CodenameTempest14/init-heat-monitoring/hardware/README.md

# hardware

Device design for the classroom heat monitor (38-pin ESP32, DHT22, SSD1306 OLED, USB power bank).

- `schematic.html`: Rev B schematic, parts list, wire list, bring-up order, runtime estimate. Draft, not yet built or measured. Rev B replaced the Rev A 2S 18650 + buck power section (D-008).
