CodenameTempest14/init-heat-monitoring/src/README.md

# src/

Application code that runs in Node and the browser. Currently: `heat-index.js` (`heatIndexC`: heat index from °C and % RH, `null` below the NWS range; `heatCategory`: PAGASA band, rounded to whole °C). Tested by `tests/`. Decision D-015.
