CodenameTempest14/init-heat-monitoring/documentation/README.md

# documentation

Decisions, progress log, phase checklists, session reports and the state file. Start with `context/CURRENT_STATE.md`.
