CodenameTempest14/init-heat-monitoring/design/brand/README.md

# design/brand/

Logo and full name of **Init** (brand name D-007). **Chosen by the owner 2026-11-02 (s14), D-029.**

**Full name:** Init: Indoor Heat Index Tracker, An IoT-Based Classroom Heat Index Monitoring System
(IN-door + Index + Tracker; "init" is also the programmer's word for *start*).

**Logo:** the app icon (a lowercase `i` drawn as a thermometer) next to the `init` wordmark with heat-orange i-dots.

| File | What |
|---|---|
| `init-logo-light.svg`, `init-logo-dark.svg` | **The logo** (icon + wordmark) for light and dark backgrounds |
| `init-icon-light.svg`, `init-icon-dark.svg` | **The icon** alone: PWA icon and favicon (the dark one has a light edge) |
| `build-logos.mjs` | Draws every SVG here from `../tokens.json`; letters are plain strokes, so no font licence (D-010). Edit this, not the SVGs |
| `preview.html`, `capture.mjs`, `preview.png` | The chosen logo and the earlier proposals on light and dark, and at 32 px and 16 px |
| `logo-a-*`, `icon-b.svg`, `logo-b-*`, `logo-c-*` | The three proposals the owner chose from (A wordmark, B icon, C gauge); kept for the record |
