CodenameTempest14/init-heat-monitoring/enclosure/preview/README.md

- preview/ and stl/ hold generated files only.
