CodenameTempest14/init-heat-monitoring/documentation/context/README.md

# context

`CURRENT_STATE.md` (read first every session, overwritten at close) and `NEXT_SESSION_PROMPT.md` (generated by `node tools/continuation-prompt.mjs`).
