CodenameTempest14/init-heat-monitoring/paper/data/README.md

# paper/data/

Aggregates of the 24 h run (2026-11-02 10:03:55Z to 2026-11-03 10:03:55Z, init-test, one device): `summary.json`,
`hourly.json` (Philippine time), `bands.json` (PAGASA levels), `gaps.json` (gaps over 90 s). Made by `../fetch-data.mjs`.
No keys, no personal data.

`screens/`: three cropped phone screenshots (home online, home offline, heat alerts page; owner's Android, light mode, 5 Nov 2026) used in Figure 7. No personal data.

`screens/` now also holds crops of the hosted pages taken with a phone-sized browser (390 px, light mode, 5 Nov 2026): charts, readings, school, heat, guide, admin-signin, admin (test admin account on the test project; the address is a made-up one). Figures 7 to 10.
