CodenameTempest14/init-heat-monitoring/design/language-toggle/ref/README.md

# design/language-toggle/ref/

Light and dark screenshots of the proposed language switch (home in English, in Filipino, and the longest-text stress case). Made by `node design/language-toggle/capture.mjs`. Proposed only; the Filipino is a draft.
