CodenameTempest14/init-heat-monitoring/design/heat-info/ref/README.md

# design/heat-info/ref/

Screenshots of the F-15 extended mocks (`../*.html`), written by `node design/heat-info/capture.mjs`: `<state>-<phone|desktop>-<light|dark>.png`. Made-up room only.
