CodenameTempest14/init-heat-monitoring/documentation/phase-reports/phase-03-firmware/README.md

# phase-03-firmware

Reports for Phase 3 (device firmware, starting with the OLED design canvas).
