CodenameTempest14/init-heat-monitoring/documentation/phase-reports/phase-01-core-and-bench/README.md

# phase-01-core-and-bench

Reports for Phase 1 (heat index core and bench bring-up).
