CodenameTempest14/init-heat-monitoring/firmware/init/include/README.md

# firmware/init/include

Headers. `heat_index.h` (heat index and PAGASA band, P03-04), `interval.h` (upload interval rules, P03-03), `room.h` (room name from the reply, D-028), `readings.h` (offline buffer and upload body, P03-06), `screens.h` (the OLED screens, repeated from `design/oled/screens.mjs`) and `screen_test.h` (only for the `esp32dev_screens` build, which dumps the display over serial) are pure code or drawing code. `config.h` is committed. `secrets.h` is created from `secrets.h.example`, is gitignored and must never be committed.
