CodenameTempest14/init-heat-monitoring/documentation/phase-reports/phase-03-firmware/sessions/2026-11-11_s38_CLOSE.md

# Phase 07 — Session s38 — CLOSE — 2026-11-11

[P07 · Field trial and hardening · 0/7 done · 0 blocked · unverified 1]

- **Status:** Completed. **Phase builder:** the owner did not answer the question; treated as owner only (D-014 applies: if Shem joins, `main` goes through pull requests). **Model:** Sonnet 5.5 (fine for the case design, print guide and paper).
- **Planned vs done:** planned: take the owner's measurements, draft 6, print guide. Done: measurements recorded with the conflicts flagged (`enclosure/MEASUREMENTS.md`); **draft 6** of `init_case.scad`; `enclosure/PRINT_GUIDE.md`; the **logo engraving** (D-045); decisions D-042 (pod low, M3 x 5 only), D-043 (web hold stays), D-044 (only box screws, no inserts: M2.5 x 8 for the case), D-045 (logo, one PETG colour, one paint); button window moved to the back wall (owner). P07 is still 0/7: nothing printed or fitted.
- **Files changed:** `documentation/DECISIONS.md` (D-042 to D-045), `enclosure/` (`init_case.scad`, `MEASUREMENTS.md`, `README.md`, new `PRINT_GUIDE.md`, `preview/draft6_*.png`, `stl/*.stl` incl. new `podlid.stl`), `paper/content.mjs` and the rebuilt `.docx` and `.pdf`; this close, `CURRENT_STATE.md`, `PROGRESS_LOG.md`.
- **Evidence:** OpenSCAD renders of base, lid, cover, arm and podlid with no errors (STL exported); I looked at the assembly, arm and logo renders. The paper builds. Secret scan clean.
- **Regression:** no code under `web/`, `src/`, `firmware/` or `supabase/` changed, so no suite was run (web and database are on hold, D-039).
- **Paper (rule 5):** enclosure paragraph updated (arm low, box screws, logo, most sizes now measured). No new reference added.
- **Pushed:** commit `2077ffc` to `codenametempest14` and `main` (owner approved both). The s38 close commit is local until the owner approves a push.
- **Not run:** nothing printed or fitted; no close-up of the OLED pilot holes; no check that the 22 cm wire route works.
- **Which parts did you actually run, and what are you unsure about?** Run: OpenSCAD renders and the paper build. Unsure: (1) the guesses marked EST in the .scad and PRINT_GUIDE section 5: OLED hole orientation and lit length, DHT22 hole position and grille size, 14 mm plug length, the "7 mm" port height, countersink head size, pilot size 2.1 mm and depths; (2) the owner's measurements that conflict (ESP32 row spacing 25 mm looks like the board width; OLED lit 24.5 mm is longer than the 24.4 mm board; bank port 1 at 40 mm; DHT22 grille 15 x 14) were adapted, not re-measured; (3) M2.5 x 8 self-tapping into PETG pilots is untested; (4) the engraved icon outline is only about 1 mm; (5) the logo and the front wall: the engraving prints on a vertical face, untested; (6) the colour and paint advice is general (white or light grey PETG, dark acrylic paint pen), no product checked.
- **Awaiting owner:** buy one roll of PETG (light colour) and a dark acrylic paint pen, then ping me; review draft 6; measure one M2.5 flat-head screw head; confirm the guesses above; lift the web hold (D-039) when wanted.
- **Next session model:** Sonnet 5.5 for the PLA test slice, the print guide and the paper; Opus 5.5 once firmware, power or data-gap work starts.

## Addendum (session kept open after the first close, owner's request)
After the close the owner asked about drop strength and gave the bank weight (about 670 g). I found that draft 6 left the bank loose along its length (30 mm toward the port end, 12.6 mm toward the rear). **Draft 7 (D-046):** bank stops, walls and floor 3.2 mm, rounded corners, arm tube wall 2.4 mm, bigger arm foot and four gussets; PRINT_GUIDE section 7 adds a drop test. Evidence: all five STL parts render with no errors; I looked at the base top view (stops placed as intended) and the arm render. Not tested: a real drop, the stop clearances with the real bank, whether the thicker walls change the print time or fit the cover posts. The paper has one new sentence; rebuilt. The owner then approved draft 7 for the PLA test print only, estimates included (D-047). Pushed at the final close: `97db1d4`, `0f19931`, `142458e` to `codenametempest14` and `main` (owner approved both).

## Phase Progress (HARD RULE 1), at the close
| Phase | Done / Total | Progress | % |
|---|---|---|---|
| P00 Kickoff and decisions | 13 / 13 | ██████████ | 100% |
| P01 Heat index core and bench bring-up | 7 / 7 | ██████████ | 100% |
| P02 Backend and secure upload | 7 / 7 | ██████████ | 100% |
| P03 Device firmware | 10 / 10 | ██████████ | 100% |
| P04 Web app core | 13 / 13 | ██████████ | 100% |
| P05 Admin, alerts and device health | 7 / 7 | ██████████ | 100% |
| P06 Display and sharing extras | 4 / 5 | ████████░░ | 80% |
| P07 Field trial and hardening | 0 / 7 | ░░░░░░░░░░ | 0% |
| P08 Over-the-air updates (optional) | 0 / 3 | ░░░░░░░░░░ | 0% |
| **Whole project** | 61 / 72 | █████████░ | **85%** |
