CodenameTempest14/init-heat-monitoring/documentation/phase-reports/phase-03-firmware/sessions/2026-11-09_s37_START.md

# Phase 07 — Session s37 — START — 2026-11-09

[P03 · Device firmware · 10/10 done · 0 blocked · unverified 1]

- **Phase builder:** owner only (asked and answered s37).
- **Model:** Sonnet 5.5 (P06-05 tick, paper, enclosure planning); Opus 5.5 for P07 firmware/power work and P08.
- **Read:** CLAUDE.md, CURRENT_STATE.md, the continuation prompt. Repo check: `codenametempest14` level with origin (the prompt said two unpushed close commits, but they were already pushed); untracked `.vscode/settings.json` (not ours).
- **Owner's answers:** Filipino switch seen on a phone (screenshot), teacher approved the translation, `#kiosk` and the poster seen on a television; next phase P07.
- **Plan:** tick P06-05, then plan P07-01 (enclosure) with the owner.

## Phase Progress (HARD RULE 1), at the start
| Phase | Done / Total | Progress | % |
|---|---|---|---|
| P00 Kickoff and decisions | 13 / 13 | ██████████ | 100% |
| P01 Heat index core and bench bring-up | 7 / 7 | ██████████ | 100% |
| P02 Backend and secure upload | 7 / 7 | ██████████ | 100% |
| P03 Device firmware | 10 / 10 | ██████████ | 100% |
| P04 Web app core | 13 / 13 | ██████████ | 100% |
| P05 Admin, alerts and device health | 7 / 7 | ██████████ | 100% |
| P06 Display and sharing extras | 3 / 5, 1 unverified | ██████░░░░ | 60% |
| P07 Field trial and hardening | 0 / 7 | ░░░░░░░░░░ | 0% |
| P08 Over-the-air updates (optional) | 0 / 3 | ░░░░░░░░░░ | 0% |
| **Whole project** | 60 / 72 | ████████░░ | **83%** |
