CodenameTempest14/init-heat-monitoring/documentation/phase-reports/phase-03-firmware/sessions/2026-11-11_s37_CLOSE.md

# Phase 07 — Session s37 — CLOSE — 2026-11-11

[P07 · Field trial and hardening · 0/7 done · 0 blocked · unverified 0]

- **Status:** Completed. **Phase builder:** owner only. **Model:** Sonnet 5.5 (the owner asked twice if it is enough: yes for the case design, the paper and the print guide; Opus 5.5 for P07 firmware, power and hardening).
- **Planned vs done:** planned the P06-05 tick, then P07. Done: **P06-05 verified** (owner's phone screenshot of the hosted page in Filipino, teacher approved, owner's word); P06-02 note (poster scanned on a TV); **website and database put on hold (D-039)**; **P07-01 enclosure design started** (D-038, D-040, D-041): measurement sheet, OpenSCAD model drafts 1 to 5, dimensioned drawings, measurement guide, checklist for tomorrow. P07 is still 0/7: nothing is printed or tested.
- **Files changed:** `documentation/phases/phase-06-extras.md`, `DECISIONS.md` (D-038 to D-041), `CURRENT_STATE.md`, `PROGRESS_LOG.md`; new `enclosure/` (README, MEASUREMENTS.md, MEASURE_NEXT.md, `init_case.scad`, `draw-dimensions.mjs`, `draw-measure-guide.mjs`, `preview/`, `stl/`); `paper/content.mjs` and the rebuilt `.docx` and `.pdf` (enclosure paragraph, Not Yet Done line, Table 7 61/72).
- **Evidence:** the P06-05 screenshot (owner). For the enclosure: OpenSCAD Nightly 2026.10.31 installed (winget, on the owner's user PATH, new terminals only); a test cube exported and opened in Bambu Studio after the owner fixed a missing `.stl` extension; all four STL parts render without errors at draft 5; I looked at every render and drawing. A subagent read the Bambu Studio repo profiles (A1 0.2 mm Standard, Generic PETG) and I spot-checked a few values myself. The Bambu wiki page itself returned HTTP 402 and was NOT read.
- **Regression:** no code under `web/`, `src/`, `firmware/` or `supabase/` changed, so no suite was run. Secret scan clean, every folder has a README.
- **Paper (rule 5):** enclosure paragraph in 2.4, a Not Yet Done line, Table 7 now P06 4/5 (80 %), whole 61/72 (85 %). No new reference was added; the print settings are not cited in the paper.
- **Pushed:** `codenametempest14` and `main` (owner approved both at close).
- **Not run:** nothing was printed or test-fitted; the web suite and backend tests; nothing on live.
- **Which parts did you actually run, and what are you unsure about?** Run: OpenSCAD renders of all parts, the dimension and measurement-guide drawings, the paper build. Unsure: (1) every size marked PLACEHOLDER (bank port opening, OLED window and posts, BOOT/EN holes, DHT22 mount, insert holes) is a guess; (2) the arm on top of the cover puts the pod in the warm air above the bay: the heat effect is unmeasured; (3) the bore of the arm (11 x 4.5 mm) was never tried with a real jumper plug; (4) the screws in the owner's box are too short for the arm (need about M3 x 10); (5) the print settings I gave come from my general knowledge plus Bambu's profile files, not the wiki; the PLA and PETG temperatures are from memory; (6) the printed case has not been fitted to any part.
- **Decisions / awaiting owner:** the measurements in `enclosure/MEASURE_NEXT.md` (owner, 2026-11-12); a decision on lifting the web hold (D-039); whether to keep the arm on top of the cover or hang the pod lower.
- **Next session model:** Sonnet 5.5 for the case design and the print guide; Opus 5.5 once P07 firmware, power or data-gap work starts.

## Phase Progress (HARD RULE 1), at the close
| Phase | Done / Total | Progress | % |
|---|---|---|---|
| P00 Kickoff and decisions | 13 / 13 | ██████████ | 100% |
| P01 Heat index core and bench bring-up | 7 / 7 | ██████████ | 100% |
| P02 Backend and secure upload | 7 / 7 | ██████████ | 100% |
| P03 Device firmware | 10 / 10 | ██████████ | 100% |
| P04 Web app core | 13 / 13 | ██████████ | 100% |
| P05 Admin, alerts and device health | 7 / 7 | ██████████ | 100% |
| P06 Display and sharing extras | 4 / 5 | ████████░░ | 80% |
| P07 Field trial and hardening | 0 / 7 | ░░░░░░░░░░ | 0% |
| P08 Over-the-air updates (optional) | 0 / 3 | ░░░░░░░░░░ | 0% |
| **Whole project** | 61 / 72 | █████████░ | **85%** |
