CodenameTempest14/init-heat-monitoring/documentation/phase-reports/phase-03-firmware/sessions/2026-11-06_s36_CLOSE.md

# Phase 03 — Session s36 — CLOSE — 2026-11-06

[P03 · Device firmware · 10/10 done · 0 blocked · unverified 1]

- **Status:** Completed. **Phase builder:** owner only. **Model:** Sonnet 5.5 (enough for the whole session, owner asked).
- **Planned vs done:** planned the P06-02 tick, then (owner's choice) the English / Filipino switch. Done: **P06-02 verified** (owner scanned `/#poster`); **P06-05 built and ticked UNVERIFIED**; init-test offsets read back 0.0 / 0.0.
- **Files changed:** `web/src/i18n.js`, `i18n-guide.js`, `i18n-admin.js`, `Lang.jsx`, `lang.css` (new); `lib.js`, `school.js`, `alerts.js`, `history.js`, `readings.js`, `admin.js`, `heatText.js`, `App.jsx`, `School.jsx`, `Alerts.jsx`, `History.jsx`, `Readings.jsx`, `Heat.jsx`, `Guide.jsx`, `Admin.jsx`, `main.jsx`; `tests/web-i18n.test.js`, `tests/ui-gate-language.test.js` (new); `design/language-toggle/` (mocks, refs, `room-row.mjs`) and the home, badge, history, school-day and alerts mocks redrawn with the switch; `documentation/phases/phase-06-extras.md`; READMEs; `paper/content.mjs`, `paper/diagrams.mjs`, rebuilt `.docx` and `.pdf`.
- **Evidence:** `web-i18n.test.js` seen red at each of four stages (module not found, missing exports, wrong text), then 14/14. `ui-gate-language.test.js` 14/14: the first run showed 4700 to 5300 differing pixels because the language mock lacked `charts.css` (mock fixed, not the app); the history, readings, heat, guide and admin language tests passed on their first run (never seen red). The guide gate caught one real change of mine ("When to look at it" had been turned into "When to change it"); fixed, 6/6. Browser-driven in Chromium against fake Supabase answers at 390 px and 360 px, light and dark.
- **Regression:** web unit 119/119; UI gates one file at a time: home 12, badge 9, history 17, school 14, admin 20, guide 6, heat 10, alerts 16, qr-kiosk 12, language 14, core 5, all green with 0 differing pixels; secret scan clean; every folder has a README.
- **Paper (rule 5):** new paragraph on the language switch, routes figure has a new box, Not Yet Done line, kiosk and poster sentence updated (poster scanned). Table 7 unchanged in numbers: P06 3/5 (60 %), whole 60/72 (83 %); P06-05 counts as unverified, not done. No new reference was needed.
- **Pushed:** `codenametempest14` and `main` at `74e387f` (owner approved each time). The close commit is local; the push is asked after it.
- **Not run:** the whole `npm test` and the backend tests (they wipe init-test readings), anything on live, the switch on a phone or on the hosted page, `#kiosk` on a TV, a printed poster.
- **Which parts did you actually run, and what are you unsure about?** Run: everything under Evidence and Regression. Unsure: (1) the Filipino is the assistant's draft, no teacher or fluent speaker has read it, and the health advice (`#heat`, `#guide`) matters most; (2) the switch was never seen on a real phone or on the hosted page; (3) the switch is only on pages with the Room line, so `#heat`, `#guide` and `#admin` can only be switched on the home page first; (4) the kiosk, poster, push notification text and CSV column names are still English by the owner's choice.
- **Decisions / awaiting owner:** teacher review of the Filipino (D-034), then remove UNVERIFIED from P06-05 after the phone check; `#kiosk` on a TV; a printed poster; push of the close commit; what next (P06-03 advice text needs a teacher; P07 field trial needs the device in a classroom).
- **Next first step:** CURRENT_STATE "Next concrete step" 0 and 1.
- **Recommended model for the next session:** Sonnet 5.5 to tick P06-05 and for any paper or text work; Opus 5.5 for P07 and P08.

## Phase Progress (HARD RULE 1)
| Phase | Done / Total | Progress | % |
|---|---|---|---|
| P00 Kickoff and decisions | 13 / 13 | ██████████ | 100% |
| P01 Heat index core and bench bring-up | 7 / 7 | ██████████ | 100% |
| P02 Backend and secure upload | 7 / 7 | ██████████ | 100% |
| P03 Device firmware | 10 / 10 | ██████████ | 100% |
| P04 Web app core | 13 / 13 | ██████████ | 100% |
| P05 Admin, alerts and device health | 7 / 7 | ██████████ | 100% |
| P06 Display and sharing extras | 3 / 5, 1 unverified | ██████░░░░ | 60% |
| P07 Field trial and hardening | 0 / 7 | ░░░░░░░░░░ | 0% |
| P08 Over-the-air updates (optional) | 0 / 3 | ░░░░░░░░░░ | 0% |
| **Whole project** | 60 / 72 | ████████░░ | **83%** |

## Continuation prompt (HARD RULE 2)
`documentation/context/NEXT_SESSION_PROMPT.md`, generated by `node tools/continuation-prompt.mjs`; shown in the final message.
