CodenameTempest14/init-heat-monitoring/documentation/phase-reports/phase-03-firmware/sessions/2026-11-06_s36_START.md

# Phase 03 — Session s36 — START — 2026-11-06

[P03 · Device firmware · 10/10 done · 0 blocked · unverified 1]

- **Phase builder:** owner only (asked and answered s36).
- **Model:** Sonnet 5.5 (small web changes, ticks, paper; the owner asked and Sonnet was enough for the mocks).
- **Read:** CLAUDE.md, CURRENT_STATE.md, `phase-06-extras.md`, the s35 Close Report.
- **Read-only check before any change:** branch `codenametempest14`, git email = the owner, nothing unpushed, untracked `.vscode/settings.json` (not ours).
- **Owner's answers:** poster scanned with a phone and working; `#kiosk` not yet seen on a TV; init-test temperature offset reset to 0 (read back 0.0 / 0.0).
- **Plan:** tick P06-02, then mocks for the English / Filipino switch (P06-05), build it test-first, then translate the rest of the app; paper in step (rule 5).

## Phase Progress (HARD RULE 1)
| Phase | Done / Total | Progress | % |
|---|---|---|---|
| P00 Kickoff and decisions | 13 / 13 | ██████████ | 100% |
| P01 Heat index core and bench bring-up | 7 / 7 | ██████████ | 100% |
| P02 Backend and secure upload | 7 / 7 | ██████████ | 100% |
| P03 Device firmware | 10 / 10 | ██████████ | 100% |
| P04 Web app core | 13 / 13 | ██████████ | 100% |
| P05 Admin, alerts and device health | 7 / 7 | ██████████ | 100% |
| P06 Display and sharing extras | 3 / 5, 1 unverified | ██████░░░░ | 60% |
| P07 Field trial and hardening | 0 / 7 | ░░░░░░░░░░ | 0% |
| P08 Over-the-air updates (optional) | 0 / 3 | ░░░░░░░░░░ | 0% |
| **Whole project** | 60 / 72 | ████████░░ | **83%** |
