CodenameTempest14/init-heat-monitoring/documentation/phase-reports/phase-03-firmware/sessions/2026-11-06_s35_CLOSE.md

# Phase 03 — Session s35 — CLOSE — 2026-11-06

[P03 · Device firmware · 10/10 done · 0 blocked · unverified 1]

- **Status:** Completed (the push and the calibration reset are waiting on the owner). **Phase builder:** owner only. **Model:** Sonnet 5.5.
- **Planned vs done:** planned `#poster` and `#kiosk`, P06-04, paper. Done: **P06-01 ticked**, **P06-04 ticked** (F-24 CSV, owner's word), **P06-02 ticked as UNVERIFIED** (the owner has not scanned it with a phone; not on the hosted page yet). Paper rebuilt.
- **Files changed:** `web/src/Kiosk.jsx`, `kiosk.js`, `Poster.jsx`, `poster.js`, `qr-kiosk.css` (new), `App.jsx`, `main.jsx`; `tests/web-qr-kiosk.test.js`, `tests/ui-gate-qr-kiosk.test.js` (new); `documentation/phases/phase-06-extras.md`; READMEs (`web`, `tests`, `design/qr-kiosk` and `ref`); `THIRD_PARTY_NOTICES.md` (qrcode-generator, MIT); `paper/content.mjs`, `paper/diagrams.mjs`, rebuilt `.docx` and `.pdf`.
- **Evidence:** `web-qr-kiosk.test.js` seen red (module not found), then 7/7. UI gate 12/12 after one real defect (109 pixels differed on the "updated … · address" line: React made two text nodes; one string fixed it). The built pages have 0 differing pixels against the approved TV, phone and A4 images; the kiosk looks the same in dark mode. The local build opened on real init-test data: 38 °C, Extreme caution, Online, Unassigned. The approved poster image decodes (jsQR 1.4.0, scratch folder, not in the repo) to `https://init-heat-monitoring.vercel.app`.
- **Regression:** the other web unit tests 110/110; UI gates one file at a time: home 12, badge 9, history 17, school 14, admin 20, guide 6, heat 10, alerts 16, core 5, all green.
- **Paper (rule 5):** new paragraph on the kiosk and poster, Figure 6 (routes) has two new boxes, Table 7 now P06 2/5 (40 %) and whole 59/72 (82 %), Not Yet Done lists the unscanned poster and the pages not yet hosted. No new reference was needed.
- **Not run:** the whole `npm test` (it wipes init-test readings), the backend tests, anything on live, a phone scan of the QR, the pages on the hosted site.
- **Which parts did you actually run, and what are you unsure about?** Run: everything under Evidence and Regression. Unsure: (1) no phone has scanned a real QR from a screen or a printed sheet; (2) the kiosk was not seen on a real TV or projector, only at 1920x1080 and 390 px in Chromium; (3) init-test's temperature offset reads -0.5 °C (the state file said -0.6) and I could not write it (`db query --linked` is read-only), so the owner must set it to 0 in `#admin`; (4) there is no link to `#kiosk` or `#poster`, on purpose; they are opened by address.
- **Pushed:** nothing yet; the push to `codenametempest14` (and `main`) is asked at close.
- **Decisions / awaiting owner:** scan the poster, open `#kiosk` on a TV, reset the temperature offset to 0 before data goes into the paper, say whether a link to these pages is wanted (it changes approved home mocks, so mocks first); P06-03 and P06-05 need a teacher.
- **Next first step:** CURRENT_STATE "Next concrete step" 1.
- **Recommended model for the next session:** Sonnet 5.5 for ticking P06-02, the paper and P06-03; Opus 5.5 for P07 and P08.

## Phase Progress (HARD RULE 1)
| Phase | Done / Total | Progress | % |
|---|---|---|---|
| P00 Kickoff and decisions | 13 / 13 | ██████████ | 100% |
| P01 Heat index core and bench bring-up | 7 / 7 | ██████████ | 100% |
| P02 Backend and secure upload | 7 / 7 | ██████████ | 100% |
| P03 Device firmware | 10 / 10 | ██████████ | 100% |
| P04 Web app core | 13 / 13 | ██████████ | 100% |
| P05 Admin, alerts and device health | 7 / 7 | ██████████ | 100% |
| P06 Display and sharing extras | 2 / 5, 1 unverified | ████░░░░░░ | 40% |
| P07 Field trial and hardening | 0 / 7 | ░░░░░░░░░░ | 0% |
| P08 Over-the-air updates (optional) | 0 / 3 | ░░░░░░░░░░ | 0% |
| **Whole project** | 59 / 72 | ████████░░ | **82%** |

## Continuation prompt (HARD RULE 2)
`documentation/context/NEXT_SESSION_PROMPT.md`, generated by `node tools/continuation-prompt.mjs`; shown in the final message.
