CodenameTempest14/init-heat-monitoring/documentation/phase-reports/phase-03-firmware/sessions/2026-11-06_s35_START.md

# Phase 03 — Session s35 — START — 2026-11-06

[P03 · Device firmware · 10/10 done · 0 blocked · unverified 0]

- **Phase builder:** owner only (asked and answered s35).
- **Model:** Sonnet 5.5 (web pages with UI gates, paper).
- **Read:** CLAUDE.md, CURRENT_STATE.md, `phase-06-extras.md`, the three mock images in `design/qr-kiosk/ref/`.
- **Read-only check before any change:** branch `codenametempest14` level with `origin/codenametempest14` (the continuation prompt said 3 commits were unpushed; none were); untracked `.vscode/settings.json` left alone.
- **Owner's answers:** approve all three mocks as they are; reset the calibration offset to 0; F-24's Readings CSV covers P06-04.
- **Plan:** build `#kiosk` and `#poster` test-first with UI gates (P06-01, P06-02), tick P06-04, paper in step (rule 5).

## Phase Progress (HARD RULE 1)
| Phase | Done / Total | Progress | % |
|---|---|---|---|
| P00 Kickoff and decisions | 13 / 13 | ██████████ | 100% |
| P01 Heat index core and bench bring-up | 7 / 7 | ██████████ | 100% |
| P02 Backend and secure upload | 7 / 7 | ██████████ | 100% |
| P03 Device firmware | 10 / 10 | ██████████ | 100% |
| P04 Web app core | 13 / 13 | ██████████ | 100% |
| P05 Admin, alerts and device health | 7 / 7 | ██████████ | 100% |
| P06 Display and sharing extras | 0 / 5 | ░░░░░░░░░░ | 0% |
| P07 Field trial and hardening | 0 / 7 | ░░░░░░░░░░ | 0% |
| P08 Over-the-air updates (optional) | 0 / 3 | ░░░░░░░░░░ | 0% |
| **Whole project** | 57 / 72 | ████████░░ | **79%** |
