CodenameTempest14/init-heat-monitoring/documentation/phase-reports/phase-03-firmware/sessions/2026-11-05_s33_CLOSE.md

# Phase 03 — Session s33 — CLOSE — 2026-11-05

[P03 · Device firmware · 10/10 done · 0 blocked · unverified 0]

- **Status:** Completed. **Phase builder:** owner only (asked and answered s33). **Model:** Sonnet 5.5.
- **Planned vs done:** planned P04-08 screenshots and the P05-02 save. Done: **P04-08 ticked** (owner's four Android screenshots: light-mode home, `#alerts`, Offline after unplugging, back Online); **P05-02 ticked** (interval 60 → 120 → 60 and calibration offsets changed from the phone, each read back from the database and seen in the readings); admin label "Heat alerts (coming later)" fixed to "Heat alerts"; paper Chapter 2 got phone screenshots of every page (Figures 7 to 10). Not done: the 60-min reminder, iPhone subscription, teacher review, live rollout.
- **Files changed:** `documentation/phases/phase-04-web-app.md` (P04-08 ticked), `documentation/phases/phase-05-admin-alerts.md` (P05-02 ticked), `web/src/Admin.jsx` (label), the admin mocks and approved images in `design/admin/` and `design/room-reset-readings/`, `paper/content.mjs`, `paper/diagrams.mjs`, `paper/data/screens/` (10 crops) and its README, rebuilt `paper/Init_Research_Paper.docx` and `.pdf` (23 pages, 12 figures), `CURRENT_STATE.md`, `PROGRESS_LOG.md`, `NEXT_SESSION_PROMPT.md`, this report and the s33 START.
- **Evidence P04-08:** screenshots 22:55 to 22:57 local: Online (31 °C Caution, 28.5 °C, 63 %), Offline ("Offline: no reading for 2 min", Last heat index 33 °C, last reading 2 min ago), back Online (29.2 °C, 68 %), `#alerts`.
- **Evidence P05-02:** interval saved 15:14:02Z, gaps 120.2, 120.3, 120.3 s, back to 60 at 15:21:38Z (gaps 119.8 then 60.0, 60.2 s); offsets +0.9 / +5.0 at 15:27:15Z (reading 28.5 → 29.3 °C, 62.5 → 67.3 %), −0.9 / −5.0 at 15:28:31Z (27.4 °C, 58.2 %), then temperature −0.6 and humidity 0 at 15:33:24Z (27.3 → 27.5 °C, 58.6 → 63.9 %). The power bank stayed on for 5 min at 120 s.
- **Paper (rule 5), listed as required:** Table 7 (P04 100 %, P05 100 %, whole 57/72, 79 %); Not Yet Done (offline and light mode now checked); section 2.5 paragraph and Figures 7 to 10 (live card, offline, history charts, readings table, school day, heat alerts, heat meaning page, admin guide, admin sign-in and settings; the admin shot is from a made-up test account); alerts and hourly figures renumbered to 11 and 12; procedure text for the interval and offset tests. No new references (still 7). Rebuilt with `node paper/build.mjs`.
- **Checks run (by me):** `db query --linked` read-only on init-test (settings, readings and gaps, several times); `tests/ui-gate-admin.test.js` 20/20 (after redrawing the approved images), `tests/web-admin.test.js` plus `tests/ui-gate-guide.test.js` 18/18; Playwright captures of the hosted pages (390 px, light) for the figures; `curl` of the hosted script to confirm the new label is live; `node paper/build.mjs`; `node tools/secret-scan.mjs` before each commit.
- **Not run:** the whole `npm test` (it wipes init-test readings); the home, badge, history, school, alerts and heat UI gates (no code in their views changed); nothing on live.
- **Which parts did you actually run, and what are you unsure about?** Run: everything in "Checks run". Unsure: (1) resolved after the close: the owner reloaded the tab and the label is gone; the hosted script no longer contains it, so I think it was a tab loaded earlier, but I have not seen it fixed on the phone; (2) the offsets now left on init-test are −0.6 °C (picked by comparing with a room thermometer reading 27.9 °C, not a real accuracy check) and 0 % humidity; (3) 5 min at 120 s is too short to say the power bank is safe at 120 s; (4) after the last change the temperature rose 0.2 °C against an expected 0.3 (sensor noise, one reading); (5) I looked at PDF pages 11 to 14 only, and the Word file is still not opened in Word.
- **Pushed:** `f7dac56` to `codenametempest14` and `main` (owner approved). Later commits are pushed only if the owner approves at close.
- **Decisions / awaiting owner:** teacher review of alert and Reset wording; phone confirmation of the label; live rollout after the device move (D-026). The roll-up of old readings (F-20, 90 days then hourly rows) already exists; a shorter window would be a one-line change that deletes data, so it needs the owner's word.
- **Next first step:** CURRENT_STATE "Next concrete step" 1.
- **Recommended model for the next session:** Sonnet 5.5 for the remaining checks and the paper; Opus 5.5 for the live rollout.

## Phase Progress (HARD RULE 1)
| Phase | Done / Total | Progress | % |
|---|---|---|---|
| P00 Kickoff and decisions | 13 / 13 | ██████████ | 100% |
| P01 Heat index core and bench bring-up | 7 / 7 | ██████████ | 100% |
| P02 Backend and secure upload | 7 / 7 | ██████████ | 100% |
| P03 Device firmware | 10 / 10 | ██████████ | 100% |
| P04 Web app core | 13 / 13 | ██████████ | 100% |
| P05 Admin, alerts and device health | 7 / 7 | ██████████ | 100% |
| P06 Display and sharing extras | 0 / 5 | ░░░░░░░░░░ | 0% |
| P07 Field trial and hardening | 0 / 7 | ░░░░░░░░░░ | 0% |
| P08 Over-the-air updates (optional) | 0 / 3 | ░░░░░░░░░░ | 0% |
| **Whole project** | 57 / 72 | ████████░░ | **79%** |

## Continuation prompt (HARD RULE 2)
`documentation/context/NEXT_SESSION_PROMPT.md`, generated by `node tools/continuation-prompt.mjs`; shown in the final message.
