CodenameTempest14/init-heat-monitoring/documentation/phase-reports/phase-03-firmware/sessions/2026-11-05_s33_START.md

# Phase 03 — Session s33 — START — 2026-11-05

[P03 · Device firmware · 10/10 done · 0 blocked · unverified 0]

- **Phase builder:** owner only (asked and answered s33).
- **Model:** Sonnet 5.5 (phone screenshots, a real settings save, ticks, paper; nothing needing deep debugging).
- **Read:** CLAUDE.md, CURRENT_STATE.md, the phase checklist lines for P04-08 and P05-02.
- **Read-only check before any change:** branch `codenametempest14` 1 commit ahead of origin; git email matches the owner; untracked `.vscode/settings.json` left alone.
- **Plan:** P04-08 phone screenshots (light mode, Offline), P05-02 real interval save, paper in step (rule 5).
- *Note:* this file was written at the close of s33; the Start Report itself was given in chat at the start of the session.

## Phase Progress (HARD RULE 1)
| Phase | Done / Total | Progress | % |
|---|---|---|---|
| P00 Kickoff and decisions | 13 / 13 | ██████████ | 100% |
| P01 Heat index core and bench bring-up | 7 / 7 | ██████████ | 100% |
| P02 Backend and secure upload | 7 / 7 | ██████████ | 100% |
| P03 Device firmware | 10 / 10 | ██████████ | 100% |
| P04 Web app core | 12 / 13 (+1 partly) | █████████░ | 92% |
| P05 Admin, alerts and device health | 6 / 7 (+1 partly) | █████████░ | 86% |
| P06 Display and sharing extras | 0 / 5 | ░░░░░░░░░░ | 0% |
| P07 Field trial and hardening | 0 / 7 | ░░░░░░░░░░ | 0% |
| P08 Over-the-air updates (optional) | 0 / 3 | ░░░░░░░░░░ | 0% |
| **Whole project** | 55 / 72 | ████████░░ | **76%** |
