CodenameTempest14/init-heat-monitoring/documentation/phase-reports/phase-03-firmware/sessions/2026-11-05_s32_CLOSE.md

# Phase 03 — Session s32 — CLOSE — 2026-11-05

[P03 · Device firmware · 10/10 done · 0 blocked · unverified 0]

- **Status:** Completed (owner chose to close after the tick). **Phase builder:** owner only (asked and answered s32). **Model:** Opus 5.5.
- **Planned vs done:** planned the P05-03 phone test, the paper and P04-08 leftovers. Done: **P05-03 ticked**, Lighthouse re-run (P04-08 note), paper updated. Not done: P04-08 phone screenshots (light mode, Offline), P05-02 real save, the 60-min reminder, iPhone.
- **Files changed:** `documentation/phases/phase-05-admin-alerts.md` (P05-03 ticked with evidence), `documentation/phases/phase-04-web-app.md` (P04-08 Lighthouse note), `paper/content.mjs` + rebuilt `paper/Init_Research_Paper.docx` / `.pdf`, `CURRENT_STATE.md`, `PROGRESS_LOG.md`, `NEXT_SESSION_PROMPT.md`, the s32 START and this report.
- **Evidence for P05-03:** owner's two Android screenshots (lock-screen notification "Init heat alert — Heat index 42 °C (Danger) in Unassigned.", 10:44 Manila, 2 min old; `#alerts` "Heat alerts are on for this phone."). Read back read-only on init-test: `alerts` id 9, 02:42:00Z, heat index 41.5 (rounds to 42, D-019), sent 1, failed 0; `push_subscriptions` 1 row (FCM, made 2026-11-04 16:35Z); readings 02:43 to 02:47Z at 41.3 to 41.5, the 02:47 one rounds to 42 and made no second row (quiet period). The threshold was never changed (no 30 °C step was needed).
- **Paper (rule 5), listed as required:** scope paragraph (alerts no longer "not yet built"; seen on one Android, test project), procedure item 7 (the real alert on 5 November), Table 7 (5 November, P05 6/7 86 %, whole 55/72 76 %), Not Yet Done (what is left for alerts). Rebuilt with `node paper/build.mjs` (8 figures); I checked the four new texts in the PDF's extracted text, I did not page through the PDF visually. No new references this session (gap unchanged: 7 references; Cen et al. 2024 still unread).
- **Checks run (by me):** read-only `db query --linked` on init-test (readings, settings, alerts, subscriptions, the rounding line in the migration); `curl` of the hosted `sw.js` (push handler present); Lighthouse 12.6.1 mobile on the hosted home page (85 / 100 / 100 / 100; FCP 2.1 s, LCP 3.6 s, TBT 110 ms, CLS 0.082); `node paper/build.mjs`; `node tools/secret-scan.mjs` before the commit.
- **Not run:** no test suite this session (no code changed); nothing on live.
- **Which parts did you actually run, and what are you unsure about?** Run: everything in "Checks run". Unsure: (1) which phone took the second screenshot: it has a camera pill like an iPhone, but the only subscription is FCM, so I recorded it as the Android; (2) the hourly reminder after the quiet time is unseen; (3) the iPhone push path is untested; (4) the Word file still not opened in Word; (5) the Lighthouse score is one run (scores vary run to run).
- **Decisions / awaiting owner:** P04-08 phone screenshots; P05-02 interval save; teacher review of the alert wording (D-034); live rollout after the device move (D-026).
- **Next first step:** CURRENT_STATE "Next concrete step" 1 (P04-08 screenshots, P05-02 interval save).
- **Recommended model for the next session:** Sonnet 5.5 (screenshots, a save, ticks, paper); Opus 5.5 for the live rollout.

## Phase Progress (HARD RULE 1)
| Phase | Done / Total | Progress | % |
|---|---|---|---|
| P00 Kickoff and decisions | 13 / 13 | ██████████ | 100% |
| P01 Heat index core and bench bring-up | 7 / 7 | ██████████ | 100% |
| P02 Backend and secure upload | 7 / 7 | ██████████ | 100% |
| P03 Device firmware | 10 / 10 | ██████████ | 100% |
| P04 Web app core | 12 / 13 (+1 partly) | █████████░ | 92% |
| P05 Admin, alerts and device health | 6 / 7 (+1 partly) | █████████░ | 86% |
| P06 Display and sharing extras | 0 / 5 | ░░░░░░░░░░ | 0% |
| P07 Field trial and hardening | 0 / 7 | ░░░░░░░░░░ | 0% |
| P08 Over-the-air updates (optional) | 0 / 3 | ░░░░░░░░░░ | 0% |
| **Whole project** | 55 / 72 | ████████░░ | **76%** |

## Continuation prompt (HARD RULE 2)
`documentation/context/NEXT_SESSION_PROMPT.md`, generated by `node tools/continuation-prompt.mjs`; shown in the final message.
