CodenameTempest14/init-heat-monitoring/documentation/phase-reports/phase-03-firmware/sessions/2026-11-05_s32_START.md

# Phase 03 — Session s32 — START — 2026-11-05

[P03 · Device firmware · 10/10 done · 0 blocked · unverified 0]

- **Phase builder:** owner only (asked and answered s32).
- **Model:** Opus 5.5 (the P05-03 push chain had not yet reached a real phone; debugging would span the service worker, the Edge Function, pg_net and FCM). Sonnet 5.5 would do if the notification arrives first time.
- **Read:** CLAUDE.md, CURRENT_STATE.md, phase-05 checklist, s31 Close Report.
- **Read-only checks before any change (02:41Z):** the board uploads to init-test (newest reading 37 s old, heat index 41.2 °C); `push_subscriptions` 1 row, `alerts` 0 rows; settings: alert 42.0 °C, quiet 60 min, interval 60 s; the hosted `sw.js` has the `push` handler (the `87a88eb` build is live); `codenametempest14` level with origin, `main` at `6fd1c6d`.
- **Plan:** P05-03 end-to-end on the owner's Android, tick if it holds; paper (rule 5); P04-08 leftovers if time.

## Phase Progress (HARD RULE 1)
| Phase | Done / Total | Progress | % |
|---|---|---|---|
| P00 Kickoff and decisions | 13 / 13 | ██████████ | 100% |
| P01 Heat index core and bench bring-up | 7 / 7 | ██████████ | 100% |
| P02 Backend and secure upload | 7 / 7 | ██████████ | 100% |
| P03 Device firmware | 10 / 10 | ██████████ | 100% |
| P04 Web app core | 12 / 13 (+1 partly) | █████████░ | 92% |
| P05 Admin, alerts and device health | 5 / 7 (+1 partly) | ███████░░░ | 71% |
| P06 Display and sharing extras | 0 / 5 | ░░░░░░░░░░ | 0% |
| P07 Field trial and hardening | 0 / 7 | ░░░░░░░░░░ | 0% |
| P08 Over-the-air updates (optional) | 0 / 3 | ░░░░░░░░░░ | 0% |
| **Whole project** | 54 / 72 | ████████░░ | **75%** |
