CodenameTempest14/init-heat-monitoring/documentation/phase-reports/phase-03-firmware/sessions/2026-11-04_s31_CLOSE.md

# Phase 03 — Session s31 — CLOSE — 2026-11-04

[P05 · Admin, alerts and device health · 5/7 done (+1 partly) · 0 blocked · unverified 1]

- **Status:** Completed (ended by the owner after the push). **Phase builder:** owner only (asked and answered s31). **Model:** Opus 5.5.
- **Planned vs done:** planned P05-03 heat alerts after the owner's DECIDE answers. Done: design approved ("all suggested"), backend, Edge Function, VAPID tool, `#alerts` mock (approved) and build, service worker push, paper. Not done: a real notification on a phone (so P05-03 is **not ticked**), live rollout, teacher review of the alert wording.
- **Files changed (main ones):** `documentation/specs/P05-03_DESIGN.md` (APPROVED, answers recorded), `supabase/migrations/20261108120000_push_alerts.sql`, `supabase/functions/send-alert/index.ts`, `supabase/functions/_shared/{webpush.js,alert-message.js}` and READMEs, `supabase/config.toml`, `tools/vapid-keys.mjs`, `tools/secret-scan.mjs`, `tools/anon-probe.mjs` (28 checks), `.env.example`, `design/alerts/` (approved mocks), the five home mock sets redrawn, `web/src/{Alerts.jsx,alerts.js,alerts.css,App.jsx,main.jsx,config.js}`, `web/public/sw.js`, `web/build-config.mjs`, tests (`push.backend.js`, `webpush`, `alert-message`, `vapid-keys`, `web-alerts`, `web-pwa`, `secret-scan`, `ui-gate-alerts`), `documentation/phases/phase-04-web-app.md` and `phase-05-admin-alerts.md` (PROG notes), `paper/content.mjs`, `paper/diagrams.mjs`, rebuilt `.docx` / `.pdf`, `CURRENT_STATE.md`, `PROGRESS_LOG.md`, `NEXT_SESSION_PROMPT.md`, this report.
- **Owner's actions:** applied the migration on init-test in the SQL Editor (the CLI `db push` could not reach the pooler for either of us); made a scoped access token, deployed `send-alert` from the CLI, set its 4 secrets and the 2 Vault entries. The CLI kept using the read-only `SUPABASE_ACCESS_TOKEN` from `.env`, which wins over `supabase login`; setting `$env:SUPABASE_ACCESS_TOKEN` in the terminal fixed it. A token value was pasted in chat; the owner deleted it and made a new one. The test alert secret showed in an IDE selection: test only, a new secret will be made for live.
- **Paper (rule 5), listed as required:** new Figure 7 (heat alert sequence, device to phone), `#alerts` added to Figure 6, the 24 h chart is now Figure 8 (all mentions renumbered), a Heat alerts paragraph in 2.5, a stack row in Table 3, a procedure step in 2.7, "Not yet done" updated (alerts built but not seen on a phone; iPhone installed app seen). Rebuilt with `node paper/build.mjs` (8 figures). I looked at the two changed figures as images and fixed overlapping labels and an arrow through a box; I did not page through the PDF. No new references: RFC 8291 (2017) was read but is outside 2021 to 2026, so it is not cited.
- **Checks run (by me):** `push.backend.js` 14/14 (red 0/14 first); `anon-probe` 28/28 on init-test; chain check with a throwaway device (alert row, function answered sent 0 / failed 0, device removed); `send-alert` from outside: 401 without/with a wrong secret, 405 on GET; RFC 8291 test vector byte for byte; unit tests webpush 4, alert-message 4, vapid-keys 3, secret-scan 5, web-alerts 5, web-pwa 12 (new ones red first); UI gates one file at a time: home 12, badge 9, history 17, school 14, admin 20, guide 6, heat 10, core 5, alerts 16 (alerts seen 0/16 and home 10 failing without the code); other non-backend tests 132/132; `node tools/secret-scan.mjs` clean; push of `c2fd968..87a88eb` to `codenametempest14` and `main`.
- **Not run:** the whole `npm test` and the other backend tests (they wipe init-test readings while the real board uploads there). No notification was sent to a real phone. Nothing on live.
- **Which parts did you actually run, and what are you unsure about?** Run: everything in "Checks run". Unsure: (1) the whole push path to a real browser push service: my encryption matches the RFC example and a browser-side decrypt, but FCM's acceptance of the VAPID header is unseen; (2) the subscribe call from a real phone (only Chromium with a fake push manager in the gates); (3) whether the installed Android app picks up the new service worker without a full close; (4) iPhone push in the installed app; (5) whether the hosted Vercel build finished with `87a88eb` (not checked after the push); (6) the Word file still not opened in Word.
- **Decisions / awaiting owner:** the Android end-to-end test; teacher review of the alert wording; live rollout after the device move (D-026).
- **Next first step:** the Android end-to-end test (CURRENT_STATE "Next concrete step" 1).
- **Recommended model for the next session:** Sonnet 5.5 for the phone test, tick and paper; Opus 5.5 if the push does not arrive and the chain needs debugging.

## Phase Progress (HARD RULE 1)
```
| Phase | Done / Total | Progress | % |
|---|---|---|---|
| P00 Kickoff and decisions | 13 / 13 | ██████████ | 100% |
| P01 Heat index core and bench bring-up | 7 / 7 | ██████████ | 100% |
| P02 Backend and secure upload | 7 / 7 | ██████████ | 100% |
| P03 Device firmware | 10 / 10 | ██████████ | 100% |
| P04 Web app core | 12 / 13 (+1 partly) | █████████░ | 92% |
| P05 Admin, alerts and device health | 5 / 7 (+1 partly) | ███████░░░ | 71% |
| P06 Display and sharing extras | 0 / 5 | ░░░░░░░░░░ | 0% |
| P07 Field trial and hardening | 0 / 7 | ░░░░░░░░░░ | 0% |
| P08 Over-the-air updates (optional) | 0 / 3 | ░░░░░░░░░░ | 0% |
| **Whole project** | 54 / 72 | ████████░░ | **75%** |
```

## Continuation prompt (HARD RULE 2)
`documentation/context/NEXT_SESSION_PROMPT.md`, generated by `node tools/continuation-prompt.mjs`; shown in the final message.
