CodenameTempest14/init-heat-monitoring/documentation/phase-reports/phase-03-firmware/sessions/2026-11-04_s30_CLOSE.md

# Phase 03 — Session s30 — CLOSE — 2026-11-04

[P05 · Admin, alerts and device health · 5/7 done (+1 partly) · 0 blocked · unverified 0]

- **Status:** Completed (ended by the owner after the P05-03 design). **Phase builder:** owner only (asked and answered s30). **Model:** Sonnet 5.5 for the start report, then Opus 5.5 (owner switched) for the live rollout and the design.
- **Planned vs done:** planned the live admin rollout (P05-05), the paper, then P05-03. Done: P05-05 ticked (owner chose option A), paper updated, P05-03 design written (draft, waiting for the owner). Not done: P05-03 build, P04-08 leftovers, teacher review, more references.
- **Files changed:** `documentation/phases/phase-05-admin-alerts.md` (P05-05 ticked with evidence), `paper/content.mjs` and the rebuilt `.docx` / `.pdf`, new `documentation/specs/P05-03_DESIGN.md`, `documentation/specs/README.md`, `CURRENT_STATE.md`, `PROGRESS_LOG.md`, `NEXT_SESSION_PROMPT.md`, this report.
- **Live admin rollout (owner's actions):** the owner generated a long password in their own terminal, created the live admin user in the Supabase dashboard (own email; password never in chat or the repo) and added its id to `admins` in the dashboard **SQL Editor**. My first instruction (`tools/db.mjs live db query --linked "insert ..."`) failed with `25006 cannot execute INSERT in a read-only transaction`: `db query --linked` uses the read-only access token (known since s07, I missed it). Nothing was written by the failed call. The owner signed in on `localhost:5173/#admin` with `config.js` set to live; the page showed the **Admin** label (owner's screenshot, not stored; it shows the owner's email, so it is kept out of the repo and paper).
- **Repo vs docs conflict fixed:** the continuation prompt said `npm run config -- live` also changes `web/vercel.json`. It does not: `web/build-config.mjs` writes only `web/src/config.js` (which is tracked, so a live config pushed would switch the public site). Corrected in CURRENT_STATE.md.
- **Paper (rule 5), listed as required:** new step in 2.7 (the live admin check); Chapter 3 I and Appendix C give the live probe 21/21; Table 7 brought up to date (it still showed P05 at 3/7; now 54/72, 75 %); "Not yet done" lists the live save instead of the live admin account. Rebuilt with `node paper/build.mjs`; the new text found in the PDF (5 matches for "live project"); PDF pages not looked at one by one this session. No new references (none needed for this change). The design doc is not in the paper: nothing is built yet.
- **Checks run (by me):** read-only `db query --linked` on test and live (admins count, write policies, grants on `admins`); `node tools/anon-probe.mjs` against live 21/21; `npm run config` back to test and `git status` (config unchanged); `node tools/phase-report.mjs`; `node paper/build.mjs`; `node tools/secret-scan.mjs` clean. `npm test` was **not** run: no code changed (checklist, paper text, docs only).
- **Verified:** live `admins` = 1 row; live write rules and grants equal init-test's; live probe 21/21; owner's live sign-in with the Admin label.
- **Unsure / not tried:** (1) No signed-in non-admin was tested on live (live has no throwaway users; the same rules passed on init-test). (2) No real save on live: `#admin` takes its device from the newest reading, and live has none until the board moves (D-026). (3) The P05-03 design names Web Push on Deno but the library is not chosen; I have not checked which one runs on Supabase's Edge runtime. (4) The design assumes `pg_net` and Vault are available on the free plan; to confirm at build time. (5) The iPhone install for push is still unseen. (6) The Word file still not opened in Word.
- **Decisions / awaiting owner:** P05-03 design: DECIDE 1 to 5 and the three new pieces (`alerts` log table, `tools/vapid-keys.mjs`, `#alerts` view). Push of the s30 commits (not asked yet at writing; asked in the final message).
- **Next first step:** the owner answers the P05-03 DECIDEs, then build P05-03 test-first (Opus 5.5).
- **Recommended model for the next session:** **Opus 5.5** for the P05-03 build (migration, trigger with pg_net, first Edge Function, VAPID keys, service worker push). Sonnet 5.5 if the session is only the paper or phone ticks.

## Phase Progress (HARD RULE 1)
```
| Phase | Done / Total | Progress | % |
|---|---|---|---|
| P00 Kickoff and decisions | 13 / 13 | ██████████ | 100% |
| P01 Heat index core and bench bring-up | 7 / 7 | ██████████ | 100% |
| P02 Backend and secure upload | 7 / 7 | ██████████ | 100% |
| P03 Device firmware | 10 / 10 | ██████████ | 100% |
| P04 Web app core | 12 / 13 (+1 partly) | █████████░ | 92% |
| P05 Admin, alerts and device health | 5 / 7 (+1 partly) | ███████░░░ | 71% |
| P06 Display and sharing extras | 0 / 5 | ░░░░░░░░░░ | 0% |
| P07 Field trial and hardening | 0 / 7 | ░░░░░░░░░░ | 0% |
| P08 Over-the-air updates (optional) | 0 / 3 | ░░░░░░░░░░ | 0% |
| **Whole project** | 54 / 72 | ████████░░ | **75%** |
```

## Continuation prompt (HARD RULE 2)
`documentation/context/NEXT_SESSION_PROMPT.md`, generated by `node tools/continuation-prompt.mjs`; shown in the final message.
