CodenameTempest14/init-heat-monitoring/documentation/phase-reports/phase-03-firmware/sessions/2026-11-03_s26_CLOSE.md

# Phase 03 — Session s26 — CLOSE — 2026-11-03

[P03 · Device firmware · 10/10 done · 0 blocked · unverified 0]

- **Status:** Completed. **Phase builder:** owner only. **Model:** Sonnet 5.5.
- **Planned vs done:** `npm test`, P05-04 migration + `health.backend.js`, wire and flash the firmware, tick P05-04: all done. P04-08 leftovers not started (owner ended the session).
- **Files changed:** `firmware/init/src/main.cpp`, `firmware/init/include/config.h` (FW_VERSION), `documentation/phases/phase-05-admin-alerts.md`, `documentation/specs/FEATURES.md` (F-23), `PROGRESS_LOG.md`, `context/CURRENT_STATE.md`, this report.
- **Checks run:** `node --test --test-concurrency=1` 187/187; `tests/backend/*.backend.js` 73/73 (health 6/6 alone first); `pio run` SUCCESS; flash on COM8; read-only SQL on init-test (device_health row: rssi -52, POWERON, 0.6.0); `node tools/secret-scan.mjs` clean.
- **Verified:** device health from the real board reached the server and shows in `#admin` on the owner's phone (Good -49 dBm, Power on, 0.6.0, Just now). The old firmware kept uploading after the new migration (2-argument call still works).
- **Unsure / not tried:** a reset reason other than POWERON, weak-signal state, light mode of the health group; the migration is NOT on live; `npm test` as written fails (parallel gates race on `web/dist`): needs `--test-concurrency=1` in package.json (not changed); a real room or interval save from `#admin` and the OLED following it; whether the OLED shortens a room name over 12 characters.
- **Decisions / awaiting owner:** F-23 requested (proposed in FEATURES.md, design approval next session): reset-room button, and "Unassigned" as the only default room name. Push of `3e3a849` and the close commit: awaiting the owner's word naming the target.
- **Next first step:** ask the phase-builder question; propose F-23 (mock first); then the real room and interval saves, P04-08 leftovers.
- **Recommended model for the next session:** Sonnet 5.5 (F-23, saves, P04-08); Opus 5.5 for P05-03 and the live admin rollout.

## Phase Progress (HARD RULE 1)
```
| Phase | Done / Total | Progress | % |
|---|---|---|---|
| P00 Kickoff and decisions | 13 / 13 | ██████████ | 100% |
| P01 Heat index core and bench bring-up | 7 / 7 | ██████████ | 100% |
| P02 Backend and secure upload | 7 / 7 | ██████████ | 100% |
| P03 Device firmware | 10 / 10 | ██████████ | 100% |
| P04 Web app core | 12 / 13 (+1 partly) | █████████░ | 92% |
| P05 Admin, alerts and device health | 3 / 7 (+3 partly) | ████░░░░░░ | 43% |
| P06 Display and sharing extras | 0 / 5 | ░░░░░░░░░░ | 0% |
| P07 Field trial and hardening | 0 / 7 | ░░░░░░░░░░ | 0% |
| P08 Over-the-air updates (optional) | 0 / 3 | ░░░░░░░░░░ | 0% |
| **Whole project** | 52 / 72 | ███████░░░ | **72%** |
```

## Continuation prompt (HARD RULE 2)
`documentation/context/NEXT_SESSION_PROMPT.md`, generated by `node tools/continuation-prompt.mjs`; shown in the final message.
