CodenameTempest14/init-heat-monitoring/documentation/phase-reports/phase-03-firmware/sessions/2026-11-03_s25_CLOSE.md

# Phase 03 — Session s25 — CLOSE — 2026-11-03

[P03 · Device firmware · 10/10 done · 0 blocked · unverified 0]

- **Status:** Completed. **Phase builder:** owner only. **Model:** Sonnet 5.5.
- **Planned vs done:** P03-07 evidence and tick; 2 min offline rule check; F-15 `#heat` wording approved by the teacher (owner's word); push. Earlier commits of the session (P05-04 server/firmware/admin group, F-15 mocks and build) were made before this log was written; see CURRENT_STATE items 2a2 and 2a3.
- **Files changed (this part):** `documentation/phases/phase-03-firmware.md`, `PROGRESS_LOG.md`, `context/CURRENT_STATE.md`, this report. No code.
- **Checks run:** read-only SQL on init-test (row count 1 429, gaps 221/385/95 s, last row times); `node tools/secret-scan.mjs` clean; `node tools/phase-report.mjs`. No test suite run.
- **Verified:** 24 h run result and bank 100 -> 95 -> 90 % (owner's photos, owner read the numbers); 2 min offline badge seen on the hosted page in the owner's phone screenshot at 2 min after unplugging.
- **Unsure / not tried:** causes of the three gaps; the Online-before-2-min and 3 min marks; the F-15 page was not seen on a phone and the D-019 ranges vs the older 32/41/54 table were not re-checked; P05-04 migration not applied, firmware not wired or flashed; `npm test` not run.
- **Commits:** `70223d6`, `5cf104a` plus this close commit; pushed to `codenametempest14` and `main` at the owner's request.
- **Next first step:** ask if the board is replugged, run `npm test` once, apply the P05-04 migration to init-test, `health.backend.js` green, wire `health.h`, flash, then P04-08.
- **Recommended model next:** Sonnet 5.5; Opus 5.5 for P05-03 and the live admin rollout.
