CodenameTempest14/init-heat-monitoring/documentation/phase-reports/phase-03-firmware/sessions/2026-11-02_s22_CLOSE.md

# Phase 03 — Session s22 — CLOSE — 2026-11-02

[P03 · Device firmware · 9/10 done · 0 blocked · unverified 1]
(The tool prints "unverified 0": it counts only items marked UNVERIFIED. The one unverified change is the 2 min offline rule, inside the ticked P04-03.)

- **Status:** long session during the 24 h run (P03-07, ends 2026-11-03 10:03Z = 18:03 local). The owner chose to start P05 early. The run was never touched: 226 rows since 10:03Z at 13:50Z, newest under 60 s old, `interval_s` still 60.
- **Phase builder:** owner only (answered s22).
- **Models:** Sonnet 5.5 at the start, Opus 5.5 from the admin tests on (owner switched).

## Done
- **P05 details** P5-a to P5-j written and approved (FEATURES.md); design `documentation/specs/P05-01_05_DESIGN.md` with DECIDE 1 (keep 60-3600 s, power-bank warning) and DECIDE 2 (no raw column), both approved.
- **Backend (P05-05):** `tests/backend/admin.backend.js` (8, throwaway devices and users, safe during the run) seen red, then migration `20261105120000_admin.sql` (owner applied it to init-test), 8/8. Read back: one update policy on `settings` gated by `is_admin()`, only the five values updatable by signed-in users, none by anon; `admins` with row rules on, no policies and no grants; `is_admin()` and `admin_set_room()` executable by signed-in users only; no leftover test users or devices. `anon-probe` extended to 21 checks, 21/21 on init-test.
- **Design:** proposal A (`design/admin/`), then proposal B at the owner's request (`design/admin/proposal-b/`); **owner chose B**.
- **Admin view `#admin` (P05-01, P05-02, P05-06):** `web/src/Admin.jsx`, `admin.js`, `admin.css`. `tests/web-admin.test.js` 7/7 (red first). Driven in Chromium locally and on the hosted page (real CSP), 390 px light and dark. Two defects found by looking and fixed: offsets showed `0` instead of `0.0`; Tabler's invalid icon hid the number.
- **UI gate:** `tests/ui-gate-admin.test.js` 14/14 (12 pixel comparisons with the approved B images, one negative test, one test of what is sent).
- **Test admin on init-test:** `init-admin@init.com` with the owner's chosen password, kept in `.env` (`tools/make-test-admin.mjs`). The owner signed in on the hosted page (computer browser) and sent screenshots.
- **Checklist:** P05-01 ticked with evidence. P05-02, P05-05, P05-06 and P04-08 marked PROG with what is left.
- **Pushed** (owner approved each time, both targets): `8343495`, `abbf939`, `7726936`, `44e3d15`, `92e262b`, `2add1fb` to `codenametempest14` and `main`.

## Phase Progress
| Phase | Done / Total | Progress | % |
|---|---|---|---|
| P00 Kickoff and decisions | 13 / 13 | ██████████ | 100% |
| P01 Heat index core and bench bring-up | 7 / 7 | ██████████ | 100% |
| P02 Backend and secure upload | 7 / 7 | ██████████ | 100% |
| P03 Device firmware | 9 / 10 | █████████░ | 90% |
| P04 Web app core | 12 / 13 (+1 partly) | █████████░ | 92% |
| P05 Admin, alerts and device health | 1 / 6 (+3 partly) | ██░░░░░░░░ | 17% |
| P06 Display and sharing extras | 0 / 5 | ░░░░░░░░░░ | 0% |
| P07 Field trial and hardening | 0 / 7 | ░░░░░░░░░░ | 0% |
| P08 Over-the-air updates (optional) | 0 / 3 | ░░░░░░░░░░ | 0% |
| **Whole project** | 49 / 71 | ███████░░░ | **69%** |

## Which parts did I actually run, and what am I unsure about?
**Ran:** `admin.backend.js` (red, then 8/8 after the migration); the database read-back queries; `anon-probe` on init-test (21/21); `web-admin.test.js` (red, then 7/7); all web unit tests (62/62); the UI gates home, badge, history, school and admin, one file at a time (all pass); the admin view in Chromium on a local build and on the hosted page; read-only checks of the run.
**Not run:** `npm test` and the full backend suite (they wipe init-test during the run); anything on live.
**Unsure / not tried:**
- A real save from the page (room or a setting): only "Room 1" exists, and it is the run's device. The page's calls are tested against a fake, and the database calls are tested for real, but the two have never met for a save.
- The device picking up an interval changed from the page.
- The admin view on a phone.
- The admin pixel gate passed on its first run. Its negative test shows it can fail, but I never saw it fail on the real page.
- The test admin's password is weak and was shared in chat. It's fine for init-test, but must never be used on live. `init.com` is a real domain someone else owns, so a password-reset email would go to a stranger.
- `settings_touch()` is executable by anon. That's harmless, because Postgres refuses to run trigger functions directly, but it should be revoked in the next migration.
- Proposal A's mocks no longer render as approved, because its styles in `web/src/admin.css` were replaced by B's. Kept for the record only.

## Next session
Model: Sonnet 5.5. The run ends 18:03 local on 2026-11-03: bank level, row count and gaps, tick P03-07; unplug for the offline check (screenshots at about 2 and 3 min); `npm test` once; P04-08 phone checks; first real admin saves on the phone.
