CodenameTempest14/init-heat-monitoring/documentation/phase-reports/phase-03-firmware/sessions/2026-11-02_s15_START.md

# Phase 03 — Session s15 — START — 2026-11-02

[P03 · Device firmware · 9/10 done · 0 blocked · unverified 0]

- **Recommended model:** Sonnet 5.5 for P03-07 (24 h on the power bank, mostly waiting and reading the server). Opus 5.5 only if the logo-on-the-setup-page proposal was built in the same session (it changes the page code that handles the Wi-Fi password). Ran on Sonnet 5.5.
- **Phase builder (asked the owner):** owner only (answered in s15).
- **Session goal:** P03-07 (blocked on the power bank still charging, so it did not start). Owner decided the logo proposal at the start: approved, titles to be decided.
- **Starting state:** branch `codenametempest14`, in sync with `origin` at `7588dbb`. One untracked file (`.vscode/settings.json`, left alone).
- **Context loaded:** CLAUDE.md, CURRENT_STATE.md, phase-03-firmware.md, s14 CLOSE.

## Phase Progress at session start
| Phase | Done / Total | Progress | % |
|---|---|---|---|
| P00 Kickoff and decisions | 13 / 13 | ██████████ | 100% |
| P01 Heat index core and bench bring-up | 7 / 7 | ██████████ | 100% |
| P02 Backend and secure upload | 7 / 7 | ██████████ | 100% |
| P03 Device firmware | 9 / 10 | █████████░ | 90% |
| P04 Web app core | 5 / 13 | ████░░░░░░ | 38% |
| P05 Admin, alerts and device health | 0 / 6 | ░░░░░░░░░░ | 0% |
| P06 Display and sharing extras | 0 / 5 | ░░░░░░░░░░ | 0% |
| P07 Field trial and hardening | 0 / 7 | ░░░░░░░░░░ | 0% |
| P08 Over-the-air updates (optional) | 0 / 3 | ░░░░░░░░░░ | 0% |
| **Whole project** | 41 / 71 | ██████░░░░ | **58%** |

(The first chat reply printed P08 as `0 / 7` by mistake; the tool says 0 / 3.)
