CodenameTempest14/init-heat-monitoring/documentation/phase-reports/phase-03-firmware/sessions/2026-11-02_s14_CLOSE.md

# Phase 03 — Session s14 — CLOSE — 2026-11-02

[P03 · Device firmware · 9/10 done · 0 blocked · unverified 0]

- **Status:** P03-05 done (setup page, tried on the board). D-029 (logo and full name) chosen. S-12 closed. A logo-on-the-setup-page proposal is waiting for the owner.
- **Planned vs done:** planned P03-05: done. Owner added: logo and full name (done, D-029), title centred on the setup page (done), logo on the setup page (proposal made, not approved, not built). P03-07 not started (owner chose to start it in a new Sonnet session).
- **Phase builder:** owner only (answered s14).
- **Files changed:** `design/device-setup/` (3 pages, `capture.mjs`, `ref/`, `proposal-logo/`), `design/brand/` (logos, `build-logos.mjs`, preview), `design/pages.json`, `design/REGISTRY.md`, `design/README.md`, `README.md`, `firmware/init/include/{wifi_setup,config,secrets.h.example}`, `firmware/init/src/main.cpp`, `firmware/init/tests/{wifi_setup_test,setup_page_render}.cpp`, `tests/firmware-setup-page.test.js`, `tests/firmware-pc.test.js`, READMEs, DECISIONS (D-029), SECURITY_REVIEW (S-12), phase-03 checklist, state, log. Local only (gitignored): `SECRET_SETUP_PASS` appended to `firmware/init/include/secrets.h`.
- **Build, tests and checks run:**
  - `npm test` 38/38 (36 at the start). New tests seen red first (header missing); mutations caught: `"` escape removed (2 checks), 7-character passwords allowed (1), one page letter changed (page test).
  - `pio run` for `esp32dev`, `esp32dev_screens`, `esp32dev_wrongca`: SUCCESS (RAM 19.3 %, flash 76.9 %).
  - Contrast of the new page colours: lowest 4.74:1 (border), 5.33:1 (text).
  - Board (owner flashed and used the phone; I read the server): setup mode on first start; Android opened the page by itself; save, then uploads from 06:02:52Z; power cut, then rejoined at 06:10:25Z with no setup; hotspot off: setup mode, saved network named, `12345` refused (screenshot); hotspot on: rows from 06:21:01Z.
  - `tools/secret-scan.mjs` on every commit; it blocked one commit because the owner's hotspot name was in the evidence text (removed).
- **Unverified changes:** 0.
- **Commits and push:** `b09a985`, `0e2264d`, `fff4d4a`, `57aa47b`, `a02ce3e` and the close commit, all local. Push to `codenametempest14` and `main` asked at close, not yet answered.
- **Problems and diagnosis:** (1) The WebServer library decodes forms itself, so my own form reader would never run: removed it and its tests, kept validation, escaping and pages; added a NUL-in-value refusal in `main.cpp`. (2) A raw string literal would copy the header file's line ends (git may check out CRLF); replaced with `"\n"` strings. (3) The Windows test program turned `\n` into `\r\n`: binary stdout. (4) My background serial recording wrote the same text over and over (20 MB): cause not found, file deleted; the server rows were the evidence. (5) The secret scan caught the hotspot name in the evidence.
- **Decisions made:** setup at start-up only and WPA2 on `Init-Setup` (owner, recorded in S-12 and the checklist); setup page approved with centred title; D-029 logo (B icon + A wordmark) and full name option 1.
- **Which parts did I actually run, and what am I unsure about?** I ran all PC tests, the mutations, the three builds, the contrast check, the screenshots and the server queries. The owner flashed, used the phone and power-cycled the board; I saw their screenshots and the server rows, not the serial lines. Unsure: the 10-minute setup timeout was not waited out; only Android in dark mode was tried; the serial capture failure is not explained; the one reading that arrived 12 s late (06:15:25Z) is probably the hotspot; flash is 76.9 % full, which will matter for OTA (P08).
- **Handoff:** P03-07 (24 h on the power bank, Sonnet 5.5). Owner decides on the logo-on-the-setup-page proposal (`design/device-setup/proposal-logo/`).
- **Recommended model for the next session:** Sonnet 5.5 (P03-07 is mostly waiting and reading the server). Opus 5.5 only if the logo proposal is approved and built in the same session (it touches the page code that handles the Wi-Fi password).

## Phase Progress
**At session start:** 40 / 71, 56%.
**At session end:** 41 / 71, 58% (table in the final message).
