CodenameTempest14/init-heat-monitoring/documentation/phase-reports/phase-03-firmware/sessions/2026-11-02_s14_START.md

# Phase 03 — Session s14 — START — 2026-11-02

[P03 · Device firmware · 8/10 done · 0 blocked · unverified 0]

- **Recommended model:** Opus 5.5 for P03-05 (the setup page takes Wi-Fi passwords from a phone; running on Opus 5.5). Sonnet 5.5 for P03-07.
- **Phase builder (asked the owner):** owner only (answered in s14).
- **Session goal:** P03-05 setup page (D-011). Step one: the owner decides the open design questions and approves the page design (`device-setup` is still `Proposed` in `design/pages.json`) before any firmware is written.
- **Starting state:** branch `codenametempest14`, in sync with `origin/codenametempest14` at `dcff39d` (so s13 was pushed after all; CURRENT_STATE.md said "local", to fix at close). One untracked file (`.vscode/settings.json`, left alone).
- **Context loaded:** CLAUDE.md, CURRENT_STATE.md, phase-03-firmware.md, s13 CLOSE.

## Phase Progress at session start
| Phase | Done / Total | Progress | % |
|---|---|---|---|
| P00 Kickoff and decisions | 13 / 13 | ██████████ | 100% |
| P01 Heat index core and bench bring-up | 7 / 7 | ██████████ | 100% |
| P02 Backend and secure upload | 7 / 7 | ██████████ | 100% |
| P03 Device firmware | 8 / 10 | ████████░░ | 80% |
| P04 Web app core | 5 / 13 | ████░░░░░░ | 38% |
| P05 Admin, alerts and device health | 0 / 6 | ░░░░░░░░░░ | 0% |
| P06 Display and sharing extras | 0 / 5 | ░░░░░░░░░░ | 0% |
| P07 Field trial and hardening | 0 / 7 | ░░░░░░░░░░ | 0% |
| P08 Over-the-air updates (optional) | 0 / 3 | ░░░░░░░░░░ | 0% |
| **Whole project** | 40 / 71 | ██████░░░░ | **56%** |
