CodenameTempest14/init-heat-monitoring/documentation/phase-reports/phase-03-firmware/sessions/2026-11-02_s13_CLOSE.md

# Phase 03 — Session s13 — CLOSE — 2026-11-02

[P03 · Device firmware · 8/10 done · 0 blocked · unverified 0]

- **Status:** P03-04 and P03-06 done. D-028 done (init-test). Live `init` set up (D-027 closed). Secret-scan tool built. `tools/db.mjs` argument quoting fixed.
- **Planned vs done:** planned the secret-scan tool and P03-04: done. Owner added: live "Init" setup (done by the owner, verified by me), then P03-06 and D-028 (both done). P03-05 and P03-07 not started.
- **Phase builder:** owner only.
- **Files changed:** `tools/secret-scan.mjs`, `tools/db.mjs`, `firmware/init/include/{heat_index,screens,screen_test,room,readings,config}.h`, `firmware/init/src/main.cpp`, `firmware/init/platformio.ini` (env `esp32dev_screens`), `firmware/init/tests/{heat_index,room,readings}_test.cpp`, `supabase/migrations/20261102140000_ingest_returns_room.sql`, `tests/backend/ingest.backend.js`, `tests/{secret-scan,firmware-heat-index,firmware-pc,oled-dump}.test.js`, `design/oled/{dump,check-dump}.mjs`, READMEs, SCHEMA, DECISIONS (D-028), phase-03 checklist, state, log.
- **Build, tests and checks run:**
  - `npm test` 36/36 (27 at the start of the session). `npm run test:backend` 48/48 on init-test (the new room test seen red first). All new tests were seen red first; a mutation in `heat_index.h`, `room.h` and `readings.h` each made its test fail.
  - `pio run` for `esp32dev`, `esp32dev_screens` and `esp32dev_wrongca`: SUCCESS.
  - P03-04 on the real board: frame-buffer dump 9/9 equal the approved images; owner's photos; owner read `29.5°C`, `RH 71%`, `34` against the server row.
  - D-028 on the real board: reply `{"room": "Unassigned", ...}`; OLED strip showed `Unassigned` (fallback is `Room 1`).
  - P03-06 on the real board: hotspot off about 5 minutes, OLED `NO WI-FI`, kept updating, `2 to send` growing; after it came back `Wi-Fi OK`, queue line gone; server `received_at` shows the 5 readings measured 05:18:45 to 05:22:46 all received at 05:23:01 with their real times.
  - Live `init`: `migration list` shows all 6 on both sides; owner ran the interval update in the dashboard; I read back `Init 1` = 60.
  - `tools/secret-scan.mjs` blocked a fake diff with the real device key (exit 1); every commit's diff was scanned clean.
- **Unverified changes:** 0.
- **Commits and push:** pushed with the owner's approval to `codenametempest14` and `main` (twice, up to `2e9b484`). Later commits (`9d94b42` D-028 and the P03-06 close commit) are local: push needs the owner's approval, targets named in the question.
- **Problems and diagnosis:** (1) The first flash attempt failed with `Wrong boot mode`: BOOT must be held before the upload starts; the owner flashed it themselves each time. (2) `tools/db.mjs` split quoted SQL into words (`shell: true`); fixed by quoting, checked with an inline query. (3) The CLI access token is read-only, so the live interval update had to go through the dashboard SQL Editor. (4) The serial capture of the screens build began with about 3 350 lines of zeros: cause not found. (5) The owner first took the big 35 on screen for a test: it is the heat index, the bottom line is the air temperature. (6) Opening COM8 does not always reset the board, so I did not open it during the offline test; the server was the evidence.
- **Decisions made:** D-028 (owner: yes). Heat index that is a number but under the first PAGASA band shows the number with `NO RATING BELOW 27°C`.
- **Which parts did I actually run, and what am I unsure about?** I ran all tests, builds, serial reads and server queries above. The owner ran the flashes, the hotspot switching and the live dashboard update; I only read the results. Unsure: the zero lines in the screens capture; sensor-error and offline screens were not provoked by a real fault; a queue over 50, a full queue and the 400-drop path were not tried on the board; the queue is RAM only (a restart loses it); a send to an unreachable server can still block the loop for the HTTP timeout; 29.5 °C not checked against a second thermometer; the 7th migration is not on live `init` yet.
- **Handoff:** P03-05 (setup page, Opus 5.5), then P03-07 (24 h on the bank). Before the board moves to live: apply the 7th migration to live `init` (owner, `node --env-file=.env tools/db.mjs live db push`).
- **Recommended model for the next session:** Opus 5.5 for P03-05; Sonnet 5.5 for P03-07.

## Phase Progress
**At session start:** 38 / 71, 54%.
**At session end:** 40 / 71, 56% (table in the final message).
