CodenameTempest14/init-heat-monitoring/documentation/phase-reports/phase-03-firmware/sessions/2026-11-02_s13_START.md

# Phase 03 — Session s13 — START — 2026-11-02

[P03 · Device firmware · 6/10 done · 0 blocked · unverified 0]

- **Recommended model:** Sonnet 5.5 for P03-04 (ran on Sonnet 5.5); Opus 5.5 for P03-05.
- **Phase builder (asked the owner):** owner only (answered at the start of s13).
- **Session goal:** secret-scan tool, then P03-04 (OLED on the real display). The owner also asked for help setting up live "Init" (migration 6 and interval 60).
- **Starting state:** branch `codenametempest14`, one untracked file (`.vscode/settings.json`, left alone). Board on COM8, hotspot on.
- **Context loaded:** CLAUDE.md, CURRENT_STATE.md, phase-03-firmware.md, s12 CLOSE.

## Phase Progress at session start
38 / 71, 54% (P03 6/10, 60%).
