CodenameTempest14/init-heat-monitoring/documentation/phase-reports/phase-03-firmware/sessions/2026-11-02_s12_CLOSE.md

# Phase 03 — Session s12 — CLOSE — 2026-11-02

[P03 · Device firmware · 6/10 done · 0 blocked · unverified 0]

- **Status:** P03-03 done. Normal build reflashed. Bank finding recorded (D-027).
- **Planned vs done:** planned reflash and P03-03. Both done. P03-04 not started.
- **Phase builder:** owner only.
- **Files changed:** `supabase/migrations/20261102120000_ingest_returns_interval.sql` (new, init-test only), `tests/backend/ingest.backend.js`, `firmware/init/include/interval.h` and `firmware/init/tests/` (new), `firmware/init/src/main.cpp`, `.gitignore`, `firmware/init/.gitignore`, SCHEMA.md, DECISIONS (D-027), phase-03 checklist, state and logs.
- **Build, tests and checks run:**
  - Backend `npm run test:backend` 47/47 (2 new, seen red first). `npm test` 23/23. PC test of `interval.h` passes and fails under a deliberate break. `pio run` SUCCESS for `esp32dev` and `esp32dev_wrongca`.
  - Board over USB: `-> 200 ... "interval_s": 90`, `interval 60 s -> 90 s`, uploads 90 s apart; then 60 s after the server value changed.
  - ROMOSS bank (owner, 3:11 to 3:21 AM): 90 s made the bank switch off after about a minute; 60 s gave uploads exactly 60 s apart for 9 minutes (server timestamps), board still on at 10 min.
  - Staged diff scanned for the secret values in `.env` and `secrets.h`: 2 hits, both plain words from comment lines, no credential.
- **Unverified changes:** 0.
- **Commits and push:** `2c1d5f5`, `c669e1c`, plus this close commit. Pushed to `codenametempest14` and `main` with the owner's approval (named in the message).
- **Problems and diagnosis:** (1) Opening COM8 resets the board, so my first serial read made a second upload within 30 s and got `429`; same on later reads (expected, rate limit working). (2) My slice of the old migration stopped at an earlier `revoke execute` line; caught by the failed self-check before any file was written. (3) A Node script turned `\n` into real newlines again (same trap as s11); switched to the Edit tool. (4) The secret-scan script printed hits but did not stop the commit; the hits were checked afterwards and were false positives (the script must exit non-zero on a hit; not fixed yet).
- **Decisions made:** D-027.
- **Which parts did I actually run, and what am I unsure about?** I ran the tests, builds, serial reads and server queries above myself. The bank test I only saw through server timestamps and the owner's report. Unsure: the real cause of the bank cut-out (no meter; the earlier bench finding supports it); only 10 minutes on the bank at 60 s; the migration is not on live `init`; the device keeps the old interval when a reply has no value (tested on the PC, not on the board).
- **Handoff:** P03-04 (OLED screens on the real display). Owner decisions open: live `init` migration and interval 60 for "Init 1" (D-027).
- **Recommended model for the next session:** Sonnet 5.5 for P03-04 and P03-06; Opus 5.5 for P03-05.

## Phase Progress
**At session start:** 37 / 71, 52% (table in the START report).
**At session end:**
| Phase | Done / Total | Progress | % |
|---|---|---|---|
| P00 Kickoff and decisions | 13 / 13 | ██████████ | 100% |
| P01 Heat index core and bench bring-up | 7 / 7 | ██████████ | 100% |
| P02 Backend and secure upload | 7 / 7 | ██████████ | 100% |
| P03 Device firmware | 6 / 10 | ██████░░░░ | 60% |
| P04 Web app core | 5 / 13 | ████░░░░░░ | 38% |
| P05 Admin, alerts and device health | 0 / 6 | ░░░░░░░░░░ | 0% |
| P06 Display and sharing extras | 0 / 5 | ░░░░░░░░░░ | 0% |
| P07 Field trial and hardening | 0 / 7 | ░░░░░░░░░░ | 0% |
| P08 Over-the-air updates (optional) | 0 / 3 | ░░░░░░░░░░ | 0% |
| **Whole project** | 38 / 71 | █████░░░░░ | **54%** |
