CodenameTempest14/init-heat-monitoring/documentation/phase-reports/phase-03-firmware/sessions/2026-11-02_s12_START.md

# Phase 03 — Session s12 — START — 2026-11-02

[P03 · Device firmware · 5/10 done · 0 blocked · unverified 0]

- **Recommended model:** Sonnet 5.5 for P03-03, P03-04, P03-06; Opus 5.5 for P03-05. Session ran on Sonnet 5.5.
- **Phase builder (asked the owner):** owner only (answered at the start of s12).
- **Session goal:** reflash the normal build, then P03-03 (interval from the server settings).
- **Starting state:** branch `codenametempest14` in sync with origin, three untracked files (decided: commit `firmware/init/.gitignore`, ignore `firmware/init/.vscode/`).
- **Context loaded:** CLAUDE.md, CURRENT_STATE.md, phase-03-firmware.md, s11 CLOSE.

## Phase Progress at session start
| Phase | Done / Total | Progress | % |
|---|---|---|---|
| P00 Kickoff and decisions | 13 / 13 | ██████████ | 100% |
| P01 Heat index core and bench bring-up | 7 / 7 | ██████████ | 100% |
| P02 Backend and secure upload | 7 / 7 | ██████████ | 100% |
| P03 Device firmware | 5 / 10 | █████░░░░░ | 50% |
| P04 Web app core | 5 / 13 | ████░░░░░░ | 38% |
| P05 Admin, alerts and device health | 0 / 6 | ░░░░░░░░░░ | 0% |
| P06 Display and sharing extras | 0 / 5 | ░░░░░░░░░░ | 0% |
| P07 Field trial and hardening | 0 / 7 | ░░░░░░░░░░ | 0% |
| P08 Over-the-air updates (optional) | 0 / 3 | ░░░░░░░░░░ | 0% |
| **Whole project** | 37 / 71 | █████░░░░░ | **52%** |
