CodenameTempest14/init-heat-monitoring/documentation/phase-reports/phase-03-firmware/sessions/2026-11-02_s11_CLOSE.md

# Phase 03 — Session s11 — CLOSE — 2026-11-02

[P03 · Device firmware · 5/10 done · 0 blocked · unverified 0]

- **Status:** P04-D4 and P03-02 done; P03-01 now also run on the board. S-11 closed.
- **Planned vs done:** planned P04-D4, flash P03-01, P03-02. All done.
- **Phase builder:** owner only (s10 answer; not re-confirmed in s11).
- **Files changed:** `design/pages.json`, `design/REGISTRY.md` (4 Tabler pages Approved; device-setup stays Proposed), `firmware/README.md` (how to flash init not bench), `firmware/init/` (main.cpp upload loop, new `include/root_ca.h`, secrets.h.example with anon key and temporary Wi-Fi, platformio.ini `default_envs` and `esp32dev_wrongca`, README), DECISIONS (D-026), SECURITY_REVIEW (S-11 closed), phase-03 and phase-04 checklists, state and logs.
- **Build, tests and checks run:**
  - `npm test` passed (0 failures) after the P04-D4 change. `pio run` SUCCESS for `esp32dev` and `esp32dev_wrongca`. README check passes.
  - P03-01 on the board: OLED "Init" (owner), serial `T=28.4 H=64.5` every 2.00 s (assistant read COM8).
  - P03-02 on the board via the owner's hotspot to init-test: `-> 200 {"saved": 1, "duplicates": 0}` at 18:16:16Z and 18:17:16Z; server rows confirmed, heat index 30.7 = JS 30.66. Wrong-CA build: `(-9984) X509 - Certificate verification failed` twice, server newest row stayed 18:28:17, `last_seen_at` unchanged.
  - PC precheck: `openssl s_client -CAfile` 3-root bundle = 0 (ok), ISRG X1 = 20. GTS R1/R4 byte-identical between pki.goog and the system bundle.
  - Staged diff scanned for the 9 secret values from `.env` and `secrets.h`: none found.
- **Unverified changes:** 0. **But the board is left running the WRONG-CA test build** (owner has not flashed the normal build back). It fails every upload by design; nothing is lost because init-test is a test project.
- **Commits and push:** `f3d851e`, `7144620`, `d81e510`, plus this close commit. Push: asked in the final message.
- **Problems and diagnosis:** (1) First upload: "Wrong boot mode (0x17)", fixed by holding BOOT. (2) "Chip stopped responding" once on my upload; the owner's later uploads all worked, cause not found. I also started a second upload without telling the owner (my mistake, no harm). (3) Upload from the VS Code toolbar flashed `bench` (both projects named `esp32dev`, toolbar hidden at repo root); now flashed from the terminal, documented. (4) A 10 s serial read returned ~100 000 lines: a backlog buffered on the PC; after draining, live rate was exactly 1 line / 2 s. Cause of the backlog not confirmed. (5) First Wi-Fi run failed: the owner's edit of `secrets.h` was not saved. (6) Shell escaping turned `\n` into real newlines when generating root_ca.h; switched to a Node script with a round-trip check. (7) At close, my state-update script was inside a double-quoted shell string, so bash ran the backtick parts as commands, including `pio run -t upload`; it failed with "Not a PlatformIO project" (repo root), nothing was flashed or written. State files then edited with the Edit tool.
- **Decisions made:** D-026 (temporary Wi-Fi in secrets.h until P03-05; init-test first; roots GTS R1 + R4 + GlobalSign).
- **Which parts did I actually run, and what am I unsure about?** I ran every check above myself except: the OLED text and the uploads (the owner flashed and reported). Unsure: why my own upload attempt stopped mid-way; where the serial backlog came from; whether NTP keeps working on every hotspot (only tested on the owner's); the 60 s interval is fixed in code (P03-03 moves it to settings). `firmware/init/.gitignore` and `firmware/init/.vscode/` (made by the PlatformIO extension) are left untracked, owner to decide.
- **Handoff:** flash the normal build back first (`pio run -t upload --upload-port COM8` in `firmware/init`), check `-> 200`; then P03-03.
- **Recommended model for the next session:** Sonnet 5.5 for P03-03, P03-04, P03-06; Opus 5.5 for P03-05 (setup page).

## Phase Progress
**At session start:** see the s11 START report (35 / 71, 49%).
**At session end:**
```
| Phase | Done / Total | Progress | % |
|---|---|---|---|
| P00 Kickoff and decisions | 13 / 13 | ██████████ | 100% |
| P01 Heat index core and bench bring-up | 7 / 7 | ██████████ | 100% |
| P02 Backend and secure upload | 7 / 7 | ██████████ | 100% |
| P03 Device firmware | 5 / 10 | █████░░░░░ | 50% |
| P04 Web app core | 5 / 13 | ████░░░░░░ | 38% |
| P05 Admin, alerts and device health | 0 / 6 | ░░░░░░░░░░ | 0% |
| P06 Display and sharing extras | 0 / 5 | ░░░░░░░░░░ | 0% |
| P07 Field trial and hardening | 0 / 7 | ░░░░░░░░░░ | 0% |
| P08 Over-the-air updates (optional) | 0 / 3 | ░░░░░░░░░░ | 0% |
| **Whole project** | 37 / 71 | █████░░░░░ | **52%** |
```
