CodenameTempest14/init-heat-monitoring/documentation/phase-reports/phase-03-firmware/sessions/2026-11-02_s11_START.md

# Phase 03 — Session s11 — START — 2026-11-02

[P03 · Device firmware · 4/10 done · 0 blocked · unverified 0]

- **Recommended model:** Opus 5.5 for P03-02 (TLS check, device key); Sonnet 5.5 for the P04-D4 follow-up. Session started on Sonnet 5.5, owner switched to Opus 5.5 before any change.
- **Phase builder (asked the owner):** not answered this session; recorded as owner only (s10 answer), not re-confirmed.
- **Session goal:** P04-D4 owner approval, flash the P03-01 skeleton, then P03-02.
- **Starting state:** branch `codenametempest14`, commit `75fd52c`, only `.vscode/settings.json` untracked.
- **Context loaded:** CLAUDE.md, CURRENT_STATE.md, phase-03-firmware.md, s10 CLOSE.

## Phase Progress at session start
| Phase | Done / Total | Progress | % |
|---|---|---|---|
| P00 Kickoff and decisions | 13 / 13 | ██████████ | 100% |
| P01 Heat index core and bench bring-up | 7 / 7 | ██████████ | 100% |
| P02 Backend and secure upload | 7 / 7 | ██████████ | 100% |
| P03 Device firmware | 4 / 10 | ████░░░░░░ | 40% |
| P04 Web app core | 4 / 13 | ███░░░░░░░ | 31% |
| P05 Admin, alerts and device health | 0 / 6 | ░░░░░░░░░░ | 0% |
| P06 Display and sharing extras | 0 / 5 | ░░░░░░░░░░ | 0% |
| P07 Field trial and hardening | 0 / 7 | ░░░░░░░░░░ | 0% |
| P08 Over-the-air updates (optional) | 0 / 3 | ░░░░░░░░░░ | 0% |
| **Whole project** | 35 / 71 | █████░░░░░ | **49%** |
