CodenameTempest14/init-heat-monitoring/documentation/phase-reports/phase-03-firmware/sessions/2026-11-02_s10_START.md

# Phase 03 — Session s10 — START — 2026-11-02

[P03 · Device firmware · 3/10 done · 0 blocked · unverified 0]

- **Recommended model:** Sonnet 5.5 for P03-01 and P04-D4/D5; Opus 5.5 for P03-02 and P03-05. Session ran on Sonnet 5.5.
- **Phase builder (asked the owner):** owner only (answered s10: "Only me").
- **Session goal:** P03-01, then (owner's request) P04-D4 and P04-D5, then the s08 cron check.
- **Starting state:** branch `codenametempest14`, commit `77a4340`, only `.vscode/settings.json` untracked. PlatformIO Core 6.2.0 already installed.
- **Context loaded:** CLAUDE.md, CURRENT_STATE.md, phase-03-firmware.md, s09 CLOSE.

## Phase Progress at session start
| Phase | Done / Total | Progress | % |
|---|---|---|---|
| P00 Kickoff and decisions | 13 / 13 | ██████████ | 100% |
| P01 Heat index core and bench bring-up | 7 / 7 | ██████████ | 100% |
| P02 Backend and secure upload | 7 / 7 | ██████████ | 100% |
| P03 Device firmware | 3 / 10 | ███░░░░░░░ | 30% |
| P04 Web app core | 3 / 13 | ██░░░░░░░░ | 23% |
| P05 Admin, alerts and device health | 0 / 6 | ░░░░░░░░░░ | 0% |
| P06 Display and sharing extras | 0 / 5 | ░░░░░░░░░░ | 0% |
| P07 Field trial and hardening | 0 / 7 | ░░░░░░░░░░ | 0% |
| P08 Over-the-air updates (optional) | 0 / 3 | ░░░░░░░░░░ | 0% |
| **Whole project** | 33 / 71 | █████░░░░░ | **46%** |
