CodenameTempest14/init-heat-monitoring/documentation/phase-reports/phase-03-firmware/sessions/2026-11-01_s09_CLOSE.md

# Phase 03 — Session s09 — CLOSE — 2026-11-01

[P03 · Device firmware · 3/10 done · 0 blocked · unverified 0]

- **Status:** the OLED design canvas (P03-D1 to D3) is finished. The firmware build items (P03-01 to P03-07) are not started.
- **Planned vs done:** planned S-4 to S-6 read-back and P03-D1 (then D2). Done: read-back, D1, D2 (owner approved), D3.
- **Phase builder:** owner only (answered s09).
- **Files changed:** `design/oled/` (README, `font5x7.mjs`, `render.mjs`, `screens.mjs`, `build-refs.mjs`, `compare.mjs`, `ref/` and `preview/` with 9 images each, READMEs), `tests/oled.test.js` (new), `tests/README.md`, `design/README.md`, `documentation/DECISIONS.md` (D-025), `documentation/specs/SECURITY_REVIEW.md` (S-4 to S-6 read-back), phase-03 checklist, s09 reports, CURRENT_STATE, PROGRESS_LOG, NEXT_SESSION_PROMPT.
- **Build, tests and checks run:**
  - Read-back with the read-only token: `disable_signup` true and SSL enforced on both `init-test` and live `init` (first read showed live still open; the owner fixed it; second read correct). `db push --dry-run` connects on both projects.
  - `tests/oled.test.js`: red first (comparison module missing), then 4/4. Shown to fail on a flipped pixel, a changed number and the wrong image. Mutation of the real code (footer 1 px lower) failed 2 tests (185 pixels), restored, 4/4. Decoder checked on a Pillow-encoded PNG (0 differences). `npm test` 18/18. `node tools/check-readmes.mjs` passes.
  - I looked at 7 of the 9 previews (OLED-01 extreme caution and extreme danger, 02, 03, 04, 05, 06) and fixed two layout problems seen there. The caution and danger variants use the same layout; not opened.
- **Unverified changes:** 0.
- **Commits and push:** `d2fe01b`, `be38cf0`, `eacc59d`, plus this close commit. Push: asked in the final message.
- **Problems and diagnosis:**
  - My first sample inputs for the "danger" screen gave "extreme-danger"; the build check caught it, samples changed to 38 °C / 50 %.
  - The OLED-02 text was 23 characters (cut off at 21); shortened. The "to send" line touched the category bar; moved up.
  - A Windows path in a Python one-liner failed (quoting); re-run with a relative path. No effect on results.
- **Decisions made:** D-025 (OLED always on, no wake button yet, sensor error screen approved, blue-only module, Adafruit 5x7 font scaled 1 to 4). Owner approved whole-degree heat index and the setup names `Init-Setup` / `192.168.4.1` (P03-05 may change them).
- **Which parts did I actually run, and what am I unsure about?** I ran everything listed above. I did not run: anything on the real OLED or board (the gate is the PC render; the photo check comes in P03-04); the S-6 password length check (I did not open `.env`; I only know the logins work); the `init-test` cron check from s08 (first scheduled run), carried over. Unsure: whether the real SSD1306 shows the 5×7 font at size 4 as cleanly as the render (the "4" and "0" have a visible step); whether Adafruit GFX's `cp437(true)` gives the degree sign on this library version (check in P03-04).
- **Handoff:** the next work is the firmware build (P03-01), or the web design items P04-D4 and P04-D5.
- **Recommended model for the next session:** Sonnet 5.5 for P03-01 and P04-D4/D5. Switch to Opus 5.5 for P03-02 (device key, TLS certificate check) and P03-05 (setup page).

## Phase Progress
**At session start:**
```
| Phase | Done / Total | Progress | % |
|---|---|---|---|
| P00 Kickoff and decisions | 13 / 13 | ██████████ | 100% |
| P01 Heat index core and bench bring-up | 7 / 7 | ██████████ | 100% |
| P02 Backend and secure upload | 7 / 7 | ██████████ | 100% |
| P03 Device firmware | 0 / 10 | ░░░░░░░░░░ | 0% |
| P04 Web app core | 3 / 13 | ██░░░░░░░░ | 23% |
| P05 Admin, alerts and device health | 0 / 6 | ░░░░░░░░░░ | 0% |
| P06 Display and sharing extras | 0 / 5 | ░░░░░░░░░░ | 0% |
| P07 Field trial and hardening | 0 / 7 | ░░░░░░░░░░ | 0% |
| P08 Over-the-air updates (optional) | 0 / 3 | ░░░░░░░░░░ | 0% |
| **Whole project** | 30 / 71 | ████░░░░░░ | **42%** |
```
**At session end:**
```
| Phase | Done / Total | Progress | % |
|---|---|---|---|
| P00 Kickoff and decisions | 13 / 13 | ██████████ | 100% |
| P01 Heat index core and bench bring-up | 7 / 7 | ██████████ | 100% |
| P02 Backend and secure upload | 7 / 7 | ██████████ | 100% |
| P03 Device firmware | 3 / 10 | ███░░░░░░░ | 30% |
| P04 Web app core | 3 / 13 | ██░░░░░░░░ | 23% |
| P05 Admin, alerts and device health | 0 / 6 | ░░░░░░░░░░ | 0% |
| P06 Display and sharing extras | 0 / 5 | ░░░░░░░░░░ | 0% |
| P07 Field trial and hardening | 0 / 7 | ░░░░░░░░░░ | 0% |
| P08 Over-the-air updates (optional) | 0 / 3 | ░░░░░░░░░░ | 0% |
| **Whole project** | 33 / 71 | █████░░░░░ | **46%** |
```
