CodenameTempest14/init-heat-monitoring/documentation/phase-reports/phase-03-firmware/sessions/2026-11-01_s09_START.md

# Phase 03 — Session s09 — START — 2026-11-01

[P02 · Backend and secure upload · 7/7 done · 0 blocked · unverified 0]

- **Recommended model for this session:** Sonnet 5.5 (design work, no security-sensitive changes). Session ran on Sonnet 5.5.
- **Phase builder (asked the owner):** owner only (answered s09: "Only me").
- **Session goal:** the owner's dashboard actions S-4 to S-6 (guided), then the OLED design canvas P03-D1 to D3.
- **Starting state:** branch `codenametempest14`, commit `1ae3a18`, working tree clean.
- **Context loaded:** CLAUDE.md, CURRENT_STATE.md, phase-03-firmware.md, s08 CLOSE.
- **Open questions for the owner:** did the owner do S-4 to S-6 (answer: no, then guided); wake button, sensor error screen, module colour (asked after D1).

## Phase Progress at session start (HARD RULE 1)
```
| Phase | Done / Total | Progress | % |
|---|---|---|---|
| P00 Kickoff and decisions | 13 / 13 | ██████████ | 100% |
| P01 Heat index core and bench bring-up | 7 / 7 | ██████████ | 100% |
| P02 Backend and secure upload | 7 / 7 | ██████████ | 100% |
| P03 Device firmware | 0 / 10 | ░░░░░░░░░░ | 0% |
| P04 Web app core | 3 / 13 | ██░░░░░░░░ | 23% |
| P05 Admin, alerts and device health | 0 / 6 | ░░░░░░░░░░ | 0% |
| P06 Display and sharing extras | 0 / 5 | ░░░░░░░░░░ | 0% |
| P07 Field trial and hardening | 0 / 7 | ░░░░░░░░░░ | 0% |
| P08 Over-the-air updates (optional) | 0 / 3 | ░░░░░░░░░░ | 0% |
| **Whole project** | 30 / 71 | ████░░░░░░ | **42%** |
```
