CodenameTempest14/init-heat-monitoring/documentation/phase-reports/phase-02-backend/sessions/2026-10-31_s08_CLOSE.md

# Phase 02 — Session s08 — CLOSE — 2026-10-31

[P02 · Backend and secure upload · 7/7 done · 0 blocked · unverified 0]

- **Status:** P02 complete (7 of 7), on `init-test` and on the live `init` project.
- **Planned vs done:** planned P02-05, P02-06, then the live migration with the owner's approval. All done; P02-07 finished with P02-05. The live push and device registration were run by the owner (see problems).
- **Phase builder:** owner only (answered s08).
- **Files changed:** `supabase/migrations/20261031160000_retention.sql` (new), `tests/backend/retention.backend.js` (new), `documentation/specs/SECURITY_REVIEW.md` (new), `SCHEMA.md` (retention as built, title), specs/migrations/tests READMEs, phase checklists P02 (ticks, live evidence), P03 (P03-02 TLS check, S-11), P05 (P05-05 named admin S-4, P05-06 room names S-10); s08 start and close reports, CURRENT_STATE, PROGRESS_LOG, NEXT_SESSION_PROMPT.
- **Build, tests and checks run:**
  - Retention: red first (3/3 fail with PGRST202), migration pushed to `init-test`, 3/3 pass. Added the whole-hours test; mutation check (job swapped on `init-test` for a copy without the hour rounding) made exactly that test fail; restored from the migration text; 4/4 pass.
  - `npm run test:backend` 44/44 twice, then 45/45 after the last test was added. `npm test` 14/14.
  - `cron.job` read back (active, `30 18 * * *`, postgres); `cron.timezone` GMT.
  - Advisor on both projects: only the accepted `ingest_reading` warning.
  - Security review probes: auth and SSL settings read on both projects; public-key probes on `init-test`; secret scan of all 36 commits with a control string.
  - Live, after the owner's push: 5/5 migrations local = remote; "Init 1" registered, room "Unassigned", key hash matches `.env` (boolean only); anon insert/`key_hash`/rollup 42501; wrong key 403; cron job active.
- **Unverified changes:** 0.
- **Commits and push:** `adb0432`, `e2aa193`, `ed7ecbb`, plus this close commit. Push: asked in the final message.
- **Problems and diagnosis:**
  - My first "public cannot run the job" test would have passed before the function existed (404 also counted). Tightened to require 42501 before the red run.
  - Claude Code's auto-mode classifier blocked `tools/db.mjs live db push` as a production deploy, although the owner had approved it. Not worked around; the owner ran it and `device-key.mjs register live "Init 1"` in the terminal.
  - PowerShell 5.1 mangles `"` inside a `-m` commit message passed to git, and `2>$null` hid the failure. Committed with `-F <file>` instead. For the next sessions: use a message file when the message has double quotes.
  - I said "6 migrations" to the owner; there are 5. Corrected.
- **Decisions made:** none new (no D-number). Rules added from the review: migration access rule (S-7), device TLS check (S-11, P03-02), named admin (S-4, P05-05), no people's names in room names (S-10, P05-06).
- **Which parts did I actually run, and what am I unsure about?** I ran every test, the mutation check, the advisor, all probes and the live checks listed above. I did not run: the live push and registration (owner ran them); an accepted upload on live (would put a fake reading in the history; P03-02 proves it); the scheduled cron run itself (first fires 18:30 UTC; only the function was run directly); anything on the device. Unsure: whether the Supabase CLI uses TLS for direct connections (moot once S-5 is on); whether device traffic keeps the free project awake (P07).
- **Handoff:** owner dashboard actions S-4, S-5, S-6 (both projects), then read them back. Next work: P03-D1 OLED canvas or P04-D4 template screenshots.
- **Recommended model for the next session:** Sonnet 5.5 (OLED design canvas and UI work, no security-sensitive changes). Switch to Opus 5.5 for P03-02 key handling and the setup page.

## Phase Progress
**At session start:**
```
| Phase | Done / Total | Progress | % |
|---|---|---|---|
| P00 Kickoff and decisions | 13 / 13 | ██████████ | 100% |
| P01 Heat index core and bench bring-up | 7 / 7 | ██████████ | 100% |
| P02 Backend and secure upload | 4 / 7 (+1 partly) | ██████░░░░ | 57% |
| P03 Device firmware | 0 / 10 | ░░░░░░░░░░ | 0% |
| P04 Web app core | 3 / 13 | ██░░░░░░░░ | 23% |
| P05 Admin, alerts and device health | 0 / 6 | ░░░░░░░░░░ | 0% |
| P06 Display and sharing extras | 0 / 5 | ░░░░░░░░░░ | 0% |
| P07 Field trial and hardening | 0 / 7 | ░░░░░░░░░░ | 0% |
| P08 Over-the-air updates (optional) | 0 / 3 | ░░░░░░░░░░ | 0% |
| **Whole project** | 27 / 71 | ████░░░░░░ | **38%** |
```
**At session end:**
```
| Phase | Done / Total | Progress | % |
|---|---|---|---|
| P00 Kickoff and decisions | 13 / 13 | ██████████ | 100% |
| P01 Heat index core and bench bring-up | 7 / 7 | ██████████ | 100% |
| P02 Backend and secure upload | 7 / 7 | ██████████ | 100% |
| P03 Device firmware | 0 / 10 | ░░░░░░░░░░ | 0% |
| P04 Web app core | 3 / 13 | ██░░░░░░░░ | 23% |
| P05 Admin, alerts and device health | 0 / 6 | ░░░░░░░░░░ | 0% |
| P06 Display and sharing extras | 0 / 5 | ░░░░░░░░░░ | 0% |
| P07 Field trial and hardening | 0 / 7 | ░░░░░░░░░░ | 0% |
| P08 Over-the-air updates (optional) | 0 / 3 | ░░░░░░░░░░ | 0% |
| **Whole project** | 30 / 71 | ████░░░░░░ | **42%** |
```
