CodenameTempest14/init-heat-monitoring/documentation/phase-reports/phase-02-backend/sessions/2026-10-31_s07_CLOSE.md

# Phase 02 — Session s07 — CLOSE — 2026-10-31

[P02 · Backend and secure upload · 4/7 done · 0 blocked · unverified 0]

- **Status:** P02 at 4 of 7 (P02-01 to P02-04 done, P02-07 partly done).
- **Planned vs done:** planned P02-01 only. Done: P02-01, P02-02, P02-03, P02-04; P02-07 partly. Added at the owner's request: OLED canvas placement (D-022), server-side heat index with hourly maxima (D-023), new feature F-21 room assignment (D-024).
- **Files changed:** `documentation/specs/SCHEMA.md` (new), `FEATURES.md` (OLED note, F-21), `DECISIONS.md` (D-022 to D-024), phase checklists P02, P03 (OLED canvas items, deep-sleep wording fixed to match D-018), P04, P05; `supabase/` (config, 4 migrations, READMEs); `tests/backend/` (access, ingest, SQL heat index, helpers); `tools/db.mjs`, `tools/device-key.mjs`; `.env.example`, `.gitignore`, `package.json` (+ lock, Supabase CLI 2.121.0 pinned), `THIRD_PARTY_NOTICES.md`; reports, state, log, continuation prompt.
- **Build, tests and checks run:** `npm run test:backend` against `init-test`: red first each time (8 fail for P02-02, 4 for F-21, 30 for P02-04, each for the expected "missing" reason), then 41/41 pass, twice. `npm test` 14/14. Mutation check: a wrong chart value in the reference table made the SQL heat index test fail (file restored). Supabase security advisor: 0 findings, then 2 warnings after `ingest_reading`, reduced to 1 accepted. `.env` connection checks (all keys valid, wrong key refused). `git grep` for the device key over the committed tree: not found (control search for its hash: found).
- **Unverified changes:** 0.
- **Commits and push:** 8 commits plus this close commit; owner approved pushing to `codenametempest14` and `main` (named both).
- **Problems and diagnosis:**
  - `.env` URLs had quotes, a space and `/rest/v1/` appended: rewritten to the base URL.
  - My quote clean-up broke the test DB password: it contains `#`, which starts a comment when unquoted. Re-quoted with single quotes; `.env.example` now says so.
  - The Supabase access token is read-only (writes refused with 25006, also via `--linked`). Kept that way; writes go through the DB password on the session pooler instead.
  - My first "key not in repo" check was broken (`git grep` argument order) and printed "not found" regardless. Caught, not counted, redone correctly with a control.
  - `process.exit()` right after `fetch` tripped a libuv assert on Windows: use `process.exitCode`.
- **Decisions made:** D-022 OLED canvas at the start of P03; D-023 server-side heat index, hourly maxima with time; D-024 F-21 room saved per reading.
- **Which parts did I actually run, and what am I unsure about?** I ran every migration (test project only), every test, the advisor, the mutation check and the `.env` checks. Not run: anything on the live `init` project (empty), anything on the device, `pg_cron`. Unsure: whether device traffic keeps the free project from pausing (P07); whether the 0–60 °C and 30 s limits suit the real classroom (owner approved them as guesses); the CLI's `db query --db-url` path is used only by `device-key.mjs register` and was run on the test project only.
- **Handoff:** P02-05 (retention job, finishes P02-07), P02-06 (security review), then ask before migrating the live project.
- **Recommended model for the next session:** Opus 5.5 (retention job, security review, first live migration).

## Phase Progress
**At session start:**
```
| Phase | Done / Total | Progress | % |
|---|---|---|---|
| P00 Kickoff and decisions | 13 / 13 | ██████████ | 100% |
| P01 Heat index core and bench bring-up | 7 / 7 | ██████████ | 100% |
| P02 Backend and secure upload | 0 / 6 | ░░░░░░░░░░ | 0% |
| P03 Device firmware | 0 / 7 | ░░░░░░░░░░ | 0% |
| P04 Web app core | 3 / 13 | ██░░░░░░░░ | 23% |
| P05 Admin, alerts and device health | 0 / 5 | ░░░░░░░░░░ | 0% |
| P06 Display and sharing extras | 0 / 5 | ░░░░░░░░░░ | 0% |
| P07 Field trial and hardening | 0 / 7 | ░░░░░░░░░░ | 0% |
| P08 Over-the-air updates (optional) | 0 / 3 | ░░░░░░░░░░ | 0% |
| **Whole project** | 23 / 66 | ████░░░░░░ | **35%** |
```
**At session end:**
```
| Phase | Done / Total | Progress | % |
|---|---|---|---|
| P00 Kickoff and decisions | 13 / 13 | ██████████ | 100% |
| P01 Heat index core and bench bring-up | 7 / 7 | ██████████ | 100% |
| P02 Backend and secure upload | 4 / 7 (+1 partly) | ██████░░░░ | 57% |
| P03 Device firmware | 0 / 10 | ░░░░░░░░░░ | 0% |
| P04 Web app core | 3 / 13 | ██░░░░░░░░ | 23% |
| P05 Admin, alerts and device health | 0 / 6 | ░░░░░░░░░░ | 0% |
| P06 Display and sharing extras | 0 / 5 | ░░░░░░░░░░ | 0% |
| P07 Field trial and hardening | 0 / 7 | ░░░░░░░░░░ | 0% |
| P08 Over-the-air updates (optional) | 0 / 3 | ░░░░░░░░░░ | 0% |
| **Whole project** | 27 / 71 | ████░░░░░░ | **38%** |
```
(Totals grew from 66 to 71: OLED canvas P03-D1 to D3, and F-21's P02-07 and P05-06.)
