CodenameTempest14/init-heat-monitoring/documentation/phase-reports/phase-02-backend/sessions/2026-10-31_s07_START.md

# Phase 02 — Session s07 — START — 2026-10-31

[P01 · Heat index core and bench bring-up · 7/7 done · 0 blocked · unverified 0]

- **Recommended model for this session:** Opus 5.5, because P02-01 is the schema, row-level rules and device-key design (security). Owner started on Sonnet 5.5 and switched to Opus 5.5 after the first reply.
- **Phase builder (asked the owner):** owner only (answered s07). D-014 `main` exception stays in force.
- **Session goal:** P02-01 (schema proposal, owner approval before anything is built). Placement of the OLED design canvas (owner approved: start of P03, D-022).
- **Starting state:** branch `codenametempest14`, commit `e779411` (1 ahead of origin, the s06 close commit). Previous: [s06 close](../../phase-01-core-and-bench/sessions/2026-10-31_s06_CLOSE.md).
- **Context loaded:** CLAUDE.md, CURRENT_STATE.md, phase-02-backend.md, s06 CLOSE; then FEATURES.md, phase-03-firmware.md, phase-04-web-app.md, DECISIONS.md (D-016, D-018), design/README.md, the Ad Astra design/README.md.
- **Context deliberately not loaded:** firmware sources, schematic, heat index code (not changing).
- **Planned steps:** record the OLED placement (D-022, P03-D1 to D3); write the P02-01 schema proposal in `documentation/specs/SCHEMA.md`; wait for approval.
- **Distinguishing signal for each check:** P02-01 is done only when the owner says the schema is approved. Nothing is built on Supabase before that.
- **Open questions for the owner:** Supabase account and project; Docker for a local test database (see the schema proposal).
- **Risks:** settling the device-key design wrongly; free-tier project pausing.

## Phase Progress at session start (HARD RULE 1)
```
| Phase | Done / Total | Progress | % |
|---|---|---|---|
| P00 Kickoff and decisions | 13 / 13 | ██████████ | 100% |
| P01 Heat index core and bench bring-up | 7 / 7 | ██████████ | 100% |
| P02 Backend and secure upload | 0 / 6 | ░░░░░░░░░░ | 0% |
| P03 Device firmware | 0 / 7 | ░░░░░░░░░░ | 0% |
| P04 Web app core | 3 / 13 | ██░░░░░░░░ | 23% |
| P05 Admin, alerts and device health | 0 / 5 | ░░░░░░░░░░ | 0% |
| P06 Display and sharing extras | 0 / 5 | ░░░░░░░░░░ | 0% |
| P07 Field trial and hardening | 0 / 7 | ░░░░░░░░░░ | 0% |
| P08 Over-the-air updates (optional) | 0 / 3 | ░░░░░░░░░░ | 0% |
| **Whole project** | 23 / 66 | ████░░░░░░ | **35%** |
```

## Checkpoints
- s07 — OLED canvas placed at the start of P03 (D-022): P03 grows from 7 to 10 items, so the whole project is now 23 / 69 (33 %). P03 objective and P03-03 reworded to match D-018 (they still said "sleeps"). Next: schema proposal.
