CodenameTempest14/init-heat-monitoring/documentation/phase-reports/phase-01-core-and-bench/sessions/2026-10-31_s06_CLOSE.md

# Phase 01 — Session s06 — CLOSE — 2026-10-31

[P01 · Heat index core and bench bring-up · 7/7 done · 0 blocked · unverified 0]

- **Status:** P01 complete (7 of 7 counted items; P01-07 ruled out by the owner, D-021).
- **Planned vs done:** all four bench items were planned. P01-05 and P01-06 done and run on the real board. P01-04 done after a redesign (D-018). P01-07 ruled out.
- **Files changed:** `documentation/DECISIONS.md` (D-017 to D-021), `documentation/specs/FEATURES.md` (F-01 reworded), `documentation/phases/phase-01-core-and-bench.md`, `hardware/schematic.html` (38-pin, new DHT22 breadboard diagram, wire list wording), `hardware/README.md`, `firmware/bench/` (`platformio.ini`, `src/main.cpp`, `README.md`), `.vscode/` (tasks and README), the s06 reports, state file, progress log and continuation prompt.
- **Build, tests and bench checks run:** `pio run` compiled every version of the bench sketch (SUCCESS). Uploaded to the 38-pin board on COM8; serial read showed `T=31.9 C  RH=57.3 %`; the OLED showed readings (owner). 61 min on the ROMOSS bank with the Wi-Fi scan sketch (owner read `up 61 min`). `node --test` was not re-run this session: no heat index code changed.
- **Unverified changes:** 0.
- **Commits and push:** pushed to `codenametempest14` and to `main` (owner approved both, naming each), head `0c4a1ca`. The close commit is not pushed yet; ask first.
- **Problems and diagnosis:**
  - Upload failed first with "Wrong boot mode" (BOOT/EN needed), then "Invalid head of packet": fixed by `upload_speed = 115200`.
  - The bank switched off about 1 min after boot. I first blamed deep sleep; that was wrong. The no-sleep sketch without Wi-Fi also died at about 1 min, so the bank needs about Wi-Fi-level load. The Wi-Fi scan sketch ran 61 min. D-018 (no deep sleep) stands, with this as its evidence.
  - A first 3V3 reading of 3.723 V was a misread; the owner re-measured 3.273 V.
  - The rendering check of the new diagram used headless Edge (Playwright is not installed).
- **Decisions made:** D-017 38-pin board with Type-C; D-018 no deep sleep; D-019 PAGASA bands on rounded heat index; D-020 NWS range rule wins over the F-01 "40 % RH" wording; D-021 P01-07 ruled out.
- **Which parts did I actually run, and what am I unsure about?** I ran the builds, the upload, a serial read and the tracker tool. The one-hour bank test and the 3V3 readings were done and reported by the owner, not by me. Unsure: whether the bank stays on in the real firmware's idle gaps between Wi-Fi sends (P03), and the real awake current and runtime (the schematic figures are estimates; to be measured in P07).
- **Design canvas status (owner asked):** web app partly canvassed (pages, Tabler templates, tokens; templates still "Proposed", P04-D4 and D5 open). No design for the OLED screens exists. The owner asked (s06) for one made with the same Ad Astra canvas method as D-016; not started, to be placed in a phase (suggest P03) and approved in FEATURES.md.
- **Handoff:** start P02 (Supabase backend, secure upload). Read `documentation/phases/phase-02-backend.md`.
- **Recommended model for the next session:** Opus 5.5 (schema, row-level rules, device-key security).

## Phase Progress
**At session start:**
```
| Phase | Done / Total | Progress | % |
|---|---|---|---|
| P00 Kickoff and decisions | 13 / 13 | ██████████ | 100% |
| P01 Heat index core and bench bring-up | 4 / 8 | █████░░░░░ | 50% |
| P02 Backend and secure upload | 0 / 6 | ░░░░░░░░░░ | 0% |
| P03 Device firmware | 0 / 7 | ░░░░░░░░░░ | 0% |
| P04 Web app core | 3 / 13 | ██░░░░░░░░ | 23% |
| P05 Admin, alerts and device health | 0 / 5 | ░░░░░░░░░░ | 0% |
| P06 Display and sharing extras | 0 / 5 | ░░░░░░░░░░ | 0% |
| P07 Field trial and hardening | 0 / 7 | ░░░░░░░░░░ | 0% |
| P08 Over-the-air updates (optional) | 0 / 3 | ░░░░░░░░░░ | 0% |
| **Whole project** | 20 / 67 | ███░░░░░░░ | **30%** |
```
**At session end:**
```
| Phase | Done / Total | Progress | % |
|---|---|---|---|
| P00 Kickoff and decisions | 13 / 13 | ██████████ | 100% |
| P01 Heat index core and bench bring-up | 7 / 7 | ██████████ | 100% |
| P02 Backend and secure upload | 0 / 6 | ░░░░░░░░░░ | 0% |
| P03 Device firmware | 0 / 7 | ░░░░░░░░░░ | 0% |
| P04 Web app core | 3 / 13 | ██░░░░░░░░ | 23% |
| P05 Admin, alerts and device health | 0 / 5 | ░░░░░░░░░░ | 0% |
| P06 Display and sharing extras | 0 / 5 | ░░░░░░░░░░ | 0% |
| P07 Field trial and hardening | 0 / 7 | ░░░░░░░░░░ | 0% |
| P08 Over-the-air updates (optional) | 0 / 3 | ░░░░░░░░░░ | 0% |
| **Whole project** | 23 / 66 | ████░░░░░░ | **35%** |
```
(The whole-project total fell from 67 to 66 because the ruled-out P01-07 no longer counts.)
