CodenameTempest14/init-heat-monitoring/documentation/phase-reports/phase-01-core-and-bench/sessions/2026-10-31_s05_CLOSE.md

# Phase 01 — Session s05 — CLOSE — 2026-10-31

[P01 · Heat index core and bench bring-up · 4/8 done · 0 blocked · unverified 0]

- **Status:** Paused by the owner at the start of the bench work. No code or checklist change; this was a planning and guidance session.
- **Planned vs done:** Start Report written; phase-builder question answered (owner only); breadboard walkthrough for P01-05 given from the Rev B wire list. Nothing built or measured yet, so no item ticked.
- **Files changed:** this close report, the s05 start report, `CURRENT_STATE.md`, `PROGRESS_LOG.md`, the regenerated `NEXT_SESSION_PROMPT.md`.
- **Build, tests and bench checks run:** none this session.
- **Unverified changes:** 0.
- **Commits:** one close commit (see `git log`). Pushed: no.
- **Problems and diagnosis:** the owner has a multimeter only, no USB power meter. P01-07 (sleep and awake currents) needs a series current measurement. Options for the owner: buy a USB inline meter (recommended), or splice a cable and use the meter's mA range. Decision deferred until the sketch runs.
- **Decisions made / awaiting owner:** none new. Still awaiting: PAGASA rounding rule; F-01 "40 % RH" wording; how to measure current for P01-07.
- **Which parts did I actually run, and what am I unsure about?** I ran `node tools/phase-report.mjs` and read the state, the phase file, the last close report, the bench sketch and the Rev B wire list. I ran nothing on hardware. Unsure: whether the owner's board pin labels match GPIO4/21/22 as drawn, and whether the ROMOSS 8P+ keeps the load alive at deep-sleep current (the P01-04 test answers this).
- **Handoff:** the walkthrough to follow: ESP32 3V3 and GND to rails; measure 3V3 on USB (expect 3.2 to 3.4 V); DHT22 pin 1 to 3V3, pin 4 to GND, pin 2 to GPIO4 with 10 kΩ pull-up to 3V3 and 100 nF across pins 1 and 4; OLED GND, VCC (3V3), SCL to GPIO22, SDA to GPIO21; skip the wake button. Then `pio run -t upload` and `pio device monitor` in `firmware/bench`.
- **Next session's first concrete step:** owner builds the breadboard and reports the 3V3 reading (P01-05); then P01-06; then P01-04 (one hour on the power bank).
- **Recommended model for the next session:** Sonnet 5.5; Opus 5.5 when P02 starts.

## Phase Progress
**At session start and end (unchanged):**
```
| Phase | Done / Total | Progress | % |
|---|---|---|---|
| P00 Kickoff and decisions | 13 / 13 | ██████████ | 100% |
| P01 Heat index core and bench bring-up | 4 / 8 | █████░░░░░ | 50% |
| P02 Backend and secure upload | 0 / 6 | ░░░░░░░░░░ | 0% |
| P03 Device firmware | 0 / 7 | ░░░░░░░░░░ | 0% |
| P04 Web app core | 3 / 13 | ██░░░░░░░░ | 23% |
| P05 Admin, alerts and device health | 0 / 5 | ░░░░░░░░░░ | 0% |
| P06 Display and sharing extras | 0 / 5 | ░░░░░░░░░░ | 0% |
| P07 Field trial and hardening | 0 / 7 | ░░░░░░░░░░ | 0% |
| P08 Over-the-air updates (optional) | 0 / 3 | ░░░░░░░░░░ | 0% |
| **Whole project** | 20 / 67 | ███░░░░░░░ | **30%** |
```

## Continuation prompt
Generated by `node tools/continuation-prompt.mjs`; full text in `documentation/context/NEXT_SESSION_PROMPT.md`. Pushed: no.
