CodenameTempest14/init-heat-monitoring/documentation/phase-reports/phase-01-core-and-bench/sessions/2026-10-31_s05_START.md

# Phase 01 — Session s05 — START — 2026-10-31

[P01 · Heat index core and bench bring-up · 4/8 done · 0 blocked · unverified 0]

- **Model:** Sonnet 5.5 (bench guidance and recording results). Opus 5.5 when P02 starts.
- **Phase builder:** owner only (answered 2026-10-31).
- **Plan:** P01-05 (breadboard, 3V3 measurement), then P01-06 (upload `firmware/bench`, read the OLED), then P01-04 (one-hour power bank test) and P01-07 (currents).
- **Equipment:** owner has a multimeter only, no USB power meter. P01-07 needs current measured in series with the 5 V supply; method to be agreed before that step.
- **Waiting on owner:** PAGASA rounding rule; F-01 "40 % RH" wording.

## Phase Progress (at start)
```
| Phase | Done / Total | Progress | % |
|---|---|---|---|
| P00 Kickoff and decisions | 13 / 13 | ██████████ | 100% |
| P01 Heat index core and bench bring-up | 4 / 8 | █████░░░░░ | 50% |
| P02 Backend and secure upload | 0 / 6 | ░░░░░░░░░░ | 0% |
| P03 Device firmware | 0 / 7 | ░░░░░░░░░░ | 0% |
| P04 Web app core | 3 / 13 | ██░░░░░░░░ | 23% |
| P05 Admin, alerts and device health | 0 / 5 | ░░░░░░░░░░ | 0% |
| P06 Display and sharing extras | 0 / 5 | ░░░░░░░░░░ | 0% |
| P07 Field trial and hardening | 0 / 7 | ░░░░░░░░░░ | 0% |
| P08 Over-the-air updates (optional) | 0 / 3 | ░░░░░░░░░░ | 0% |
| **Whole project** | 20 / 67 | ███░░░░░░░ | **30%** |
```
