CodenameTempest14/init-heat-monitoring/documentation/phase-reports/phase-01-core-and-bench/sessions/2026-10-31_s04_CLOSE.md

# Phase 01 — Session s04 — CLOSE — 2026-10-31

[P01 · Heat index core and bench bring-up · 4/8 done · 0 blocked · unverified 0]

- **Status:** Partially completed as planned. The software side is done; the bench items wait for the owner (next day).
- **Planned vs done:** P01-01, P01-02, P01-03 and P01-08 ticked with evidence. P04-D1, D2 and D3 (design canvas, D-016) ticked with evidence. P01-04 to P01-07 not started (owner does the bench work next day). The bench sketch is written and compiled but not run, so no bench item is ticked.
- **Files changed:** `src/heat-index.js`, `tests/` (heat index, reference JSON, contrast), `package.json`, `design/` (pages, tokens, registry script, contrast script), `firmware/bench/` (PlatformIO project and sketch), `THIRD_PARTY_NOTICES.md`, `documentation/DECISIONS.md` (D-015, D-016), phase 01 and 04 checklists, `PHASE_PLAN.md` note, state file, progress log, these reports.
- **Build, tests and bench checks run:** `node --test` 14/14 pass (watched red first for the heat index, the categories and the contrast code). `node design/contrast.mjs` passes after fixing one real failure. `pio run` in `firmware/bench`: SUCCESS, no warnings after fixing two format warnings. Not run: anything on the board, any browser, any template page.
- **Unverified changes:** 0 counted. In fact the bench sketch is compiled only (pins, I2C address and DHT timing are untested on hardware).
- **Commits:** f6102ca, 7625239, c75311d, e874eb0, 32bec43, c6fa0f4, 125155c, plus a final commit for this close (see `git log`). Pushed: no.
- **Problems and diagnosis:**
  1. My remembered NWS chart value for 90 °F / 70 % (106) was wrong; the chart says 105. Found by reading the chart image, fixed in the reference JSON.
  2. The chart cell 80 °F / 40 % prints 80, but the NWS switch rule gives 79.8 °F, so the function returns null there. Documented and tested.
  3. White text on the orange danger fill was 3.58:1. Darkened the fill to 5.18:1.
  4. PAGASA bands have whole-degree gaps, so values are rounded before classifying (my choice, flagged).
- **Decisions made / awaiting owner:** D-015 (heat index option A) and D-016 (design canvas option 1, placed in P04 as P04-D1 to D5 by the agent). Visual direction chosen by the agent, as the owner delegated: light-first, high contrast, dark mode, Tabler (MIT) templates. Awaiting owner: the rounding rule for PAGASA bands, and whether F-01's "40 % RH" wording should become an explicit floor (the code follows the NWS rule instead).
- **Which parts did I actually run, and what am I unsure about?** I ran the node tests, the contrast script, the registry script, the PlatformIO compile and read-only web checks (NWS and PAGASA images read by eye, GitHub licence files). I did not run the sketch on the board or look at any template page. Unsure: the two adjustment rows in the reference JSON are hand-computed from the NWS formulas; the "52 and above" reading of PAGASA's top band comes from the chart colours, not an explicit symbol; the SSD1306 and GFX licences are BSD but GitHub does not state the exact variant; the heat colours are checked by number only, not seen on a screen.
- **Handoff:** `src/heat-index.js` (`heatIndexC`, `heatCategory`) is done and tested. The shared reference table is `tests/heat-index-reference.json`; the C++ port in P03 must pass it. The bench sketch is in `firmware/bench` (DHT GPIO4, OLED GPIO21/22 at 0x3C, 60 s awake then 60 s deep sleep) and compiles. The design canvas has `pages.json`, `tokens.json` (contrast-checked) and a registry; D4 (Playwright screenshots) and D5 (UI-GATE) remain. Nothing pushed.
- **Next session's first concrete step:** the owner does the bench: P01-04 (power bank low-load test), P01-05 (build and measure 3V3), P01-06 (upload `firmware/bench`, watch the OLED), P01-07 (USB meter currents). The agent explains each step and records the results.
- **Recommended model for the next session:** Sonnet 5.5 — bench guidance and recording results; switch to Opus 5.5 when P02 starts.

## Phase Progress
**At session start:**
```
| Phase | Done / Total | Progress | % |
|---|---|---|---|
| P00 Kickoff and decisions | 13 / 13 | ██████████ | 100% |
| P01 Heat index core and bench bring-up | 0 / 8 | ░░░░░░░░░░ | 0% |
| **Whole project** | 13 / 62 | ██░░░░░░░░ | **21%** |
```
(P02 to P08 were all 0 %.)

**At session end:**
```
| Phase | Done / Total | Progress | % |
|---|---|---|---|
| P00 Kickoff and decisions | 13 / 13 | ██████████ | 100% |
| P01 Heat index core and bench bring-up | 4 / 8 | █████░░░░░ | 50% |
| P02 Backend and secure upload | 0 / 6 | ░░░░░░░░░░ | 0% |
| P03 Device firmware | 0 / 7 | ░░░░░░░░░░ | 0% |
| P04 Web app core | 3 / 13 | ██░░░░░░░░ | 23% |
| P05 Admin, alerts and device health | 0 / 5 | ░░░░░░░░░░ | 0% |
| P06 Display and sharing extras | 0 / 5 | ░░░░░░░░░░ | 0% |
| P07 Field trial and hardening | 0 / 7 | ░░░░░░░░░░ | 0% |
| P08 Over-the-air updates (optional) | 0 / 3 | ░░░░░░░░░░ | 0% |
| **Whole project** | 20 / 67 | ███░░░░░░░ | **30%** |
```
(The total rose from 62 to 67 because the design canvas added 5 items to P04.)

## Continuation prompt
Generated by `node tools/continuation-prompt.mjs`; full text in `documentation/context/NEXT_SESSION_PROMPT.md`. Pushed: no.
