CodenameTempest14/init-heat-monitoring/documentation/phase-reports/phase-01-core-and-bench/sessions/2026-10-31_s04_START.md

# Phase 01 — Session s04 — START — 2026-10-31

[P00 · Kickoff and decisions · 13/13 done · 0 blocked · unverified 0]

- **Recommended model:** Sonnet 5.5 — test-first function plus bench prep. Owner on: Sonnet 5.5 (fine).
- **Phase builder:** owner only (answered 2026-10-31).
- **Session goal:** P01-01 to P01-03 and P01-08 (software side). Bench items P01-04 to P01-07 postponed to the next day by the owner (parts in hand).
- **Starting state:** branch `codenametempest14`, commit `006289f`, previous report [s03 close](../../phase-00-kickoff/sessions/2026-10-31_s03_CLOSE.md).
- **Context loaded:** CLAUDE.md, CURRENT_STATE.md, phase-01 checklist, s03 close report, FEATURES.md, PHASE_PLAN.md, DECISIONS.md (D-002 line), hardware README and wire list; Ad Astra `design/` for the canvas technique.
- **Open questions answered during the session:** heat index code option A (D-015); design canvas option 1 (D-016).

## Phase Progress at session start
```
| Phase | Done / Total | Progress | % |
|---|---|---|---|
| P00 Kickoff and decisions | 13 / 13 | ██████████ | 100% |
| P01 Heat index core and bench bring-up | 0 / 8 | ░░░░░░░░░░ | 0% |
| **Whole project** | 13 / 62 | ██░░░░░░░░ | **21%** |
```
(P02 to P08 rows were all 0 %.)
