CodenameTempest14/init-heat-monitoring/documentation/phase-reports/phase-00-kickoff/sessions/2026-10-31_s03_CLOSE.md

# Phase 00 — Session s03 — CLOSE — 2026-10-31

[P00 · Kickoff and decisions · 13/13 done · 0 blocked · unverified 0]

- **Status:** Completed. P00 is closed.
- **Planned vs done:** P00-10 (hardware confirmed), P00-11 (features approved), P00-12 (phase plan approved) ticked with evidence in the phase file. P00-09 updated for Rev B. Checklists P01–P08 created.
- **Files changed:** `hardware/schematic.html` (Rev B), `hardware/README.md`, `README.md`, `documentation/DECISIONS.md` (D-008…D-013), `documentation/specs/FEATURES.md` and `PHASE_PLAN.md` (new), `documentation/phases/phase-00…08`, `.githooks/*` and `.gitattributes` (new), `tools/continuation-prompt.mjs` (wording), state, log and these reports.
- **Build, tests and bench checks run:** Rev B schematic rendered in headless Edge and viewed, twice (the second after fixing two label overlaps). `pre-push` hook run three ways: push to `main` blocked, branch deletion blocked, push to own branch allowed. `phase-report.mjs` and `check-readmes.mjs` run after the checklist changes. Not run: force-push against the hook; anything on real hardware.
- **Unverified changes:** 0 counted by the tracker. In fact the schematic Rev B is a drawing only: no part was built, powered or measured.
- **Commits:** `735072f` Rev B, features and hook · `1fe36dc` LF for hooks · `63a2f33` open-source reading and phase plan · a final commit for this close (see `git log`). Pushed: no.
- **Problems and diagnosis:** Rev A had two label overlaps I had never rendered (found and fixed). The pasted continuation prompt claimed there was no git repo; the repo already existed (docs were stale, fixed).
- **Decisions made / awaiting owner:** D-008 to D-013 made. Nothing awaiting.
- **Which parts did I actually run, and what am I unsure about?** I ran the render, the hook tests and the two tracker scripts. I did not build or measure anything. Unsure: whether the ROMOSS Sense 8P+ stays on at about 10 mA (web search found a low-current mode only for the related Sense8ps Pro); the runtime figures (about 8 weeks, about 8 days without sleep) are my estimates; the 30-pin pin positions on the real board were not seen, only the GPIO numbers.
- **Handoff:** P00 done. Hardware is Rev B: 30-pin ESP32 (Type-C), DHT22, SSD1306 128×64 (GND, VCC, SCK, SDA), ROMOSS bank via USB-A to Type-C. Features F-01…F-20 approved if open source (code and libraries; hosting may be a closed free service). Wi-Fi setup is a device page, no password in the database. Phases P01–P08 approved; P01 is next and starts with the heat index tests.
- **Next session's first concrete step:** ask the phase-builder question, then write the heat index tests first and watch them fail (P01-01).
- **Recommended model for the next session:** Sonnet 5.5 — test-first function plus bench work; switch to Opus 5.5 when P02 (backend security) starts.

## Phase Progress
**At session start:**
```
| Phase | Done / Total | Progress | % |
|---|---|---|---|
| P00 Kickoff and decisions | 10 / 13 | ████████░░ | 77% |
| **Whole project** | 10 / 13 | ████████░░ | **77%** |
```
**At session end:**
```
| Phase | Done / Total | Progress | % |
|---|---|---|---|
| P00 Kickoff and decisions | 13 / 13 | ██████████ | 100% |
| P01 Heat index core and bench bring-up | 0 / 8 | ░░░░░░░░░░ | 0% |
| P02 Backend and secure upload | 0 / 6 | ░░░░░░░░░░ | 0% |
| P03 Device firmware | 0 / 7 | ░░░░░░░░░░ | 0% |
| P04 Web app core | 0 / 8 | ░░░░░░░░░░ | 0% |
| P05 Admin, alerts and device health | 0 / 5 | ░░░░░░░░░░ | 0% |
| P06 Display and sharing extras | 0 / 5 | ░░░░░░░░░░ | 0% |
| P07 Field trial and hardening | 0 / 7 | ░░░░░░░░░░ | 0% |
| P08 Over-the-air updates (optional) | 0 / 3 | ░░░░░░░░░░ | 0% |
| **Whole project** | 13 / 62 | ██░░░░░░░░ | **21%** |
```
(The whole-project percentage fell from 77 % to 21 % only because the approved plan added 49 checklist items.)

## Continuation prompt
Generated by `node tools/continuation-prompt.mjs`; full text in `documentation/context/NEXT_SESSION_PROMPT.md`. Pushed: no.
