CodenameTempest14/init-heat-monitoring/documentation/phase-reports/phase-00-kickoff/sessions/2026-10-31_s03_START.md

# Phase 00 — Session s03 — START — 2026-10-31

[P00 · Kickoff and decisions · 10/13 done · 0 blocked · unverified 0]

(Delivered in chat at the start of the session; saved to this file at close.)

- **Recommended model for this session:** Sonnet 5.5 — writing the feature list and phase plan for approval. Owner is on: Sonnet 5.5 (fine).
- **Phase builder:** owner only (recorded in CURRENT_STATE from earlier; the question was asked again, the owner did not change it).
- **Session goal:** P00-10, P00-11, P00-12.
- **Starting state:** branch `codenametempest14`, commit `8c17849`, previous report [s02 close](2026-10-30_s02_CLOSE.md). The pasted continuation prompt said "no git repo"; the repo already existed (the repo wins; prompt fixed at close).
- **Context loaded:** CLAUDE.md, CURRENT_STATE.md, phase-00 checklist, s02 Close Report, DECISIONS.md, hardware README and schematic.
- **Open questions for the owner:** Rev A review answers, whether to start FEATURES.md, whether to add the pre-push hook.
- **Risks:** hardware design unmeasured; the owner's power change could invalidate Rev A.

## Phase Progress at session start
```
| Phase | Done / Total | Progress | % |
|---|---|---|---|
| P00 Kickoff and decisions | 10 / 13 | ████████░░ | 77% |
| **Whole project** | 10 / 13 | ████████░░ | **77%** |
```
