CodenameTempest14/init-heat-monitoring/documentation/phase-reports/phase-00-kickoff/sessions/2026-10-30_s02_START.md

# Phase 00 — Session s02 — START — 2026-10-30

[P00 · Kickoff and decisions · 0/0 done · 0 blocked · unverified 0] (no phase files existed at session start)

- **Recommended model for this session:** Sonnet 5.5 — planning and process setup, no firmware or architecture. Owner is on: Sonnet 5.5 (fine).
- **Phase builder:** owner only (answered 2026-10-30)
- **Session goal:** record the owner's answers, set up the phase tracker and templates (no feature work), pick a brand name.
- **Starting state:** not a git repo; previous session s01 had no formal report (tracker did not exist).
- **Context loaded:** CLAUDE.md, hardware/schematic.html (both written in s01), Ad Astra tools and templates for adaptation.
- **Context deliberately not loaded:** the rest of Ad Astra's docs.
- **Planned steps:** write tools, Phase 0 checklist, state files, templates; run them; write Close Report and continuation prompt.
- **Distinguishing signal:** `phase-report.mjs` prints a table with counts matching the checklist; `check-readmes.mjs` passes.
- **Open questions for the owner:** see CURRENT_STATE "Waiting on the owner".
- **Risks:** unmarked 18650 cells; schematic Rev A not reviewed.

## Phase Progress at session start
No phases existed yet (0 / 0).
