CodenameTempest14/init-heat-monitoring/documentation/DECISIONS.md

# Decisions

One line of context per decision, with who decided and when. Newest at the bottom.

| ID | Decision | Decided by / date | Why / notes |
|---|---|---|---|
| D-001 | Hardware: ESP32 38-pin, DHT22, 0.96″ SSD1306 OLED, 2 × 18650 in series, 5 V buck converter | Owner, 2026-10-30 | Owner's parts. Rev A schematic in `hardware/schematic.html`. |
| D-002 | Stack Option A: Arduino-framework firmware (PlatformIO), HTTPS to Supabase, free static hosting (Cloudflare Pages or Vercel), PWA front end | Owner, 2026-10-30 | Fastest path, one codebase for desktop and phone, free tiers. |
| D-003 | Scope: one room, public read-only viewing, free hosting, battery only | Owner, 2026-10-30 | Admin edits settings (including Wi-Fi) from the web app. |
| D-004 | Internet: pocket 4G router or phone hotspot; ESP32 is a Wi-Fi client | Owner, 2026-10-30 | Classroom has no Wi-Fi. Cellular module rejected for now. |
| D-005 | Cells: 18650, no markings | Owner, 2026-10-30 | Real capacity unknown; measure before trusting runtime numbers. |
| D-006 | Buck set to 5.20 V, D1 (1N5819) in series to the ESP32 5V/VIN pin; no on-board charger | Agent proposal in schematic Rev A, accepted with the schematic | D1 prevents back-feeding USB. Awaiting owner review (P00-10). |
| D-008 | Power: USB power bank into the ESP32 USB port. **Supersedes** D-001 (cells, buck), D-005 (unmarked 18650s) and D-006 (buck + D1). No BMS, fuse, switch, buck or battery divider. | Owner, 2026-10-30 | More portable, nothing to build on the power side, protection is inside the bank. Risks: the bank may auto-off at low load (test first); no battery-level readout (the app shows "offline" instead). Schematic Rev B. |
| D-009 | ESP32 board: 30-pin DevKit (ESP32-WROOM-32). OLED: 0.96″ SSD1306, 128×64 (listed as "128x63"). BMS: none needed (agent's call, owner delegated) | Owner / agent, 2026-10-30 | All used GPIOs (4, 21, 22, 33) exist on the 30-pin layout. The power bank has its own protection. OLED pin order still to be read off the module. |
| D-010 | Feature list F-01…F-20 approved in full, **conditional on being open source** | Owner, 2026-10-31 | Condition confirmed 2026-10-31 (owner chose option 1): code and libraries must be open source; hosting may be a free closed service. |
| D-011 | Wi-Fi setup: device keeps credentials in `secrets.h` and opens its own setup page when it can't connect; the app never stores a Wi-Fi password | Owner, 2026-10-31 | Option 1 in FEATURES.md. Amends D-003's "admin edits Wi-Fi from the web app". |
| D-012 | Confirmed hardware: ESP32 30-pin with Type-C port; OLED pin order GND, VCC, SCK (SCL), SDA; power bank ROMOSS Sense 8P+ 30 000 mAh (5 V 3 A / 9 V 2 A / 12 V 1.5 A out) | Owner, 2026-10-31 | Owner confirmed 2026-10-31 that the bank has a low-current mode (from its manual). Still test that it stays on at deep-sleep current before building (bring-up step 1). |
| D-013 | Phase plan P01–P08 approved as proposed in `documentation/specs/PHASE_PLAN.md` | Owner, 2026-10-31 | P08 (OTA updates) is optional. |
| D-014 | Owner may push `main` directly (and their own branch) while they are the only builder. **Amends** CLAUDE.md rules 3 and 4 (which said `main` only via reviewed PR). Still: ask before every push naming the target; no force-push, no deletion. Ends when anyone else works on the repo. | Owner, 2026-10-31 | The owner first chose the PR route, then switched. `main` did not exist on GitHub, so the first push creates it. The hook now lists both targets for the owner's email. |
| D-015 | Heat index code: option A. Formula in JavaScript (`src/heat-index.js`) tested test-first with `node --test` against a shared `tests/heat-index-reference.json`; the C++ port in P03 is tested against the same JSON. Input/output °C; returns `null` when below the NWS range | Owner, 2026-10-31 | One set of expected values for both languages; no dependencies. |
| D-016 | Design canvas: option 1, lightweight Ad Astra-style canvas (`design/` folder, manifest + registry, one open-source template per page, shared tokens, Playwright shots at phone and desktop widths, UI-GATE from P04). Not yet placed in the phase plan | Owner, 2026-10-31 | Scope change approved by owner. Where it sits (new P04 section or a short step before P04) is still to be agreed; nothing built yet. |
| D-007 | Brand name: **Init** (Tagalog for "heat"); wordmark `init.`; tagline "Know the heat before it hits the classroom." | Agent, at owner's request, 2026-10-30 | Trademark and domain not checked. Easy to change; owner may veto. |
| D-017 | Board changed to the **38-pin** ESP32 DevKit (slimmer body, fits the breadboard). **Supersedes** the 30-pin board in D-009 and D-012. Same GPIOs (4 DHT22, 21 SDA, 22 SCL, 33 button), so the Rev B wire list does not change. Power is still the board USB port from the power bank; the 5V pin is not used for any load | Owner, 2026-10-31 | The 5V pin is wired straight to the USB 5 V rail, so it is for power in/out, not a regulated supply for the DHT22 (5 V data would exceed the ESP32 3.3 V GPIO limit). Owner confirmed the new board has a Type-C port; the 5V pin question was dropped (USB port is the power input). |
| D-018 | **No deep sleep.** The device stays awake and reads, shows and (from P03) sends continuously. Deep sleep is dropped from the design for now | Owner approved, 2026-10-31 | Bench test P01-04: the ROMOSS Sense 8P+ stayed on about 57 s (the awake phase) and switched off when the board entered deep sleep, also in its low-current mode. No USB meter is available and the deadline is close, so the always-awake fallback (about 90 mA, roughly 8 days per charge, an estimate) is chosen. Deep sleep can return with a different power source. P01-07 (currents) is deferred until a meter is available. |
| D-019 | PAGASA categories are applied to the heat index **rounded to whole °C** (`heatCategory`) | Owner, 2026-10-31 | Confirms the agent's choice from P01-03. F-01 wording changed to the NWS range rule (D-020). |
| D-020 | The NWS range rule in the code wins over the old F-01 "40 % RH" wording; F-01 reworded to match. No separate humidity cutoff | Owner, 2026-10-31 | Option 1 of the agent's question. The rule is published and already covered by the tests. |
| D-021 | P01-07 (sleep and awake currents) is ruled out of P01. Awake current is to be measured in P07 once a USB meter is available; the schematic runtime figures stay labelled as estimates | Owner, 2026-10-31 | Follows D-018 (no deep sleep) and the lack of a meter before the deadline. |
| D-022 | OLED screen design canvas (owner's s06 request, Ad Astra method as in D-016) sits as a short design step **at the start of P03** (P03-D1 to D3), finished and approved before the OLED code in P03-04 | Owner, 2026-10-31 (s07) | Placement was the agent's suggestion, owner accepted. The three item texts are the agent's wording; the owner may change them. P03 objective and P03-03 reworded to match D-018 (no deep sleep): the old text still said "sleeps". |
| D-023 | The server stores the **heat index** per reading, computed in the database by a SQL port of `src/heat-index.js` tested against `tests/heat-index-reference.json` (extends D-015 to a third language). `readings_hourly` keeps the hourly max of heat index, temperature and humidity **with the exact time** of each max | Owner, 2026-10-31 (s07) | Owner asked to save the highest heat index and humidity with the time recorded; chose heat index and per-hour maxima. Supports F-12 (daily high) without a new feature; an all-time record page was not asked for. |
| D-024 | New feature **F-21 device room assignment** approved. The device has a `room`; the admin edits it (P05); the server copies the device's current room onto **each reading** at upload, so old readings keep the room they were taken in. Data part in P02 (P02-07), admin screen in P05 (P05-06), room on the public page in P04 (P04-02) | Owner, 2026-10-31 (s07) | Owner asked to edit which room the device is in. Of three options (room per reading / room list with move history / plain label) the owner chose room per reading. Still one device, one room at a time (D-003 unchanged). Device `name` (which device) and `room` (where it is) are now separate. |
| D-025 | OLED stays **on all the time** (no blank screen) because there is no wake button yet; the button idea stays open until one is found. A **sensor error screen** (OLED-06) is approved as a state of F-08. The OLED module is **blue only**. OLED font is the Adafruit GFX 5x7 font scaled 1 to 4 | Owner, 2026-11-01 (s09) | Answers to the P03-D1 questions. P03-04 wording changed: the wake button part waits for hardware. The font choice is the agent's, for the owner to approve with the reference images. |
| D-026 | P03-02 choices: (1) the hotspot name and password sit in `secrets.h` (gitignored) **temporarily**, until the setup page (P03-05) stores Wi-Fi in flash; (2) test uploads go to **init-test**, switch to live `init` when P03 is done; (3) the firmware trusts **GTS Root R1, GTS Root R4 and GlobalSign Root CA** (`firmware/init/include/root_ca.h`) | Owner, 2026-11-02 (s11) | All three were the agent's recommended options. D-011 already said credentials live in `secrets.h`; only the `secrets.h.example` comment said otherwise (now fixed). GlobalSign Root CA expires 2028-01-28: replace or drop before then. |
| D-027 | P03-03: (1) the upload reply carries `interval_s` (device knows only its key); the device accepts 60 to 3600 only. (2) **The ROMOSS bank switches off if the awake board does not draw Wi-Fi-level current at least about once a minute:** 90 s uploads cut out, 60 s ran 10 min. So with this bank the interval must stay at 60 s (the server's floor). The server default of 300 s must not be used for a bank-powered device. | Design (1) owner approved 2026-11-02; (2) finding from owner's test 2026-11-02 | Open for the owner: set the live "Init 1" interval to 60 (a settings value, run in the terminal), and decide in P03-07/P07 if a dummy load or another bank is wanted. |
| D-028 | The OLED shows the room name from the server: the upload reply will carry it (like `interval_s`), instead of a fixed label in `config.h`. Supports F-21 (device room assignment), no new feature. Built together with P03-06; the label `Room 1` stays as the fallback until a reply has a name. | Owner, 2026-11-02 (s13) | The device knows only its key, not its room; the server already stores the room per device (D-024). Needs a migration (init-test first, then live) and a server test written first. **Built s13:** migration `20261102140000_ingest_returns_room.sql` on init-test (backend tests 48/48, seen red first); `include/room.h` with a PC test; the real OLED showed the server room `Unassigned` instead of the `Room 1` fallback. Live `init` still needs the migration. |
| D-029 | Brand: logo is concept B's app icon (a lowercase `i` drawn as a thermometer) next to concept A's `init` wordmark with heat-orange i-dots; on dark backgrounds the icon gets a light edge. Full name: **Init: Indoor Heat Index Tracker, An IoT-Based Classroom Heat Index Monitoring System** (In-door + Index + Tracker). Also: the device setup page (D-011) is approved, title centred | Owner, 2026-11-02 (s14) | Files in `design/brand/` (`init-logo-*.svg`, `init-icon-*.svg`, made by `build-logos.mjs` from the tokens; letters are plain strokes, no font licence). Logo and full name were the agent's proposals, owner chose and asked for the A+B mix. Not used in the app or on the device yet: the web app gets the icon in P04; the OLED start screen keeps the approved `INIT` text unless the owner asks. |
| D-030 | Hosting for the web app: **Vercel** (free Hobby plan), deployed from the GitHub repo. Resolves the open choice in D-002. The Hobby plan is for non-commercial use, so the project must stay non-commercial (classroom project, D-003). Vercel can set headers in `vercel.json`, so the CSP plan in the P04-01 proposal still works. Build style and backend choice still waiting on the owner. | Owner, 2026-11-02 (s15) | Owner answered question 1 of `documentation/specs/P04-01_PROPOSAL.md`. I will re-check the current plan terms on vercel.com before the first deploy. |
| D-031 | Web app build: **Vite + React** (static build), not plain files. Everything MIT (React, Vite, `@tabler/core`). Reads `init-test` first (D-026); the public key in the repo is accepted. Code in `web/`. | Owner, 2026-11-02 (s15) | Owner first said plain HTML/CSS/JS, then changed to a framework and picked Vite + React from the options (React, Svelte, vanilla Vite, Next.js). Answers 2 and 3 of `documentation/specs/P04-01_PROPOSAL.md`. |
| D-032 | Installable app (P04-05): page header is the logo and the title line **Init: Indoor Heat Index Tracker**, centred; room and status stay left. Theme colours `#f6f7f9` light and `#10161d` dark (the start-up screen is dark). The service worker keeps only the page's own files so the app opens offline; **readings are never cached** (an old temperature must not look current); no install button of our own. | Owner, 2026-11-02 (s18) | `design/pwa/`. Icons made by `web/build-icons.mjs` from the approved brand drawings: rounded (favicon, any), full square at 85 % (Android maskable), full square (iPhone). |
| D-034 | F-22 admin guide approved as proposed (`#guide`, readable without sign-in, linked only from the admin page, a **How? ›** link per admin group, six sections, about Grade 8 wording). **English** for the guide and the app for now; the **Tagalog/English toggle (F-18) is kept** for later (Tier 3). **A teacher reviews user-facing wording before it goes live**: the guide first, and every other user-facing wording too. | Owner, 2026-11-02 (s22) | Owner answers: "Yes", "English only, apply to all", "Yes, apply this also". First read as withdrawing F-18; the owner corrected it the same session: keep the toggle. The teacher review covers all user-facing wording, not only the heat-alert section. Mocks come next, then the build. |
| D-033 | School-day view (P04-07, F-12): school hours **Monday to Friday, 6:00 AM to 7:15 PM**; a separate view (`#school`) reached by one link row on the home page; shows highest, hottest hour, lowest, average heat index and the time in each PAGASA level plus **No reading**; a reading counts until the next one, at most 2 minutes (the offline limit); moments below the heat index range are left out of the four numbers; fixed to Asia/Manila time; computed in the database by a new function `school_day(day, for_device)`. | Owner, 2026-11-02 (s18) | Mocks in `design/school-day/`, approved; nothing is built yet. The owner's four answers: separate view, 2 min rule, below-range left out, Manila time. |
| D-035 | F-23: the **Reset** button beside the room box in `#admin` puts `Unassigned` in the box; **Save changes** writes it (two steps, nothing saved by a tap alone). `Unassigned` is the only default room name (database default, firmware `OLED_ROOM_LABEL`). No migration: Reset calls the existing `admin_set_room`. The F-22 Room guide got one sentence (teacher review pending, D-034). | Owner, 2026-11-03 (s27) | Mock `design/room-reset-readings/`; built test-first (page logic 12/12, admin gate 20/20, backend test); firmware default built, **not yet flashed**. |
| D-036 | F-24: a **readings table under the history charts**: From/To day pickers (only days with readings), **hourly averages** for any range (not raw rows), 500 rows per page with "Show more", **Download CSV** of the whole range, times in Philippine time. Two read-only database functions `readings_hourly` and `readings_span` (migration `20261107120000_readings_hourly.sql`, **init-test only; live needs the owner's `db push`**). | Owner, 2026-11-03 (s27) | Owner chose hourly rows, CSV yes and the place (under the charts). Built test-first: backend 6/6, page logic 10/10, history gate 17/17. Not yet seen on a phone or the hosted page. |
| D-037 | Research paper (CLAUDE.md hard rule 5): a `.docx` and a `.pdf` in `paper/`, updated in the same session as any feature or data change; every reference opened and read, published 2021 to 2026, never invented. The PAGASA tier ranges have no readable PAGASA source yet, so the paper presents them as project decision D-019 without a citation. | Owner, 2026-11-03 (s27) | `paper/README.md`; reference log `paper/references.json`. |
| D-038 | P07-01 enclosure: **Option A**, a two-part case. A main box holds the ESP32 and the OLED (window in the front face). The DHT22 sits in its own vented pod on a short cable (about 10 to 15 cm), away from the ESP32 and the power bank, which has its own pocket behind a divider wall. 3D printed on a Bambu Lab A1 in PETG, light colour. Still to confirm: power bank inside or outside, mounting, lid type, USB-C slot, BOOT hole (suggested: screw lid, USB-C slot, BOOT hole). Design is parametric OpenSCAD, `.stl` for Bambu Studio, preview images approved before any print. | Owner, 2026-11-09 (s37) | Waiting for the owner's measurements of every part. No file built yet. |
| D-039 | **Website and database work on hold** (owner, 2026-11-11): no new web, backend or migration work until the owner lifts the hold. Nothing is switched off: the Vercel site and both Supabase projects keep running, and the device keeps uploading to init-test. Includes the live rollout (migration, VAPID keys, function secrets, ALERT secret, CSP host) and P06-03; those wait. Active work: P07-01 enclosure (D-038), then the paper. | Owner, 2026-11-11 (s37) | Lift by telling the assistant; then remove this line from CURRENT_STATE "On hold". |
| D-040 | P07-01 enclosure **draft 2 approved as the design basis** (owner, 2026-11-11): 215 x 90.8 x 71.7 mm, bank inside, OLED on the front wall, hidden USB cable channel with a 30 mm port vestibule, vents, screwed lid. Placeholders stay open until measured (bank port strip, OLED lit area, BOOT/EN positions, DHT22 hole, insert size, PETG type). No print yet: a test print of the vestibule and port opening comes first. | Owner, 2026-11-11 (s37) | `enclosure/init_case.scad`, `enclosure/preview/draft2_*.png`. |
| D-041 | Enclosure fastening: **screws everywhere** (owner, 2026-11-11): lid to base 4 x M3, cover to bay 4 x M3 into posts, sensor arm foot 2 x M3; countersunk holes for the owner's DIN965 flat-head screws; brass heat-set inserts planned (size to be set from the insert data sheet). | Owner, 2026-11-11 (s37) | `enclosure/init_case.scad` draft 4. Insert brand and size still open. |
| D-042 | Enclosure: the sensor pod hangs **lower** (not on top of the cover), as Claude suggested. Screws: only **M3 x 5** on hand, so the design uses what is available (no M3 x 10). PETG not bought yet. | Owner, 2026-11-11 (s38) | Applies to draft 6 of `enclosure/init_case.scad`. Check the screw length against wall and insert depth once the measurements arrive. |
| D-043 | Website and database hold (D-039) stays: not lifted in s38. | Owner, 2026-11-11 (s38) | web/, supabase/ untouched. |
| D-044 | Screws: **only what is in the owner's box, nothing bought** (time). No heat-set inserts (supersedes the insert part of D-041). The case uses DIN965 flat-head **M2.5 x 8** (lid, cover, arm foot: about 5.6 mm of thread in the printed post), M2.5 x 5 for the OLED, M3 x 5 for the DHT22 tab. Screws bite directly into 2.1 mm pilot holes in PETG. | Owner, 2026-11-11 (s38) | `enclosure/init_case.scad` draft 6. The arm is a separate part (too long to print with the base on a 256 mm bed) screwed to the rear wall. |
| D-045 | The Init logo (D-029: thermometer-i icon + wordmark) is **engraved 0.8 mm deep on the front wall of the base** (66 x 24 mm) and filled with paint. One PETG colour for the whole case; one paint for the logo. Recommendation (not bought yet): light PETG (white or light grey) and a dark navy or black acrylic paint. | Owner request, 2026-11-11 (s38) | `enclosure/init_case.scad` draft 6 (`part="logo"` shows it alone). The rounded-square frame of the icon is left out. |
| D-046 | Drop strength (owner asked, s38; bank weighs about 670 g): **bank stops** so the loaded bank cannot slide along its length (blocks beside the port panel and behind the rear end, 0.3 mm clearance, foam shim optional); walls and floor 3.2 mm (was 2.4); outside corners rounded (3 mm); arm tube wall 2.4 mm, bigger foot plate (36 x 24 x 3) with four gussets. Lid and cover stay 2.4 mm so the M2.5 x 8 screws keep about 5.6 mm in the posts. | Owner, 2026-11-11 (s38) | `enclosure/init_case.scad` draft 7. Not tested: a drop test with the real bank is added to the PLA test plan. |
| D-047 | Owner approves **draft 7** as the design ("let's go with the design"), including the estimates marked EST, for the **PLA test print**. Any EST value that fails on the test is corrected in draft 8. The final PETG print waits for the test. | Owner, 2026-11-11 (s38) | `enclosure/init_case.scad` (already draft 7; nothing further to apply). |
