CodenameTempest14/init-heat-monitoring/documentation/context/CURRENT_STATE.md

# CURRENT STATE

> Overwritten at every session close. The first file read in every session (CLAUDE.md).

**Project:** Init: Indoor Heat Index Tracker, An IoT-Based Classroom Heat Index Monitoring System (D-029).
**Current phase:** P07 started (P07-01 enclosure design in progress, 0/7 ticked). P06 4/5 (P06-05 verified s37), project 61/72 (85 %). Before: P03 Device firmware (10/10). P04 web app 13/13 (P04-08 ticked s33) and P05 7/7 (P05-02 ticked s33); project 60/72 (83 %) after s36 (P06-01, P06-02 and P06-04 done; P06-02 verified by the owner's phone scan in s36; init-test offsets read back 0.0 / 0.0; `#kiosk` not yet seen on a TV). Next work is P06 (extras: P06-03 and P06-05 left), P07 (field trial), P08 (OTA, optional), all needing the owner's go-ahead. Checklists: [P03](../phases/phase-03-firmware.md), [P04](../phases/phase-04-web-app.md), [P05](../phases/phase-05-admin-alerts.md).
**ON HOLD (D-039, owner, 2026-11-11):** website and database work (web code, backend, migrations, live rollout, P06-03). Nothing switched off; the device still uploads to init-test. Active: P07-01 enclosure in `enclosure/` (draft 2, D-038; OpenSCAD model, waiting for the owner to approve and finish measurements), then the paper.
**Last session:** 2026-11-11 s38: enclosure draft 6 (owner's measurements, M2.5 x 8 box screws, pod low on a separate arm, logo engraved, `enclosure/PRINT_GUIDE.md`), D-042 to D-045, paper updated, pushed `2077ffc`; nothing printed. Before it: 2026-11-09 s37: P06-05 verified (owner's phone screenshot of the hosted page in Filipino; teacher approved the translation; owner saw `#kiosk` on a TV); paper updated and rebuilt; P06 now 4/5 (only P06-03 left, advice text). Before it: 2026-11-06 s36: P06-02 verified (owner scanned `/#poster`), offsets 0/0, paper Table 7 60/72; **P06-05 English / Filipino switch built and ticked UNVERIFIED** (`web/src/i18n.js`, `Lang.jsx`, `lang.css`; mocks `design/language-toggle/`; Filipino is a DRAFT, teacher review later; not seen on a phone or the hosted page; pushed to `codenametempest14` and `main` at `4782bc4`; later the same session the owner asked for the rest: charts, readings table, `#heat`, `#guide`, `#admin` are translated too (committed, check `git status -sb` for the push); kiosk, poster, push text and CSV column names still English; gates all green, web unit 119/119). Before it: 2026-11-06 s35 — [close report](../phase-reports/phase-03-firmware/sessions/2026-11-06_s35_CLOSE.md): owner approved the mocks; `#kiosk` and `#poster` built test-first (`web/src/Kiosk.jsx`, `Poster.jsx`, `kiosk.js`, `poster.js`, `qr-kiosk.css`; `tests/web-qr-kiosk.test.js` 7/7, `tests/ui-gate-qr-kiosk.test.js` 12/12, 0 differing pixels vs `design/qr-kiosk/ref/`). **P06-01 and P06-04 ticked; P06-02 UNVERIFIED** (the owner must scan the poster with a phone; pages are not on the hosted site until pushed). No link to either page, on purpose. init-test temperature offset reads **-0.5** (not -0.6): the owner chose to reset to 0 in `#admin` (not done yet; `db query --linked` is read-only). Paper rebuilt (Table 7 59/72). Before it: 2026-11-05 s34 — mocks only for P06-01 kiosk and P06-02 QR poster in `design/qr-kiosk/` (PROPOSED, waiting for the owner to approve the images; nothing built; `qrcode-generator` 2.0.4 added to `web/package.json`). Before it: 2026-11-05 s33 — [close report](../phase-reports/phase-03-firmware/sessions/2026-11-05_s33_CLOSE.md): **P04-08 and P05-02 ticked.** Owner's Android screenshots (light-mode home, Offline after unplugging, back Online, `#alerts`); interval changed 60 → 120 → 60 from the phone and read back (gaps 120 s then 60 s, bank stayed on 5 min at 120 s); calibration offsets changed from the phone and seen in the next readings; **left on init-test: temperature offset −0.6 °C, humidity 0** (owner's choice). Admin label "Heat alerts (coming later)" fixed to "Heat alerts" (`f7dac56` pushed to `codenametempest14` and `main`; the owner's phone still showed the old label, probably a tab loaded earlier). Paper: Figures 7 to 10 (phone screenshots of every page), 12 figures, Table 7 57/72. The old-readings roll-up (F-20) already exists (90 days, daily job). Before it: 2026-11-05 s32 — [close report](../phase-reports/phase-03-firmware/sessions/2026-11-05_s32_CLOSE.md): **P05-03 ticked.** The room reached heat index 41.5 °C (rounds to 42) at 02:42Z with the threshold left at 42; `alerts` id 9 sent 1 / failed 0; the owner's Android (installed app, the only subscription, FCM) showed "Init heat alert — Heat index 42 °C (Danger) in Unassigned." (owner's screenshots); the 02:47Z reading at the same level made no second alert (quiet period). No iPhone subscribed. Lighthouse re-run on the hosted page: 85 / 100 / 100 / 100 (P04-08 note). Paper updated (scope, procedure, Table 7 55/72, Not Yet Done) and rebuilt. Before it: 2026-11-04 s31 — [close report](../phase-reports/phase-03-firmware/sessions/2026-11-04_s31_CLOSE.md): **P05-03 heat alerts built on init-test, not ticked.** Owner answered the design ("all suggested"). Backend: migration `20261108120000_push_alerts.sql` (owner applied it in the SQL Editor; `db push` cannot reach the pooler), `push.backend.js` 14/14, `anon-probe` 28/28 on init-test (live fails the 7 new checks until the migration goes there); `send-alert` Edge Function deployed by the owner (needs `$env:SUPABASE_ACCESS_TOKEN` set to a write token in the terminal: the read-only one in `.env` wins otherwise), its 4 secrets and the 2 Vault entries set; chain check sent 0 / failed 0. Web: `#alerts` (mock approved), Heat alerts row on home, service worker push handlers; all gates green. Pushed to `codenametempest14` and `main` (`87a88eb`). iPhone installed app seen (P04-08 evidence). Paper: Figure 7 alert sequence (hourly chart is now Figure 8), `#alerts` in Figure 6, text, stack row, procedure step. Before it: 2026-11-04 s30 — [close report](../phase-reports/phase-03-firmware/sessions/2026-11-04_s30_CLOSE.md): live admin account made by the owner (dashboard user + `admins` row via the dashboard SQL Editor), live rules read back equal to init-test, owner signed in on localhost against live, `anon-probe` 21/21 on live; **P05-05 ticked** (option A; not covered: non-admin on live, a real save on live); paper updated (Table 7 now 54/72); `documentation/specs/P05-03_DESIGN.md` written (heat alerts, DRAFT, five DECIDEs + three new pieces waiting for the owner). Committed locally; push asked at close. Before it: 2026-11-03 s28 — [close report](../phase-reports/phase-03-firmware/sessions/2026-11-03_s28_CLOSE.md): P05-06 ticked (room save and Reset seen on the phone and the real OLED, owner's screenshots; F-24 Readings table works on the hosted page, owner's word); paper: Petaca 2026 PAGASA source, Chapter 2 hardware and tech stack tables, clickable alphabetical bullet references, Chapter 4 parked (`paper/chapter4.parked.txt`); `npm test` runs the whole suite (204/204); pushed to `codenametempest14` and `main` (`14acd27`). Later (2026-11-04): paper names filled in, Figure 7 and its interpretation added, references 7. Before it: s27 — [close report](../phase-reports/phase-03-firmware/sessions/2026-11-03_s27_CLOSE.md): new hard rule 5 (research paper in `paper/`, .docx and .pdf, real references only); F-23 (Reset room) and F-24 (readings table with calendar and CSV) built test-first, migrations on init-test and live, suite 204/204; not yet seen on a phone. Before it: s26 [close report](../phase-reports/phase-03-firmware/sessions/2026-11-03_s26_CLOSE.md): suite green, P05-04 done (firmware 0.6.0 flashed, health seen in `#admin`). Before it: s24 [close report](../phase-reports/phase-03-firmware/sessions/2026-11-02_s24_CLOSE.md). The run was untouched: 329 rows by 15:32Z, largest gap 64 s. Owner's light-mode phone screenshots (admin, guide, home, finished school day) show no defect. Before it: s23 ([close report](../phase-reports/phase-03-firmware/sessions/2026-11-02_s23_CLOSE.md)), s22 ([close report](../phase-reports/phase-03-firmware/sessions/2026-11-02_s22_CLOSE.md)).
**P05 started early (owner's call, s22, during the run):** P05 details P5-a to P5-j approved (FEATURES.md); design `documentation/specs/P05-01_05_DESIGN.md` (DECIDE 1 = keep 60-3600 with a power-bank warning, DECIDE 2 = no raw column, both owner-approved). Migration `20261105120000_admin.sql` (`admins`, `is_admin()`, admin-only update of the five settings values, `admin_set_room()`) is **on init-test only** (owner applied it); `tests/backend/admin.backend.js` 8/8 (seen red first; throwaway devices and users, safe during the run), read back from the database, `anon-probe` 21/21 on init-test. Admin view `#admin` built from **proposal B** (`design/admin/proposal-b/`, owner's pick; proposal A not chosen): `web/src/Admin.jsx`, `admin.js` (`tests/web-admin.test.js` 7/7, red first), `admin.css`. Driven in Chromium against init-test at 390 px light and dark: wrong password message, sign-in, values load, out-of-range refused by the page, an unchanged save writes nothing, reload keeps the session, sign out, a non-admin sees "Not an admin". **Not yet seen on the hosted page or a phone; a real save (room or a setting) not tried in the UI** (the only device is the run's "Room 1"). UI gate `tests/ui-gate-admin.test.js` 14/14 (s22; run it alone like the other gates). Test admin on init-test: `init-admin@init.com`, password chosen by the owner, in `.env` as `ADMIN_TEST_PASSWORD` (`tools/make-test-admin.mjs`); weak and shared in chat, so **test project only, never live**. Unchecked P05 items: none ticked.
**F-22 admin guide (s23, P05-07 done):** mocks approved; built test-first (`web/src/Guide.jsx` + `guide.css`, routes `#guide` and `#guide/room|interval|alerts`, three **How? ›** links in `Admin.jsx`; `tests/ui-gate-guide.test.js` 6/6, admin gate redrawn 14/14); pushed to `codenametempest14` and `main` (`304e894`), live at https://init-heat-monitoring.vercel.app/#guide. Seen on the hosted page in Chromium and on the owner's Android and iPhone (Brave, dark; light viewed by the owner, no screenshot). **A teacher approved the guide wording** (owner, s23). Left from D-034: the teacher's review of the app's other user-facing wording.
**Branches (s24):** everything is pushed to `codenametempest14` and `main` up to `c4f4209`; the s23 close commit was pushed to `codenametempest14` (level with origin at the s24 start; `main` not checked); the s24 close commit is local until the owner approves a push. Owner = `codenametempest14`. Remote `origin` = https://github.com/CodenameTempest14/init-heat-monitoring.git. At the start of s22 `codenametempest14` was level with `origin/codenametempest14` (the s21 close commit was already pushed). The s22 commit is local until the owner approves a push (check `git status -sb`). `main` was not checked in s22.
**Status line:** run `node tools/phase-report.mjs` · progress table: `node tools/phase-report.mjs --md`
**Phase builder:** owner only (answered s24, s28, s30, s31, s32, s33, s36, s37). Ask again at the start of every session.
**Board:** COM8 (CP210x). Flash from the terminal in `firmware/init` (`pio run -t upload --upload-port COM8`, hold BOOT on `Connecting....`), not from the VS Code toolbar (see `firmware/README.md`). The board has the s15 firmware (logo on the setup page, titles `Init Setup` / `Saved`) and joined the owner's hotspot at 07:02Z. Running the normal build with P03-05: the hotspot is saved in the board's flash (owner's hotspot), not in `secrets.h`. With no saved network, or when it cannot be joined for 20 s at start-up, the board opens `Init-Setup` (WPA2, password = `SECRET_SETUP_PASS`, last line of the local `secrets.h`) with the page at 192.168.4.1. Opening the serial port may or may not reset the board; my PowerShell background serial recording repeated text in s14, so prefer the server as evidence.
**Security settings:** sign-ups off and SSL enforced on both projects (read back 2026-11-01, S-4 and S-5 closed). S-12 (setup page) closed s14.
**Supabase:** account `CodenameTempest14`. Projects `init-test` (tests, may be wiped) and `init` (live), both Singapore. Both projects have all 9 migrations (the 8th, `20261103120000_history.sql`, adds `history(range_hours, for_device)`; the 9th, `20261104120000_school_day.sql`, adds `school_day(day, for_device)`; the owner applied both to init-test and live and I read them back, s17 and s19). Note: `db query` runs as a role that cannot call `school_day`; test it with the public key. init-test device "Room 1" has `interval_s` = 60. Live device "Init 1", room "Unassigned", `interval_s` 60, no readings yet. The real board uploads to **init-test** (device "Room 1") until P03 is done (D-026). Keys in `.env` (gitignored, template `.env.example`). The access token is read-only on purpose; writes go through the DB password (`tools/db.mjs`, `tools/device-key.mjs`). Claude Code's auto-mode classifier blocks `tools/db.mjs live ...` writes from the assistant. **`db query --linked` is read-only on both projects** (access token; writes fail with 25006): one-off live writes are done by the owner in the dashboard **SQL Editor** (project `init`). Read-only queries with `db query --linked` work for the assistant on both. **Live admin (s30):** one row in live `admins` (the owner's own email, password only in the owner's password manager); the hosted site still reads init-test. Readings columns: `temp_c`, `rh_pct`, `heat_index_c`, `recorded_at`, `received_at`, `room`.
**School-day view (P04-07, s19):** `#school` on the same address (`web/src/School.jsx`, `school.js`, `school.css`), reached by the **School day summary ›** row under "updated ..." (always shown, 20 px above it; with no device the view says "No readings yet"). Data from `school_day()` (seconds per level, counted by `recorded_at`; Mon-Fri 6:00 AM-7:15 PM Manila; before 6:00 AM it opens the last school day). Gates: `tests/ui-gate-school.test.js` (14) plus the redrawn home, badge and history mocks (all pass, one file at a time). `tests/backend/school-day.backend.js` can be run alone any time (throwaway devices); the other backend tests still wipe init-test.
**Web app (P04, s18):** P04-05 installable PWA is live and verified (centred logo header + title line, `web/public/` manifest, icons, `sw.js` that keeps only page files and never readings; installed from Chrome and as a Brave shortcut on the owner's Android, seen on an iPhone in Chrome, not installed there). P04-06 done: `node tools/anon-probe.mjs` (a stranger with the public key; 17/17 on init-test and live; add `<url> <key>` for another project). Run the three UI gates **one file at a time** (they race on `web/dist`). **Never run `npm test` or the backend tests until P03-07 ends: they wipe init-test.** Run the web tests alone: `node --test tests/web-*.test.js tests/ui-gate*.test.js tests/contrast.test.js`, one gate file at a time. P04-02 cards, P04-03 badge and P04-04 history charts are live and verified. Offline = newest reading more than **120 s** old by `received_at` (owner changed it from 180 s in s17; built and tested, **still UNVERIFIED on the hosted page while offline**). History: `web/src/History.jsx` + `history.js` + `charts.css`; three charts (heat index, temperature, humidity), 24 h = 15 min averages, 7 d = hourly, from the database function `history()` (at most 97 / 169 rows); readout above the charts, table twin, PAGASA lines at 33 and 42; UI gates `tests/ui-gate-{home,badge,history}.test.js`. `web/vite.config.js` has `cssMinify: false` on purpose (the minifier shifts line heights by 1/64 px and breaks the pixel gates). Set up in s15: `web/` = Vite 8.3.5 + React 19.3.1 + `@tabler/core` 1.7.3, plain `fetch` to the Supabase REST address (no `supabase-js`). Live at https://init-heat-monitoring.vercel.app (Vercel Hobby, non-commercial, D-030; imported from the GitHub repo, Root Directory `web`; every push deploys). Reads **init-test** with the public key (`npm run config` in `web/`; `npm run config -- live` rewrites only `web/src/config.js`, which is tracked: for the hosted site you must **also edit by hand** the Supabase host in `web/vercel.json`, whose CSP names it; for a local check with `npm run dev` the CSP does not apply, and `config.js` must go back to test before any commit). Needs `npm install` in `web/` before `npm test` (the UI gates build `web/` and use Chromium). Room shows `Unassigned` on purpose (owner).
**Windows note:** commit messages containing `"` must go through `git commit -F <file>` (PowerShell 5.1 mangles them).

## Recommended model for the next session (MDL-1)
**Sonnet 5.5** for the case design (OpenSCAD edits, renders), the print guide and the paper. Switch to **Opus 5.5** when P07 firmware, power-bank runtime, data-gap or security-review work starts.

## Next concrete step
**s38 close (2026-11-11):** the owner buys one roll of light PETG (white or light grey) and a dark acrylic paint pen, then pings Claude. Meanwhile: review draft 7 (`enclosure/preview/draft7_*.png`, `init_case.scad`; bank stops, 3.2 mm walls, D-046), confirm the EST guesses in `enclosure/PRINT_GUIDE.md` section 5, and measure one M2.5 flat-head screw head. Then: a short PLA test slice (port opening, button window, arm foot, logo), fix, then the final PETG print. Web and database stay ON HOLD (D-039). Everything is pushed (s38 final close).
**s37 close (2026-11-11):** the owner measures what is listed in `enclosure/MEASURE_NEXT.md` (sketch: `enclosure/preview/measure_guide.png`) on 2026-11-12; then draft 6 of `enclosure/init_case.scad` with the real sizes, OLED posts, DHT22 mount, pod lid; then the print guide (`enclosure/PRINT_GUIDE.md`, each value marked Bambu profile or estimate) and a short test print (vestibule + port opening) in PLA before the final PETG print. Website and database on hold (D-039). Open question to the owner: keep the arm on top of the cover (warm air) or hang the pod lower. Longer M3 screws needed (about M3 x 10 for the arm).
0. **Status after s38 (nothing changed in P06):** P06 is 4/5 (only P06-03 advice text left, waits for a teacher). P07 is 0/7; P07-01 (enclosure) is in design only. Everything is pushed to `codenametempest14` and `main` (check `git status -sb`).
1. Ask the phase-builder question (last answer: owner only, s37; not answered in s38). Web and database work are ON HOLD (D-039): do not touch `web/`, `supabase/` or the live rollout until the owner lifts it. Pending owner items: teacher review of the Reset sentence, alert wording and the app's other wording (D-034); a printed poster sheet (not confirmed); optional P05-03 leftovers (60-min reminder, an iPhone subscription).
   Live (later, after the device move, D-026): migration on live (SQL Editor), `node tools/vapid-keys.mjs live`, function secrets + deploy + Vault on live, **new ALERT secret** (the test one was shown in chat), `npm run config -- live` and the CSP host in `web/vercel.json`, `anon-probe` on live must give 28/28.
2. **Research paper (rule 5), every session:** `node paper/build.mjs` rebuilds the `.docx` and `.pdf`. Chapter 4 is parked until the owner says so. Names are filled in (s29: three researchers, adviser Arvin C. Trangia, Abuno High School; the title page says Adviser, not Coach). Open: more references 2021 to 2026 (7 verified (s29: Kirkil 2025, Wardani 2023 added; Cen et al. 2024, Building and Environment, a Singapore secondary-school classroom heat and cognition study, was NOT added: ScienceDirect blocked my script, so I could not read it; try again from a browser copy); the ESP32 and DHT22 datasheets are used in Table 2 but not in References for lack of a confirmable date); add anything built to the paper; look at the Word file in Word once.
3. **Teacher review (D-034):** the Reset sentence in the F-22 guide and the Readings table wording.
4. **P04-08:** done s33. Lighthouse 85 / 100 / 100 / 100 (performance held back by the 698 kB stylesheet; optional trim).
5. **Test command:** `npm test` (= `node --env-file=.env --test --test-concurrency=1`, 204/204 in s28; **not run as a whole in s31**: the backend tests wipe init-test readings, and the real board keeps uploading there) and `npm run test:backend`. In s31: `push.backend.js` 14/14 alone, UI gates one file at a time (home 12, badge 9, history 17, school 14, admin 20, guide 6, heat 10, core 5, alerts 16), other non-backend tests 132/132. Run the whole suite once at a moment the owner agrees to lose the init-test readings.
6. P03-07 follow-ups: causes of the gaps (220 s and 385 s); health report says why a restart happened. Not done: sensor accuracy check (needs a reference thermometer and hygrometer); the probe does not probe `readings_hourly` / `readings_span`; page loads 2.7 to 4.2 s; stylesheet 698 kB; P03-05 setup timeout and iPhone; P03-06 queue over 50, full queue, the 400 drop. Flash is about 77 % full (matters for P08). Firmware version is still 0.6.0.
7. F-24 edge: if a page ends between two rooms of the same hour (device moved in that hour), the second room's row is skipped. F-15 P06-03 not ticked. Timing note: a room change reaches the OLED at the device's next upload (up to `interval_s`, 60 s now).
8. Before every commit run `node tools/secret-scan.mjs`. Inline SQL: `node --env-file=.env tools/db.mjs test db query --linked "select 1;"`. Flash: in `firmware/init`, `pio run -t upload --upload-port COM8`, hold BOOT on `Connecting....`. Use the Edit tool for edits with backslash escapes; look at the page in a browser, not only the build. Never build a path with `new URL(...).pathname` (use `fileURLToPath`). `.vscode/settings.json` is untracked and not ours: leave it.

## Waiting on the owner
- Decide what comes next (step 1 above); say whether a shorter raw-readings window than 90 days is wanted (the roll-up already exists, F-20).
- Delete the scratchpad helper files from s31 if still present (`send-alert-test.env`, `vault_for_sql_editor.sql`, `push_alerts_for_sql_editor.sql` in the s31 Claude scratchpad folder): the first two hold test secrets.
- Teacher review of the alert title and body and the `#alerts` wording before alerts go live (D-034).
- Teacher review of the Reset sentence and of the app's other user-facing wording.
- Paper: say "put Chapter 4 back" when wanted.
- Write `SECRET_SETUP_PASS` on a sticker for the case.
- Later: dummy load or another bank (D-027). A push button for the OLED wake (D-025). Optional: confirm the S-6 passwords. Optional: a reference thermometer and hygrometer; later (P07) a USB inline meter.
- Before 2028-01-28: GlobalSign Root CA in `firmware/init/include/root_ca.h` expires (D-026).

## Decisions so far (all in DECISIONS.md)
D-001 hardware parts · D-002 stack Option A · D-003 scope · D-004 pocket 4G router/hotspot · D-005 unmarked 18650 cells · D-006 MP1584 buck at 5.20 V with D1 · D-007 brand name **Init** · D-008 USB power bank replaces cells/buck/BMS · D-009 30-pin ESP32, SSD1306 128×64, no BMS · D-010 features approved if open source · D-011 Wi-Fi option 1 · D-012 confirmed hardware and ROMOSS bank · D-013 phase plan · D-014 owner may push main · D-015 heat index option A · D-016 design canvas option 1 · D-017 38-pin ESP32 with Type-C · D-018 no deep sleep · D-019 PAGASA bands on rounded heat index · D-020 NWS range rule · D-021 P01-07 ruled out · D-022 OLED design canvas at the start of P03 · D-023 server computes and stores the heat index · D-024 F-21 device room assignment · D-025 OLED always on, sensor error screen, blue module, 5x7 font · D-026 temporary Wi-Fi in secrets.h until P03-05 (ended s14), init-test first, roots GTS R1 + R4 + GlobalSign · D-027 reply carries interval_s; the bank needs an upload at least every 60 s · D-028 reply carries the room name · D-029 logo (B icon + A wordmark) and full name; setup page approved, title centred · D-030 hosting on Vercel · D-031 web app on Vite + React, init-test first, public key in the repo · D-032 installable app header and worker · D-033 school-day view · D-034 F-22 admin guide approved, English for now (F-18 Tagalog/English toggle kept for later), teacher reviews user-facing wording before it goes live. D-035 F-23 Reset room, `Unassigned` default · D-036 F-24 readings table (hourly, CSV, under the charts) · D-037 research paper rule and real references. Pre-push hook active via `core.hooksPath .githooks`.

## Built so far
`src/heat-index.js` and tests; `design/` (pages, tokens, contrast check, registry, `brand/` logo and icon, `device-setup/` approved setup page + `proposal-logo/`, `oled/` canvas, `templates/` Tabler shots, `ui-gate.mjs`); `firmware/bench`; `supabase/migrations/` (12 on both projects: admin, device health and `20261107120000_readings_hourly.sql` were put on live by the owner in s27); `tests/backend/` (54 + `admin.backend.js` 8, test project only); `documentation/specs/SECURITY_REVIEW.md` (S-1 to S-12); `tools/` (`db.mjs`, `device-key.mjs`, `secret-scan.mjs`, `phase-report.mjs`, `continuation-prompt.mjs`, `check-readmes.mjs`); `firmware/init/` (P03-01 to P03-06: HTTPS upload with certificate check, interval from the reply, OLED screens, offline queue, room from the reply, setup page with Wi-Fi in flash; PC tests for each pure header). `paper/` (the research paper, .docx and .pdf, six diagrams, 24 h run data); F-23 Reset (`Admin.jsx`) and F-24 `web/src/Readings.jsx` + `readings.js` + `readings.css` with mocks in `design/room-reset-readings/`; `web/` (P04-01 to P04-07 live on Vercel; `web/public/` manifest, worker, icons) with `design/home-cards/`, `design/offline-badge/`, `design/history-charts/` and `design/pwa/` (approved mocks), `design/school-day/` (approved mocks for P04-07, built) and the UI gates `tests/ui-gate-{home,badge,history,school,admin}.test.js`; `tools/anon-probe.mjs` (21 checks); P05 admin view `#admin` (`web/src/Admin.jsx`, `admin.js`, `admin.css`; mocks `design/admin/proposal-b/`, approved; proposal A kept, not chosen); `tools/make-test-admin.mjs`. `npm test` was 101/101 in s17, plus `tests/web-pwa.test.js` 8 in s18 (not run as a whole: it wipes init-test during P03-07) (run `npm install` at the root, `npm install` in `web/` and `npx playwright install chromium` first; needs g++).

## Parking lot (out of scope — not being pursued)
- Cellular module on the device (not chosen; revisit only if the hotspot plan fails).
- On-board battery charger (cells are charged outside the device).
