CodenameTempest14/init-heat-monitoring/documentation/phases/phase-05-admin-alerts.md

# Phase 5 — Admin, alerts and device health

**Objective:** One admin can sign in, change settings and receive heat alerts; device health is visible.
**Entry criteria:** P04 closed.
**Exit criteria:** Settings changed in the app reach the device on its next wake; an alert arrives on a phone; anonymous users cannot reach admin features.
**Features:** F-09, F-10, F-17, F-21 (admin edits the room). Model: Opus 5.5.

Checklist markers: see phase-01.

- [x] P05-01 Admin login (single account) — evidence 2026-11-02 (s22): `#admin` on the hosted page (init-test). Owner signed in as the test admin in their computer browser and sent cropped screenshots (wrong password -> "Email or password is wrong.", then signed in with the values loaded, dark mode). Assistant drove it in Chromium on the hosted page at 390 px light and dark: sign-in, reload keeps the session, sign out, a non-admin sees "Not an admin". `tests/web-admin.test.js` 7/7 (red first). Live admin account not made yet (see P05-05).
- [x] P05-02 Settings page: interval, thresholds and calibration offset; the device picks them up (F-09) — PROG: page built (s22), ranges checked by page and database (`admin.backend.js`), an unchanged save writes nothing. **Done s33 (2026-11-05, owner on the phone in `#admin`, init-test, read back from the database):** (1) interval 60 → 120 saved at 15:14:02Z, `settings.interval_s` = 120; the device took it at its next upload (readings 15:14:57, 15:16:57, 15:18:57, 15:20:57: gaps 120.2, 120.3, 120.3 s); the power bank stayed on for 5 min at 120 s; set back to 60 at 15:21:38Z, gaps 119.8 then 60.0, 60.2 s. (2) calibration offsets: both 0 until 15:27:15Z, then temperature +0.9 and humidity +5.0 saved; the next reading (15:27:57Z) rose from 28.5 °C / 62.5 % to 29.3 °C / 67.3 %; at 15:28:31Z they were saved as −0.9 and −5.0 and the next reading (15:28:58Z) fell to 27.4 °C / 58.2 % (swing of 1.9 °C and 9.1 %, expected 1.8 and 10; sensor noise accounts for the difference); the heat index was recomputed by the server each time (32.9 then 28.4). (3) Alert threshold and quiet period: seen in s32 (P05-03, alert at 42). Owner's screenshot (23:14, dark, Saved tick, interval 120). **Left on the test project after the check: offsets −0.9 °C and −5.0 %** (owner's choice; reference thermometer said 27.9 °C).
- [x] P05-03 Push alert at Danger level with a quiet period, received on a phone (F-10) — evidence 2026-11-05 (s32, init-test, real board, threshold left at 42): the owner's Android (installed Init app, subscription made 2026-11-04 16:35Z, push host `fcm.googleapis.com`, the only row in `push_subscriptions`) got the notification "Init heat alert — Heat index 42 °C (Danger) in Unassigned." (owner's lock-screen screenshot 10:44 Manila, "2m" old; second screenshot: `#alerts` showing "Heat alerts are on for this phone.", 42 °C, 60 minutes, Stop alerts; screenshots not stored in the repo). Read back read-only: `alerts` id 9, created 02:42:00Z from the reading of heat index 41.5 °C (rounds to 42, D-019), room Unassigned, **sent 1, failed 0**. Quiet period: the 02:47:00Z reading (41.5, rounds to 42) made no second alert row. Not covered: the hourly reminder after 60 min, the iPhone (not subscribed), a lowered threshold saved from `#admin` (not needed: the room reached 42 by itself), live (after the device move, D-026). Earlier PROG (s31, 2026-11-04): design approved (owner: "all suggested"). Backend on **init-test**: migration `20261108120000_push_alerts.sql` applied by the owner in the SQL Editor (`db push` could not reach the pooler), read back; `tests/backend/push.backend.js` 14/14 (red 0/14 first); `anon-probe` 28/28. `send-alert` Edge Function deployed by the owner from the repo files (CLI, scoped token; the CLI kept using the read-only `.env` token until `SUPABASE_ACCESS_TOKEN` was set in the terminal), JWT check off; from outside: no secret / wrong secret -> 401, GET -> 405. Function secrets and the two Vault entries set by the owner. Chain check with a throwaway device (threshold 27, 0 subscriptions): upload -> trigger -> `alerts` row -> pg_net -> function -> `sent 0, failed 0` written back. Web Push code (`_shared/webpush.js`) matches the RFC 8291 example byte for byte. Web part (s31, mock approved by the owner: "Approved"): `#alerts` view (`web/src/Alerts.jsx`, `alerts.js`), **Heat alerts ›** row on home, service worker `push` and `notificationclick` handlers, VAPID public key in `config.js`. `tests/ui-gate-alerts.test.js` 16/16 (0/16 first), `web-pwa` 12/12 (4 new red first), `web-alerts` 5/5, all other UI gates green, other tests 132/132. Pushed to `codenametempest14` and `main` (`87a88eb`). **Not done:** a real notification on the owner's Android (subscribe on the hosted site, threshold 30 in `#admin`, wait for an upload, screenshot, back to 42), the iPhone (installed app), live.
- [x] P05-04 Device health page: Wi-Fi signal, last reboot reason, firmware version (F-17) — evidence 2026-11-03 (s26): migration `20261106120000_device_health.sql` applied to init-test (NOT yet on live); `tests/backend/health.backend.js` 6/6 (seen red 0/6 first), whole backend suite 73/73, `node --test --test-concurrency=1` 187/187. Firmware 0.6.0 (`main.cpp` sends `health` with every upload, `health.h` tested on the PC) flashed on COM8; server row read back: rssi -52, POWERON, 0.6.0 at 14:13:42Z, readings continued every 60 s. Owner's phone screenshot of `#admin` Device health (dark): Wi-Fi Good -49 dBm, Power on, 0.6.0, Just now. Not seen: a reset reason other than POWERON, a weak-signal state, light mode.
- [x] P05-05 Admin actions refused for anonymous users **and for any signed-in user who is not the named admin** (SECURITY_REVIEW S-4: policies check an admin list, never just `authenticated`), tested on the server — evidence: init-test s22 (`tests/backend/admin.backend.js` 8/8, red first: stranger and signed-in non-admin refused, admin allowed; policies read back; `anon-probe` 21/21). Live, 2026-11-04 (s30): the owner made the live admin user in the dashboard (own email, generated password, not in the repo or chat) and added its id to `admins` in the dashboard SQL Editor (`db query --linked` is refused with 25006 because the access token is read-only). Assistant read back on live and init-test (read-only): `admins` = 1 row on each; the only write rule in `public` is `settings: admin update` for `authenticated` (checked by `is_admin()`) on both; no grants on `admins` to anon or authenticated on both. Owner signed in on `localhost:5173/#admin` with `web/src/config.js` set to live: the page showed the account with the **Admin** label (owner's screenshot, not stored). `node tools/anon-probe.mjs` against live (`ffcsdqqldsendeddvyhq`): **21/21**, no probe row saved. Config switched back to init-test, `config.js` unchanged in git; the hosted site was not changed. **Not covered (owner chose to tick, option A, s30):** a signed-in non-admin on live (live has no throwaway users; same rules as init-test), and a real save on live: `#admin` picks its device from the newest reading and live "Init 1" has none until the board moves to live (D-026).
- [x] P05-06 Admin can change the device's room; new readings get the new room, old readings keep theirs (F-21, D-024). The room input says not to use people's names (SECURITY_REVIEW S-10) — PROG: `admin_set_room()` tested on init-test (new readings get the new room, old keep theirs); room box built with the S-10 text. Seen (s28, 2026-11-03, owner, phone, init-test): the owner saved the room "MJ's Abode" in `#admin`; the owner's three screenshots show it: the `#admin` Room box ("MJ's Abode", with the Reset button and the no-person's-name text), the user page ("Room: MJ's Abode", Online, heat index 35 °C Extreme caution, 29.8 °C, 70 %), and the real OLED ("MJ's Abode  Wi-Fi OK", 35 °C, EXTREME CAUTION, T 29.8, RH 70%): web and OLED show the same values. Screenshots not stored in the repo. Reset (s28, owner): Reset then Save changes showed the "Saved" tick, the Room box `Unassigned` with Reset greyed out, and the real OLED `Unassigned  Wi-Fi OK`. Old readings keeping their room: backend test only.
- [x] P05-07 Admin guide `#guide` and a **How? ›** link under each admin group (F-22, D-034) — PROG (s23, 2026-11-02): mocks approved by the owner (`design/admin-guide/`, `design/admin/proposal-b/` redrawn with the links, 0 differing pixels against the approved `admin-how` images). Built: `web/src/Guide.jsx`, `guide.css`, the route in `App.jsx`, the links in `Admin.jsx`. `tests/ui-gate-guide.test.js` 6/6 (seen red first: 6 failed, and the admin gate 12 failed on the new links; then green), admin gate 14/14, home 12, badge 9, history 13, school 14, web unit tests 62/62. The guide sends no request except the header's newest reading. Pushed to `codenametempest14` and `main` (`304e894`); on the hosted page in a fresh Chromium, 390 px light and dark: `#guide/interval` opens at the section, no console messages. Owner's phone screenshots (s23, 22:37 to 22:39, dark mode, Brave on an Android phone and on an iPhone): the three How? links, all six sections, the contents links and the back link ‹ Admin work. The owner also viewed light mode on the phone and says it looks normal (no screenshot kept). **A teacher read the draft and approved the wording** (owner's word, 2026-11-02, s23; D-034). **Not covered:** the teacher's review of the other user-facing wording of the app (D-034 asks for it too).
