CodenameTempest14/init-heat-monitoring/documentation/phases/phase-04-web-app.md

# Phase 4 — Web app core

**Objective:** The public app: live readings, heat category, history and an installable phone app.
**Entry criteria:** P03 closed (real data is flowing).
**Exit criteria:** A logged-out visitor on a phone sees correct, current data; the app is checked in a real browser and on a real phone.
**Features:** F-01 to F-05, F-07 (checked from the front end), F-12, F-21 (room name). Model: Sonnet 5.5.

Checklist markers: see phase-01.

## Design canvas (D-016, owner chose option 1; agent placed it here)
Software only. Needs no data or hardware, so it may be done before P04 opens; it must be finished and approved before any page is built (UI-GATE).
- [x] P04-D1 `design/` folder with README, a small template manifest and registry, and one token file (colours, type, spacing) — evidence 2026-10-31: design/README.md, pages.json (5 pages), tokens.json (provisional), build-registry.mjs run -> REGISTRY.md. No "small template manifest" beyond pages.json; templates themselves come in D2.
- [x] P04-D2 Page list for the app taken from the approved features, one open-source template chosen per page, licence recorded — evidence 2026-10-31: pages.json updated, REGISTRY.md regenerated. Tabler MIT licence read on GitHub; demo page URLs return HTTP 200. Templates NOT yet looked at (D4). Device setup page is hand-written (ESP32 flash size). Statuses stay Proposed until D4.
- [x] P04-D3 Tokens for light and dark, including the four heat category colours, with contrast checked by a script (text 4.5:1, non-text 3:1) and an icon or text label so colour is never the only signal — evidence 2026-10-31: tests/contrast.test.js written first (red: module missing), then 4/4 pass; `node design/contrast.mjs` found white-on-orange danger at 3.58:1, fixed fill to #c2410c (5.18:1), now all pass. Each category has a text label token; rendering of the labels is checked in the UI later.
- [x] P04-D4 Reference screenshots of each chosen template at phone and desktop widths, owner approves them — 2026-11-02 s10: 8 screenshots taken (design/templates/, 4 pages x phone and desktop), all HTTP 200. **Owner approved them 2026-11-02 (s11).** `pages.json`: home, kiosk, qr-poster, admin set to Approved; `node design/build-registry.mjs` rebuilt REGISTRY.md (5 pages). `device-setup` stays Proposed: it has no Tabler template (own code on the ESP32) and needs its own approval in P03-05.
- [x] P04-D5 UI-GATE comparison (Playwright screenshot of our page vs the approved image) set up and shown to fail on a deliberate mismatch — evidence 2026-11-02: tests/ui-gate.test.js written first (red: design/ui-gate.mjs missing), then 5/5; fails on a changed number, a changed colour and a different width; `npm test` 23/23. Mechanism only: no app page exists yet, so it is not yet pointed at an approved template image.

## Build
- [x] P04-01 App skeleton built and deployed on free hosting
  - **Deployed on Vercel (s15, 2026-11-02, https://init-heat-monitoring.vercel.app, owner deployed from the GitHub repo, Root Directory `web`).** Built: `web/` (Vite 8.3.5 + React 19.3.1, `@tabler/core` 1.7.3, all pinned). Test first: `tests/web-lib.test.js` red (module missing), then 5/5; two mutations made 2 tests fail. `npm test` 43/43, `npm run build` OK (CSS 692 kB / 86 kB gzip: all of Tabler, to trim later; JS 70 kB gzip). Looked at in Chromium at 390 px with the headers from `web/vercel.json` in force (scratch static server): light and dark both showed the newest init-test row (31.3 °C, 58 %, heat index 35, room `Unassigned`, updated just now), no console messages, no CSP block, scroll width 390 = viewport 390. **Hosted check (08:32Z):** `curl -I` gives 200 and the headers from `vercel.json` arrive (Content-Security-Policy with only our own files and the Supabase host, nosniff, no-referrer, HSTS). A fresh logged-out Chromium at 390 px, light and dark: `Room: Unassigned`, 32.5 °C, 65 %, heat index 40, `updated just now` (server's newest row 08:31:33Z: 32.6 °C, 65.3 %, 40.4), no console messages, scroll width 390 = viewport 390. **On the owner's phone (08:36Z, Android, light mode, opened inside the Messenger in-app browser, owner's screenshot):** `Room: Unassigned`, 32.6 °C, 66 %, heat index 41, `updated 1 min ago`; no horizontal scroll, text readable. **Limits:** the full P04-08 phone check (Chrome itself, dark mode, iPhone, install) is later; the anonymous-write check was not re-run (the backend tests wipe init-test, which holds the 24 h evidence); the heat-index colour and category come in P04-02; the page is only text.
- [x] P04-02 Live cards for temperature, humidity, heat index and PAGASA category, with the room name (F-01, F-02, F-21)
  - **Verified on the hosted page (s16, 2026-11-02).** Logged-out Chromium at 390 px and 1280 px, light and dark (4 loads, 08:53Z): `Room: Unassigned`, 32.2 °C, 66 %, heat index 40, Extreme caution (triangle, amber), `updated just now`, no console or CSP messages, scroll width = viewport width. Headers from `vercel.json` arrive. **Owner's phone screenshot (16:56 local, Brave on Android, dark mode):** same layout, 32.1 °C, 67 %, heat index 40, Extreme caution, `updated just now`, no sideways scroll, text readable. Loads took 2.7 to 4.2 s (cold start and the 692 kB stylesheet: still open). Desktop layout not gated; light mode and iPhone not checked on a phone. Earlier (s15, local) evidence: Design: `design/home-cards/` (5 category mocks, 14 screenshots), **owner approved 2026-11-02**. Test first: `tests/web-category.test.js` red (module missing) then 4/4 (the page's copy of the PAGASA bands equals `src/heat-index.js` for every 0.1 °C from -20 to 80; a changed band edge made 2 tests fail); `tests/web-lib.test.js` extended and red first (4 failed), then 7/7 (category, bare heat index number, null shows a dash). UI-GATE `tests/ui-gate-home.test.js`: the built page, served with the headers from `vercel.json`, matches the approved image pixel for pixel (0 differing pixels) for all 5 categories x light and dark, with no console or CSP messages; it fails on a changed number and on a wrong category colour. `npm test` 61/61. Looked at with real init-test data in Chromium at 390 px: `Room: Unassigned`, heat index 40 °C, Extreme caution (triangle), 32.2 °C, 66 %, no sideways scroll. **Limits:** the gate's first run failed 12/12 for a test-setup reason (the CSP blocked my injected style tag; the CSP was right, the test line was removed), so there is no separate red run of the gate against the old page; not deployed; the dark-mode live look caught the page before its first load finished (the fetch took over 2.5 s once: cold start of the Supabase project?); desktop layout is only in the mocks, not gated.
- [x] P04-03 Online/offline badge (F-03)
  - **Verified with the real board (s16, 2026-11-02, hosted page, owner's phone, Brave on Android, dark).** Pushed 09:0xZ, hosted page showed `Online` logged out in Chromium. Owner unplugged the board at 17:06 local; the server's last upload was received 09:05:45Z. Owner screenshots: 17:09 `Offline: no reading for 3 min` (`Last heat index`, `last reading 3 min ago`), 17:10 `4 min`, 17:11 `5 min`, all with the last values (39 °C, Extreme caution, 32.0 °C, 67 %); board plugged back in, first new upload received 09:13:00Z (gap 435 s on the server, the only gap over 90 s since 09:00Z), 17:13 screenshot `Online`, `Heat index`, `updated just now`. The 3 min rule behaved as built (3 min shown only after 180 s). **Earlier (local) evidence:** Design: `design/offline-badge/` (4 states, light and dark), **owner approved 2026-11-02** (wording as in the mocks, "Offline: no reading for N min"). Rule built: offline when the newest reading is more than 3 min old by `received_at` (my proposal; the owner approved the mocks and wording, did not answer the 3 min number separately: confirm). Test first: `tests/web-lib.test.js` (+5) and `tests/contrast.test.js` (+1) red (missing exports, no status check), then green; changing 180 s to 240 s made 1 test fail. Status colours added to `design/tokens.json`, `contrast.mjs` checks them (all pass). UI-GATE `tests/ui-gate-badge.test.js`: built page matches the approved image pixel for pixel, 4 states x light and dark, no console or CSP messages; fails when offline is drawn as online. The home-cards mocks and images were regenerated with the Online pill; the home gate still passes. `npm test` 76/76. First gate run: no-readings failed 326 px because my mock said `Room 204` while the page (no row) says `Room: —`; the mock was wrong, fixed. Real init-test data in Chromium at 390 px dark: `Online`, 40 °C, no console messages. **Limits:** light mode, iPhone and desktop not seen for the badge; the page only changes on its 30 s refresh (by design).
- [x] P04-04 24-hour and 7-day charts (F-04)
  - **Verified on the hosted page and the owner's phone (s17, 2026-11-02).** Pushed `3740104`, Vercel serves it. Logged-out Chromium at 390 px light, 390 px dark and 1280 px dark (Manila time): `Online`, 40 °C, charts and a 30-row table (7 d: 10 rows), range switch works, scroll width = viewport, no console or CSP messages. **Owner's phone screenshots (18:18 local, Brave on Android, dark):** touching the 24 h chart shows the readout `02:15  31 °C / 28.7 °C / 65.1 %` and the crosshair on the charts; Last 7 days switches and shows `Mon 02:00`; no sideways scroll, text readable; the live board's data is on the charts. **Limits:** after a tap the chart shows a white focus outline (the chart is keyboard-focusable; it should show only for keyboard users: follow-up); the 24 h temperature line drops sharply to the bottom of the axis near 04:00 (not yet checked against the raw rows); the table twin, light mode and iPhone not seen on a phone; the table is not pixel-gated. Build evidence: Design: `design/history-charts/` (mocks, 12 screenshots), **owner approved 2026-11-02** (PAGASA lines left to me: kept; 15 min / hourly averages approved if the database is not overloaded). Database: `history(range_hours, for_device)` (migration `20261103120000_history.sql`, on init-test, **not on live `init` yet: owner**) returns at most 97 or 169 rows; test first `tests/backend/history.backend.js` red (function missing, 404) then 5/5. Page maths `web/src/history.js`: `tests/web-history.test.js` red (module missing) then 13/13; widening the gap rule from 1.5 to 9 steps made 1 test fail. UI-GATE `tests/ui-gate-history.test.js`: built page matches the approved image pixel for pixel for 24h, 7d, a time picked and no readings (phone, light and dark) and the 24h desktop page; fails on a wrong series colour. Getting to 0 pixels needed `cssMinify: false` in `web/vite.config.js` (Vite's CSS minifier shifted line heights by 1/64 px). `npm test` 101/101. Looked at with real init-test data in Chromium (Manila time), dark, 390 px: charts, table, no console messages. **Limits:** touch and hover not tried on a phone; table twin not pixel-gated (the mock shows 8 rows, the page all); `history()` not applied to live; the 2 min offline rule (commit `16016ae`) also still unseen on the hosted page. **Follow-ups (s18, 2026-11-02, UNVERIFIED: not deployed, not seen on a phone):** (1) focus outline: test first in `tests/ui-gate-history.test.js` red (after a click the chart had `outline: auto 5px`), then green with `data-touched` set on pointer-down and removed on key or blur (`web/src/History.jsx`, `charts.css`); keyboard Tab still shows the outline; history gate 13/13, other web tests 50/50 (`npm test` not run: it wipes init-test during P03-07). Chromium treated the click as focus-visible, so `:focus-visible` alone would not have worked. (2) The 04:00 drop is real data, not a chart bug: init-test rows 20:13:05Z 29.3 °C, 20:14:05Z 23.1 °C / 79 % (no heat index), 20:15:05Z 26.0 °C, then no rows until 21:07:13Z (28.6 °C). Cause unknown (board moved, or a sensor blip); the owner may remember.
- [x] P04-05 Installable PWA, phone-first layout, light and dark (F-05)
  - **Seen on the owner's phones (s18, 2026-11-02, screenshots 19:18 to 19:26 local): see the last paragraph.** Earlier status: built locally, UNVERIFIED until deployed. Design: `design/pwa/` (header logo, icons, installed look), **owner approved 2026-11-02** after two header changes (centred logo and title line `Init: Indoor Heat Index Tracker`; room and status stay left with a little more space); icons, theme colours (`#f6f7f9` / `#10161d`) and the offline rule approved as shown. Test first: `tests/web-pwa.test.js` red 0/8 (no manifest, icons, tags or worker), then 8/8; removing the same-origin rule from `sw.js` made the readings test fail. Built: `web/public/` (manifest, `sw.js`, favicon, icons 192/512/maskable/apple, logos; made by `npm run icons` from the approved drawings), tags in `web/index.html`, worker registered in `main.jsx` (production build only), `/sw.js` served `no-cache` (`vercel.json`), new header in `App.jsx` and `app.css`. UI gates: the home, badge and history mocks and their images were redrawn with the new header first (gates red: 31 of 34 failed), then the app was changed and the gates gave **0 differing pixels** (12, 9 and 13 tests, run one file at a time: run together they race on `web/dist`). The gate servers needed `.svg`, `.png`, `.webmanifest` types (Chrome does not draw an SVG sent as octet-stream). Looked at in Chromium on the built app (390 px, fake readings): the worker registers and controls the page, the manifest loads, the cache holds only `/`, the script, the stylesheet, the logo and the manifest (no Supabase request), and with the network cut the page opens with the new header and says `Could not load the readings. Will try again.`; no console messages. **Not done:** Lighthouse or Chrome's install check, a real install on the owner's phone (Android and iPhone), icon on the home screen, theme colour in the status bar, the hosted page. Web tests only (`npm test` not run: it wipes init-test during P03-07). **Pushed `6c0f41e` to `codenametempest14` and `main` (owner approved, s18). Hosted check (Chromium, logged out, 390 px light, 390 px dark, 1280 px dark):** the new header and logo show (light or dark file as the colour scheme asks), `Online`, the manifest arrives as `application/manifest+json`, `sw.js` as `no-cache`, the worker is ready, no console or failed requests, no sideways scroll. **Owner's phones (19:18 to 19:26 local):** Android (Brave, dark): the Init icon is on the home screen, dark rounded square with the thermometer inside the mask, label `Init`; it carries Brave's small lion badge, which means Brave made a home-screen shortcut, not a Chrome-style installed app (WebAPK); the page then showed the charts with the status bar in the page colour and no browser bar visible. iPhone (Chrome, dark, 5G): the new centred header, logo, `Online`, 40 °C, charts below, no sideways scroll; **no add-to-home-screen tried on the iPhone**. **The white focus outline after a tap on a chart is gone** (owner, Android: touched chart shows only the crosshair), which closes that P04-04 follow-up. **Chrome install (owner's Android screenshot, 19:31 local):** installed from Chrome, the `Init` icon has no Brave badge, so it is a real installed app (WebAPK); the thermometer sits inside the mask with even margin (the maskable icon works, the "slightly large" look was only Brave's shortcut using the full-square icon). **Limits:** Lighthouse not run; iPhone add-to-home-screen not tried (the iPhone icon is the 180 px `apple-touch-icon`); light mode of the new header not seen on a phone; the offline page (service worker) not seen on a phone.
- [x] P04-06 Public read-only confirmed from a logged-out browser (F-07)
  - **Verified (s18, 2026-11-02).** Logged-out Chromium on the hosted page (390 px and 1280 px, light and dark, earlier P04-05 check): live data with no sign-in. New `tools/anon-probe.mjs` (a stranger with only the public key, same requests the browser makes): **17/17 on init-test (what the app reads) and 17/17 on live `init`.** Reads work: readings, readings_hourly, settings, device_status, device name/room/last seen, `history()`. Refused (permission denied, or a harmless empty answer for an id that matches nothing): insert, change and delete on readings; insert on readings_hourly; change on settings; insert, change and delete on devices; selecting `key_hash` is denied; `ingest_reading` with a wrong device key gives 403 `bad_key`; afterwards no row with the probe's marker room exists. The probe was safe to run during P03-07 (no backend tests, no wipe). **Limits:** the probe's failure path was only seen on my own typo (a wrong column name made it report FAIL), not against a real hole; changes and deletes use an id that matches nothing, so a missing row rule would show as a 200 with an empty list that the probe also accepts: the grants (`42501`) are what proves it, and the backend suite (`tests/backend/access.backend.js`) holds the stricter per-command checks; the admin sign-in (P05) will need these rules re-checked.
- [x] P04-07 Daily summary and school-hours view (F-12)
  - **Done (s19, 2026-11-02).** Migration `20261104120000_school_day.sql` (`school_day(day, for_device)`, Mon-Fri 6:00 AM-7:15 PM Manila; seconds per level add up to the window; a reading counts until the next, at most 120 s; 400 for weekends, the future, over 90 days). Applied by the owner to init-test and live. `tests/backend/school-day.backend.js` 6/6 on init-test (run alone: the other backend tests wipe init-test; never seen red because the function did not exist until applied). `tests/web-school.test.js` 12/12 (red first: module missing). `tests/ui-gate-school.test.js` 14/14, 8 runs in a row, browser in a New York zone. Gates home 12, badge 9, history 13 pass with the redrawn mocks (link row, 20 px above it after owner feedback). **Hosted check (fresh Chromium, 390 px, dark):** link row 20 px under "updated", `#school` opens with real init-test rows (Mon 2 Nov: highest 41 °C at 4:34 PM, 5 h 47 min extreme caution), back works, no console errors, scroll width 390. **Live (public key):** an empty day gives 47 700 s "no reading", a weekend gives 400. **Limits:** not yet on a real phone (P04-08); a day with readings in several levels has only been seen in the gate mocks and the backend test; the view opens on the last school day before 6:00 AM (my choice, not in the mocks).
- [x] P04-08 Looked at in a real browser and on a real phone, with screenshots free of personal data — PROG: s20/s21 Chrome install check, Lighthouse (SEO 91 before the meta description), light-mode home in Chromium, owner phone screenshots (dark: home, 24 h history, school day). s31 (2026-11-04, owner's two iPhone screenshots, not stored): the **Init icon is on the iPhone Home Screen** (added to Home Screen, Init logo icon and name "Init"), and the hosted home page in Safari (dark) shows Room Unassigned, Online, heat index 38 °C Extreme caution, 33.3 °C, 53 %, updated just now, School day summary row. Then two more screenshots (14:27 and 14:28) with the app **opened from the Home Screen icon: full screen, no Safari address bar** (the installed mode iPhone push needs): home (37 °C Extreme caution, 33.5 °C, 50 %, Online) and `#school` for Wed 4 Nov with **several levels** (Highest 46 °C at 10:42 AM, hottest hour 43 °C 10:00 to 11:00 AM, lowest 32 °C, average 37 °C; level bar in three colours; Danger 1 h 26 min). iPhone add-to-home-screen and a school day in several levels: done (s31). s32 (2026-11-05 02:53Z): **Lighthouse 12.6.1 re-run** on the hosted home page (mobile defaults, throttled, headless Playwright Chromium): Performance 85, Accessibility 100, Best Practices 100, SEO 100; FCP 2.1 s, LCP 3.6 s, TBT 110 ms, CLS 0.082 (report JSON kept in the session scratchpad only). Also s32: the Android installed app received a real push alert (see P05-03). **s33 (2026-11-05, owner's four Android screenshots, 22:55 to 22:57 local, light mode, not stored, no personal data):** home online (Room Unassigned, green Online, Heat index 31 °C Caution, 28.5 °C, 63 %, updated just now, School day summary and Heat alerts rows, History buttons); `#alerts` ("Heat alerts are on for this phone", 42 °C Danger, 60 min reminder, Stop alerts); **Offline** after unplugging the board ("Offline: no reading for 2 min" in red with an X icon, "Last heat index" 33 °C Extreme caution kept, 28.9 °C, 70 %, "last reading 2 min ago"); **back Online** after plugging in (33 °C Extreme caution, 29.2 °C, 68 %, updated just now). No horizontal scroll, text readable, status shown by icon and words, not colour alone. Offline page and light mode on a phone: done.
