CodenameTempest14/init-heat-monitoring/documentation/phases/phase-03-firmware.md

# Phase 3 — Device firmware

**Objective:** Firmware that stays awake (D-018), reads the sensor on an interval, shows it on the OLED and uploads over the hotspot.
**Entry criteria:** P01 and P02 closed.
**Exit criteria:** The device runs a full day on the power bank and every reading reaches the backend.
**Features:** F-08, F-11, D-011. Model: Sonnet 5.5 (Opus 5.5 for the key handling and setup page).

Checklist markers: see phase-01.

## OLED design canvas (D-022, owner approved the placement 2026-10-31)
Same method as the web canvas (D-016). Must be finished and approved before P03-04 draws anything on the real OLED.
- [x] P03-D1 `design/oled/` entry with README: screen list taken from the approved features (F-08, plus the offline / setup states of F-03 and D-011), and a small spec of the 128×64 grid, fonts (open-source pixel fonts only, D-010) and sizes
  - Evidence (s09, 2026-11-01): `design/oled/README.md` has the grid, font and the screen list with the source feature of each; `node tools/check-readmes.mjs` passes. The three open questions were answered by the owner (D-025).
- [x] P03-D2 A 1:1 reference image (128×64, monochrome) of each screen with made-up readings; the owner approves them
  - Images made s09 (2026-11-01): `design/oled/ref/` 9 images from `node design/oled/build-refs.mjs`, looked at in the 4× previews. **Owner approved all 9 screens, whole-degree heat index and the setup names on 2026-11-01** (D-025).
- [x] P03-D3 OLED-GATE: the screen drawing code is checked against the approved image (rendered on the PC or photographed on the device), and the check is shown to fail on a deliberate mismatch
  - Evidence (s09): `tests/oled.test.js` (4 tests, red first: module missing) compares every screen with its `ref/` PNG pixel for pixel; shown to fail on a flipped pixel, a different number and the wrong image. Mutation of the real code (footer moved 1 px) made 2 tests fail with 185 differing pixels; restored, 4/4 pass; `npm test` 18/18. Decoder also checked on a PNG re-encoded by Pillow (0 differences). This is the PC render. The same check on the photographed real OLED is done when P03-04 draws on the device.

## Build
- [x] P03-01 PlatformIO project builds; `secrets.h` is gitignored
  - Evidence (s10, 2026-11-02): `firmware/init/`, `pio run` ends `[SUCCESS]` (222 s first build; RAM 6.7%, flash 22.9%), platform espressif32@6.9.0 and the 5 libraries pinned. `git check-ignore -v firmware/init/include/secrets.h` shows `.gitignore:6:secrets.h`; only `secrets.h.example` is committed. Not run on the board: the skeleton is only built, not flashed.
  - Run on the board (s11, 2026-11-02): flashed from `firmware/init` (log shows `Espressif 32 (6.9.0)`, owner held BOOT). Owner saw "Init" on the OLED. Serial read by the assistant on COM8: `T=28.4 H=64.5`, one line every 2.00 s (timestamps 1.71, 3.72, 5.72, 7.73, 9.73, 11.74 s). A first upload from the VS Code toolbar had flashed `bench` by mistake (serial showed `nets=`); now documented in `firmware/README.md`.
- [x] P03-02 Connects through the hotspot and an HTTPS upload is accepted by the backend; the server certificate is checked (root CA in the firmware, no `setInsecure()`, SECURITY_REVIEW S-11), and an upload to a server with the wrong certificate is shown to fail
  - Evidence (s11, 2026-11-02, real board through the owner's hotspot, project init-test per D-026): serial `upload 2026-11-01T18:16:16Z T=28.4 H=64.5 -> 200 {"saved": 1, "duplicates": 0}` and again at 18:17:16. Server query: rows from device "Room 1" at 18:15:16, 18:16:16, 18:17:16 (28.4 to 28.5 °C, 64.5 to 64.6 %), heat index 30.7 = `src/heat-index.js` 30.66. Wrong certificate: build `esp32dev_wrongca` (trusts only ISRG Root X1) logged `(-9984) X509 - Certificate verification failed` at 18:30:46 and 18:31:46, `-> -1`; on the server the newest row stayed 18:28:17 (the good build's last one before the reflash) and `last_seen_at` stayed 18:28:20. PC precheck with `openssl s_client -CAfile`: the 3-root bundle verifies (0 ok), ISRG X1 alone fails (20). Roots in `include/root_ca.h`, GTS R1/R4 byte-identical between pki.goog and the system CA bundle.
- [x] P03-03 Always-awake loop (D-018): reads and uploads on the interval, interval read from the settings, and the bank stays on through the gaps between sends
  - Evidence (s12, 2026-11-02, real board, project init-test per D-026): backend tests 47/47 (2 new for `interval_s` seen red first, then green after migration `20261102120000_ingest_returns_interval.sql`); PC test `firmware/init/tests/interval_test.cpp` passes and fails when the wrap-around handling is broken. On USB, serial: `-> 200 {... "interval_s": 90}`, `interval 60 s -> 90 s`, uploads at 10, 100, 190, 280 s; after the server value was set to 60: `interval_s: 60`, uploads 60 s apart. On the ROMOSS bank (owner, 3:11 to 3:21 AM): at 90 s the bank switched itself off after about a minute (OLED dark; server gaps 71 to 153 s from restarts); at 60 s the server shows uploads exactly 60 s apart from 19:12:33 to 19:20:33Z (9 min, no gap), owner confirms the board was still on at 10 min. **Limits:** only 10 minutes on the bank (the full day is P07/P03-07); the bank needs an upload at least every ~60 s (see D-027); not applied to live `init` yet.
- [x] P03-04 OLED shows temperature, humidity and heat index and stays on (D-025); the wake button is added when a button is bought (F-08)
  - Evidence (s13, 2026-11-02, real board): (1) Heat index in C++ (`include/heat_index.h`): `tests/firmware-heat-index.test.js` builds the PC test and matches `src/heat-index.js` and the shared reference JSON on about 20 000 points (1e-9); red first (header missing), and a changed coefficient made it fail. (2) OLED-GATE on the real OLED: build `esp32dev_screens` printed the display's frame buffer; `node design/oled/check-dump.mjs` said all 9 screens equal `design/oled/ref/*.png` pixel for pixel (reader has 4 tests, `tests/oled-dump.test.js`). Owner's photos of the real OLED show all 9 screens, the degree sign (`cp437`) and the size-4 digits clean. (3) Normal build back on the board: serial `upload ... T=29.7 H=70.8 -> 200 {... "interval_s": 60}` at 20:01:12 and 20:02:12Z (60 s apart); init-test has the rows for "Room 1" (newest 20:07:13Z, 66 rows) with heat index 34.1 at 29.5 °C / 71 %. Owner read the real OLED: `29.5°C`, `RH 71%`, big `34` = heat index, matching the server row. `npm test` 33/33. **Limits:** the sensor-error and offline screens were checked in the screens build only, not provoked on the normal build; offline shows no `to send` count until P03-06; the strip says `Room 1` from `config.h` (the device does not know its room); the display refreshes every 5 s; Wi-Fi retries still block the loop up to 20 s.
- [x] P03-05 Setup page opens when Wi-Fi fails, and credentials can be changed from a phone (D-011)
  - Built (s14, 2026-11-02): owner approved the page design (`design/device-setup/`, 3 states, title centred) and chose setup at start-up only and a WPA2 setup network. `include/wifi_setup.h`: `wifiCheck` rules, `htmlEscape`, the pages. PC tests seen red first (header missing): `wifi_setup_test.cpp` and `tests/firmware-setup-page.test.js` (firmware pages equal the approved HTML byte for byte); mutations caught: `"` escape removed (2 checks), 7-character passwords allowed (1), one letter of the page changed (page test). `npm test` 38/38. `pio run` for all 3 envs: SUCCESS (RAM 19.3%, flash 76.9%). Hotspot Wi-Fi moved from `secrets.h` to flash (Preferences); `SECRET_SETUP_PASS` added locally.
  - Run on the board (s14, 2026-11-02, owner's Android phone, init-test per D-026): (1) flashed with nothing saved: OLED showed SETUP MODE; the phone joined `Init-Setup` with the WPA2 password and Android opened the page by itself ("Sign in to Init-Setup", captive portal); owner's screenshots show the approved dark page, centred title, "Saved network: none", the nearby-network suggestions (▼). (2) Saved the owner's hotspot: the "Saved" page, then the device restarted and joined it: init-test rows for "Room 1" stop at 05:57:48Z (old firmware) and restart at 06:02:52Z, one a minute (31.3 °C, 57.4 %, heat index 34.8). (3) Power cut with the hotspot on: rows stop 06:06:52Z, restart 06:10:25Z with no setup screen (the saved network survived in flash). (4) Hotspot off and restart: SETUP MODE after about 20 s; the page said "Saved network:" with the owner's hotspot name; password `12345` gave the orange "Not saved: the password must be 8 to 63 characters…" with the name kept and the password field empty (owner's screenshot). (5) Hotspot back on and restart: rows again from 06:21:01Z. **Limits:** the serial capture failed (my reading loop repeated text), so the `setup: refused` / `saved` serial lines were not seen; the 10-minute setup timeout was not waited out; only Android was tried (not iPhone) and only dark mode on the phone; the device takes no readings while in setup mode (no clock).
  - Logo on the setup page (s15, 2026-11-02, owner's Android phone, dark mode, init-test): owner approved the icon; titles `Init Setup` and `Saved` (all capitals rejected as ugly). Page test red first, then green; `npm test` 38/38; `pio run` SUCCESS (flash 77.0 %). Owner's screenshots at 15:01 and 15:02: the form with the Init icon centred above `Init Setup`, the saved network name, the empty password field; then the `Saved` page with the icon. Server: after the 06:51:04Z reading, rows resume at 07:02:24Z and 07:03:24Z (60 s apart). **Limits:** only Android in dark mode; light mode on the phone and iPhone not tried.
- [x] P03-06 Offline buffer keeps readings while the hotspot is down and uploads them later (F-11)
  - Evidence (s13, 2026-11-02, real board, init-test per D-026): `include/readings.h` (ring buffer of 300 readings in RAM, batches of 50, upload body) with `firmware/init/tests/readings_test.cpp` (run by `npm test`, 36/36), seen red first (header missing); breaking the drop-oldest rule made 2 checks fail. Board: owner turned the hotspot off at about 05:18 and on at about 05:23Z. While off the OLED said `NO WI-FI`, kept updating, and showed `2 to send` growing by one a minute; after it came back the OLED showed `Wi-Fi OK` and the `to send` line disappeared. Server (`received_at` against `recorded_at`): the 5 readings measured 05:18:45, 05:19:46, 05:20:46, 05:21:46, 05:22:46 were all received at 05:23:01 (15 to 256 s late, original times kept); live rows before and after arrive about 4 s after measurement; one reading per minute, no gap. The serial port was not opened during the test (opening it can reset the board and wipe the RAM queue). The loop no longer blocks on Wi-Fi (reconnect attempt every 15 s, send retry every 35 s). `pio run` for all 3 envs: SUCCESS. **Limits:** the queue is RAM only (a restart loses it; cap 300 = 5 hours, oldest dropped first); a device that boots with no Wi-Fi has no clock and queues nothing until the first time sync; not tried on the board: a queue longer than 50 (several batches), a full queue, the 400-drop path, the sensor-error screen while offline; a send attempt can still block the loop for the HTTP timeout (about 5 s) when the server is unreachable.
- [x] P03-07 24-hour run on the power bank; measured battery drop recorded
  - Evidence (s25, 2026-11-03, real board on the ROMOSS bank only, init-test): two legs, 10:03:55Z to 22:02:44Z (the owner cut power at 06:03 local, 12 h) and 22:09:08Z to 10:08:14Z (second leg), 7 min break between. In the window 10:03Z to 10:03Z the server holds 1 429 rows of about 1 440 (99.2 %). Gaps over 90 s: 221 s (ends 16:19:12Z), 385 s (the break, ends 22:09:08Z), 95 s (ends 09:33:47Z); causes not confirmed (the 16:15Z one looks like a reboot). **Battery drop: 100 % to 95 % after the first 12 h to 90 % at the end (owner's photos, the second read as 90 % by the owner): about 10 points in about 24 h of running.** Not shown: the 2 min offline rule (the owner's offline screenshot came about 3 h after unplugging).
