CodenameTempest14/init-heat-monitoring/documentation/phases/phase-02-backend.md

# Phase 2 — Backend and secure upload

**Objective:** A Supabase backend that stores readings, lets anyone read them, and accepts writes only from the device and the admin, validated on the server.
**Entry criteria:** P01 closed.
**Exit criteria:** A fake device can post readings with a key; bad or unauthenticated posts are rejected; anonymous users can read but not write.
**Features:** F-06, F-07, F-20, F-21 (room data). Model: Opus 5.5 (security design).

**Live `init` project (2026-10-31 s08):** the owner approved and ran `tools/db.mjs live db push` and `tools/device-key.mjs register live "Init 1"` (Claude Code's auto-mode classifier blocks production deploys from the assistant). Checked by me from outside: `migration list` shows all 5 migrations local = remote; `device_status` = one device "Init 1", room "Unassigned", default settings row; its `key_hash` equals the SHA-256 of `.env` `DEVICE_KEY` (compared in SQL, only the boolean printed); anon insert into `readings` 42501, anon read of `key_hash` 42501, anon `rollup_old_readings` 42501, wrong-key ingest 403 `bad_key`; `cron.job` `rollup-old-readings` active at `30 18 * * *`; advisor: only the accepted S-1 warning. Not run on live: a real accepted upload (would put a fake reading in the live history; the device's first upload in P03-02 proves it).

Checklist markers: see phase-01.

- [x] P02-01 Schema (readings, device, settings) designed and approved by the owner — evidence 2026-10-31 s07: `documentation/specs/SCHEMA.md` written, changed at the owner's request (server-side heat index, hourly maxima with time, D-023), owner replied "yes" to the final version. Design only; nothing built on Supabase yet.
- [x] P02-02 Row-level rules: public read-only; an anonymous write attempt is tried and denied — evidence 2026-10-31 s07: `tests/backend/access.backend.js` written first and run against `init-test`: 8/8 failed with PGRST205 (no tables). Migration `20261031120000_core_schema.sql` pushed to `init-test` only, then 9/9 pass (anon read 200; anon insert/update/delete and reading `devices.key_hash` all denied with 42501; a row written with the secret key is visible to anon). Supabase security advisor: 0 findings. NOT yet applied to the live `init` project.
- [x] P02-03 Device key issued; it is not in the repository — evidence 2026-10-31 s07: `node tools/device-key.mjs new` wrote a 32-byte random `DEVICE_KEY` to `.env` (gitignored, `git check-ignore .env` confirms); `register test "Room 1"` stored only its SHA-256 (802a356c2340…) on `init-test`, run twice → still 1 device, hash matches, default settings row. `git grep` for the key finds nothing. Live `init` registration waits for the live migration; the key moves into `secrets.h` in P03-01.
- [x] P02-04 Ingest checks value ranges, timestamp and rate; tests prove bad payloads are rejected — evidence 2026-10-31 s07: `tests/backend/ingest.backend.js` (24 tests) and `heat-index-sql.backend.js` (6) written first; red run 30 fail with PGRST202 (no functions), 11 access tests pass. Migrations `20261031140000_ingest.sql` and `20261031150000_ingest_anon_only.sql` pushed to `init-test`; then 41/41 pass, twice. SQL heat index equals the JS on 273 grid points (200 non-null) within 1e-9; a deliberately wrong chart value made that test fail (file restored). Every rejection test also checks nothing was saved. Advisor: 1 accepted warning (anon may run `ingest_reading`, intended; for P02-06). NOT yet on live `init`.
- [x] P02-05 Retention: raw readings kept 90 days, then hourly averages (F-20) — evidence 2026-10-31 s08: `tests/backend/retention.backend.js` written first; red run 3/3 fail with PGRST202 (no function). Migration `20261031160000_retention.sql` (`rollup_old_readings`, one DELETE…RETURNING → INSERT statement, cut-off = start of the UTC hour 90 days ago; `pg_cron` job daily 18:30 UTC) pushed to `init-test` only; 3/3 pass. Added a "whole hours only" test; mutation check (job swapped on `init-test` for a copy without the hour rounding) made exactly that test fail, restored from the migration text, 4/4 pass. Values checked against hand-computed rows (avg, min, max, earliest max time on a tie, null heat index hour); 89-day-old reading untouched; second run `{hours:0, deleted:0}`; an already-rolled hour makes the job fail with 23505 and delete nothing; anon gets 42501. `cron.job` row read back: active, `30 18 * * *`, user postgres; `cron.timezone` GMT. `npm run test:backend` 44/44 twice, `npm test` 14/14. Advisor: only the accepted `ingest_reading` warning. The scheduled run itself has not fired yet (first at 18:30 UTC). NOT yet on live `init`.
- [x] P02-06 Security review of the backend, findings recorded — evidence 2026-10-31 s08: `documentation/specs/SECURITY_REVIEW.md`, 11 findings. Checked by running, not from memory: advisor (1 accepted warning); both projects' auth settings read (sign-ups open → S-4) and SSL setting read (not enforced → S-5) via the read-only Management API; public-key probes on `init-test` (`heat_index_c` 42501, `cron` schema PGRST106, `key_hash` 42501, max_rows 1000); every `.env` secret value searched literally across all 36 commits plus key/JWT/password patterns: none found, control string found; the single `postgres://` pattern hit is the code template in `device-key.mjs`. Rules carried forward: migration access rule (S-7, migrations README), device TLS check in P03-02 (S-11), admin-by-name in P05 (S-4), no people's names in room names (S-10). Open owner actions S-4, S-5, S-6 (dashboard settings; the token is read-only on purpose).
- [x] P02-07 Room assignment data (F-21, D-024): device has a `room`, readings and hourly rows keep the room they were taken in; the public can read the room but not change it — evidence 2026-10-31 s08: the last open part passes: in `retention.backend.js` an hour in which the device moved from Room 204 to Room 105 becomes two hourly rows, each with its own room and values. History: 2026-10-31 s07: room tests written first (4 failed on the missing column), migration `20261031130000_device_room.sql` pushed to `init-test`, 11/11 pass, advisor 0 findings. Still open: the "old readings keep their room after a move" test needs `ingest_reading` (P02-04). Update s07: that test now passes (`ingest.backend.js`, "a moved device"). Still open: hourly rows keep the room, checked with the retention job (P02-05).
