CodenameTempest14/init-heat-monitoring/hardware/schematic.html

Rev B · 2026-10-30 · one room · power bank

# Classroom Heat Monitor: hardware schematic

ESP32 reads a DHT22 once per wake-up, shows the result on an OLED for a few seconds, sends it over Wi-Fi, then deep-sleeps. A USB power bank feeds the board's USB port directly: no battery pack, protection board or converter to build.

Status: drafted, not yet built or measured on real hardware. Rev B replaces Rev A (2S 18650 cells + buck converter).

Read before you wire anything

- The power bank may switch itself off when the load is tiny (deep sleep draws only about 10 mA). Test this first, with the bare board (bring-up step 1), before building the rest.
- Use a data-capable USB cable, USB-A on the power bank side. Flash from the PC first, then move the cable to the power bank: one USB source at a time.
- Your ESP32 board's pin positions may differ from other ESP32 boards. Match the GPIO numbers printed on the board, not the position in this drawing.
- Keep the power bank out of direct sun and away from the DHT22: a warm bank heats the sensor reading, and Li-ion packs should not sit above about 45 °C.

## Schematic

The power bank (orange) feeds the ESP32 through its USB port; the board's own regulator makes 3.3 V. Everything else hangs off the ESP32's 3V3 pin (violet), with signals in blue. All ground symbols are one net.

USB 5 V3.3 Vsignalground

## DHT22 on the breadboard

Each of the four sensor pins sits in its own column of connected holes. Everything drawn in the same column is joined. The 10 kΩ resistor R1 is a pull-up: it goes from the DATA column to the 3V3 rail, and it is not in the DATA wire.

Blue: the DATA column. Its two jobs are the direct wire to GPIO4 and the 10 kΩ pull-up to the 3V3 rail. Violet: 3.3 V. Grey: ground.

## Parts list

Ref | Part | Qty | Notes
U2 | ESP32 DevKit, 38-pin (slim body, fits a breadboard), ESP32-WROOM-32 | 1 | Powered through its Type-C USB port (owner confirmed). GPIO4, 21, 22 and 33 all exist on the 38-pin layout.
U3 | DHT22 (AM2302), 4-pin | 1 | Pins from the left with the grille facing you: 1 VCC, 2 DATA, 3 NC, 4 GND. If you have the 3-pin module version, R1 is already on it, so leave R1 out.
U4 | OLED 0.96″ 128×64 (listed as "128x63"), I²C, SSD1306, 4-pin | 1 | SSD1306 panels are 128×64. Has its own I²C pull-ups. Powered from 3V3. Pin order, owner confirmed: GND, VCC, SCK (= SCL), SDA, which matches the drawing.
PB1 | ROMOSS Sense 8P+ power bank, 30 000 mAh (111 Wh), 5 V 3 A output (owner's bank) | 1 | Built-in protection. A low-current mode is documented for other ROMOSS models, not confirmed for the 8P+: check its manual, and test (bring-up step 1). Use its 5 V USB-A port. The 9 V / 12 V outputs are not needed.
– | USB cable, data-capable, short | 1 | USB-A (power bank) to your board's connector. Prefer A-to-C over C-to-C: some cheap boards lack the CC resistors and a C-to-C cable gives no power.
SW2 | Tactile push button | 1 | Optional. Wakes the display.
R1, R2 | 10 kΩ resistor, 1/4 W | 2 | R1: DHT22 data pull-up. R2: button pull-up.
C3, C4 | 100 nF ceramic | 2 | C3: DHT22 supply. C4: button debounce.
C1 | 220–470 µF electrolytic | 0–1 | Optional, only if Wi-Fi bursts cause resets. Between 3V3 and GND, close to the ESP32, long leg to 3V3.
– | Perfboard or breadboard, dupont wire, enclosure, heat-shrink | 1 set | Mount the DHT22 outside or at a vent, away from the ESP32 and the power bank, which both give off heat.

## Wire list

# | From | To

1 | PB1 USB-A output | USB cable → ESP32 USB port
2 | ESP32 3V3 pin | DHT22 pin 1, R1, R2, C3, OLED VCC (use one breadboard rail)
3 | DHT22 pin 2 (DATA) | ESP32 GPIO4 (direct wire); R1 from the pin 2 column to the 3V3 rail (pull-up, not in series)
4 | DHT22 pin 4 | GND; C3 between pin 1 and pin 4
5 | ESP32 GPIO21 / GPIO22 | OLED SDA / OLED SCL; OLED GND to GND
6 | ESP32 GPIO33 | SW2 to GND; R2 from GPIO33 to 3V3; C4 across SW2

## Bring-up order

- Power bank test first. Plug the bare ESP32 board into the power bank with an inline USB meter. Note the idle current and leave it for an hour: does the bank stay on? A bank that switches off at low current can't be used with deep sleep (see Runtime estimate).
- With the board powered from the bank, measure the 3V3 pin: it should read 3.3 V.
- Unplug USB. Add the DHT22, OLED, button and the 3V3 / GND wires per the wire list.
- Flash the firmware from the PC over USB, then move the cable to the power bank. One USB source at a time.
- Run it for a day on the bank and compare the measured drop with the estimate.

## Runtime estimate

Rough figures from datasheet-class numbers, not measured on your build. The 30 000 mAh label means 111 Wh in the cells; after boost losses expect about 18 000 mAh at 5 V, and less if the bank is warm or old. This assumes the bank stays switched on at the tiny current of deep sleep, which must be tested.

Mode | Average draw | Estimated life (18 000 mAh at 5 V)
Deep sleep, wake every 5 min (6 s awake) | about 13 mA | about 8 weeks
Deep sleep, wake every 15 min | about 11 mA | about 9 weeks
No sleep, Wi-Fi kept connected (fallback if the bank turns itself off) | about 90 mA | about 8 days

The devkit's regulator and USB chip draw most of the sleep current (about 8–10 mA). A low-power ESP32 board would stretch this further. Measure real current with an inline USB meter before trusting any number here.

## Open items

  - The classroom has no Wi-Fi. The device needs a pocket 4G router or phone hotspot nearby (D-004). The ESP32 stays a Wi-Fi client.
  - Power bank auto-off is untested. The ROMOSS Sense 8P+ must be tested with the bare board at low load (bring-up step 1) before anything else is built. Look in its manual for a low-current mode.
  - Cable: the bank has a USB-A port and your board is Type-C, so use a USB-A to Type-C data cable. Avoid C-to-C with this bank: it may try to negotiate 9 V / 12 V, and a board without proper CC resistors gets no power at all.
  - Heat index is only meaningful above about 27 °C and 40 % RH. The DHT22 is accurate to about ±0.5 °C and ±2–5 % RH, so the displayed value is an estimate.
