CodenameTempest14/init-heat-monitoring/design/school-day/school-day.html

# Init: Indoor Heat Index Tracker

Room: Room 204

✓ EnglishFilipino

Online

‹ Live readings

## School day

Fri 30 Oct · 6:00 AM to 7:15 PM

‹ Thu 29 Oct Mon 2 Nov ›

Highest

43 °Cat 1:20 PM

Hottest hour

42 °C average1:00 to 2:00 PM

Lowest

27 °Cat 6:20 AM

Average

37 °C

Heat index. Moments below its calculation range (about 27 °C) are left out of these four.

### Time in each level

- Extreme danger0 min
- Danger3 h 20 min
- Extreme caution6 h 20 min
- Caution2 h 30 min
- Below heat-index range20 min
- No reading45 min
