CodenameTempest14/init-heat-monitoring/design/school-day/school-today.html

# Init: Indoor Heat Index Tracker

Room: Room 204

✓ EnglishFilipino

Online

‹ Live readings

## School day

Today, Mon 2 Nov · 6:00 AM to now (2:42 PM)

‹ Fri 30 Oct Next ›

Highest

42 °Cat 1:15 PM

Hottest hour

41 °C average1:00 to 2:00 PM

Lowest

27 °Cat 6:20 AM

Average

36 °C

Heat index. Moments below its calculation range (about 27 °C) are left out of these four.

### Time in each level

- Extreme danger0 min
- Danger1 h 20 min
- Extreme caution4 h 20 min
- Caution2 h 30 min
- Below heat-index range20 min
- No reading12 min
