CodenameTempest14/init-heat-monitoring/design/qr-kiosk/kiosk.html

● Online

Room 204

43°C

Danger

Temperature 34.1 °CHumidity 62 %

updated just now · init-heat-monitoring.vercel.app
