CodenameTempest14/init-heat-monitoring/design/qr-kiosk/poster.html

Print this page (hidden when printed)



# How hot is our classroom?

Scan to see the live heat index.

init-heat-monitoring.vercel.app

- Caution 27–32 °C
- Extreme caution 33–41 °C
- Danger 42–51 °C
- Extreme danger 52 °C +

Heat index levels are PAGASA's. Init is a school project, not an official service.
