CodenameTempest14/init-heat-monitoring/design/admin/admin-room-saved.html

# Init: Indoor Heat Index Tracker

‹ Live readings

## Admin

Signed in as admin@example.com Sign out

### Room

Where the device is now Use a room name such as Room 204. Do not use people's names. New readings get the new room; old readings keep theirs.

Save room Saved

### Device settings

Reporting interval (seconds) 60 to 3600. The device picks it up on its next upload.

On the power bank, keep it at 60 s. A longer gap can let the bank switch itself off.

Temperature offset (°C) −5.0 to +5.0

Humidity offset (%) −10.0 to +10.0

Offsets are added to new readings only, after a check against a reference thermometer.

Alert at heat index (°C) 42 = Danger

Quiet period (min) 10 to 1440

Heat alerts come in a later step; these two are stored now.

Save settings
