CodenameTempest14/init-heat-monitoring/design/brand/preview.html

# Init logo

## Chosen (D-029): B icon + A wordmark





 

  

# Earlier proposals

## A: Heat dots wordmark





 

## B: Thermometer-i icon + wordmark





 

## C: Heat index gauge + wordmark
