CodenameTempest14/init-heat-monitoring/design/admin/health/h-none.html

# Init: Indoor Heat Index Tracker

‹ Live readings

A

admin@example.comAdmin

Sign out

Room

Where the device is now

Reset

A room name only, never a person's name. Reset puts Unassigned in the box. Press Save to keep it. Old readings keep their room.

How? ›

Device health

Wi-Fi signalStronger is closer to 0

Not reported yet

Last restartWhy the device last started

Not reported yet

FirmwareVersion on the device

Not reported yet

This device has not sent its health yet. It does after its next firmware update.

How? ›

Device

Reporting interval60 to 3600

s

On the power bank keep it at 60 s, or the bank may switch off.

Temperature offset−5.0 to +5.0

°C

Humidity offset−10.0 to +10.0

%

How? ›

Heat alerts

Alert at heat index42 = Danger

°C

Quiet period10 to 1440

min

How? ›

Save changes
