CodenameTempest14/init-heat-monitoring/design/room-reset-readings/f24-readings.html

# Init: Indoor Heat Index Tracker

Room: Room 204

Online

Heat index

40°C

Extreme caution

What does this mean? ›

Temperature

32.2 °C

Humidity

68 %

updated just now

School day summary› Heat alerts›

## History

Last 24 hours Last 7 days

Touch or hover a chart to read the values at that time.

## Heat index °C

40 °C now

No line where the heat index is below its calculation range (about 27 °C).

## Temperature °C

32.2 °C now

## Humidity %

68 % now

Show as table

Time | Heat index °C | Temp °C | Humidity %

## Readings table

Hourly averages. Pick the days to show.

From

To

10 hours shown, newest first. Times are Philippine time.

Time / room | Temp | Humidity | Heat index / level
3 Nov, 16:00Room 204 | 32.0 °C | 58.1 % | 41 °CExtreme caution
3 Nov, 15:00Room 204 | 31.4 °C | 52.3 % | 35 °CExtreme caution
3 Nov, 14:00Room 204 | 32.1 °C | 52.8 % | 36 °CExtreme caution
3 Nov, 13:00Room 204 | 31.9 °C | 54.1 % | 36 °CExtreme caution
3 Nov, 12:00Room 204 | 31.7 °C | 55.3 % | 36 °CExtreme caution
3 Nov, 11:00Room 204 | 31.4 °C | 55.5 % | 35 °CExtreme caution
3 Nov, 10:00Room 204 | 31.2 °C | 57.8 % | 35 °CExtreme caution
3 Nov, 09:00Room 204 | 32.3 °C | 67.0 % | 44 °CDanger
3 Nov, 08:00Room 204 | 31.1 °C | 73.3 % | 41 °CExtreme caution
3 Nov, 03:00Room 204 | 24.6 °C | 72.3 % | —Below range

Download CSV
