CodenameTempest14/init-heat-monitoring/design/README.md

# design/

Everything visual that web pages are checked against (D-016, lightweight version of the Ad Astra technique).

| File | What |
|---|---|
| `pages.json` | Source of truth: one entry per page, with its template, source, licence and status |
| `REGISTRY.md` | Generated from `pages.json` by `node design/build-registry.mjs` |
| `tokens.json` | Colours (themes, heat categories with fill, text, border and label), type, spacing. Checked by `node design/contrast.mjs` |
| `contrast.mjs` | WCAG contrast check for the tokens; tested in `tests/contrast.test.js` |

| `templates/` | Reference screenshots of the chosen Tabler pages at phone and desktop width (P04-D4), made by `capture.mjs` |
| `ui-gate.mjs` | UI-GATE helpers: Playwright screenshot and image comparison (P04-D5), tested in `tests/ui-gate.test.js` |

`device-setup/` holds the ESP32 Wi-Fi setup page (D-011), approved 2026-11-02. `brand/` holds the logo and full-name proposals (not approved yet).

`oled/` holds the OLED screen canvas (D-022): screen list, grid and fonts now, reference images next. See `oled/README.md`.

Rules: no page is built without an Approved template; templates must be open source (D-010); colour is never the only signal; no real personal data in any image. The UI-GATE mechanism exists (P04-D5); it is pointed at app pages when they are built.
