CodenameTempest14/init-heat-monitoring/documentation/specs/README.md

# specs

Feature and design specs. `FEATURES.md` is the proposed feature list; nothing in it may be planned or built until the owner approves it item by item. `SCHEMA.md` is the backend schema for P02 (approved 2026-10-31). `SECURITY_REVIEW.md` is the P02-06 backend security review (findings S-1 to S-11, owner actions marked). `P04-01_PROPOSAL.md` is the app-skeleton and hosting proposal (s15, waiting for the owner). `P05-01_05_DESIGN.md` is the admin login and refusal-rule design (s22 draft, building starts s22 on the owner's go). `P05-03_DESIGN.md` is the heat-alert (web push) design (s30 draft, five DECIDEs and three new pieces waiting for the owner; nothing built).
