CodenameTempest14/init-heat-monitoring/paper/data/screens/README.md

# paper/data/screens/

Phone-sized screenshots used as Figures 7 to 10 of the paper (see `../README.md`). `home-online`, `home-offline` and `alerts` come from the owner's Android phone (light mode, 5 Nov 2026); `charts`, `readings`, `school`, `heat`, `guide`, `admin-signin` and `admin` are crops of the hosted pages taken with a 390 px browser (the admin ones with a made-up test account). No personal data.
