CodenameTempest14/init-heat-monitoring/documentation/phase-reports/phase-03-firmware/sessions/2026-11-03_s28_CLOSE.md

# Phase 03 — Session s28 — CLOSE — 2026-11-03

[P05 · Admin, alerts and device health · 4/7 done (+2 partly) · 0 blocked · unverified 0]

- **Status:** Completed (ended by the owner). **Phase builder:** owner only. **Model:** Sonnet 5.5.
- **Planned vs done:** planned phone results and ticks, paper, P04-08 leftovers. Done: phone and board results taken and recorded, P05-06 ticked; paper work (below). Not done: P04-08 leftovers, teacher review, more references, live admin rollout (next session, Opus 5.5).
- **Files changed:** `package.json` (`npm test` = whole suite in one process), `paper/` (`content.mjs`, `build.mjs`, `references.json`, `README.md`, new `chapter4.parked.txt`, the .docx and .pdf), `documentation/phases/phase-05-admin-alerts.md`, `documentation/specs/FEATURES.md`, `PROGRESS_LOG.md`, `CURRENT_STATE.md`, `NEXT_SESSION_PROMPT.md`.
- **Paper (rule 5), listed as required:** Petaca 2026 added as a reference (PAGASA's own slide deck; every slide looked at, tiers on slide 4); references now clickable bullets in alphabetical order (both DOIs checked in the DOI registry, other links opened); new Chapter 2 tables 2.3.1 Hardware Specifications (Table 2) and 2.3.2 Technology Stack (Table 3), later tables renumbered 4 to 7; section 2.5 queue sentence corrected (300 readings, batches of 50); F-23 and F-24 status lines updated; Chapter 4 parked at the owner's request. Names later given by the owner and filled in (2026-11-04): John Michael A. Ompad, Jelhay C. Pangatungan, Mark Jacob G. Butaya; adviser Arvin C. Trangia; Abuno High School. Two more references (Kirkil 2025, Wardani 2023, both opened and read; Cen et al. 2024 NOT added: ScienceDirect blocked me). Figure 7 (line graph, two panels) and its interpretation added to Chapter 3; the old hourly-pattern sentence was wrong and was rewritten. Only 7 verified references. **Reference gap:** the ESP32 datasheet (v5.3) and the DHT22 datasheet were read and their values are in Table 2 as "datasheet" values, but they are NOT in References because neither has a date I could confirm in 2021 to 2026. 
- **Checks run:** `npm test` 204/204 (whole suite, once, before the paper edits; no firmware or web change since); `node paper/build.mjs` after every paper edit, PDF pages 5, 6 and 13 looked at; `secret-scan` clean; README check clean; link checks (curl: DOIs resolve, 4 pages 200; the publisher page and eScholarship return 403 to scripts, the DOI registry data matches).
- **Verified (owner's screenshots, phone and real board, init-test):** room save shown on the OLED and the user page; Reset then Save back to `Unassigned` on both; OLED `Unassigned` after a restart; F-24 Readings table works on the hosted page (owner's word, no screenshot).
- **Unsure / not tried:** (0) The Figure 7 numbers come from `paper/data/hourly.json` (hourly values); the 10 °C drop at 10 to 11 PM has no recorded cause. The Wardani 2023 PDF was blocked, so only its article page and abstract were read. (1) Word file not opened in Word (only the PDF pages were looked at). (2) The F-24 table result rests on the owner's word. (3) The `npm test` change was not seen red first (script change). (4) The backend tests in the full suite wipe init-test readings. (5) The s27 PROGRESS_LOG entry was missing; added in this close. (6) The datasheet numbers come from manufacturer PDFs, not measured here.
- **Decisions / awaiting owner:** none new. Owner approved the commit and push to `codenametempest14` and `main` (`14acd27`). Awaiting: live admin email and password, teacher review, optional phone checks.
- **Next first step:** live admin rollout P05-05 (Opus 5.5), then P05-03 push alerts.
- **Recommended model for the next session:** **Opus 5.5** for P05-05 and P05-03; Sonnet 5.5 for paper and phone ticks.

## Phase Progress (HARD RULE 1)
```
| Phase | Done / Total | Progress | % |
|---|---|---|---|
| P00 Kickoff and decisions | 13 / 13 | ██████████ | 100% |
| P01 Heat index core and bench bring-up | 7 / 7 | ██████████ | 100% |
| P02 Backend and secure upload | 7 / 7 | ██████████ | 100% |
| P03 Device firmware | 10 / 10 | ██████████ | 100% |
| P04 Web app core | 12 / 13 (+1 partly) | █████████░ | 92% |
| P05 Admin, alerts and device health | 4 / 7 (+2 partly) | ██████░░░░ | 57% |
| P06 Display and sharing extras | 0 / 5 | ░░░░░░░░░░ | 0% |
| P07 Field trial and hardening | 0 / 7 | ░░░░░░░░░░ | 0% |
| P08 Over-the-air updates (optional) | 0 / 3 | ░░░░░░░░░░ | 0% |
| **Whole project** | 53 / 72 | ███████░░░ | **74%** |
```

## Continuation prompt (HARD RULE 2)
`documentation/context/NEXT_SESSION_PROMPT.md`, generated by `node tools/continuation-prompt.mjs`; shown in the final message.
