CodenameTempest14/init-heat-monitoring/documentation/phase-reports/phase-03-firmware/sessions/2026-11-03_s27_CLOSE.md

# Phase 03 — Session s27 — CLOSE — 2026-11-03

[P03 · Device firmware · 10/10 done · 0 blocked · unverified 0]

- **Status:** Completed (ended by the owner). **Phase builder:** owner only. **Model:** Sonnet 5.5.
- **Planned vs done:** planned F-23, real admin saves, P04-08. Done: new hard rule 5 and the whole research paper (`paper/`), F-23 and F-24 designed, approved, built test-first and deployed to the test and live databases. Not done: real saves on the phone, P04-08 leftovers, ticks (nothing was seen on a phone yet).
- **Files changed:** `CLAUDE.md` (rule 5), `paper/` (new: `content.mjs`, `diagrams.mjs`, `build.mjs`, `fetch-data.mjs`, `references.json`, `data/`, the .docx and .pdf), `web/src/{Admin.jsx,admin.js,admin.css,Guide.jsx,App.jsx,main.jsx}` and new `Readings.jsx`, `readings.js`, `readings.css`, `supabase/migrations/20261107120000_readings_hourly.sql`, `firmware/init/include/config.h` (default room `Unassigned`), `design/room-reset-readings/` (new), redrawn mocks and approved images (`design/admin/*`, `design/history-charts/`, `design/admin-guide/`), tests (`web-admin`, new `web-readings`, `ui-gate-admin`, `ui-gate-history`, `backend/admin`, new `backend/readings-hourly`), `documentation/` (DECISIONS D-035 to D-037, FEATURES, `specs/F23_F24_DESIGN.md`, PROGRESS_LOG, CURRENT_STATE), `.gitignore`, `package.json` (docx 9.5.0).
- **Checks run:** `node --env-file=.env --test --test-concurrency=1` 204/204; backend alone 80/80; UI gates each alone: home 12, badge 9, school 14, guide 6, heat 10, admin 20, history 17 (all 0 differing pixels); `pio run` SUCCESS (firmware builds; the owner flashed it); `anon-probe` against live 21/21; read-only SQL on live (functions and tables exist) and on init-test (device uploading, last seen 6 s, POWERON, -57 dBm); public-key calls on live (`readings_span`, `readings_hourly` with page_size 501 refused); a real-data screenshot of the built page against init-test (22 hours shown); PDF pages 1, 5 and 11 of the paper looked at; `secret-scan` clean; README check clean.
- **Verified:** F-24 database functions and page against real init-test data; the live migrations exist and the stranger probe passes on live. **Not verified:** F-23 and F-24 on a phone or on the hosted page; the OLED showing `Unassigned`; the Word file opened in Word (only the PDF was looked at).
- **Unsure / not tried:** (1) the first run of the new F-24 backend tests failed for a helper typo (`remove`, not `cleanup`), so I never saw them red for the right reason. (2) If a page of hourly rows ends between two rooms of the same hour, the second room's row is skipped. (3) The paper has only 4 verified references (Lu and Romps 2022, Widjaja et al. 2022, PAGASA 2024 statement, ADB working paper 2026); the PAGASA tier ranges have no readable PAGASA source and are cited only as D-019; a Romps and Lu 2022 paper was dropped because I could not confirm what it says. A subagent read two of the pages; the others I read myself. (4) The paper's researcher, coach and school names are blank placeholders. (5) The firmware version stayed 0.6.0, so the server cannot tell the new build from the old. (6) Mistake: `paper/build.mjs` used `URL.pathname` and wrote a stray folder `D:\System%20Documents` (owner deleted it; fixed with `fileURLToPath`).
- **Decisions / awaiting owner:** D-035 (F-23), D-036 (F-24), D-037 (paper and reference rule), all approved by the owner. Owner approved the commit and push to `codenametempest14` and `main`. Awaiting: phone checks, names for the paper, a PAGASA table source, teacher review of the Reset sentence, a live admin account.
- **Next first step:** ask the phase-builder question; ask the three phone and OLED results; tick what was seen; update the paper; then P04-08 leftovers and the live admin rollout (Opus 5.5).
- **Recommended model for the next session:** Sonnet 5.5 (phone results, paper, P04-08); Opus 5.5 for the live admin rollout (P05-05) and push alerts (P05-03).

## Phase Progress (HARD RULE 1)
```
| Phase | Done / Total | Progress | % |
|---|---|---|---|
| P00 Kickoff and decisions | 13 / 13 | ██████████ | 100% |
| P01 Heat index core and bench bring-up | 7 / 7 | ██████████ | 100% |
| P02 Backend and secure upload | 7 / 7 | ██████████ | 100% |
| P03 Device firmware | 10 / 10 | ██████████ | 100% |
| P04 Web app core | 12 / 13 (+1 partly) | █████████░ | 92% |
| P05 Admin, alerts and device health | 3 / 7 (+3 partly) | ████░░░░░░ | 43% |
| P06 Display and sharing extras | 0 / 5 | ░░░░░░░░░░ | 0% |
| P07 Field trial and hardening | 0 / 7 | ░░░░░░░░░░ | 0% |
| P08 Over-the-air updates (optional) | 0 / 3 | ░░░░░░░░░░ | 0% |
| **Whole project** | 52 / 72 | ███████░░░ | **72%** |
```

## Continuation prompt (HARD RULE 2)
`documentation/context/NEXT_SESSION_PROMPT.md`, generated by `node tools/continuation-prompt.mjs`; shown in the final message.
