CodenameTempest14/init-heat-monitoring/documentation/phase-reports/phase-03-firmware/sessions/2026-11-02_s24_CLOSE.md

# Phase 03 — Session s24 — CLOSE — 2026-11-02

[P03 · Device firmware · 9/10 done · 0 blocked · unverified 0]
(The one unverified change is still the 2 min offline rule inside the ticked P04-03; the tool does not count it.)

- **Status:** Completed. Short Q&A session (22:52 to about 23:35 local) during the 24 h run (P03-07, ends 2026-11-03 10:03Z = 18:03 local). The run was never touched: at 15:32Z 329 rows, no gap over 64 s, newest row seconds old.
- **Phase builder:** owner only (answered s24). **Model:** Sonnet 5.5.
- **Planned vs done:** no build planned. The owner sent phone screenshots and asked questions; answered from the repo (no files read beyond CURRENT_STATE.md, one grep for "offset").
- **Files changed:** this close report, `CURRENT_STATE.md`, `PROGRESS_LOG.md`, `NEXT_SESSION_PROMPT.md`. No code.
- **Build, tests and checks run:** read-only SQL on init-test for the run (row count, gaps); `node tools/phase-report.mjs`. No tests (they wipe init-test during the run), nothing on live.
- **Unverified changes (at most 1):** 1, the 2 min offline rule (unchanged).
- **Commits:** the s24 close commit (local; ask before pushing).
- **Owner screenshots (light mode, Android, Brave), looked at, no defect:** `#admin` sign-in, the wrong-password message, signed in, and the whole guide (22:55-22:56); home page with three charts and the finished school day for Mon 2 Nov (23:08). The school-day numbers add up (5 h 47 min + 7 h 28 min = 13 h 15 min = 6:00 AM to 7:15 PM). Light mode on the phone is now seen for home, history, school day, admin and guide.
- **Answers given to the owner (nothing built):** (1) `#admin` is a route of the same app at the same address, so the installed app has it, but it needs its own sign-in (separate storage from Brave) and the hosted app reads init-test, so the test admin controls "Room 1". (2) No new firmware is needed for the admin: the board already takes `interval_s` (D-027) and the room (D-028) from the upload reply, and the server applies the offsets when it stores a reading. A later flash may come with P05-04 (device health). (3) 77 % flash is not harmful; it matters for OTA (P08: two firmware copies) and for new features. (4) A room saved in `#admin` should reach the OLED at the next upload (about 60 s); not yet seen end to end. (5) The teacher's approval: the owner said "he already reviewed it"; I recorded it as covering the guide (already recorded, D-034) and left "other wording" open.
- **Problems and diagnosis:** none.
- **Decisions made / awaiting owner:** none new. Awaiting: whether the teacher's review also covers the app's other user-facing wording.
- **Which parts did I actually run, and what am I unsure about?**
  - **Ran:** the phase report and one read-only SQL query on init-test. I looked at the owner's six screenshots.
  - **Unsure / not tried:** I did not read the OLED code, so "the OLED shows the room" rests on P03-06 in CURRENT_STATE.md; I did not re-check how often the firmware writes flash (wear). A real save from `#admin` followed by the OLED changing is untried. Nothing ticked.
- **Handoff:** the run ends at 18:03 local on 2026-11-03. Then: bank level, row count and gaps, tick P03-07; unplug for the offline check; `npm test` once; P04-08 leftovers (a school day with several levels, offline page on a phone, iPhone add-to-home-screen); first real admin saves; live admin rollout.
- **Next session's first concrete step:** the run's end (18:03 local on 2026-11-03): ask for the bank level, count `init-test` rows from 10:03Z to 10:03Z next day, list gaps over 90 s, tick P03-07; then the offline check.
- **Recommended model for the next session:** Sonnet 5.5 — the run evidence, the offline check, `npm test`, P04-08 and the first admin saves; switch to Opus 5.5 for P05-03 (push alerts) and the live admin rollout.

## Phase Progress (HARD RULE 1)
**At session start and end** (`node tools/phase-report.mjs --md`, unchanged):
```
| Phase | Done / Total | Progress | % |
|---|---|---|---|
| P00 Kickoff and decisions | 13 / 13 | ██████████ | 100% |
| P01 Heat index core and bench bring-up | 7 / 7 | ██████████ | 100% |
| P02 Backend and secure upload | 7 / 7 | ██████████ | 100% |
| P03 Device firmware | 9 / 10 | █████████░ | 90% |
| P04 Web app core | 12 / 13 (+1 partly) | █████████░ | 92% |
| P05 Admin, alerts and device health | 2 / 7 (+3 partly) | ███░░░░░░░ | 29% |
| P06 Display and sharing extras | 0 / 5 | ░░░░░░░░░░ | 0% |
| P07 Field trial and hardening | 0 / 7 | ░░░░░░░░░░ | 0% |
| P08 Over-the-air updates (optional) | 0 / 3 | ░░░░░░░░░░ | 0% |
| **Whole project** | 50 / 72 | ███████░░░ | **69%** |
```

## Continuation prompt (HARD RULE 2)
Generated by `node tools/continuation-prompt.mjs`. Full text: `documentation/context/NEXT_SESSION_PROMPT.md`; shown to the owner in the final message. Pushed to own branch only: no (ask first).
