CodenameTempest14/init-heat-monitoring/documentation/phase-reports/phase-03-firmware/sessions/2026-11-02_s23_CLOSE.md

# Phase 03 — Session s23 — CLOSE — 2026-11-02

[P03 · Device firmware · 9/10 done · 0 blocked · unverified 0]
(The one unverified change is still the 2 min offline rule inside the ticked P04-03; the tool does not count it.)

- **Status:** Completed. Short session (22:09 to about 22:50 local) during the 24 h run (P03-07, ends 2026-11-03 10:03Z = 18:03 local). The run was never touched: 285 rows at 14:48Z, newest 22 s old, no gap over 90 s, `interval_s` 60.
- **Phase builder:** owner only (answered s23). **Model:** Opus 5.5 for the start report, Sonnet 5.5 from the owner's `/model` switch on.
- **Planned vs done:** owner chose (1) F-22 admin guide mocks, then (2) looking at `#admin` on the phone. Done both, and, with the owner's yes after approving the mocks, built and shipped the guide: **P05-07 ticked** with evidence.
- **Files changed:** `design/admin-guide/` (mocks, `guide.css`, build and capture scripts, `ref/`) — guide mocks; `design/admin/proposal-b/` (`build-mocks.mjs`, `admin-b.css`, `b-settings.html`, `b-saved.html`, `ref/`) — redrawn with the How? links; `web/src/Guide.jsx`, `guide.css`, `App.jsx`, `Admin.jsx`, `admin.css`, `main.jsx` — the guide, its route and the three links; `tests/ui-gate-guide.test.js` — new gate; `web/README.md`, `tests/README.md`, `documentation/phases/phase-05-admin-alerts.md` (P05-07 added and ticked), `CURRENT_STATE.md`, `PROGRESS_LOG.md`.
- **Build, tests and checks run:** guide gate red first (6 of 6 failed), admin gate red first (it compares with the redrawn images), then `ui-gate-guide` 6/6, `ui-gate-admin` 14/14, home 12, badge 9, history 13, school 14 (one file at a time), web unit tests plus contrast 62/62, `check-readmes`, `secret-scan` clean. Hosted page in a fresh Chromium, 390 px light and dark: `#guide/interval` opens at the section, no console messages. Read-only SQL on init-test for the run.
- **Not run:** `npm test` and the full backend suite (they wipe init-test during the run); anything on live.
- **Unverified changes (at most 1):** 1, the 2 min offline rule (unchanged).
- **Commits:** `ec710c3` mocks (pushed), `f536c41` mocks approved (pushed), `304e894` guide built (pushed to `codenametempest14` and `main`, owner approved), `c4f4209` P05-07 ticked (pushed to both, owner approved), the s23 close commit (local; ask before pushing).
- **Problems and diagnosis:** (1) A shell heredoc that wrote the mock files failed with "unexpected EOF" and wrote nothing; the Write tool worked (CLAUDE.md already warns about heredocs). (2) The first admin mock render had the wrong stylesheet and logo paths (found by looking at the image); fixed. (3) In the guide, a bold number in the Example box broke onto its own line (found by looking); fixed with a label class. (4) My output filter once hid the test counts; reran with the right pattern.
- **Decisions made / awaiting owner:** Owner approved the guide mocks and the build; a teacher approved the guide wording (owner's word). **Awaiting:** whether the teacher's approval also covers the app's other user-facing wording (D-034); I recorded the guide only.
- **Which parts did I actually run, and what am I unsure about?**
  - **Ran:** the gates and tests above, the live page in Chromium, and the run check. The owner looked at the live guide and `#admin` on an Android phone and an iPhone (Brave, dark) and said light mode looks normal (no screenshot kept).
  - **Unsure / not tried:** the guide in light mode on a phone is only the owner's word. A real save from `#admin` and the device picking up a changed interval are still untried (the only device is the run's "Room 1"). The guide gate passed on its first run (the same as the admin gate in s22); its negative test shows it can fail, and it was red before the build. The test admin's password is weak: init-test only, never live. `settings_touch()` is still executable by anon (harmless, revoke in the next migration). The guide page loads with the run's `received_at` and the readings request only; nothing else was checked on live. The teacher's approval is reported by the owner, not seen by me.
- **Handoff:** the run ends at 18:03 local tomorrow. Then: bank level, row count and gaps, tick P03-07; unplug for the offline check; `npm test` once; P04-08 phone checks; first real admin saves from the phone; live admin rollout. See the continuation prompt.
- **Next session's first concrete step:** the run's end (18:03 local on 2026-11-03): ask for the bank level, count `init-test` rows from 10:03Z to 10:03Z next day, list gaps over 90 s, tick P03-07; then the offline check.
- **Recommended model for the next session:** Sonnet 5.5 — the run evidence, the offline check, `npm test`, P04-08 and the first admin saves; switch to Opus 5.5 for P05-03 (push alerts) and the live admin rollout.

## Phase Progress (HARD RULE 1)
**At session start:**
```
| Phase | Done / Total | Progress | % |
|---|---|---|---|
| P00 Kickoff and decisions | 13 / 13 | ██████████ | 100% |
| P01 Heat index core and bench bring-up | 7 / 7 | ██████████ | 100% |
| P02 Backend and secure upload | 7 / 7 | ██████████ | 100% |
| P03 Device firmware | 9 / 10 | █████████░ | 90% |
| P04 Web app core | 12 / 13 (+1 partly) | █████████░ | 92% |
| P05 Admin, alerts and device health | 1 / 6 (+3 partly) | ██░░░░░░░░ | 17% |
| P06 Display and sharing extras | 0 / 5 | ░░░░░░░░░░ | 0% |
| P07 Field trial and hardening | 0 / 7 | ░░░░░░░░░░ | 0% |
| P08 Over-the-air updates (optional) | 0 / 3 | ░░░░░░░░░░ | 0% |
| **Whole project** | 49 / 71 | ███████░░░ | **69%** |
```
**At session end** (`node tools/phase-report.mjs --md`): see the table in the final message; P05 is 2 / 7 (+3 partly), 29%, the whole project 50 / 72, 69%.

## Continuation prompt (HARD RULE 2)
Generated by `node tools/continuation-prompt.mjs`. Full text: `documentation/context/NEXT_SESSION_PROMPT.md`; shown to the owner in the final message. Pushed to own branch only: no (ask first).
