CodenameTempest14/init-heat-monitoring/documentation/phase-reports/phase-03-firmware/sessions/2026-11-02_s21_CLOSE.md

# Phase 03 — Session s21 — CLOSE — 2026-11-02

[P03 · Device firmware · 9/10 done · 0 blocked · unverified 1]
(Counts checklist items. One change is unseen on the hosted page: the 2 min offline rule.)

- **Status:** short session during the 24 h run (P03-07 still running, ends 2026-11-03 10:03Z = 18:03 local). Meta description added and live; the owner's phone screenshots reviewed as P04-08 evidence.
- **Phase builder:** owner only.
- **Files changed:** `web/index.html` (one meta description line), `documentation/` (log, state, this report).
- **Run and checked:**
  - Read-only check of the run on init-test at 13:05Z: 182 rows since 10:03:55Z, newest 1 s old, largest gap 64 s.
  - `tools/secret-scan.mjs` clean; pushed `e972b6f` and the s20 close commits to `codenametempest14` and `main` (owner approved both targets).
  - Fetched the hosted page after the deploy: the `<meta name="description">` is in the served HTML.
- **Owner screenshots (phone, dark mode, 20:46 local, hosted page), what they show:**
  - Home: Online badge, heat index 40 °C Extreme caution, 31.3 °C, 74 %, "updated just now", the School day summary row.
  - 24 h history: heat index, temperature, humidity charts; the lone dot at the left; the readout; PAGASA lines at 33 and 42.
  - School day (Mon 2 Nov): highest 41 °C at 4:34 PM, time in each level (Extreme caution 5 h 47 min, No reading 7 h 28 min, total 13 h 15 min = the 6:00 AM to 7:15 PM window).
  - Nothing in them showed a defect. No personal data visible except the status bar (notification icons, clock).
- **Not done (so P04-08 is NOT ticked):** the school-day view with a day in several levels (the shown day has only one level plus no reading), the offline page on a phone, an iPhone add-to-home-screen, light mode on the phone, the Lighthouse SEO re-measure (only the tag is confirmed).
- **Not run:** the test suites (the backend ones wipe init-test during the run).
- **Unverified changes:** 1, the 2 min offline rule. The meta description is verified (tag present in the served page).
- **Commits and push:** `e972b6f` pushed to `codenametempest14` and `main`. This close commit is local until the owner approves a push.
- **Problems and diagnosis:** none. A `sleep` followed by `curl` was blocked by the shell tool; used a polling loop instead.
- **Decisions made:** none. Owner answers: the sensor reading of 23.1 °C at 04:14 local was because the board was moved (explained, not a fault).
- **Which parts did I actually run, and what am I unsure about?** I ran the read-only run check, the secret scan, the push and a fetch of the hosted page. I did not run any tests or Lighthouse. Unsure: whether Lighthouse SEO now reads 100; I judged the screenshots by eye only.
- **Recommended model for the next session:** Sonnet 5.5.

## Phase Progress
**At session start:** 48 / 71, 68%. **At session end:** 48 / 71, 68% (table in the final message).
