CodenameTempest14/init-heat-monitoring/documentation/phase-reports/phase-03-firmware/sessions/2026-11-02_s20_CLOSE.md

# Phase 03 — Session s20 — CLOSE — 2026-11-02

[P03 · Device firmware · 9/10 done · 0 blocked · unverified 1]
(Counts checklist items. One change is unseen on the hosted page: the 2 min offline rule.)

- **Status:** short session during the 24 h run (P03-07 still running, ends 2026-11-03 10:03Z = 18:03 local). One chart bug fixed and pushed.
- **Phase builder:** owner only (the owner said they are the only one working).
- **Files changed:** `web/src/history.js`, `web/src/History.jsx`, `tests/web-history.test.js`, `design/history-charts/{build-mocks.mjs,7d.html,ref/7d-phone-*.png}`, `documentation/` (log, state, this report).
- **Run and checked:**
  - Read-only check of the run on init-test: 163 rows since 10:03:55Z, newest 3 s old, largest gap 64 s.
  - Test first: `loneBuckets` test red (missing export), then `web-history` 14/14. History gate 11/13 after the change (the approved 7d mock had the same invisible lone bucket), 13/13 after the builder and two images were updated; looked at the new 7d image. Production build passes.
  - `tools/secret-scan.mjs` clean before the push.
- **Not run:** the other three UI gates, the full web suite and the backend suite (it wipes init-test during the run), the fix on the hosted page.
- **Later in the session (hosted page, fresh Chromium, 390 px):** the dot is live in dark and light (10 chart dots, no console messages); Chrome's installability check passes; Lighthouse 12 mobile 98 / 100 / 100 / 91 (SEO: no meta description). Light-mode header looks right.
- **Unverified changes:** 1, the 2 min offline rule. The dot is verified in Chromium; the owner's phone screenshot is a bonus check.
- **Commits and push:** `7a5f8e1` (s19 close) and `f8390dc` (fix) pushed to `codenametempest14` and `main` (owner approved each). Local, not pushed: this close commit.
- **Problems and diagnosis:** a heredoc with python hung the shell again (stopped; used the Edit tool). My first bug report was wrong in part: I called the temperature axis clipped, but the 23.1 C reading is averaged into a 15-minute bucket and the plotted 26.0 sits exactly on the axis minimum.
- **Decisions made:** none. The dot (r=3, same colour as the line) is my choice; the owner has not seen it on the real page.
- **Which parts did I actually run, and what am I unsure about?** I ran the unit tests, the history gate, the build and read-only SQL on init-test. Unsure: how the dot looks on the real phone; whether other gates (home, badge, school) are untouched (they do not use `History.jsx` dots, but I did not run them).
- **Handoff:** the owner said they will send values and screenshots after the run ends. They wrote 6:03 AM, but the run ends 6:03 PM; check which they mean.
- **Recommended model for the next session:** Sonnet 5.5.

## Phase Progress
**At session start:** 48 / 71, 68%. **At session end:** 48 / 71, 68% (table in the final message).
