CodenameTempest14/init-heat-monitoring/documentation/phase-reports/phase-03-firmware/sessions/2026-11-02_s18_CLOSE.md

# Phase 03 — Session s18 — CLOSE — 2026-11-02

[P03 · Device firmware · 9/10 done · 0 blocked · unverified 0]
(The status line counts checklist items. One change is still unseen on the hosted page: the 2 min offline rule, see below.)

- **Status:** P04-05 (installable PWA) and P04-06 (public read-only) built, verified and ticked: P04 is 11/13. P04-07 (school-day view) designed and approved, not built. P03-07 (24 h run) is still running (ends 2026-11-03 18:03 local).
- **Planned vs done:** planned: push approval, P04-04 follow-ups, P04-05 design and build. Done: all of them, plus P04-06 and the P04-07 design. Not done: P04-07 build (owner chose to continue next session), P04-08, P03-07 (running).
- **Phase builder:** owner only (answered s18).
- **Files changed:** `web/src/{History.jsx,charts.css,App.jsx,app.css,main.jsx,school.css}`, `web/public/` (new: manifest, `sw.js`, icons, logos, README), `web/{index.html,vercel.json,package.json,build-icons.mjs,README.md}`, `design/pwa/` (new), `design/school-day/` (new), `design/{home-cards,offline-badge,history-charts}/` (header redrawn, all images regenerated), `tests/web-pwa.test.js` (new), `tests/ui-gate-{home,badge,history}.test.js`, `tools/{anon-probe.mjs,check-readmes.mjs,README.md}`, `documentation/` (checklist, decisions D-032 and D-033, log, state, this report).
- **Build, tests and checks run:**
  - Focus outline: test first, red (`outline: auto 5px` after a click), then green; history gate 13/13.
  - 04:00 drop: read-only SQL on init-test: real rows (29.3, 23.1, 26.0 °C, then no rows for 52 min).
  - PWA: `tests/web-pwa.test.js` red 0/8, then 8/8; removing the same-origin rule from `sw.js` made 1 test fail.
  - Header: mocks and images redrawn first, gates red (31 of 34 failed), then the app changed: home 12, badge 9, history 13, 0 differing pixels. The gates have to be run one file at a time (they race on `web/dist`).
  - Built app in Chromium: worker registers and controls, manifest loads, cache holds only page files (no Supabase request), offline page opens with the new header and the "Could not load" message, no console messages.
  - Hosted page (logged-out Chromium, 390 px light and dark, 1280 px dark): header, `Online`, manifest `application/manifest+json`, `sw.js` `no-cache`, no console messages.
  - `tools/anon-probe.mjs`: 17/17 on init-test and 17/17 on live.
  - Other web tests (lib 12, category 4, history 13, contrast 5, ui-gate 5): all pass. `tools/secret-scan.mjs` before every commit: clean. README check: clean.
- **Unverified changes:** 1, the 2 min offline rule, still unseen offline on the hosted page (needs the board unplugged: best at the end of the 24 h run).
- **Commits and push:** `5d3e1cb` and `6c0f41e` pushed to `codenametempest14` and `main` (owner approved, twice). Local, not pushed: `53afa9b`, `c3f9fcc`, `aa3db15`, `cab3145`, `42ac211` and this close commit.
- **Problems and diagnosis:** (1) I ran `npm test`, which includes the backend tests that wipe init-test (the P03-07 data); the auto-mode classifier blocked it before it ran, nothing was lost; since then only web tests are run. (2) The first gate run after the header change failed for two reasons: the three gates built `web/dist` at the same time (a race), and the gate server sent `.svg` as a generic file so Chrome did not draw the logo; fixed by running one file at a time and adding the file types. (3) A bash heredoc with a quote hung twice; I wrote those files with the Write tool.
- **Decisions made:** D-032 (PWA header, theme colours, offline rule) and D-033 (school-day view), both by the owner.
- **Which parts did I actually run, and what am I unsure about?** I ran the tests and gates listed above, the built app and the hosted page in Chromium, the anonymous probe on both projects, read-only SQL, and the pushes. The owner ran the phone checks (Brave shortcut, Chrome install, iPhone view) and the 24 h run. I did not run: the backend tests (they wipe init-test), the 2 min rule while offline, Lighthouse or Chrome's install check, the iPhone add-to-home-screen, the light-mode header and the offline page on a phone. Unsure: (a) the probe has only reported a failure on my own typo, never on a real hole, and its change and delete checks accept an empty answer (the permission-denied results are the real proof); (b) the 04:00 drop is real data, but I do not know why the sensor read 23.1 °C (board moved or a sensor blip); (c) P04-07's `school_day()` has to be tested against the backend suite, which cannot run until the 24 h run ends.
- **Handoff:** next session: phase-builder question, push approval (name both targets), build P04-07 (database function and tests first, web view, link row, redraw the three mock sets and gates), then at 18:03 local on 2026-11-03 close P03-07 (bank level, count rows, gaps, tick), run the backend tests only after that, then the offline screenshots and P04-08.
- **Recommended model for the next session:** Sonnet 5.5 (P04-07 build, the 24 h run evidence, P04-08). Opus 5.5 only for the admin sign-in in P05.

## Phase Progress
**At session start:** 45 / 71, 63%.
**At session end:** 47 / 71, 66% (table in the final message).
