CodenameTempest14/init-heat-monitoring/documentation/phase-reports/phase-03-firmware/sessions/2026-11-02_s17_CLOSE.md

# Phase 03 — Session s17 — CLOSE — 2026-11-02

[P03 · Device firmware · 9/10 done · 0 blocked · unverified 0]
(The status line counts checklist items. One change is still unseen on the hosted page: the 2 min offline rule, see below.)

- **Status:** P04-04 history charts designed (owner approved), built test-first, deployed and verified on the hosted page and on the owner's phone; ticked. The offline limit changed from 3 min to 2 min (owner). P03-07 (24 h run) **started** by the owner at 18:03 local (10:03Z), bank at 100 %, and is running.
- **Planned vs done:** planned: push the s16 commits, P03-07 when the bank is full, start P04-04. Done: push; the 2 min rule; P04-04 design, build and phone check; P03-07 started (the owner said the bank was full). P03-07 itself ends 2026-11-03 18:03 local.
- **Phase builder:** owner only (answered s17).
- **Files changed:** `design/history-charts/` (new: 6 mocks, mock data, capture, 12 screenshots, README), `supabase/migrations/20261103120000_history.sql` (new), `web/src/{History.jsx,history.js,charts.css,App.jsx,main.jsx}`, `web/vite.config.js` (`cssMinify: false`), `web/src/lib.js` (offline limit 120 s), `tests/{web-history,ui-gate-history}.test.js` and `tests/backend/history.backend.js` (new), `tests/web-lib.test.js`, READMEs, `documentation/` (phase-04 checklist, state, log).
- **Build, tests and checks run:**
  - Offline limit: test changed first and failed (121 s was still online), then `OFFLINE_AFTER_S` 180 to 120; 76/76.
  - Database: `history()` test red first (function missing, 404), then `db push` to `init-test` and 5/5. Read-only query on live `init`: `history()` exists and `ingest_reading` carries the room, so the owner's 7th and 8th migrations are on live.
  - Chart maths: `tests/web-history.test.js` red (module missing), then 13/13; widening the gap rule from 1.5 to 9 steps made 1 test fail.
  - Palette: dataviz validator on slots 1 to 3, light and dark: all pass (light aqua 2.82:1, covered by the table view).
  - UI gate `tests/ui-gate-history.test.js`: the built page matches the approved images with 0 differing pixels for 24h, 7d, a time picked and no readings (phone, light and dark) and the 24h desktop page; fails on a wrong series colour. Getting there took four fixes in the page (text as one node, 1-decimal paths, `cssMinify: false`, a pointer event instead of a scroll) and one in the gate.
  - `npm test` 101/101. `tools/secret-scan.mjs` before every commit: clean.
  - Hosted page (logged-out Chromium, 390 px light and dark, 1280 px dark): Online, 40 °C, charts, table, range switch, no console or CSP messages.
  - Owner's phone (18:18, Brave on Android, dark): readout on touch, 7 d switch, no sideways scroll.
  - P03-07: after the unplug, `init-test` got 14 rows in 13 minutes, one a minute (first on the bank 10:03:55Z).
- **Unverified changes:** 1, the 2 min offline rule: tested and deployed, not yet seen offline on the hosted page (it needs the board unplugged, which would break the 24 h run).
- **Commits and push:** s17 commits `4a3ffd1` to `3740104` pushed to `codenametempest14` and `main` (owner approved: `16016ae` and `3740104` pushes). `af0d4ce` and the close commit are local until the owner approves a push.
- **Problems and diagnosis:** (1) The first gate run differed by 287 px for a reason I had to chase: JSX split some text into several nodes, line paths were rounded to 2 decimals instead of 1, and Vite's CSS minifier changed line-heights by 1/64 px; each fixed in turn. (2) The hover gate scrolled the page; sending the pointer event directly fixed it. (3) The first mock run crashed because the heat index is null below its range; the mock now shows that honestly (line stops, caption). (4) A stray `python` heredoc hung and was stopped. (5) The mock dark-mode selected button was 3.6:1; changed to a darker blue (6.9:1).
- **Decisions made:** owner: offline limit 2 min; 15 min and hourly averages if the database is not overloaded; PAGASA lines left to me (kept). Not added to DECISIONS.md (small, recorded in the phase checklist and the mock README).
- **Which parts did I actually run, and what am I unsure about?** I ran the tests, the UI gates, the migration on `init-test`, the read-only checks on live, the hosted page in Chromium and the pushes. The owner ran the phone check and started the 24 h run. I did not run: the 2 min rule while offline, the table, light mode and iPhone on a phone, the full 24 h. Unsure: (a) the white focus outline that appears on the chart after a tap (seen in the owner's screenshots); (b) the sharp drop of the 24 h temperature line near 04:00 in the owner's screenshot: I have not checked the raw rows, so I do not know if it is real data or a bug; (c) with 60 s uploads, 2 min leaves room for one late upload only, so the badge may flicker on a slow Wi-Fi.
- **Handoff:** next session: phase-builder question, push approval, then P04-05 (PWA mock first) while the run goes on; at 18:03 on 2026-11-03 read the bank level, count the rows, list gaps, tick P03-07, then the offline screenshots.
- **Recommended model for the next session:** Sonnet 5.5 (PWA design and build, 24 h run evidence). Opus 5.5 only for the admin sign-in in P05.

## Phase Progress
**At session start:** 44 / 71, 62%.
**At session end:** 45 / 71, 63% (table in the final message).
