CodenameTempest14/init-heat-monitoring/documentation/phase-reports/phase-03-firmware/sessions/2026-11-02_s16_CLOSE.md

# Phase 03 — Session s16 — CLOSE — 2026-11-02

[P03 · Device firmware · 9/10 done · 0 blocked · unverified 0]

- **Status:** P04-02 live cards verified on the hosted page and the owner's phone, ticked. P04-03 offline badge designed (owner approved), built test-first, deployed, and verified with the real board unplugged and replugged; ticked. P03-07 (24 h run) not started: the power bank is not yet confirmed full.
- **Planned vs done:** planned: verify P04-02, P03-07 when the bank is full. Done: P04-02 verified; P04-03 design, build and real-board check (the owner added it after P04-02). P03-07 not done (bank not full).
- **Phase builder:** owner only (answered s16).
- **Files changed:** `design/offline-badge/` (new: 4 mocks, capture, 9 screenshots, README), `design/home-cards/` (mocks and screenshots regenerated with the Online pill), `design/tokens.json` and `design/contrast.mjs` (status colours, checked), `web/src/{App.jsx,lib.js,app.css,tokens.css}`, `web/build-tokens.mjs`, `tests/{web-lib,contrast}.test.js` (extended), `tests/ui-gate-badge.test.js` (new), `documentation/` (phase-04 checklist, state, log).
- **Build, tests and checks run:**
  - Hosted P04-02: headers, logged-out Chromium at 390 and 1280 px, light and dark, no console or CSP messages; owner's phone screenshot (Brave, dark).
  - P04-03: tests red first (missing exports; no status check in contrast.mjs), then green; changing the 180 s rule to 240 s made 1 test fail. UI gate `ui-gate-badge`: built page matches the approved images, 4 states x light and dark, 0 differing pixels; fails when offline is drawn as online. `npm test` 76/76. Real init-test data in Chromium.
  - Real-board check (owner): board unplugged 17:06 local, screenshots at 17:09 (3 min), 17:10 (4 min), 17:11 (5 min), 17:13 Online. Server: last upload 09:05:45Z, next 09:13:00Z, gap 435 s, the only gap over 90 s since 09:00Z.
  - `tools/secret-scan.mjs` before every commit: clean.
- **Unverified changes:** 0.
- **Commits and push:** s16 commits `7104088` to the close commit. `29e3f50` pushed to `codenametempest14` and `main` (owner approved). The P04-03 tick and the close commit are local until the owner approves a push.
- **Problems and diagnosis:** (1) The no-readings mock said `Room 204` but the page with no row says `Room: —`: the gate failed 326 px; the mock was wrong, fixed (two screenshots changed). (2) `design/offline-badge/ref` lacked a README (check-readmes), added. (3) The owner's answer on the 3 min rule was unclear; I took the proposal's 3 min as accepted and flagged it. The real-board test showed it behaves as built; the owner can still change the number. (4) A shell heredoc with quotes failed at close; the close files were written with the Write tool instead.
- **Decisions made:** none new in DECISIONS.md. Rule recorded in the P04-03 checklist: offline = newest reading more than 180 s old by `received_at`.
- **Which parts did I actually run, and what am I unsure about?** I ran the tests, the UI gates, the hosted page in Chromium, the server queries and the push. The owner ran the real unplug test and took the phone screenshots. I did not run: the 24 h run, the anonymous-write check, the badge in light mode on a phone, iPhone, desktop gate. Unsure: whether 3 min is the number the owner wants (a short Wi-Fi drop may flash Offline for a few minutes); page loads take 2.7 to 4.2 s (Supabase cold start plus the 692 kB stylesheet).
- **Handoff:** next session: ask for the push approval, then P03-07 when the bank is full; otherwise P04-04 charts (design mock first, read the `dataviz` skill).
- **Recommended model for the next session:** Sonnet 5.5 (24 h run evidence, chart design and build). Opus 5.5 only for the admin sign-in in P05.

## Phase Progress
**At session start:** 42 / 71, 59%.
**At session end:** 44 / 71, 62% (table in the final message).
