CodenameTempest14/init-heat-monitoring/documentation/phase-reports/phase-03-firmware/sessions/2026-11-02_s15_CLOSE.md

# Phase 03 — Session s15 — CLOSE — 2026-11-02

[P03 · Device firmware · 9/10 done · 0 blocked · unverified 0]

- **Status:** P03-05 logo on the setup page built, flashed, seen on the phone (titles `Init Setup` and `Saved`, icon kept). P04-01 done: app skeleton deployed on Vercel. P04-02 built and checked locally, **not yet ticked** (needs the deployed page looked at). P03-07 not started: the power bank was not fully charged when the session ended.
- **Planned vs done:** planned P03-07: not done (bank charging, owner's call). Owner added: logo on the setup page (done), then P04-01 (done), P04-02 design approved and built (unverified).
- **Phase builder:** owner only (answered s15).
- **Files changed:** `design/device-setup/` (pages, `ref/`, `proposal-logo/` deleted after approval), `firmware/init/include/wifi_setup.h`, `web/` (new: Vite + React app, generators, `vercel.json`), `design/home-cards/` (new: mocks, capture, 14 screenshots), `tests/web-lib.test.js`, `tests/web-category.test.js`, `tests/ui-gate-home.test.js` (new), `documentation/` (DECISIONS D-030 and D-031, phase 03 and 04 checklists, `specs/P04-01_PROPOSAL.md`, state, log).
- **Build, tests and checks run:**
  - Logo: page test red first, green after the firmware change; three title changes (all capitals, then back, then `Init Setup`) each re-run; `pio run` SUCCESS (flash 77.0 %).
  - `npm test` 61/61 at the end (38 at the start). New tests seen red first (module missing, or the old expectations); mutations caught: a changed band edge (2 tests), a changed boundary and rounding (2 tests).
  - UI-GATE `tests/ui-gate-home.test.js`: 10 images match pixel for pixel (0 differing), no console or CSP messages; fails on a changed number and on a wrong category colour.
  - Real browser (Chromium, 390 px): the local build and the hosted page (https://init-heat-monitoring.vercel.app) showed the real init-test row; headers (CSP, nosniff, no-referrer, HSTS) arrive from Vercel; no sideways scroll.
  - Board and phone (owner): flashed three times; screenshots of the setup page and the `Saved` page on Android (dark); rows resumed at 07:02:24Z. Owner's phone screenshot of the hosted page (Messenger in-app browser, light).
  - `tools/secret-scan.mjs` before every commit: clean.
- **Unverified changes:** 1 in practice (P04-02, built and gated but not deployed or looked at on the hosted page). The phase tool counts 0 because the box is unticked.
- **Commits and push:** s15 commits from `2bb4f64` to the close commit; push to `codenametempest14` and `main` approved by the owner at close.
- **Problems and diagnosis:** (1) Python heredoc escaping broke my first edit of `wifi_setup.h`; redone with `chr(92)`, then the page test passed. (2) `rm` of the old proposal folder was blocked by the auto-mode classifier; deleted with `git rm` after the owner said so. (3) My first UI-GATE run failed 12/12: the CSP blocked the style tag my test injected (the CSP was right; removed the line). So the gate has no separate red run against the old page. (4) My search for outdoor weather in Lapu-Lapu City gave stale or untimed values, so it could not confirm the sensor; the DHT22 still needs a comparison with a reference thermometer. (5) First chat reply printed P08 as 0/7 (it is 0/3).
- **Decisions made:** D-030 hosting on Vercel; D-031 Vercel + Vite + React for the web app, init-test first, public key in the repo; owner: logo in the header and icons at P04-05; room stays `Unassigned`.
- **Which parts did I actually run, and what am I unsure about?** I ran every test, the firmware builds, the UI gate, the local and hosted page in Chromium, and the server queries. The owner flashed the board and used the phone. I did not run: the 24 h run, the anonymous-write check (the backend tests wipe init-test), the hosted P04-02 page (not deployed at write time), the desktop layout, iPhone, install. Unsure: one page load took over 2.5 s (cold start?); the 692 kB stylesheet is all of Tabler; the sensor accuracy against a reference is unchecked.
- **Handoff:** next session: verify P04-02 on the hosted page (the push triggers a Vercel deploy), then P03-07 when the owner says the bank is full.
- **Recommended model for the next session:** Sonnet 5.5 (checking the deploy, waiting on the 24 h run, P04-03 design). Opus 5.5 only for the admin sign-in in P05.

## Phase Progress
**At session start:** 41 / 71, 58%.
**At session end:** 42 / 71, 59% (table in the final message).
