CodenameTempest14/init-heat-monitoring/documentation/phase-reports/phase-03-firmware/sessions/2026-11-02_s10_CLOSE.md

# Phase 03 — Session s10 — CLOSE — 2026-11-02

[P03 · Device firmware · 4/10 done · 0 blocked · unverified 0]

- **Status:** P03-01 and P04-D5 done. P04-D4 screenshots taken, waiting for owner approval (not ticked).
- **Planned vs done:** planned P03-01. Done: P03-01, P04-D4 (screenshots only), P04-D5, s08 cron check.
- **Phase builder:** owner only (answered s10).
- **Files changed:** `firmware/init/` (new: platformio.ini, include/config.h, secrets.h.example, src/main.cpp, READMEs), `design/templates/` (capture.mjs, 8 PNGs, README), `design/ui-gate.mjs`, `design/oled/compare.mjs` (added `decodePngRaw`; `decodePng` behaves as before), `tests/ui-gate.test.js`, `tests/fixtures/`, `package.json` and lock (playwright 1.49.1), `THIRD_PARTY_NOTICES.md`, `design/README.md`, `tests/README.md`, phase-03 and phase-04 checklists, state and logs.
- **Build, tests and checks run:**
  - `pio run` in `firmware/init`: `[SUCCESS]`, 222 s first build, RAM 6.7%, flash 22.9%. `git check-ignore -v` shows `secrets.h` ignored (`.gitignore:6`).
  - `tests/ui-gate.test.js`: red first (module missing), then 5/5; fails on a changed number, colour and width. My first run was 4/5 because my test objects lacked `bpp` (test bug, fixed). `npm test` 23/23 (OLED-GATE still 4/4 after the decoder refactor). README check passes.
  - Screenshots: all 8 returned HTTP 200. The first capture showed an ad banner and a floating button; hidden in the script and recaptured. I looked at 5 of the 8 images.
  - s08 cron check: `init-test` `cron.job_run_details` shows `rollup-old-readings`, `succeeded`, 2026-10-31 18:30 UTC, "1 row". Schedule `30 18 * * *`, active. The return value `{hours:0, deleted:0}` is not in that table, so it is not confirmed.
- **Unverified changes:** 0 (the firmware skeleton is built, not flashed, and is stated as such).
- **Commits and push:** `db626cf`, `52ee4b5`, plus this close commit. Push: asked in the final message.
- **Problems and diagnosis:** `networkidle` never settled on the Tabler demo (timeout); switched to `load` plus a 3 s wait. `db query` with the SQL in the argument was split by the shell wrapper; used `-f` with a file. The Tabler home page is about 832 px wide at a 390 px viewport: cause not diagnosed.
- **Decisions made:** none new. The screenshot avatars are demo photos of real people: kept as reference only (flagged to the owner).
- **Which parts did I actually run, and what am I unsure about?** I ran all of the above. I did not: flash the skeleton to the board; open 3 of the 8 screenshots; read the cron job's return value. Unsure: the placeholder `secrets.h` values (real key not yet used); whether keeping third-party demo photos in the repo fits "no real personal data" (owner to say); git warns LF will become CRLF on the new files (no setting changed).
- **Handoff:** owner reviews `design/templates/`; then P03-02 (Opus 5.5).
- **Recommended model for the next session:** Opus 5.5 for P03-02 and P03-05; Sonnet 5.5 for the rest.

## Phase Progress
**At session start:** see the s10 START report (33 / 71, 46%).
**At session end:**
```
| Phase | Done / Total | Progress | % |
|---|---|---|---|
| P00 Kickoff and decisions | 13 / 13 | ██████████ | 100% |
| P01 Heat index core and bench bring-up | 7 / 7 | ██████████ | 100% |
| P02 Backend and secure upload | 7 / 7 | ██████████ | 100% |
| P03 Device firmware | 4 / 10 | ████░░░░░░ | 40% |
| P04 Web app core | 4 / 13 | ███░░░░░░░ | 31% |
| P05 Admin, alerts and device health | 0 / 6 | ░░░░░░░░░░ | 0% |
| P06 Display and sharing extras | 0 / 5 | ░░░░░░░░░░ | 0% |
| P07 Field trial and hardening | 0 / 7 | ░░░░░░░░░░ | 0% |
| P08 Over-the-air updates (optional) | 0 / 3 | ░░░░░░░░░░ | 0% |
| **Whole project** | 35 / 71 | █████░░░░░ | **49%** |
```
