CodenameTempest14/init-heat-monitoring/documentation/phase-reports/phase-02-backend/sessions/2026-10-31_s08_START.md

# Phase 02 — Session s08 — START — 2026-10-31

[P02 · Backend and secure upload · 4/7 done · 0 blocked · unverified 0]

- **Recommended model for this session:** Opus 5.5, because P02-05 (retention job deletes data), P02-06 (security review) and the first live migration are security and data-loss sensitive. Session runs on Opus 5.5.
- **Phase builder (asked the owner):** owner only (answered s08: "Its only built by me"). D-014 `main` exception stays in force.
- **Session goal:** P02-05 retention job (test-first), which also finishes P02-07; then P02-06 security review; then ask before migrating the live `init` project.
- **Starting state:** branch `codenametempest14`, commit `5e8c63d`, level with `origin/codenametempest14`, working tree clean. Previous: [s07 close](2026-10-31_s07_CLOSE.md).
- **Context loaded:** CLAUDE.md, CURRENT_STATE.md, phase-02-backend.md, s07 CLOSE, s07 START (format).
- **Context deliberately not loaded yet:** SCHEMA.md and the migrations (read when P02-05 starts), firmware, web app, design.
- **Planned steps:** write the retention test against `init-test` and watch it fail; write the `pg_cron` migration (job function: raw readings older than 90 days → `readings_hourly` grouped by room and hour, with avg/min/max and the time of the max, then delete, one transaction); push to `init-test` only; green twice; advisor. Then P02-06 findings file.
- **Distinguishing signal for each check:** P02-05 is done when the test fails first for the expected reason (missing function), then passes, and proves: hourly rows match hand-computed values, the max time is exact, the room is kept, readings newer than 90 days are untouched, raw rows older than 90 days are gone, and a second run changes nothing.
- **Open questions for the owner:** phase builder; later, approval to push migrations to the live `init` project.
- **Risks:** the job deleting readings it did not summarise (must be one transaction, same cut-off); `pg_cron` time zone (UTC) vs. local hour buckets; the free-tier project pausing.

## Phase Progress at session start (HARD RULE 1)
```
| Phase | Done / Total | Progress | % |
|---|---|---|---|
| P00 Kickoff and decisions | 13 / 13 | ██████████ | 100% |
| P01 Heat index core and bench bring-up | 7 / 7 | ██████████ | 100% |
| P02 Backend and secure upload | 4 / 7 (+1 partly) | ██████░░░░ | 57% |
| P03 Device firmware | 0 / 10 | ░░░░░░░░░░ | 0% |
| P04 Web app core | 3 / 13 | ██░░░░░░░░ | 23% |
| P05 Admin, alerts and device health | 0 / 6 | ░░░░░░░░░░ | 0% |
| P06 Display and sharing extras | 0 / 5 | ░░░░░░░░░░ | 0% |
| P07 Field trial and hardening | 0 / 7 | ░░░░░░░░░░ | 0% |
| P08 Over-the-air updates (optional) | 0 / 3 | ░░░░░░░░░░ | 0% |
| **Whole project** | 27 / 71 | ████░░░░░░ | **38%** |
```

## Checkpoints
- s08 — P02-05 and P02-07 done on `init-test` (retention job, mutation-checked; hourly rows keep the room). P02 at 6/7. Next: P02-06 security review.
