CodenameTempest14/init-heat-monitoring/documentation/phase-reports/phase-00-kickoff/sessions/2026-10-30_s02_CLOSE.md

# Phase 00 — Session s02 — CLOSE — 2026-10-30

[P00 · Kickoff and decisions · 10/13 done · 0 blocked · unverified 0]

- **Status:** Completed.
- **Planned vs done:** P00-01…P00-06 (decisions recorded), P00-07, P00-08, P00-08a (brand) ticked with evidence in the phase file. P00-09 (Rev A drafted) ticked from s01.
- **Files changed:** `tools/*.mjs` (adapted from Ad Astra), `documentation/**` (phase 0 checklist, state, decisions, log, templates, READMEs), `README.md`, `CLAUDE.md` (brand in title).
- **Build, tests and bench checks run:** `node tools/phase-report.mjs` and `--md` printed correct counts (10 of 13); `node tools/check-readmes.mjs` passed after skipping dot-folders. Not run: `continuation-prompt.mjs` is run after this report.
- **Unverified changes:** 0. The schematic itself is drafted but was never rendered by me or measured; this is stated in the phase file.
- **Commits:** none, not a git repo.
- **Decisions made / awaiting owner:** D-007 brand "Init" (agent's pick, owner may veto). Awaiting P00-10, P00-11, P00-12.
- **Which parts did I actually run, and what am I unsure about?** I ran the two tracker scripts. I did not render the schematic SVG, so layout errors (overlapping labels) are possible. Runtime estimates are unmeasured, and the cells are unmarked.
- **Handoff:** owner reviews Rev A, then I propose FEATURES.md and a phase plan. Nothing may be built before approval.
- **Next session's first concrete step:** ask the owner for the Rev A review answers (P00-10), then draft the feature list as a proposal.
- **Recommended model for the next session:** Sonnet 5.5 — feature and phase proposals; switch to Opus 5.5 when Supabase schema and device security design start.

## Phase Progress
**At session start:** no phases existed (0 / 0).
**At session end:**
```
| Phase | Done / Total | Progress | % |
|---|---|---|---|
| P00 Kickoff and decisions | 10 / 13 | ████████░░ | 77% |
| **Whole project** | 10 / 13 | ████████░░ | **77%** |
```

## Continuation prompt
Generated by `node tools/continuation-prompt.mjs`; full text in `documentation/context/NEXT_SESSION_PROMPT.md`. Pushed: no (no git repo).
