CodenameTempest14/init-heat-monitoring/design/pwa/icons.html

# Icons

## Browser tab (favicon, 16 px and 32 px)

Init: classroom heat index 32 px, bookmarks

## Home screen

Android, circle
maskable icon

Android, squircle
maskable icon

iPhone
apple-touch-icon

No mask (desktop)
any icon

## Safe zone of the maskable icon

Dashed circle: the part every phone keeps. The thermometer stays inside it.

## Files (all drawn from the approved icon)

favicon.svg, favicon-32.png | the rounded icon
icon-192.png, icon-512.png | "any": the rounded icon
icon-maskable-512.png | full square, glyph at 85 %
apple-touch-icon.png (180) | full square, glyph at 100 %
