CodenameTempest14/init-heat-monitoring/design/admin/health/ref/h-none-phone-dark.png

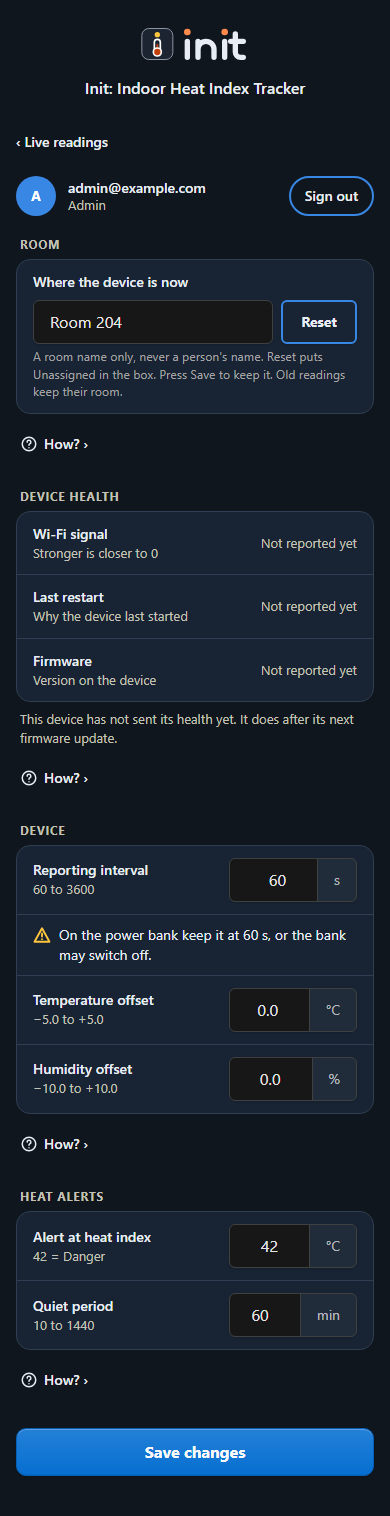
design/admin/health/ref/h-none-phone-dark.png
