CodenameTempest14/init-heat-monitoring/design/admin/health/ref/h-none-phone-light.png

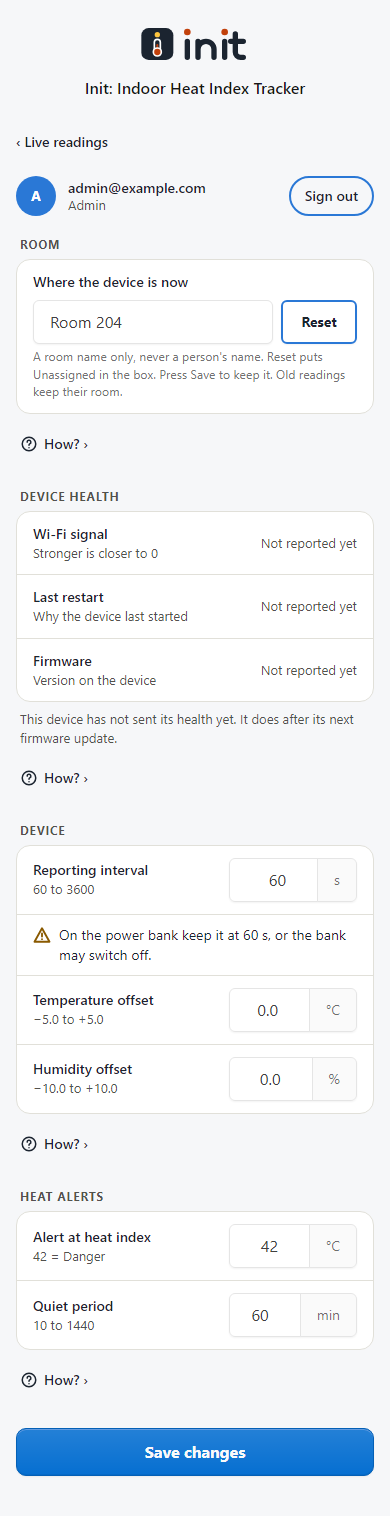
design/admin/health/ref/h-none-phone-light.png
