CodenameTempest14/init-heat-monitoring/design/admin/health/ref/h-ok-desktop-dark.png

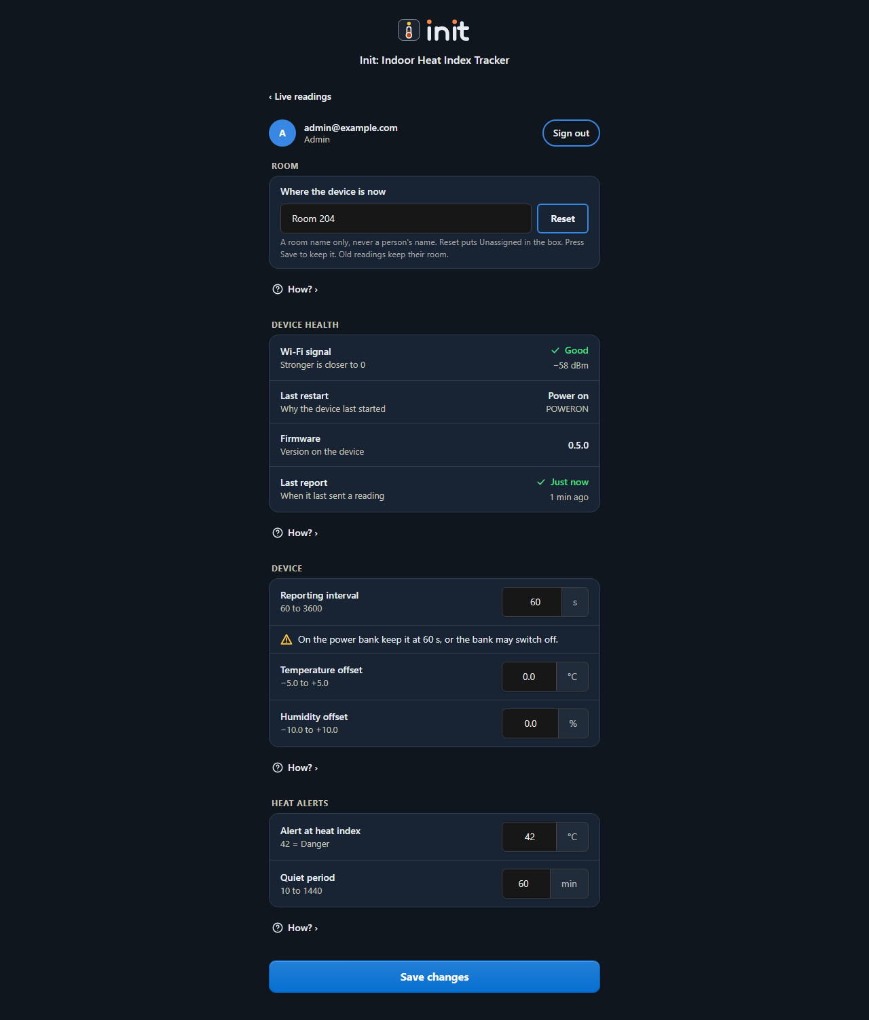
design/admin/health/ref/h-ok-desktop-dark.png
