CodenameTempest14/init-heat-monitoring/design/admin/health/ref/h-ok-desktop-light.png

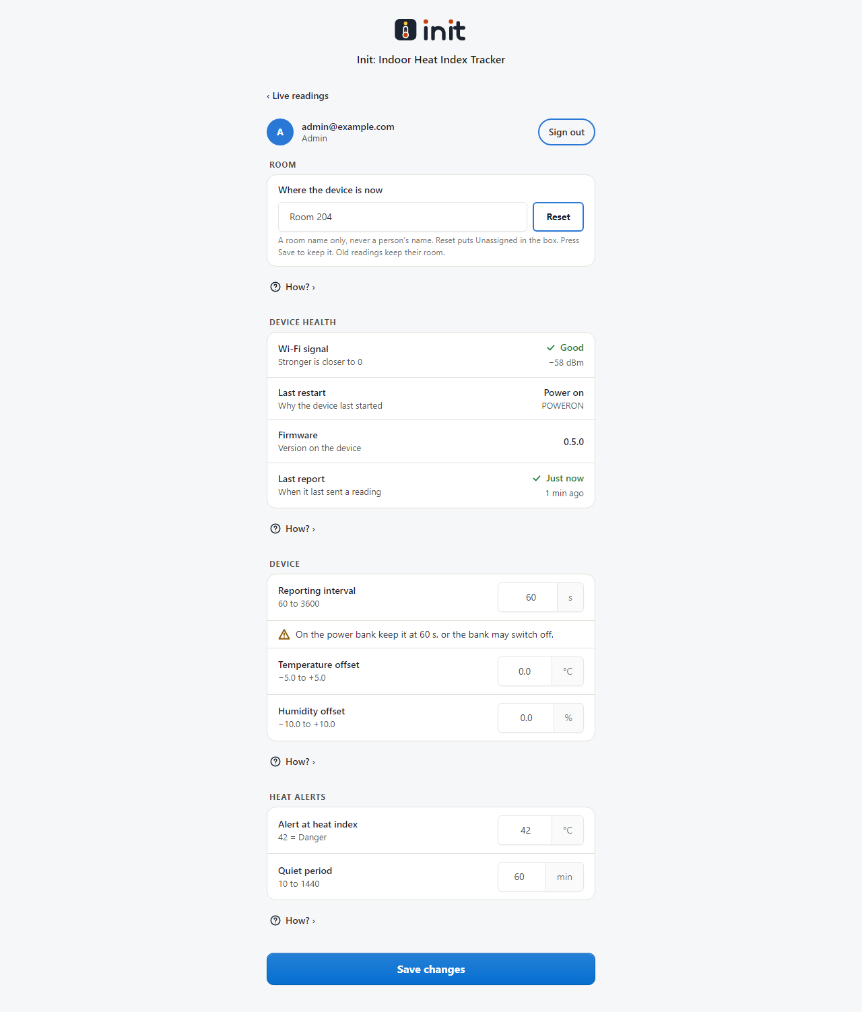
design/admin/health/ref/h-ok-desktop-light.png
