CodenameTempest14/init-heat-monitoring/design/admin/health/ref/h-ok-phone-dark.png

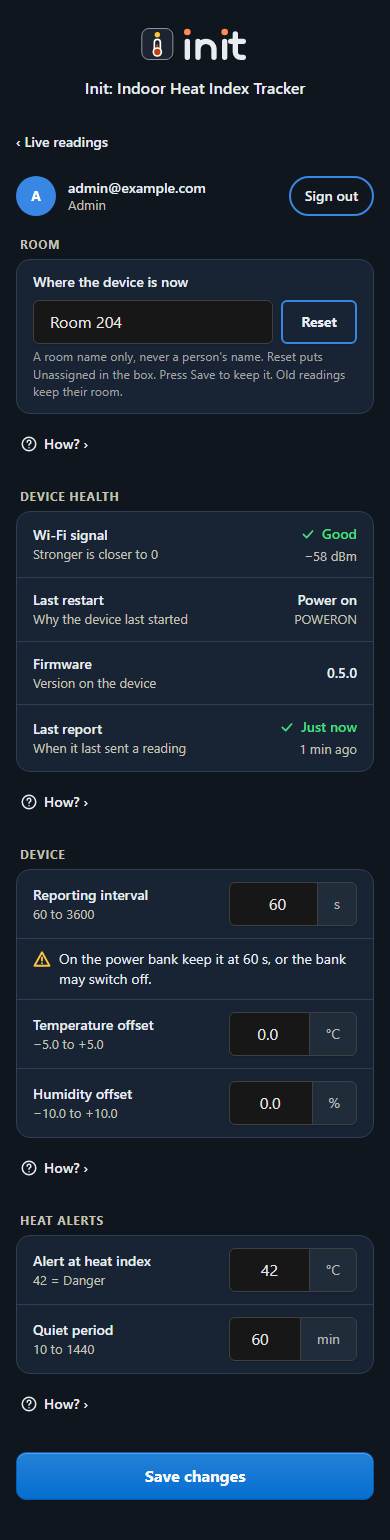
design/admin/health/ref/h-ok-phone-dark.png
