CodenameTempest14/init-heat-monitoring/design/admin/health/ref/h-saved-phone-light.png

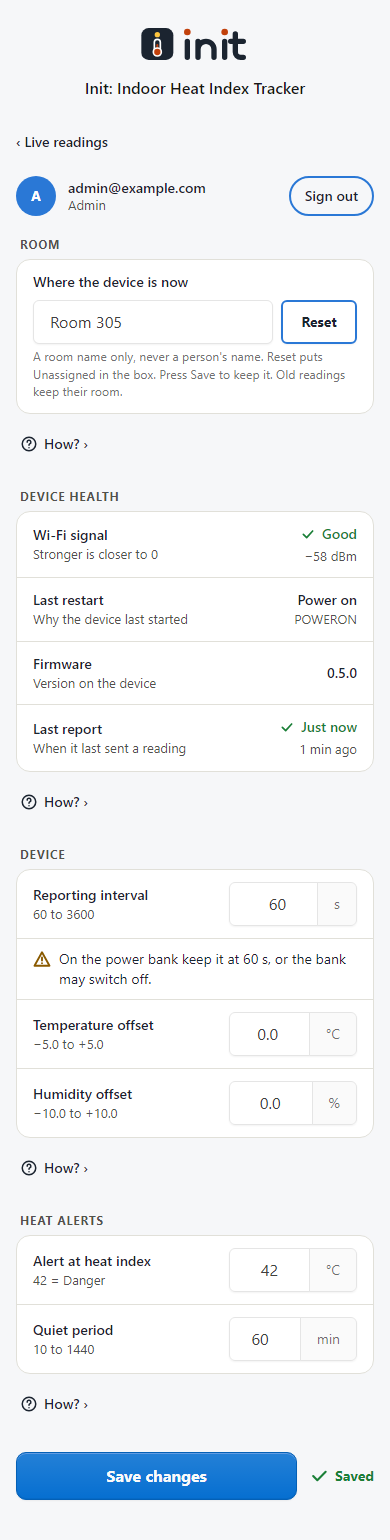
design/admin/health/ref/h-saved-phone-light.png
