CodenameTempest14/init-heat-monitoring/design/admin/health/ref/h-trouble-phone-light.png

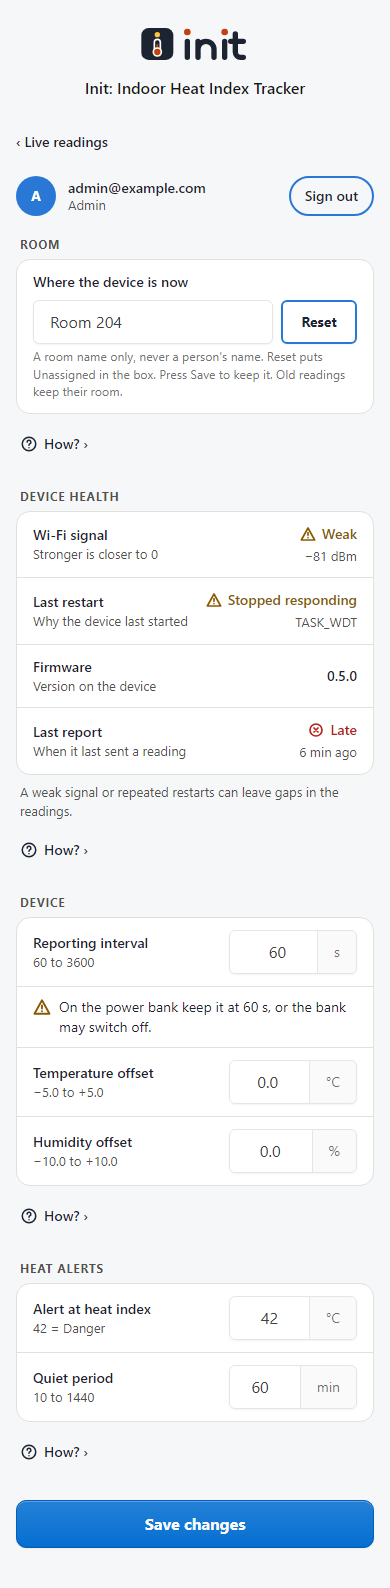
design/admin/health/ref/h-trouble-phone-light.png
