CodenameTempest14/init-heat-monitoring/design/admin/proposal-b/ref/b-not-admin-phone-dark.png

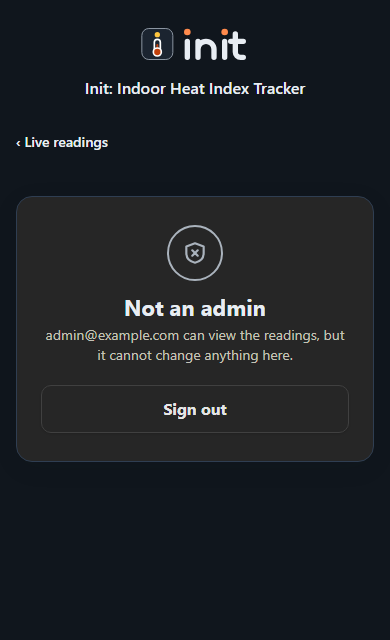
design/admin/proposal-b/ref/b-not-admin-phone-dark.png
