CodenameTempest14/init-heat-monitoring/design/admin/proposal-b/ref/b-not-admin-phone-light.png

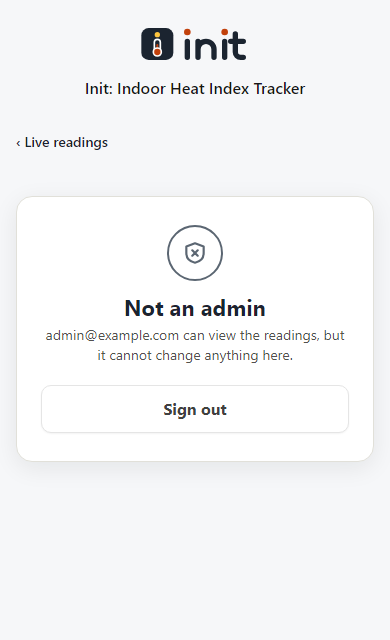
design/admin/proposal-b/ref/b-not-admin-phone-light.png
