CodenameTempest14/init-heat-monitoring/design/admin/proposal-b/ref/b-saved-phone-dark.png

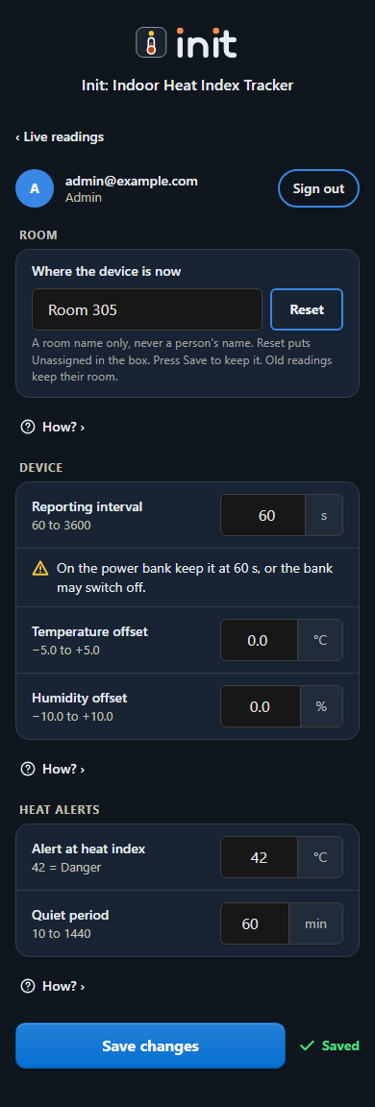
design/admin/proposal-b/ref/b-saved-phone-dark.png
