CodenameTempest14/init-heat-monitoring/design/admin/proposal-b/ref/b-saved-phone-light.png

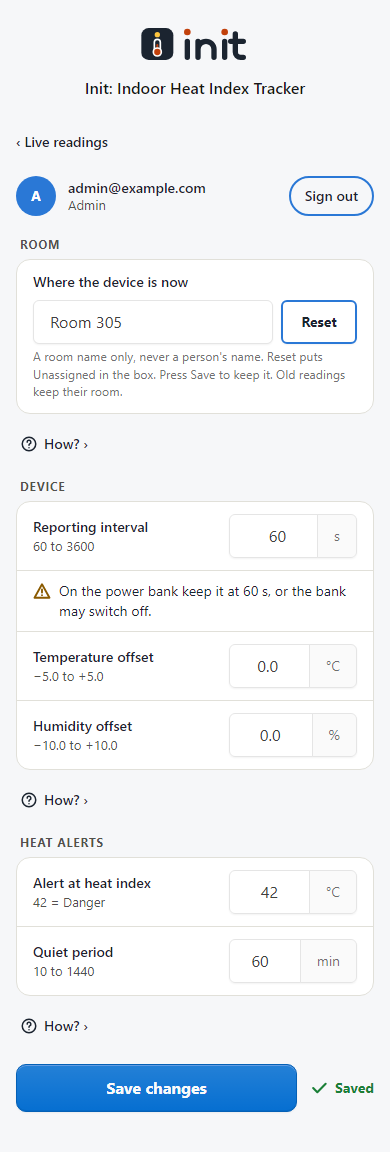
design/admin/proposal-b/ref/b-saved-phone-light.png
