CodenameTempest14/init-heat-monitoring/design/admin/proposal-b/ref/b-settings-phone-light.png

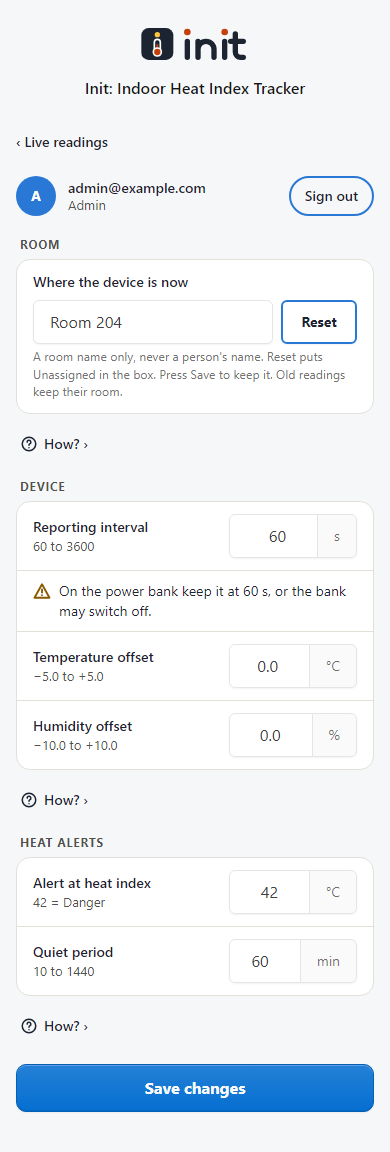
design/admin/proposal-b/ref/b-settings-phone-light.png
