CodenameTempest14/init-heat-monitoring/design/admin/proposal-b/ref/b-sign-in-error-phone-dark.png

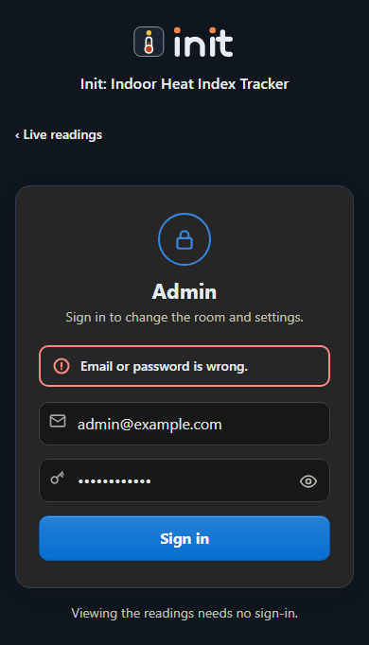
design/admin/proposal-b/ref/b-sign-in-error-phone-dark.png
