CodenameTempest14/init-heat-monitoring/design/admin/proposal-b/ref/b-sign-in-error-phone-light.png

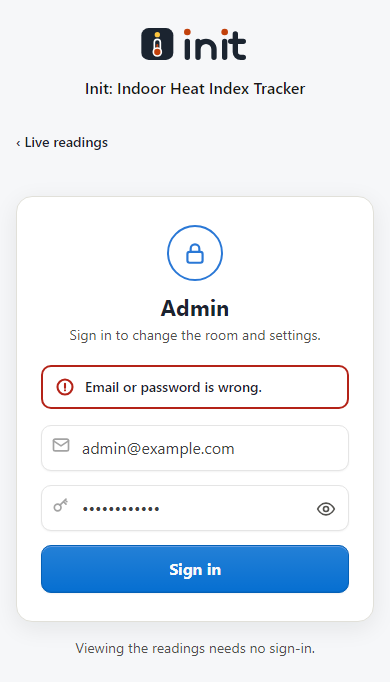
design/admin/proposal-b/ref/b-sign-in-error-phone-light.png
