CodenameTempest14/init-heat-monitoring/design/admin/proposal-b/ref/b-sign-in-phone-dark.png

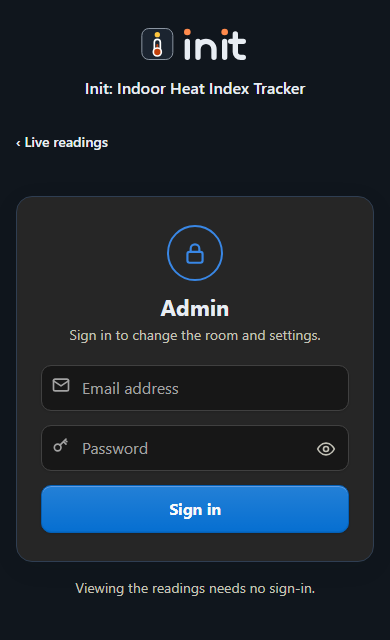
design/admin/proposal-b/ref/b-sign-in-phone-dark.png
