CodenameTempest14/init-heat-monitoring/design/admin/proposal-b/ref/b-sign-in-phone-light.png

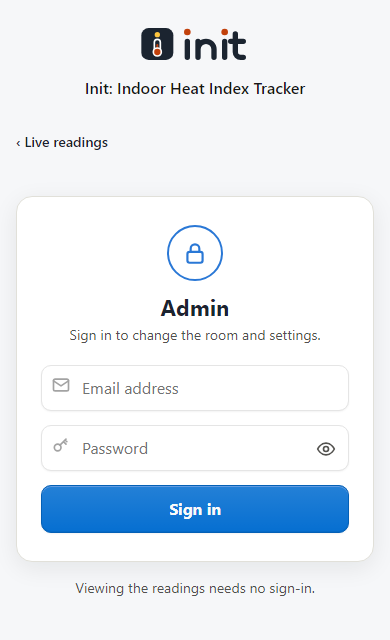
design/admin/proposal-b/ref/b-sign-in-phone-light.png
