CodenameTempest14/init-heat-monitoring/design/admin/ref/admin-not-admin-phone-dark.png

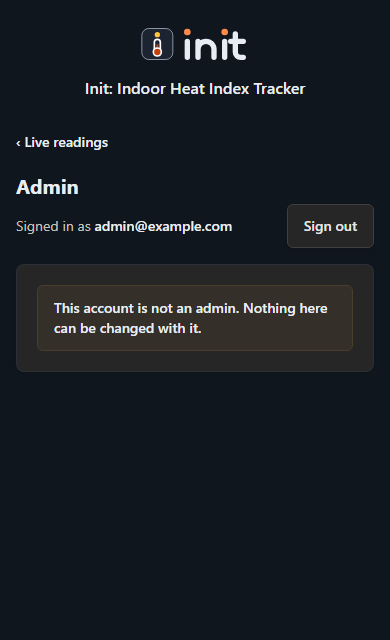
design/admin/ref/admin-not-admin-phone-dark.png
