CodenameTempest14/init-heat-monitoring/design/admin/ref/admin-not-admin-phone-light.png

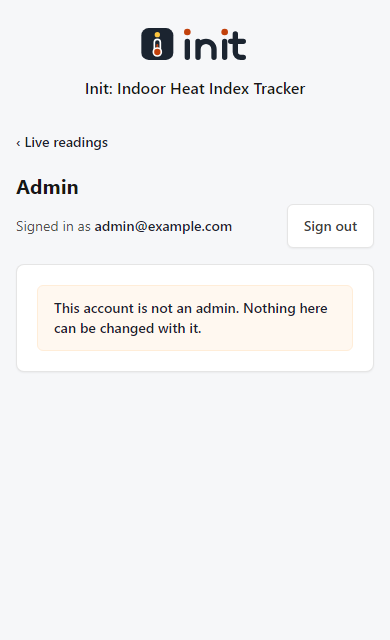
design/admin/ref/admin-not-admin-phone-light.png
