CodenameTempest14/init-heat-monitoring/design/admin/ref/admin-room-saved-phone-dark.png

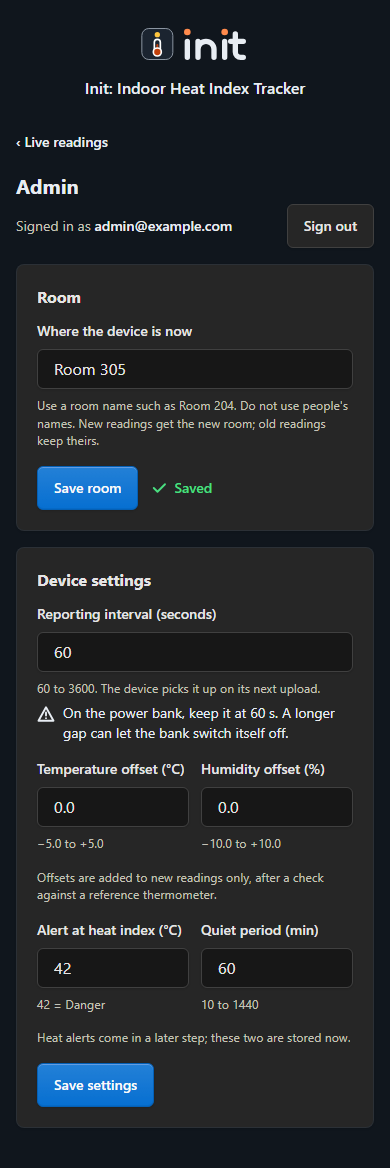
design/admin/ref/admin-room-saved-phone-dark.png
