CodenameTempest14/init-heat-monitoring/design/admin/ref/admin-room-saved-phone-light.png

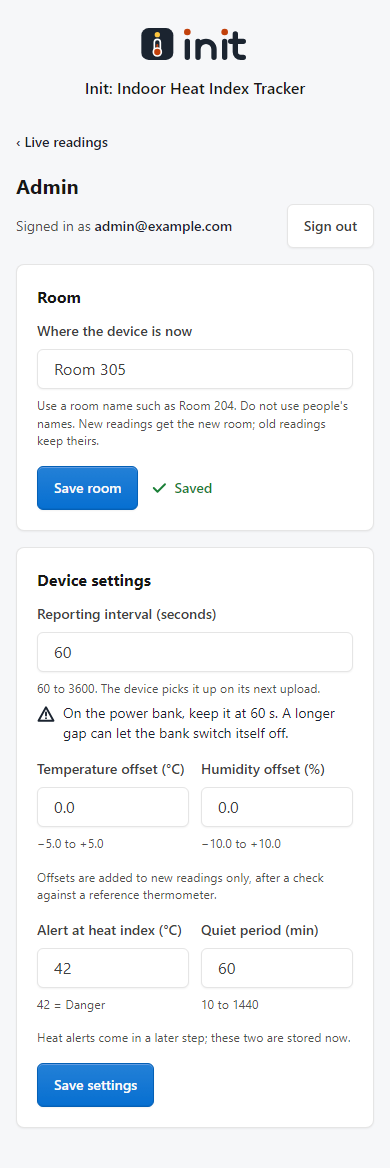
design/admin/ref/admin-room-saved-phone-light.png
