CodenameTempest14/init-heat-monitoring/design/admin/ref/admin-settings-desktop-dark.png

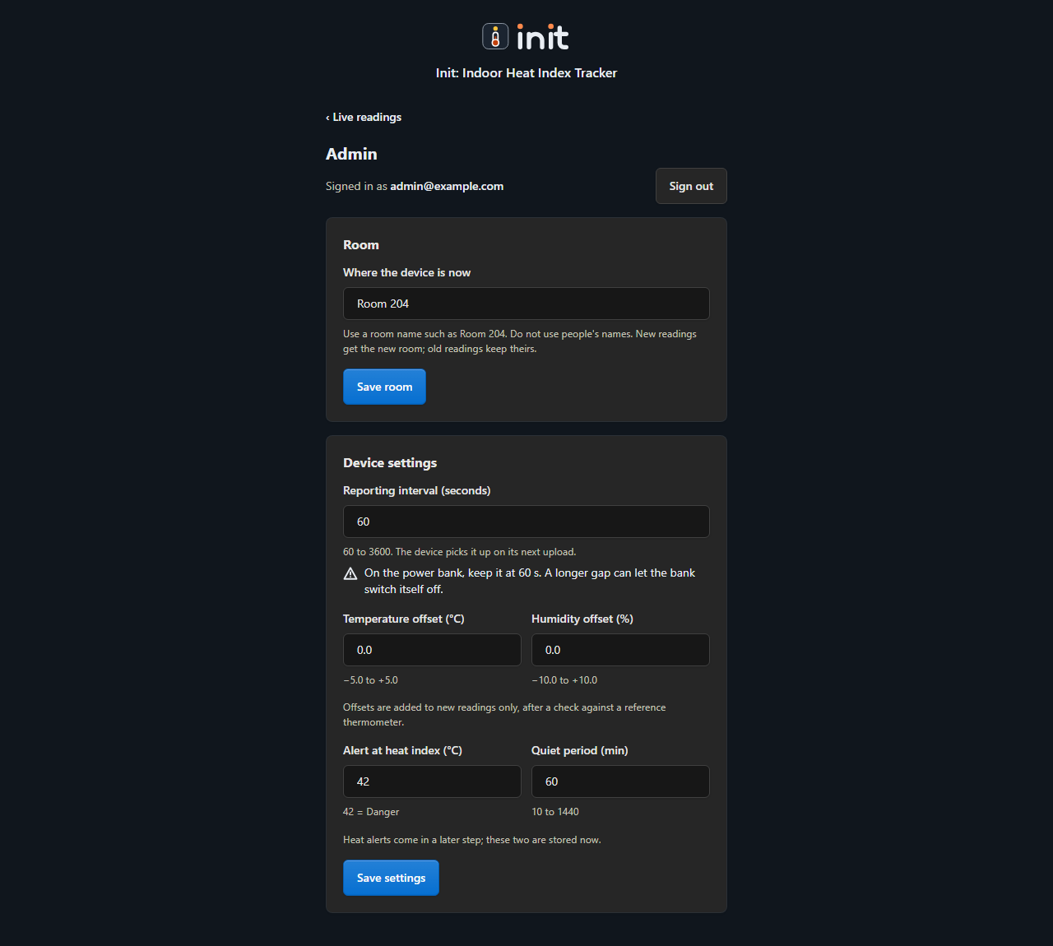
design/admin/ref/admin-settings-desktop-dark.png
