CodenameTempest14/init-heat-monitoring/design/admin/ref/admin-settings-desktop-light.png

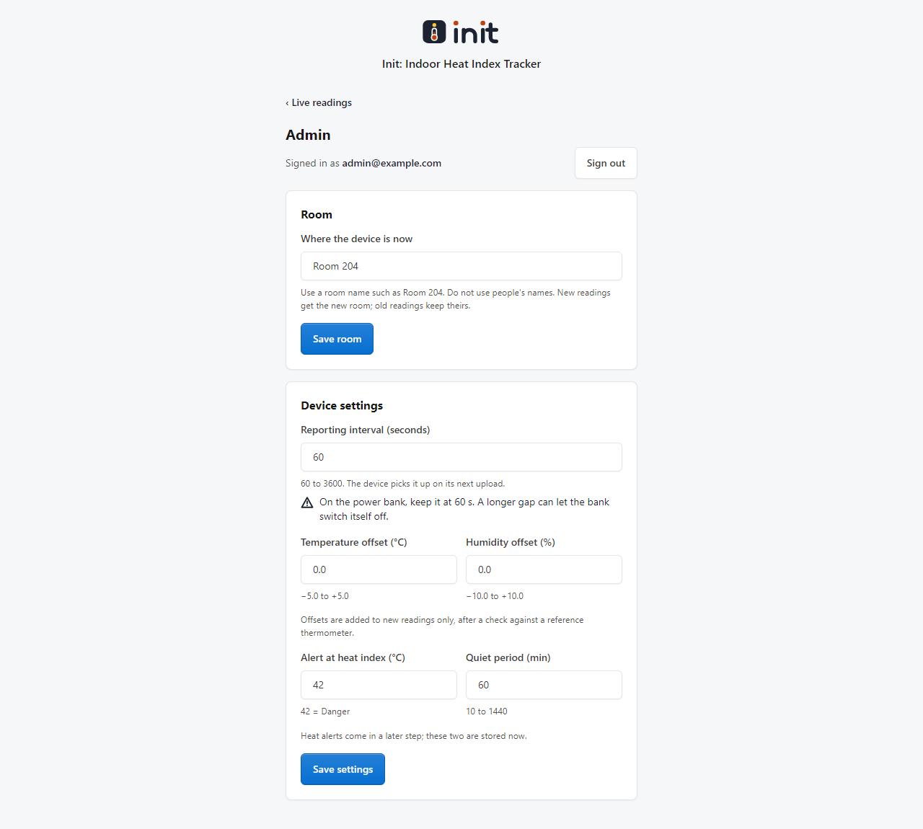
design/admin/ref/admin-settings-desktop-light.png
