CodenameTempest14/init-heat-monitoring/design/admin/ref/admin-sign-in-error-phone-light.png

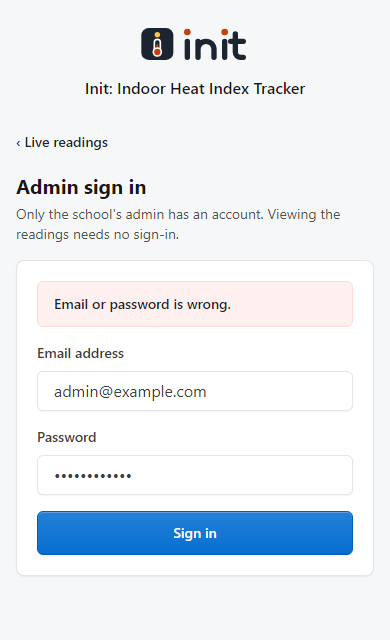
design/admin/ref/admin-sign-in-error-phone-light.png
