CodenameTempest14/init-heat-monitoring/design/admin/ref/admin-sign-in-phone-dark.png

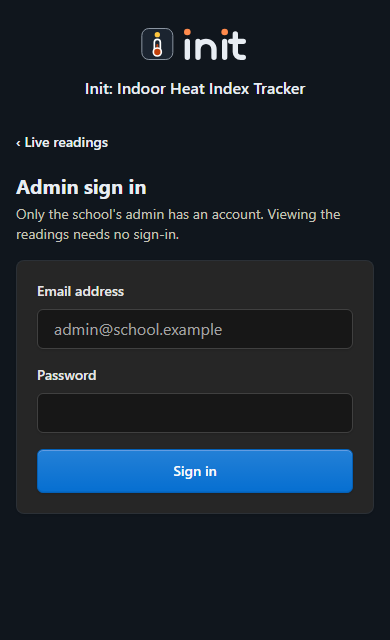
design/admin/ref/admin-sign-in-phone-dark.png
