CodenameTempest14/init-heat-monitoring/design/admin/ref/admin-sign-in-phone-light.png

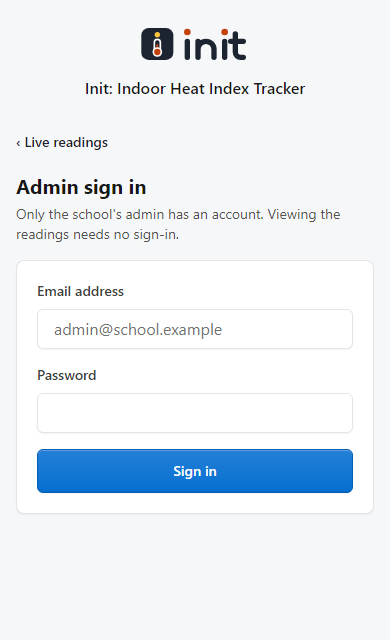
design/admin/ref/admin-sign-in-phone-light.png
