CodenameTempest14/init-heat-monitoring/design/alerts/ref/alerts-blocked-phone-dark.png

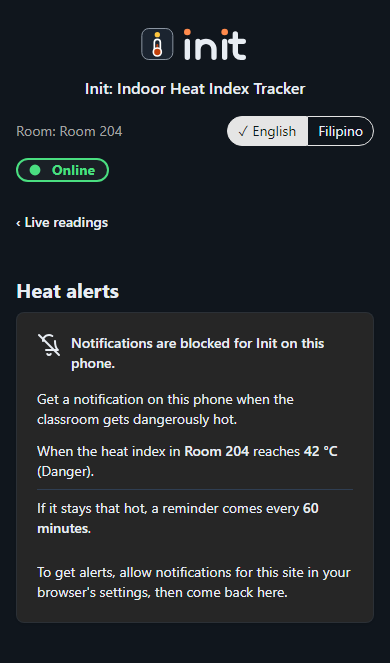
design/alerts/ref/alerts-blocked-phone-dark.png
