CodenameTempest14/init-heat-monitoring/design/alerts/ref/alerts-blocked-phone-light.png

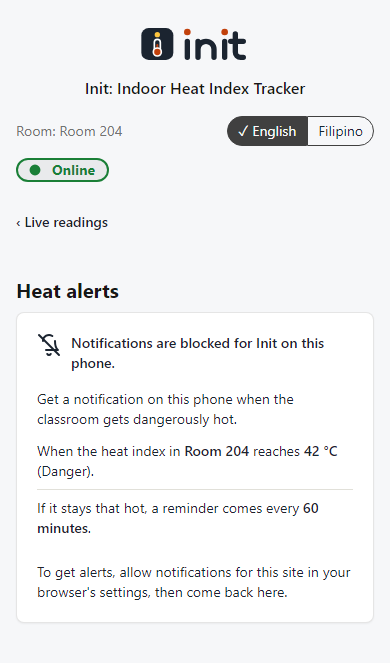
design/alerts/ref/alerts-blocked-phone-light.png
