CodenameTempest14/init-heat-monitoring/design/alerts/ref/alerts-iphone-phone-dark.png

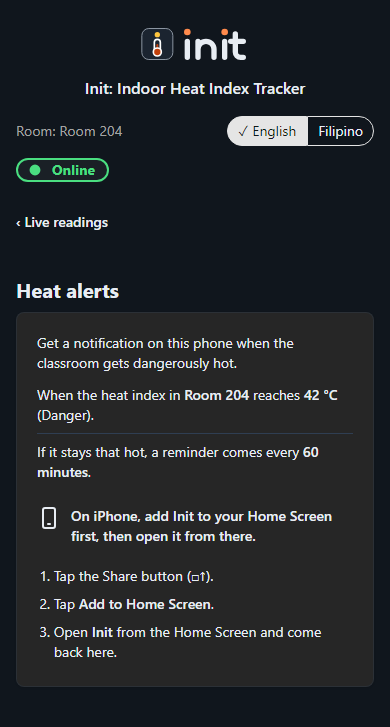
design/alerts/ref/alerts-iphone-phone-dark.png
