CodenameTempest14/init-heat-monitoring/design/alerts/ref/alerts-iphone-phone-light.png

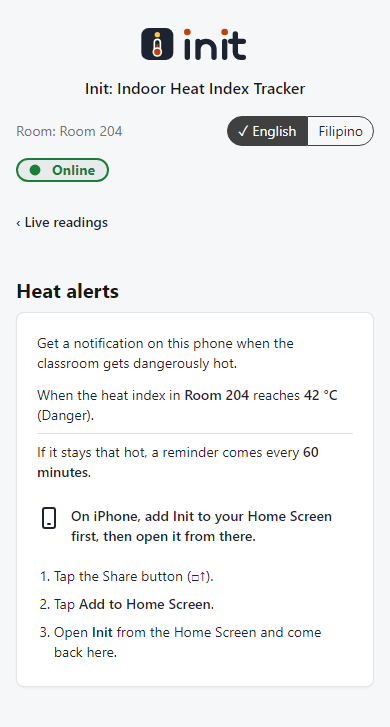
design/alerts/ref/alerts-iphone-phone-light.png
