CodenameTempest14/init-heat-monitoring/design/alerts/ref/alerts-off-desktop-dark.png

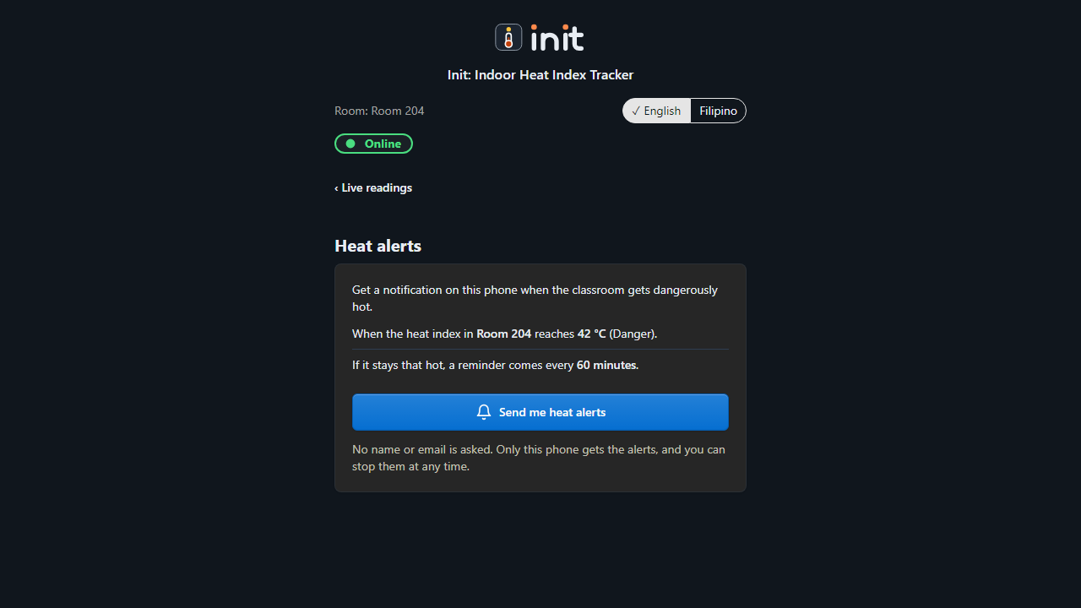
design/alerts/ref/alerts-off-desktop-dark.png
