CodenameTempest14/init-heat-monitoring/design/alerts/ref/alerts-off-desktop-light.png

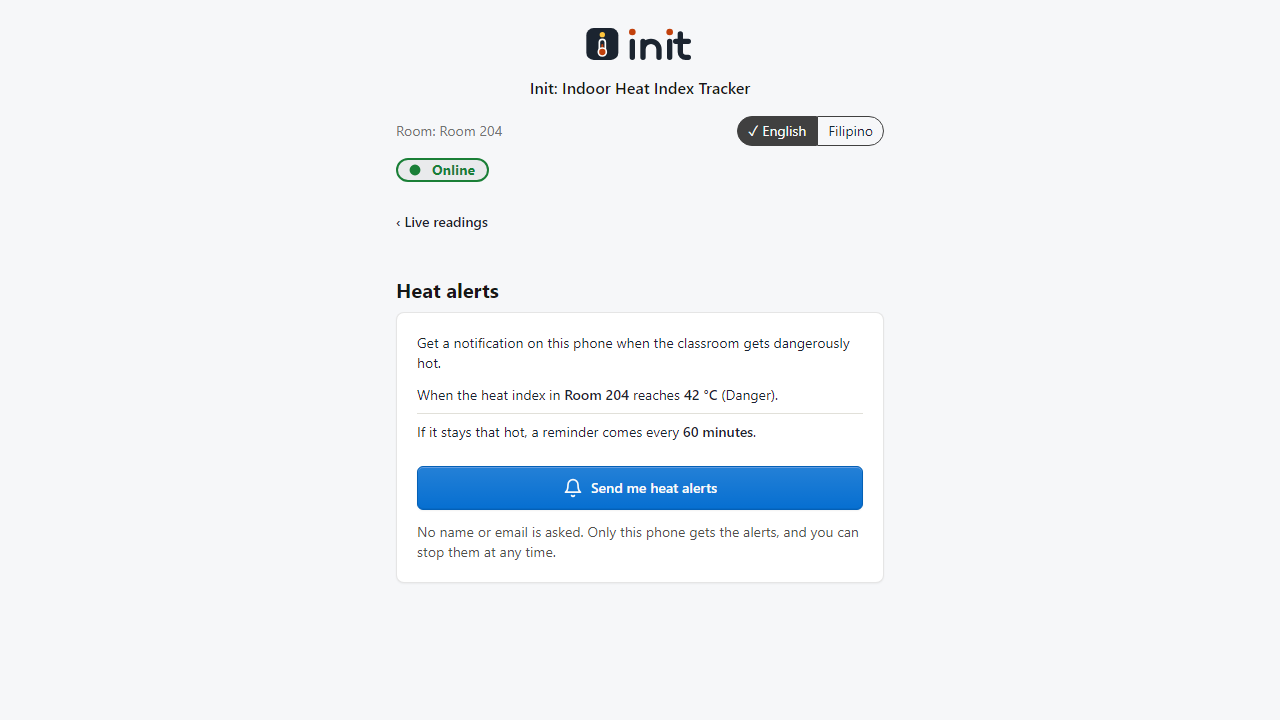
design/alerts/ref/alerts-off-desktop-light.png
