CodenameTempest14/init-heat-monitoring/design/alerts/ref/alerts-off-phone-dark.png

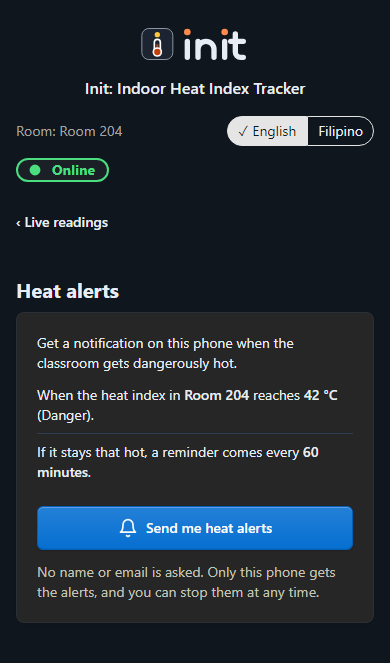
design/alerts/ref/alerts-off-phone-dark.png
