CodenameTempest14/init-heat-monitoring/design/alerts/ref/alerts-off-phone-light.png

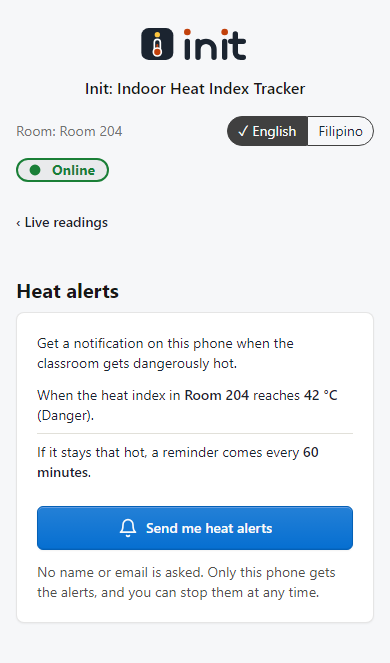
design/alerts/ref/alerts-off-phone-light.png
