CodenameTempest14/init-heat-monitoring/design/alerts/ref/alerts-on-phone-dark.png

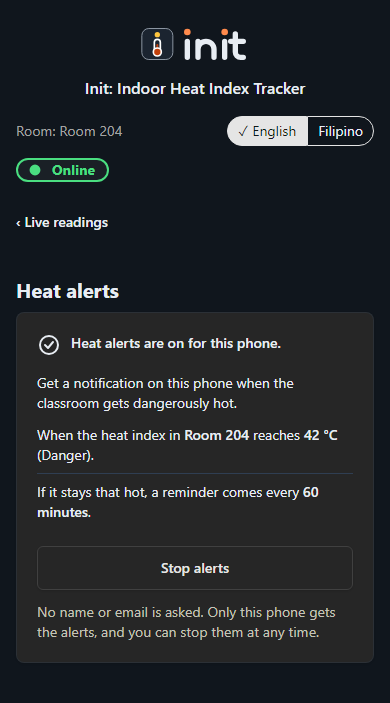
design/alerts/ref/alerts-on-phone-dark.png
