CodenameTempest14/init-heat-monitoring/design/alerts/ref/alerts-on-phone-light.png

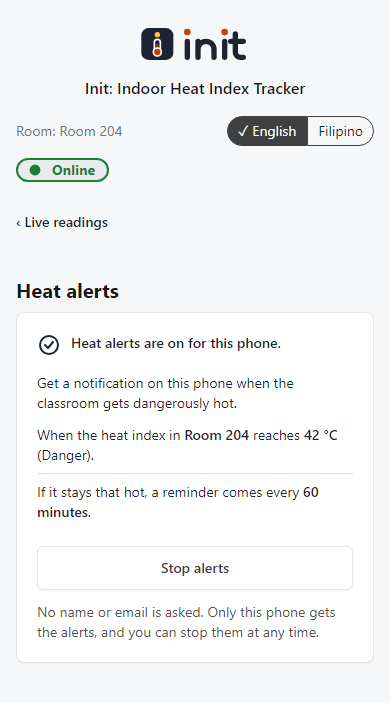
design/alerts/ref/alerts-on-phone-light.png
