CodenameTempest14/init-heat-monitoring/design/alerts/ref/alerts-unsupported-phone-dark.png

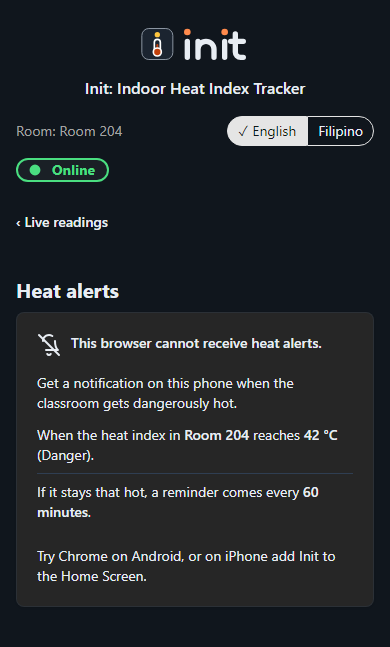
design/alerts/ref/alerts-unsupported-phone-dark.png
