CodenameTempest14/init-heat-monitoring/design/alerts/ref/alerts-unsupported-phone-light.png

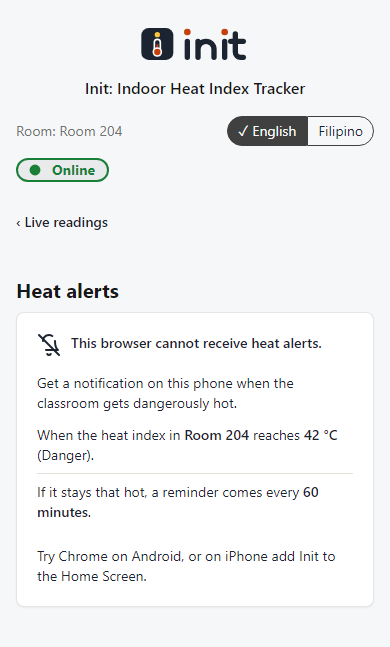
design/alerts/ref/alerts-unsupported-phone-light.png
