CodenameTempest14/init-heat-monitoring/design/alerts/ref/home-link-phone-dark.png

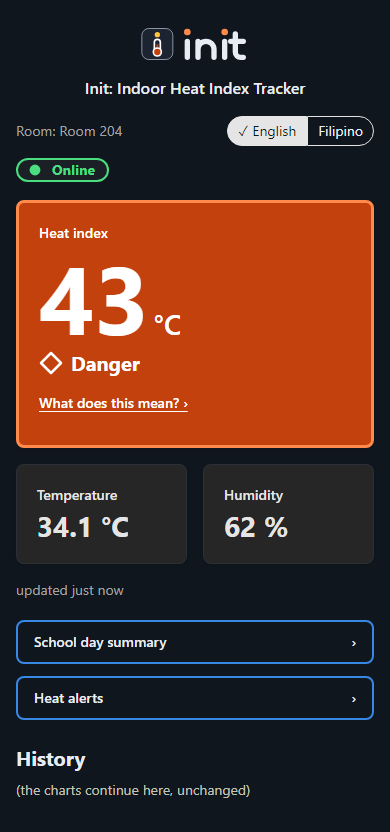
design/alerts/ref/home-link-phone-dark.png
