CodenameTempest14/init-heat-monitoring/design/alerts/ref/home-link-phone-light.png

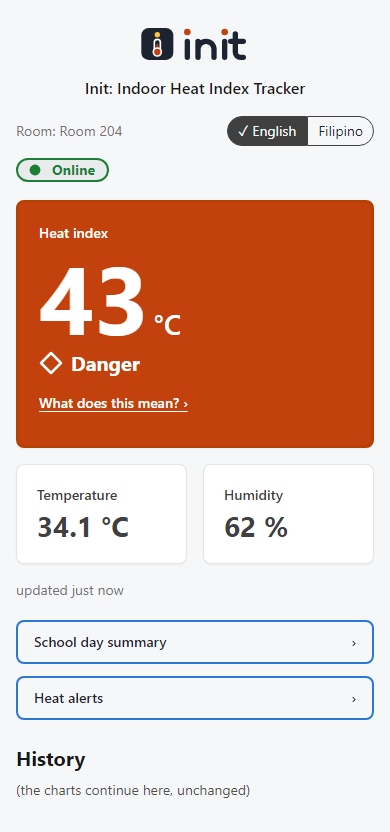
design/alerts/ref/home-link-phone-light.png
