CodenameTempest14/init-heat-monitoring/design/brand/preview.png

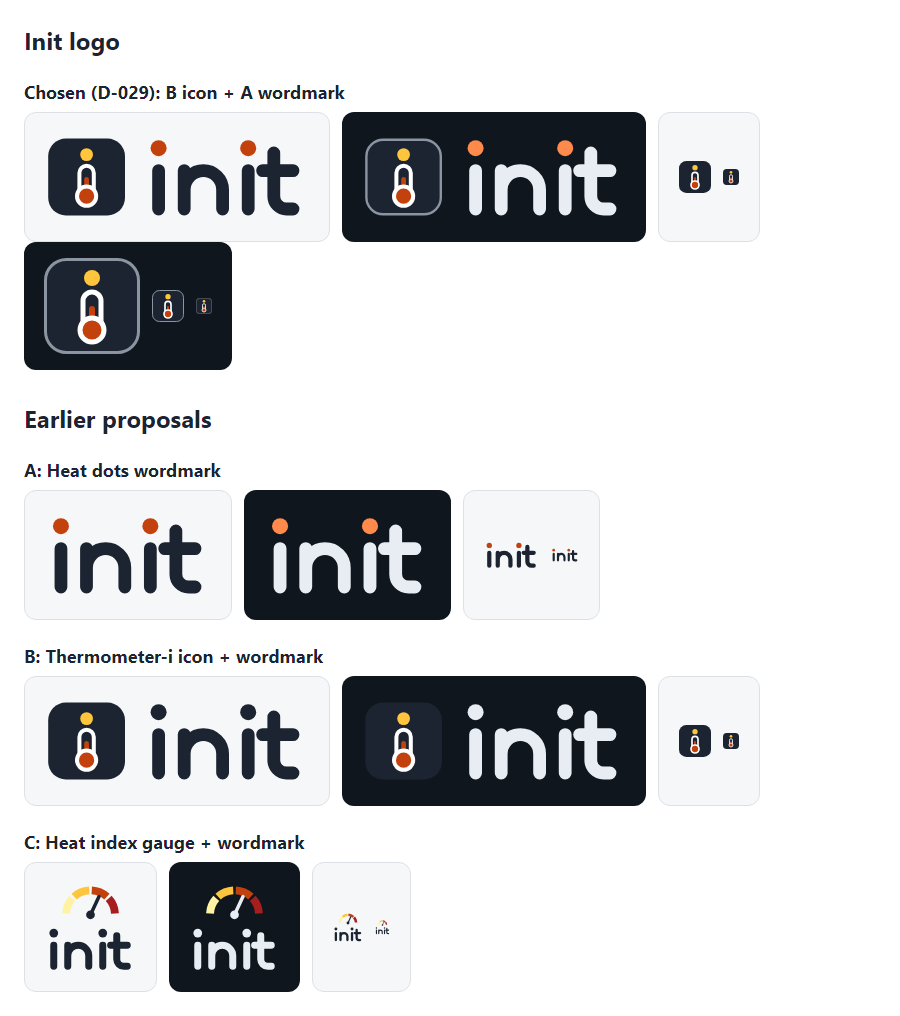
design/brand/preview.png
