CodenameTempest14/init-heat-monitoring/design/heat-info/ref/heat-desktop-light.png

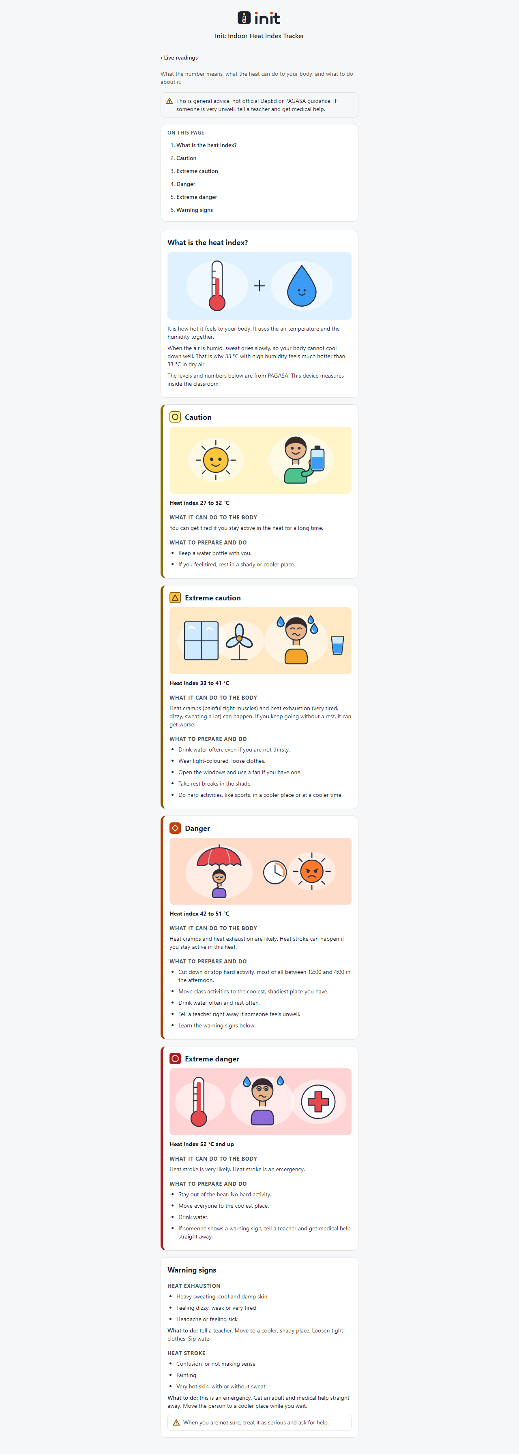
design/heat-info/ref/heat-desktop-light.png
