CodenameTempest14/init-heat-monitoring/design/heat-info/ref/heat-phone-dark.png

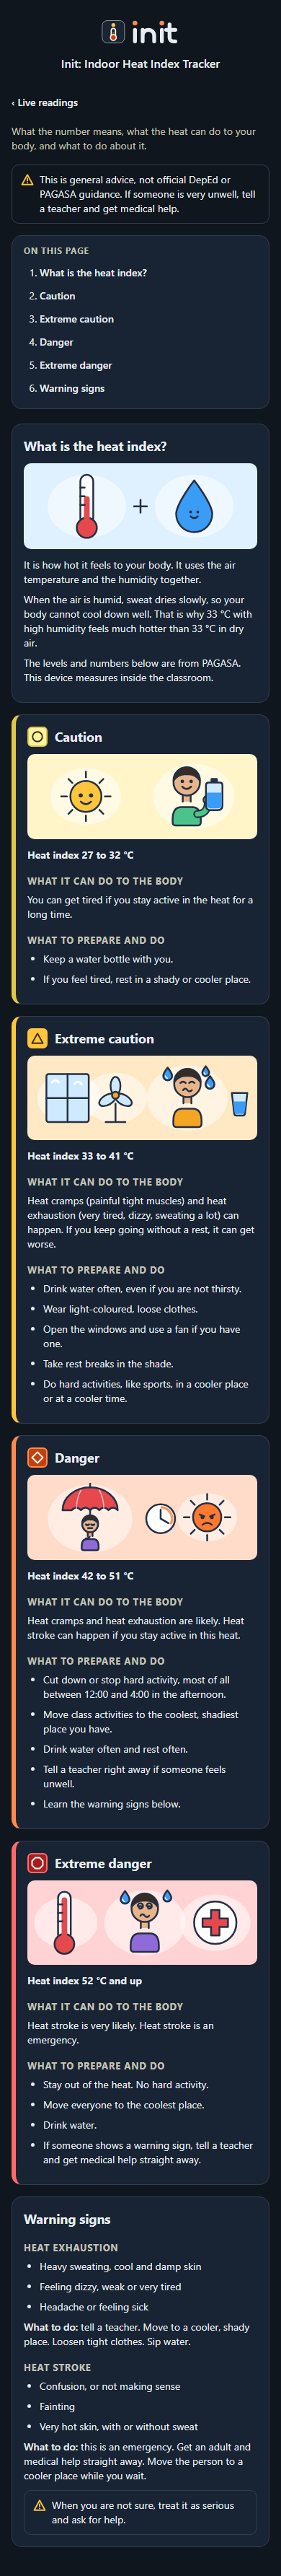
design/heat-info/ref/heat-phone-dark.png
