CodenameTempest14/init-heat-monitoring/design/heat-info/ref/heat-phone-light.png

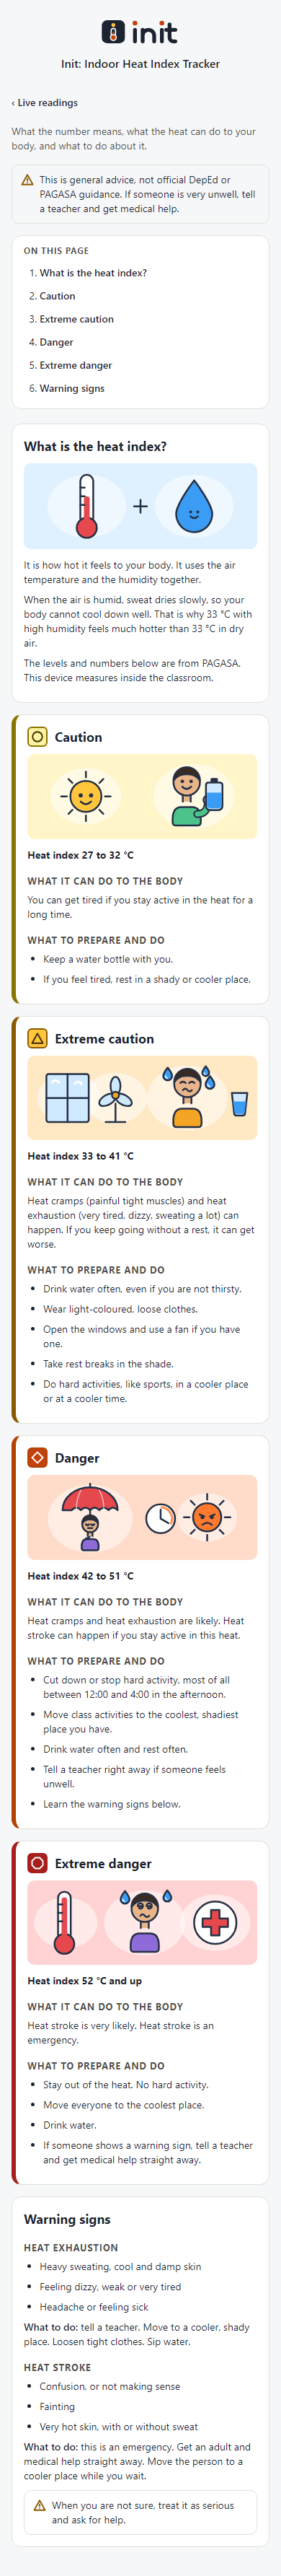
design/heat-info/ref/heat-phone-light.png
