CodenameTempest14/init-heat-monitoring/design/home-cards/ref/below-range-phone-dark.png

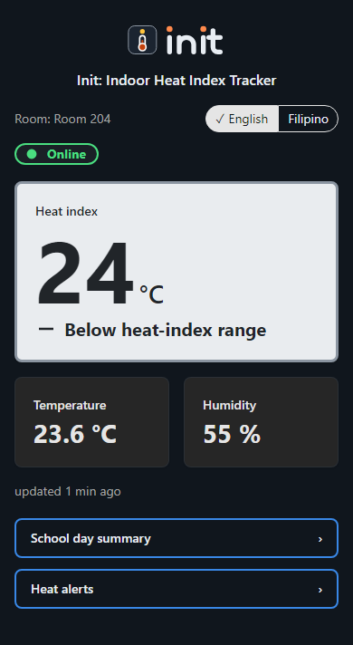
design/home-cards/ref/below-range-phone-dark.png
