CodenameTempest14/init-heat-monitoring/design/home-cards/ref/below-range-phone-light.png

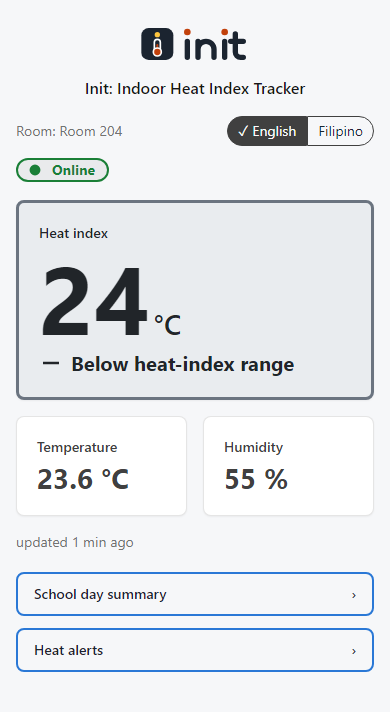
design/home-cards/ref/below-range-phone-light.png
