CodenameTempest14/init-heat-monitoring/design/home-cards/ref/caution-phone-dark.png

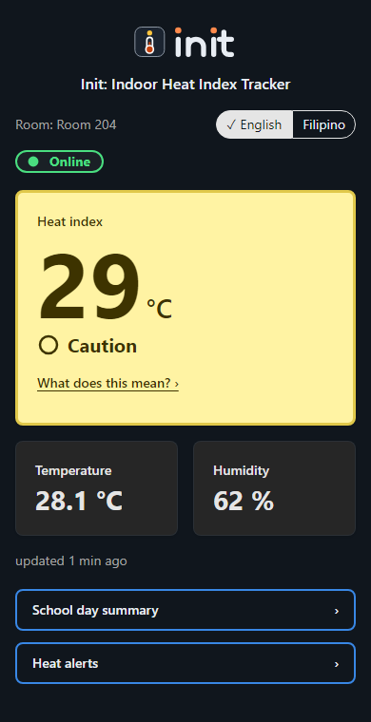
design/home-cards/ref/caution-phone-dark.png
