CodenameTempest14/init-heat-monitoring/design/home-cards/ref/caution-phone-light.png

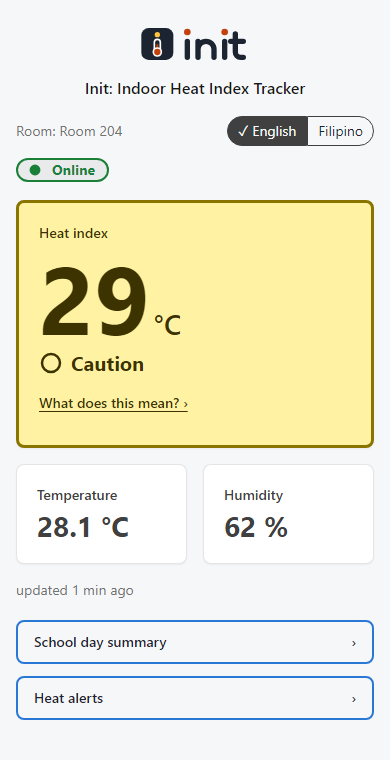
design/home-cards/ref/caution-phone-light.png
