CodenameTempest14/init-heat-monitoring/design/home-cards/ref/danger-desktop-light.png

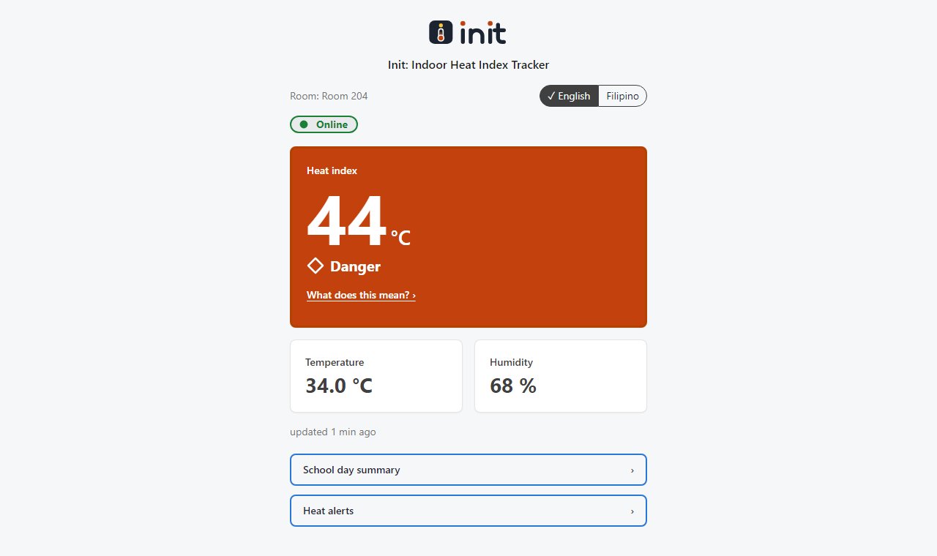
design/home-cards/ref/danger-desktop-light.png
