CodenameTempest14/init-heat-monitoring/design/home-cards/ref/danger-phone-dark.png

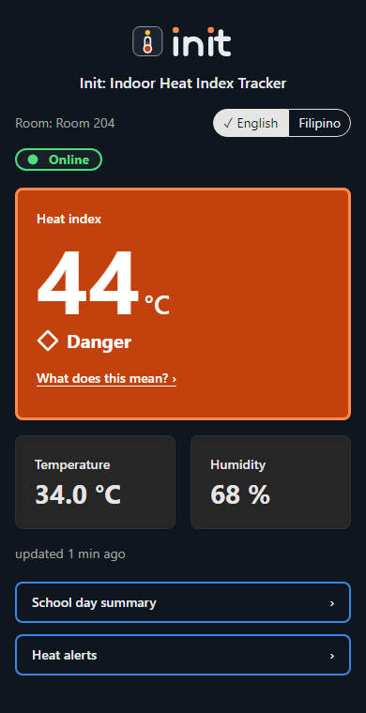
design/home-cards/ref/danger-phone-dark.png
