CodenameTempest14/init-heat-monitoring/design/home-cards/ref/danger-phone-light.png

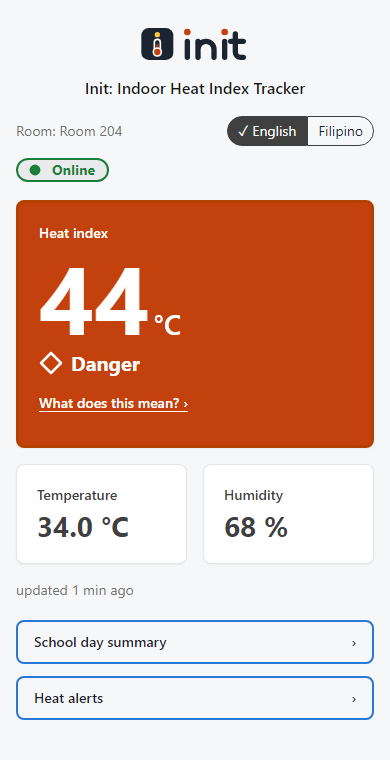
design/home-cards/ref/danger-phone-light.png
