CodenameTempest14/init-heat-monitoring/design/home-cards/ref/extreme-caution-desktop-dark.png

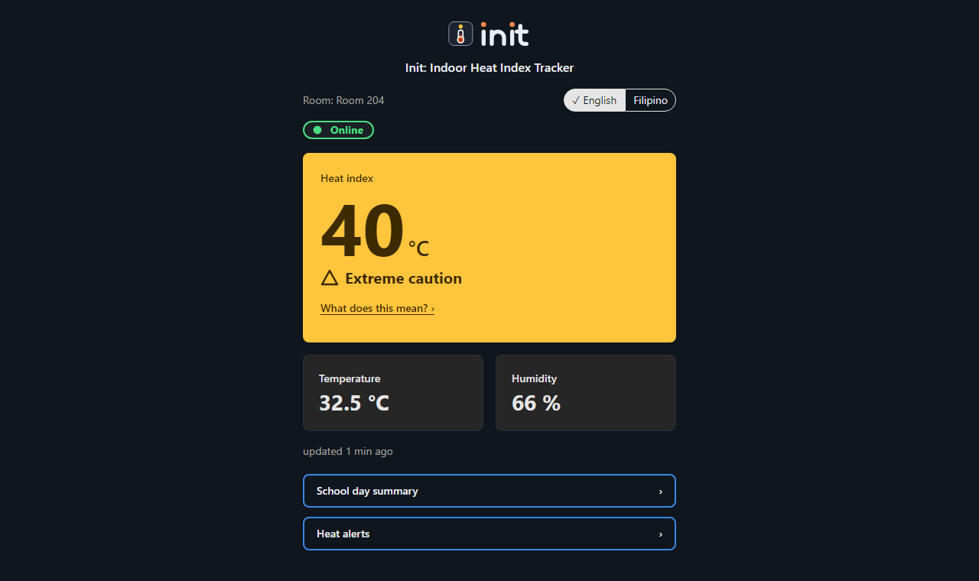
design/home-cards/ref/extreme-caution-desktop-dark.png
