CodenameTempest14/init-heat-monitoring/design/home-cards/ref/extreme-caution-desktop-light.png

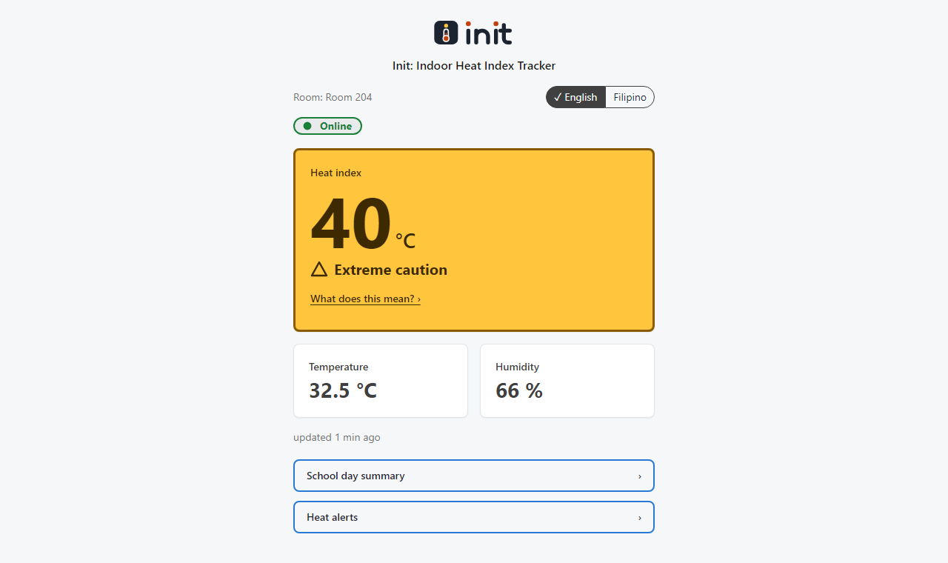
design/home-cards/ref/extreme-caution-desktop-light.png
