CodenameTempest14/init-heat-monitoring/design/home-cards/ref/extreme-caution-phone-light.png

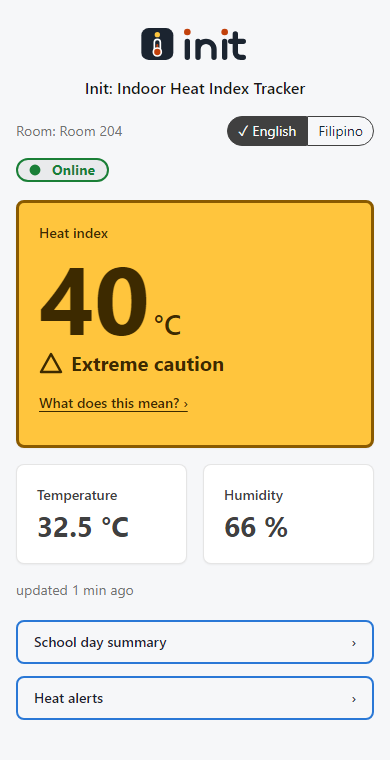
design/home-cards/ref/extreme-caution-phone-light.png
