CodenameTempest14/init-heat-monitoring/design/language-toggle/ref/home-fil-light.png

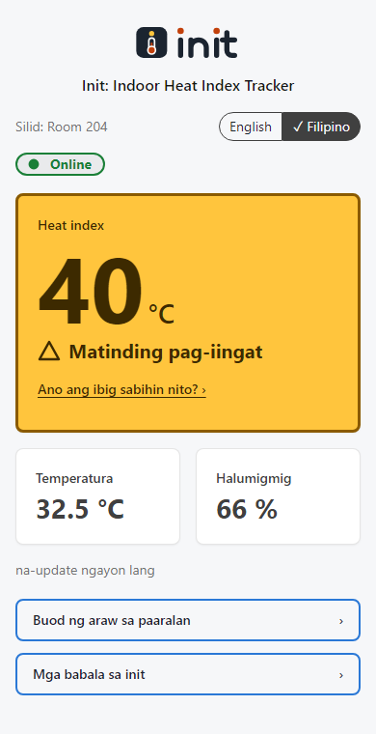
design/language-toggle/ref/home-fil-light.png
