CodenameTempest14/init-heat-monitoring/design/language-toggle/ref/home-fil-longest-dark.png

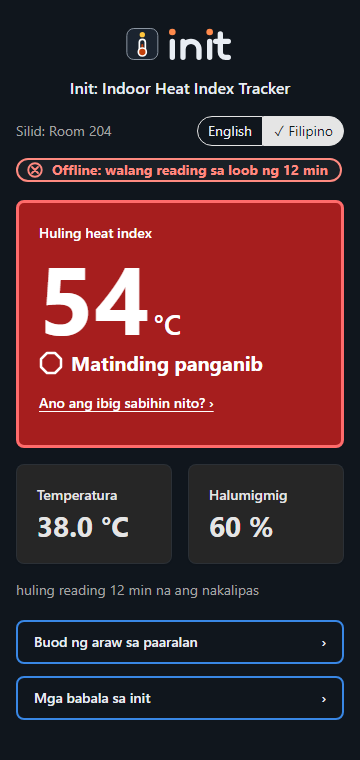
design/language-toggle/ref/home-fil-longest-dark.png
