CodenameTempest14/init-heat-monitoring/design/language-toggle/ref/home-fil-longest-light.png

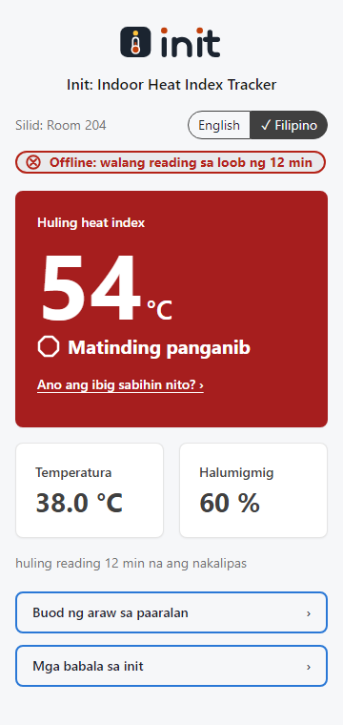
design/language-toggle/ref/home-fil-longest-light.png
