CodenameTempest14/init-heat-monitoring/design/oled/preview/OLED-01-caution@4x.png

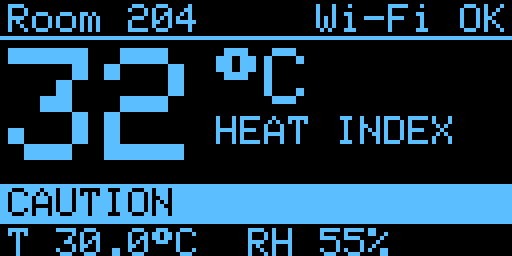
design/oled/preview/OLED-01-caution@4x.png
