CodenameTempest14/init-heat-monitoring/design/oled/preview/OLED-01-danger@4x.png

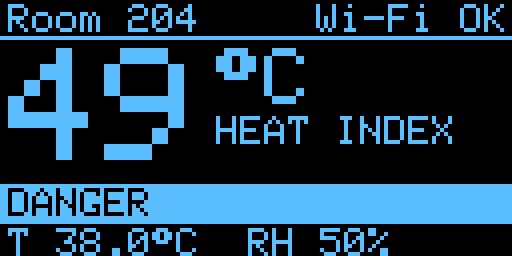
design/oled/preview/OLED-01-danger@4x.png
