CodenameTempest14/init-heat-monitoring/design/oled/preview/OLED-01-extreme-caution@4x.png

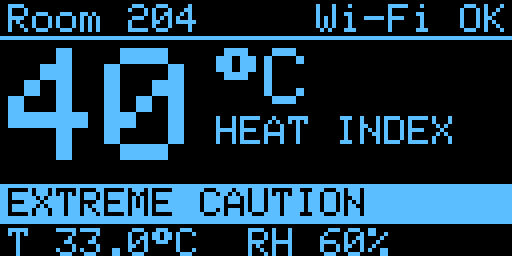
design/oled/preview/OLED-01-extreme-caution@4x.png
