CodenameTempest14/init-heat-monitoring/design/oled/preview/OLED-02@4x.png

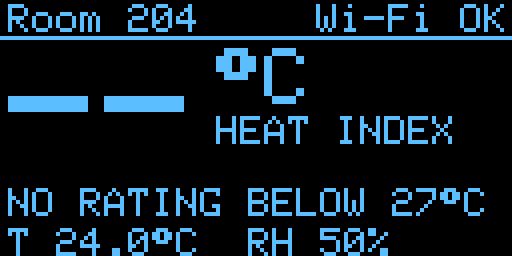
design/oled/preview/OLED-02@4x.png
