CodenameTempest14/init-heat-monitoring/design/oled/preview/OLED-04@4x.png

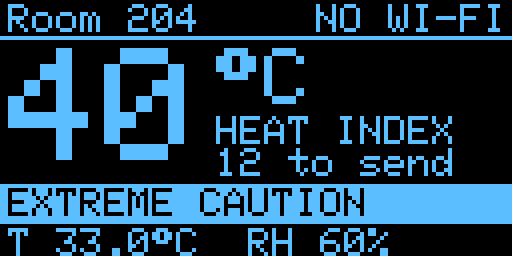
design/oled/preview/OLED-04@4x.png
