CodenameTempest14/init-heat-monitoring/design/oled/preview/OLED-05@4x.png

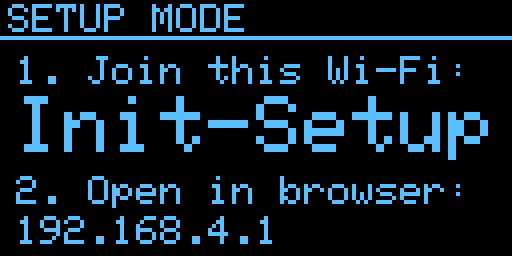
design/oled/preview/OLED-05@4x.png
