CodenameTempest14/init-heat-monitoring/design/oled/preview/OLED-06@4x.png

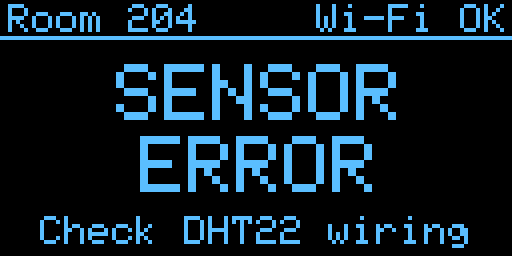
design/oled/preview/OLED-06@4x.png
