CodenameTempest14/init-heat-monitoring/design/pwa/ref/header-phone-dark.png

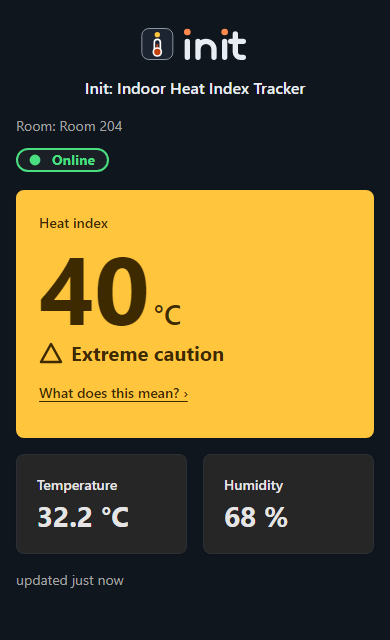
design/pwa/ref/header-phone-dark.png
