CodenameTempest14/init-heat-monitoring/design/pwa/ref/header-phone-light.png

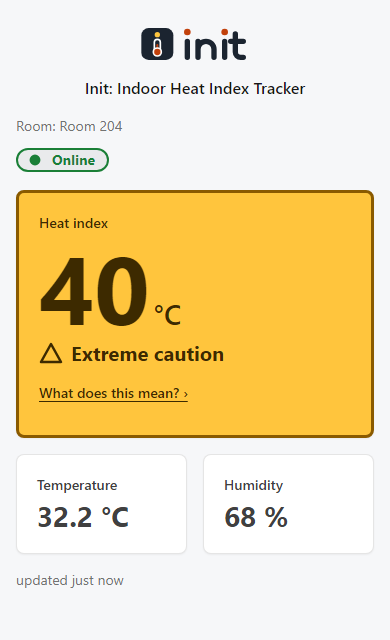
design/pwa/ref/header-phone-light.png
