CodenameTempest14/init-heat-monitoring/design/qr-kiosk/ref/kiosk-phone.png

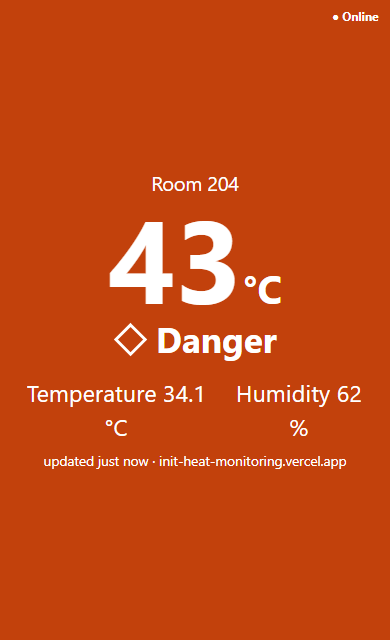
design/qr-kiosk/ref/kiosk-phone.png
