CodenameTempest14/init-heat-monitoring/design/qr-kiosk/ref/kiosk-tv.png

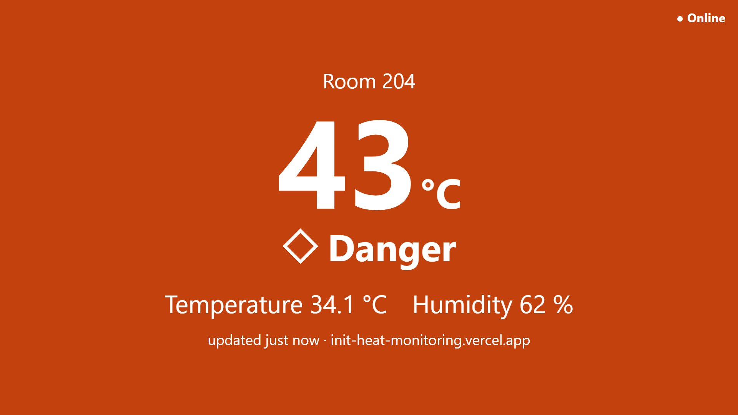
design/qr-kiosk/ref/kiosk-tv.png
