CodenameTempest14/init-heat-monitoring/design/qr-kiosk/ref/poster-a4.png

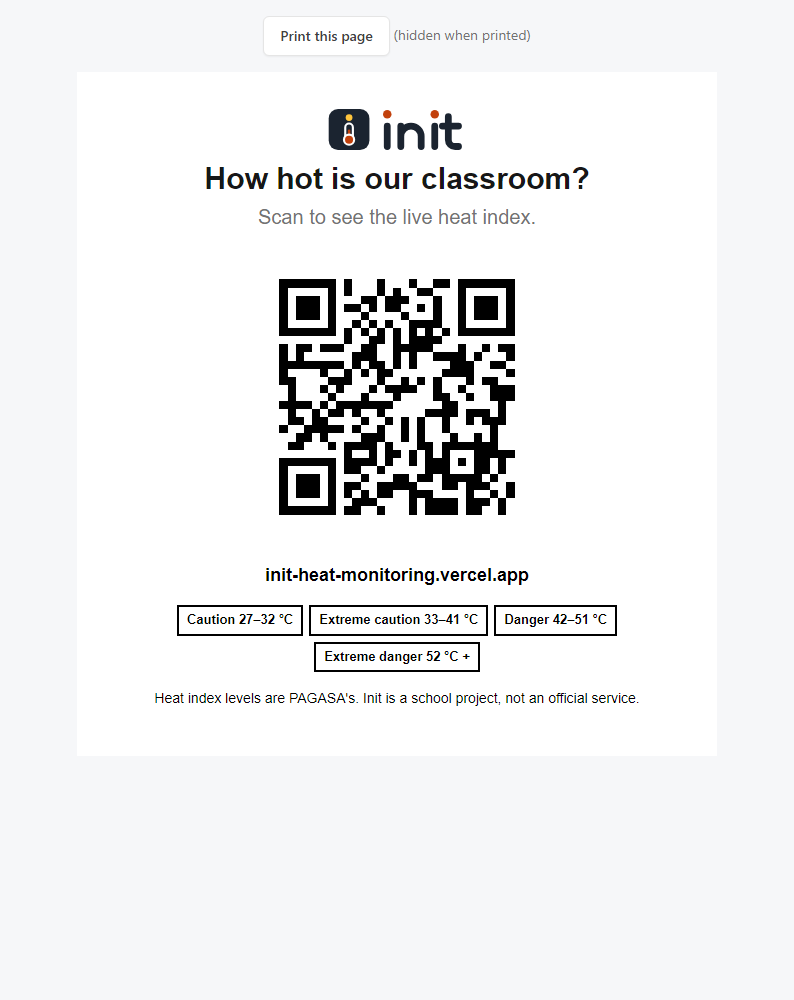
design/qr-kiosk/ref/poster-a4.png
