CodenameTempest14/init-heat-monitoring/design/room-reset-readings/ref/f23-reset-after-phone-dark.png

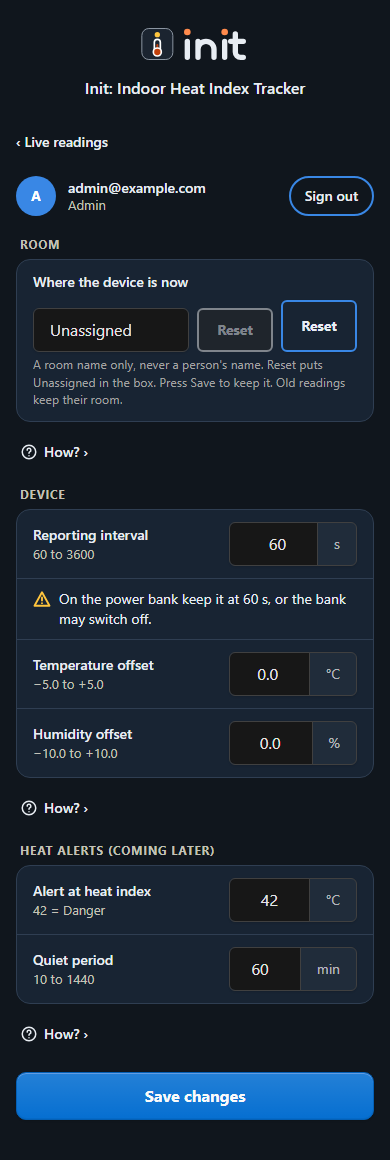
design/room-reset-readings/ref/f23-reset-after-phone-dark.png
