CodenameTempest14/init-heat-monitoring/design/room-reset-readings/ref/f24-readings-empty-phone-light.png

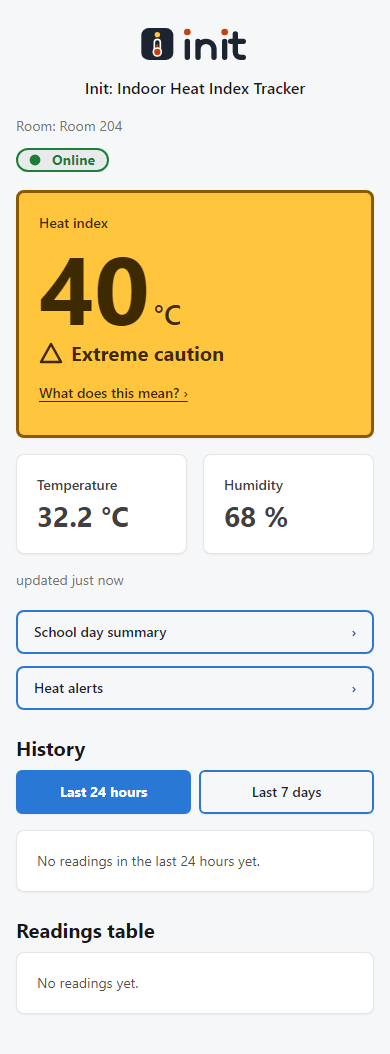
design/room-reset-readings/ref/f24-readings-empty-phone-light.png
