CodenameTempest14/init-heat-monitoring/design/school-day/ref/school-day-desktop-dark.png

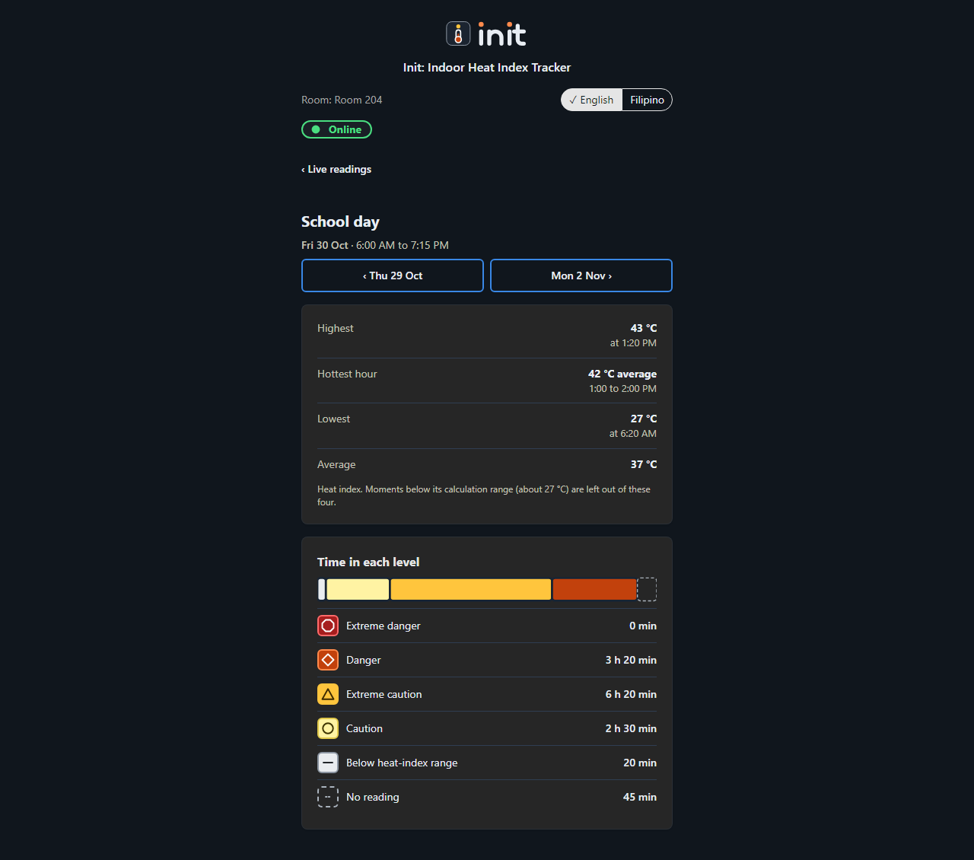
design/school-day/ref/school-day-desktop-dark.png
