CodenameTempest14/init-heat-monitoring/design/school-day/ref/school-day-desktop-light.png

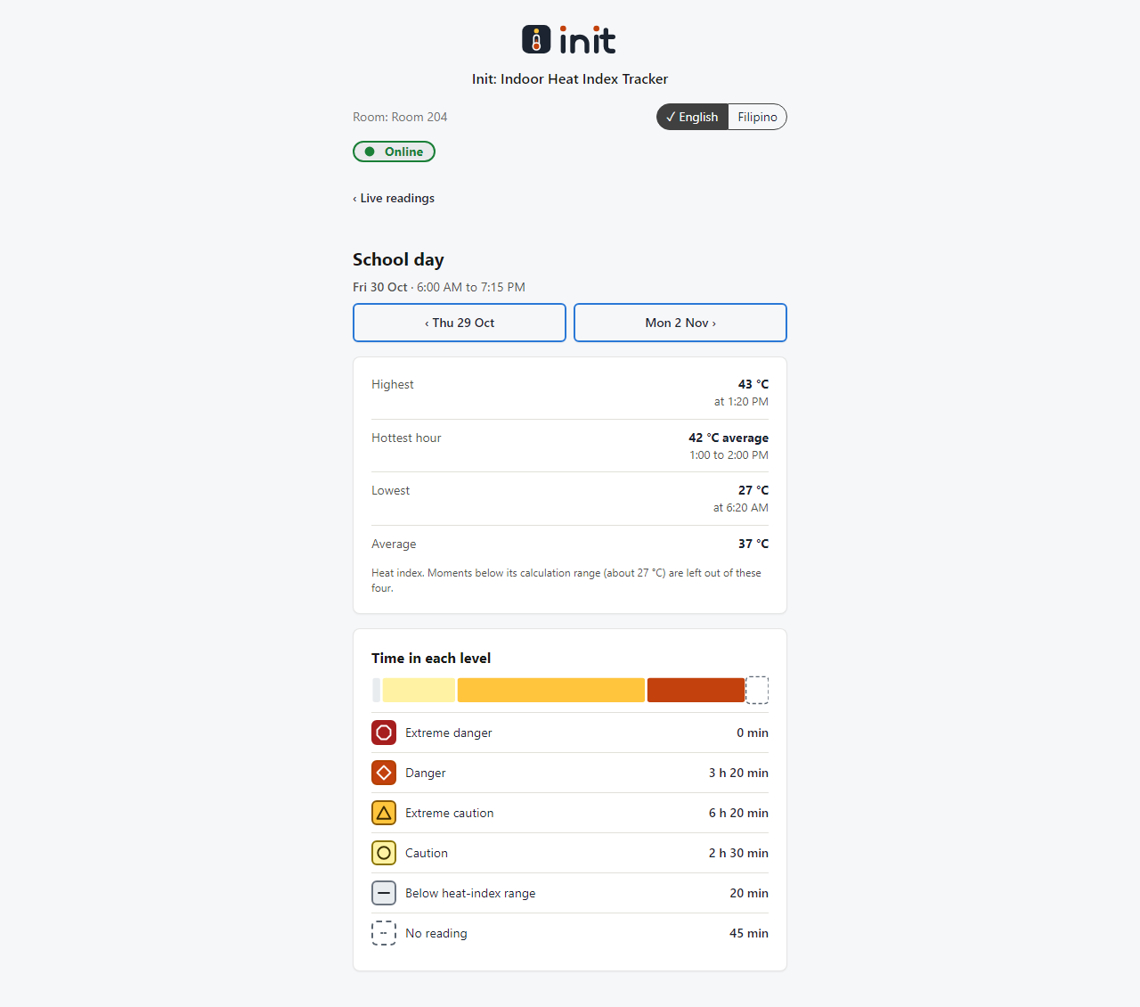
design/school-day/ref/school-day-desktop-light.png
