CodenameTempest14/init-heat-monitoring/design/school-day/ref/school-day-phone-dark.png

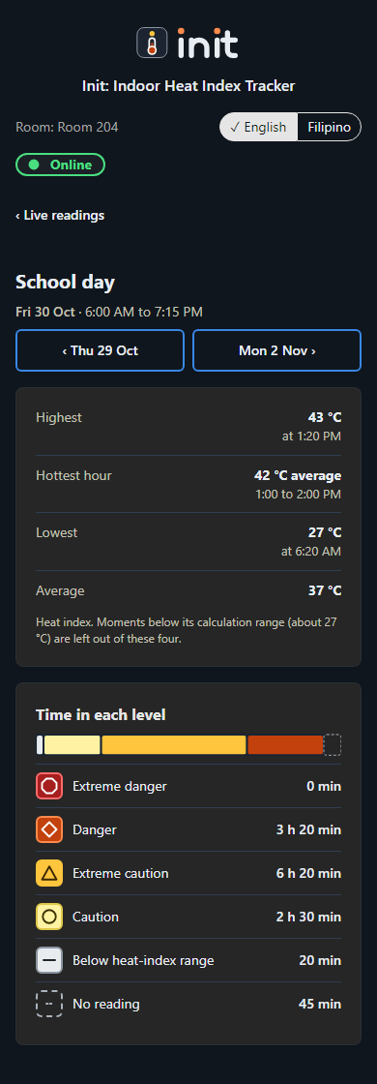
design/school-day/ref/school-day-phone-dark.png
