CodenameTempest14/init-heat-monitoring/design/school-day/ref/school-day-phone-light.png

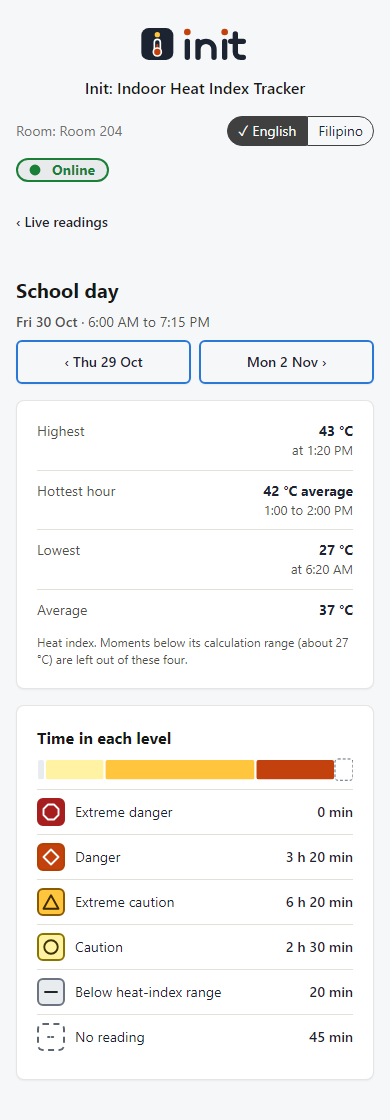
design/school-day/ref/school-day-phone-light.png
