CodenameTempest14/init-heat-monitoring/design/school-day/ref/school-empty-phone-dark.png

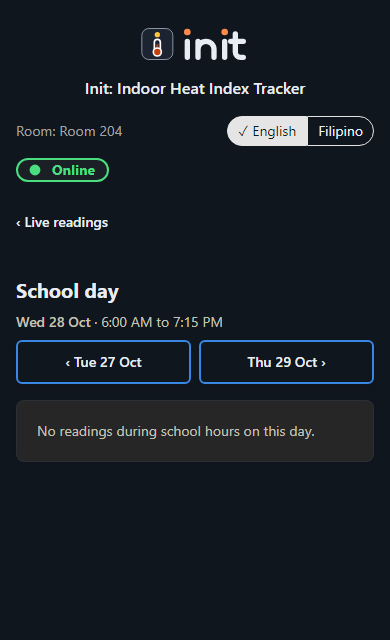
design/school-day/ref/school-empty-phone-dark.png
