CodenameTempest14/init-heat-monitoring/design/school-day/ref/school-empty-phone-light.png

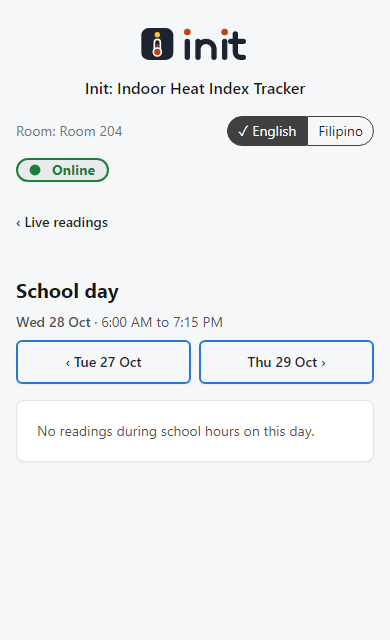
design/school-day/ref/school-empty-phone-light.png
