CodenameTempest14/init-heat-monitoring/design/school-day/ref/school-today-phone-dark.png

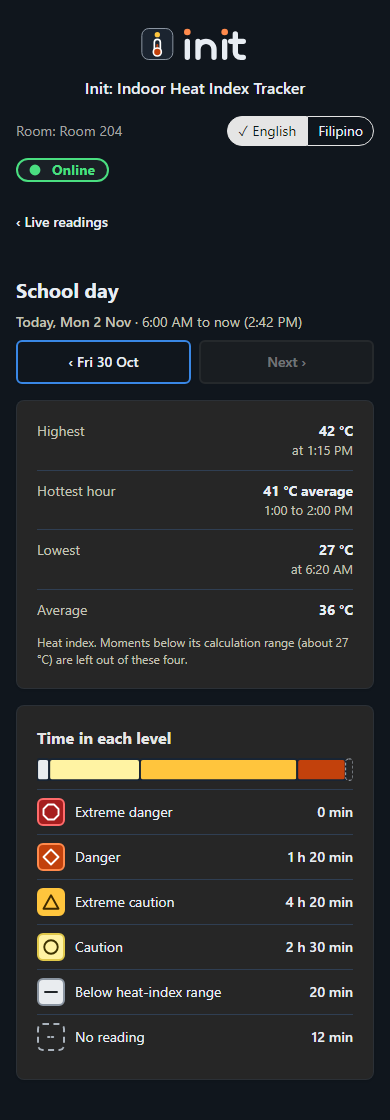
design/school-day/ref/school-today-phone-dark.png
