CodenameTempest14/init-heat-monitoring/design/templates/cards-desktop.png

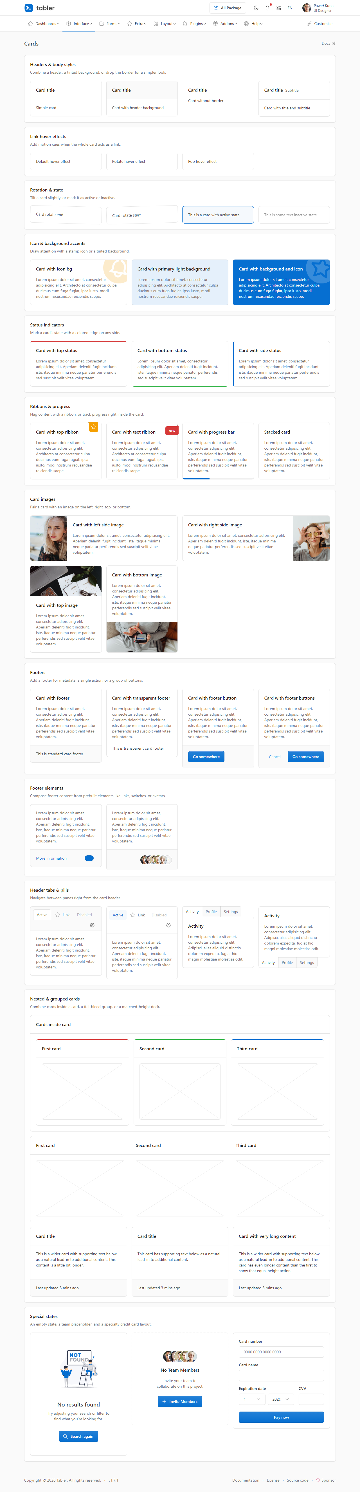
design/templates/cards-desktop.png
