CodenameTempest14/init-heat-monitoring/design/templates/cards-phone.png

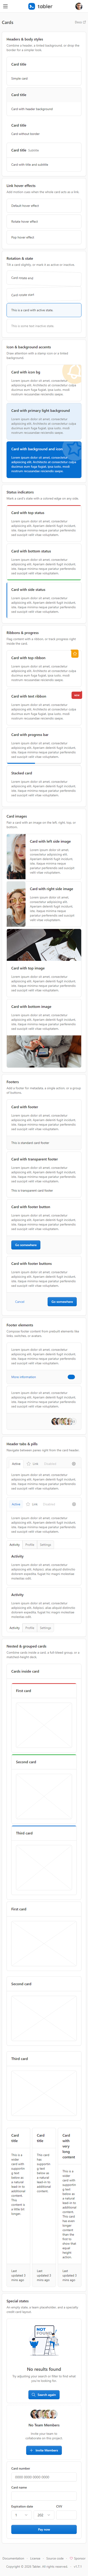
design/templates/cards-phone.png
