CodenameTempest14/init-heat-monitoring/design/templates/home-desktop.png

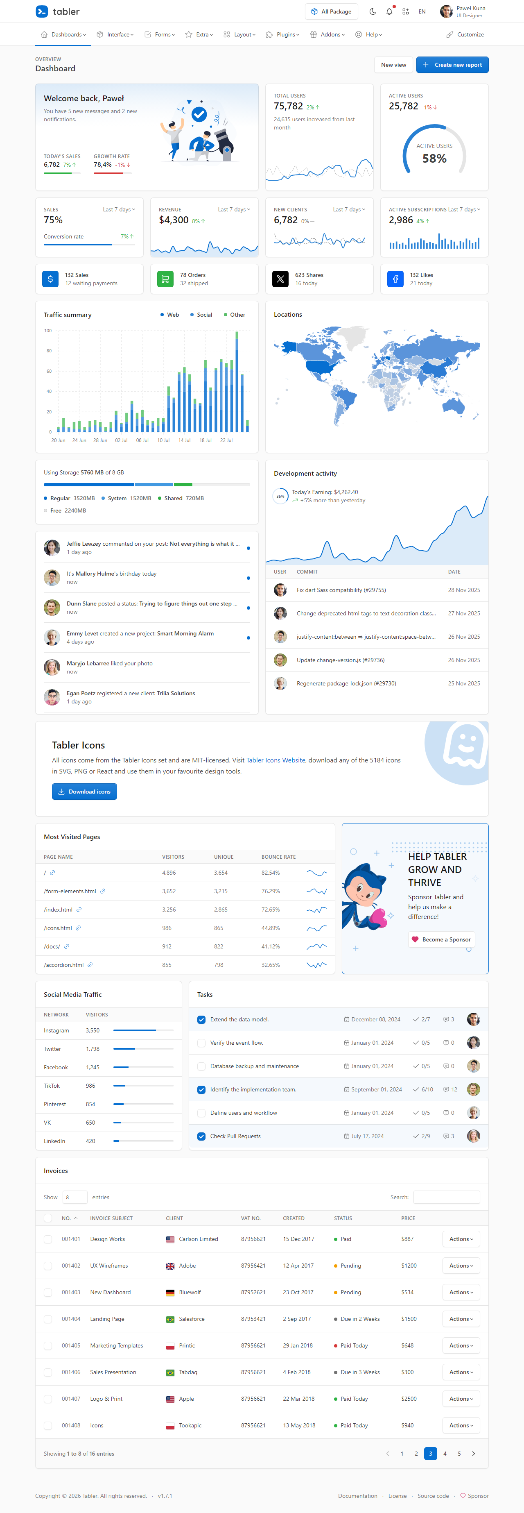
design/templates/home-desktop.png
