CodenameTempest14/init-heat-monitoring/design/templates/home-phone.png

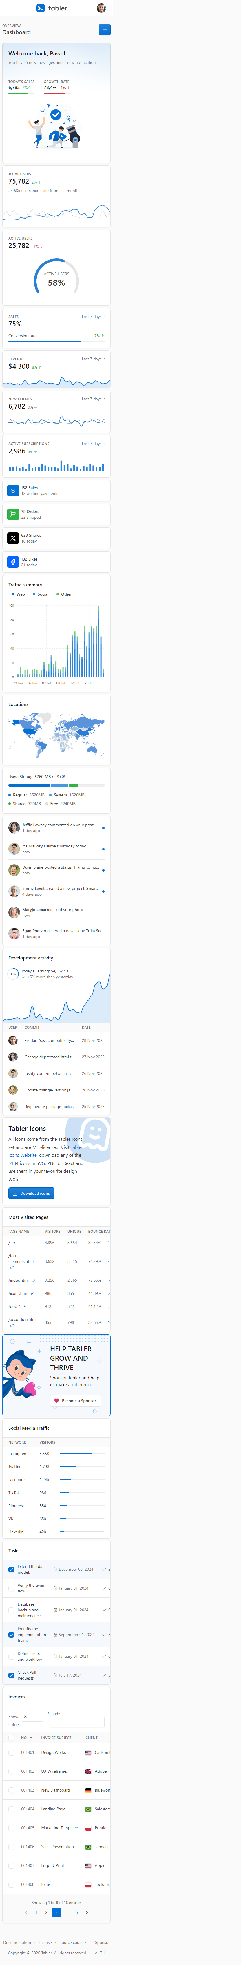
design/templates/home-phone.png
