CodenameTempest14/init-heat-monitoring/design/templates/settings-desktop.png

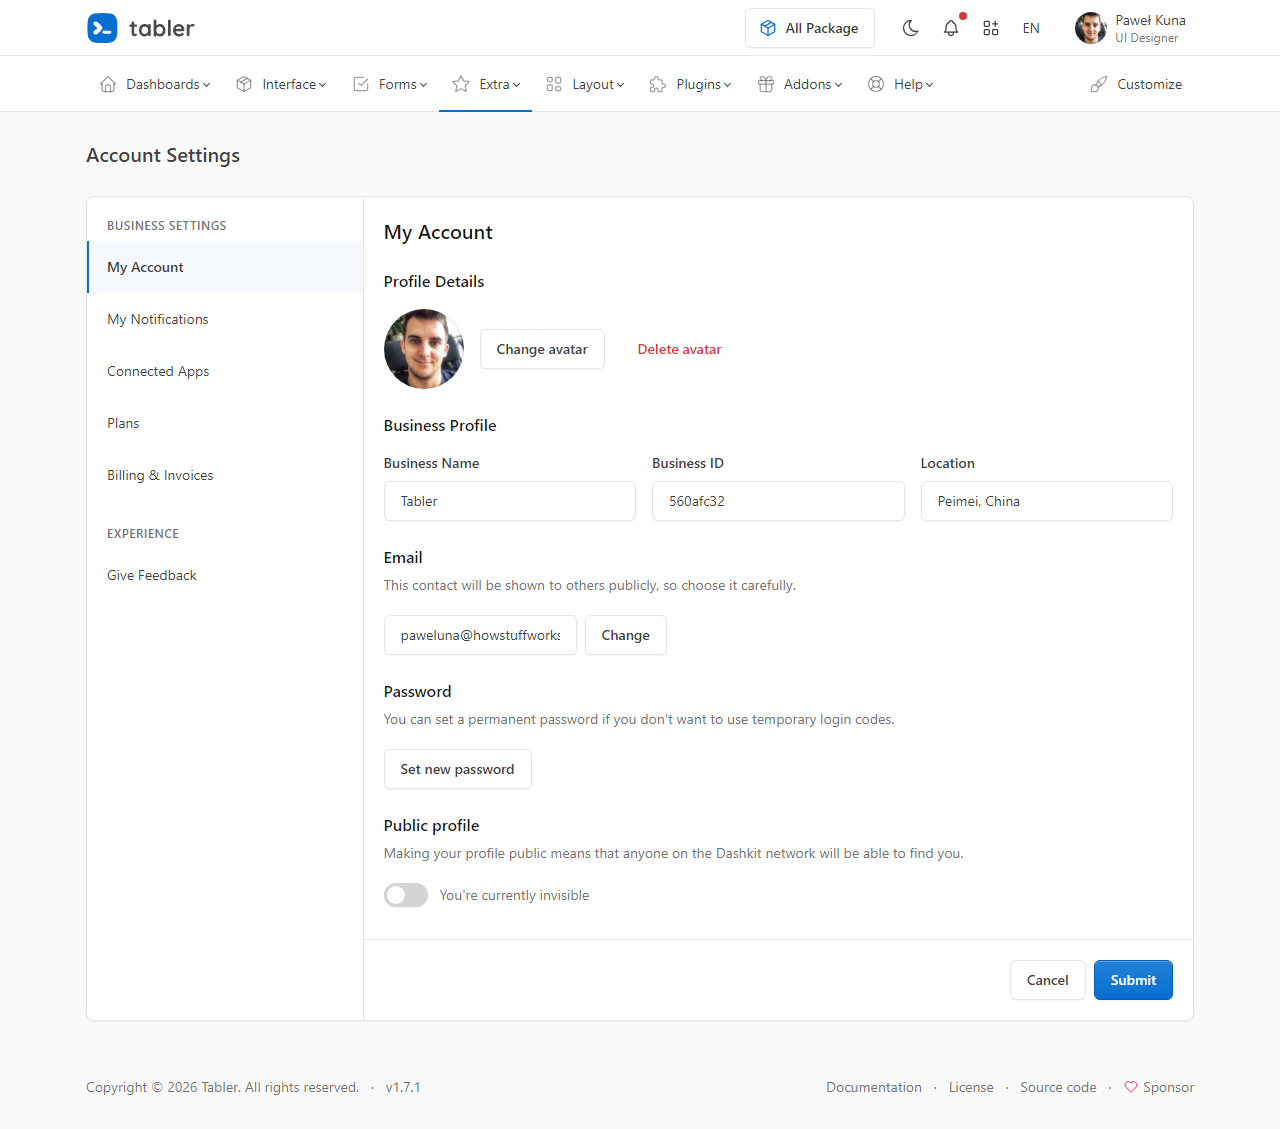
design/templates/settings-desktop.png
