CodenameTempest14/init-heat-monitoring/design/templates/settings-phone.png

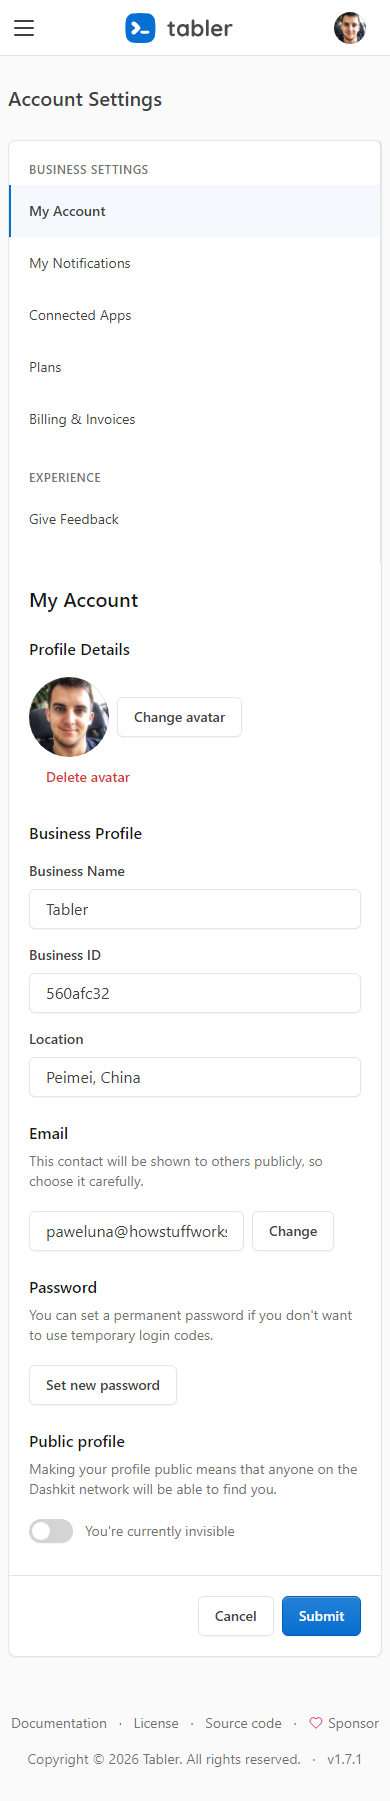
design/templates/settings-phone.png
