CodenameTempest14/init-heat-monitoring/design/templates/sign-in-desktop.png

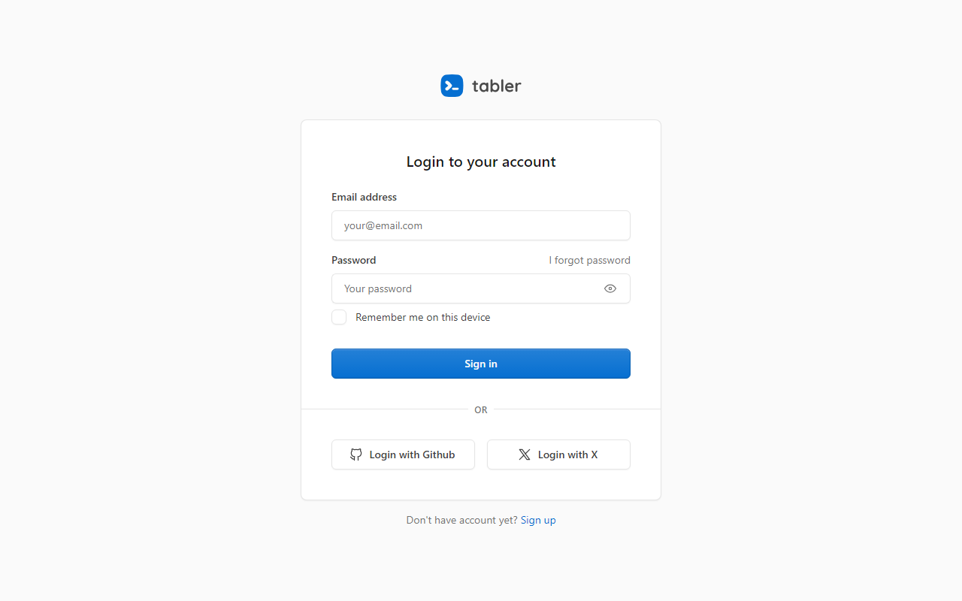
design/templates/sign-in-desktop.png
