CodenameTempest14/init-heat-monitoring/design/templates/sign-in-phone.png

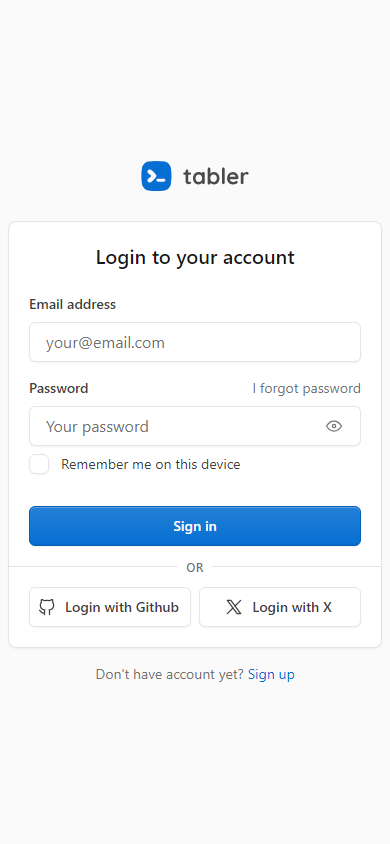
design/templates/sign-in-phone.png
