CodenameTempest14/init-heat-monitoring/enclosure/preview/draft1_dimensions.png

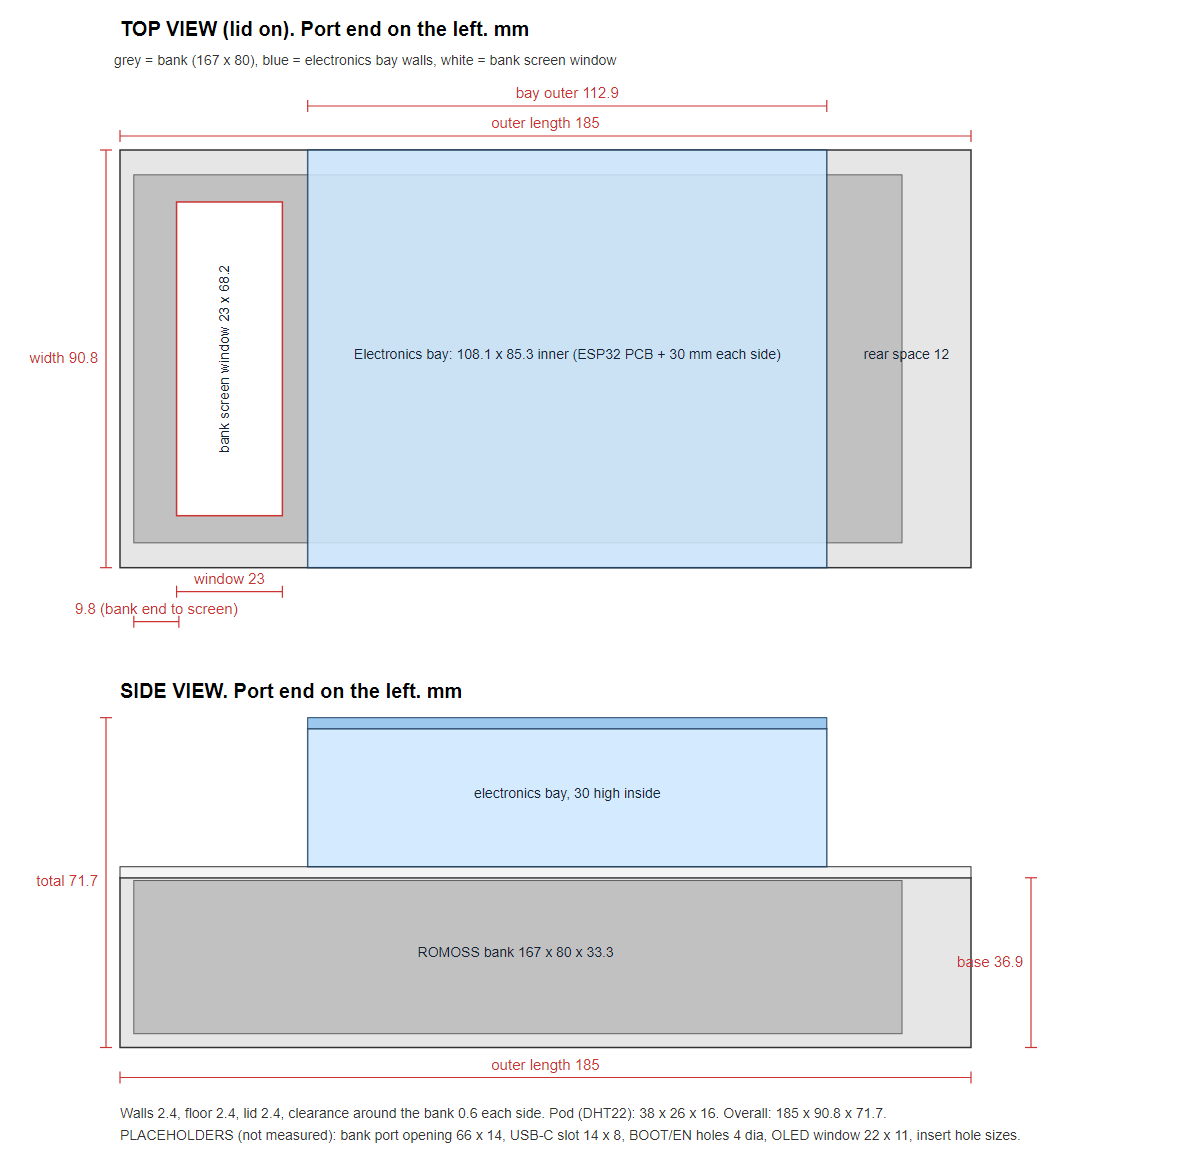
enclosure/preview/draft1_dimensions.png
