CodenameTempest14/init-heat-monitoring/enclosure/preview/draft1_iso2.png

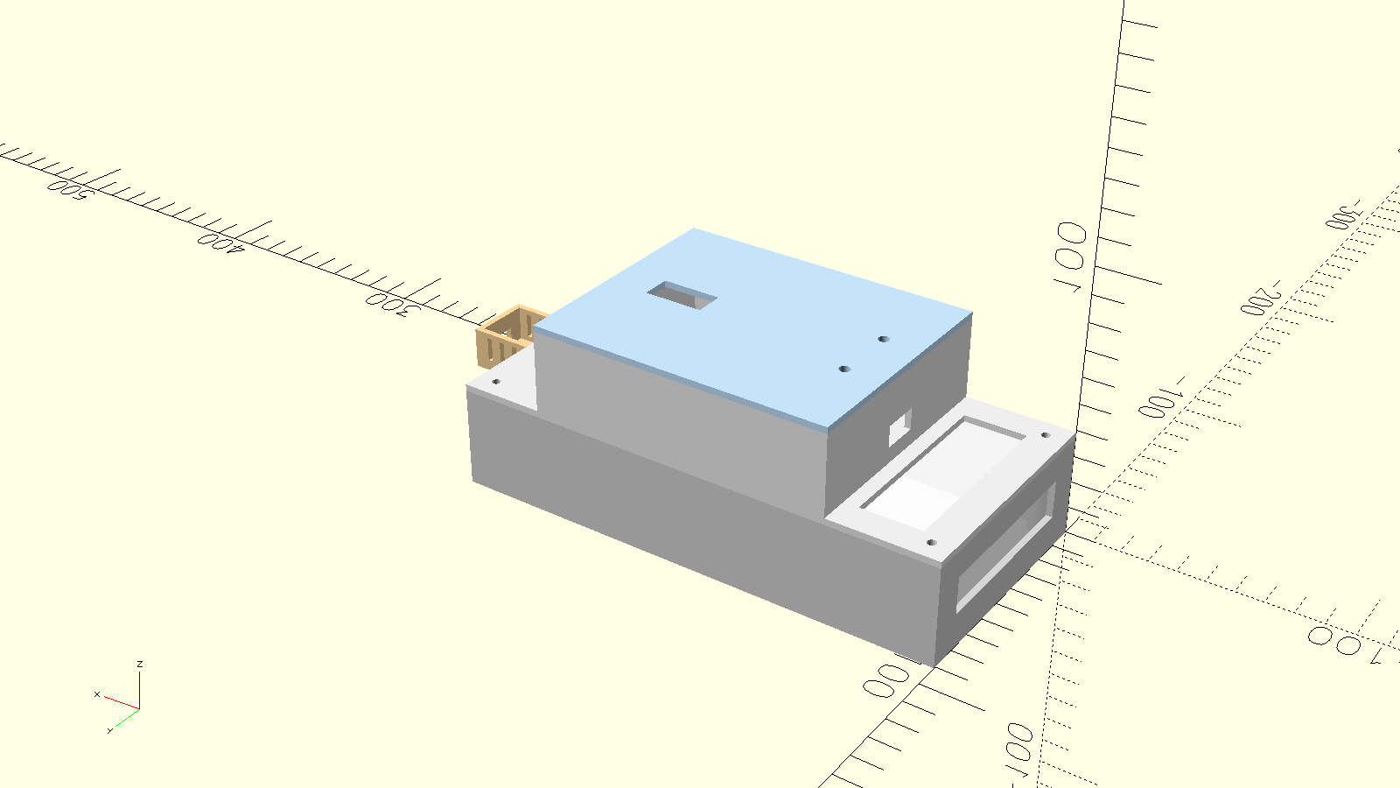
enclosure/preview/draft1_iso2.png
