CodenameTempest14/init-heat-monitoring/enclosure/preview/draft1_iso.png

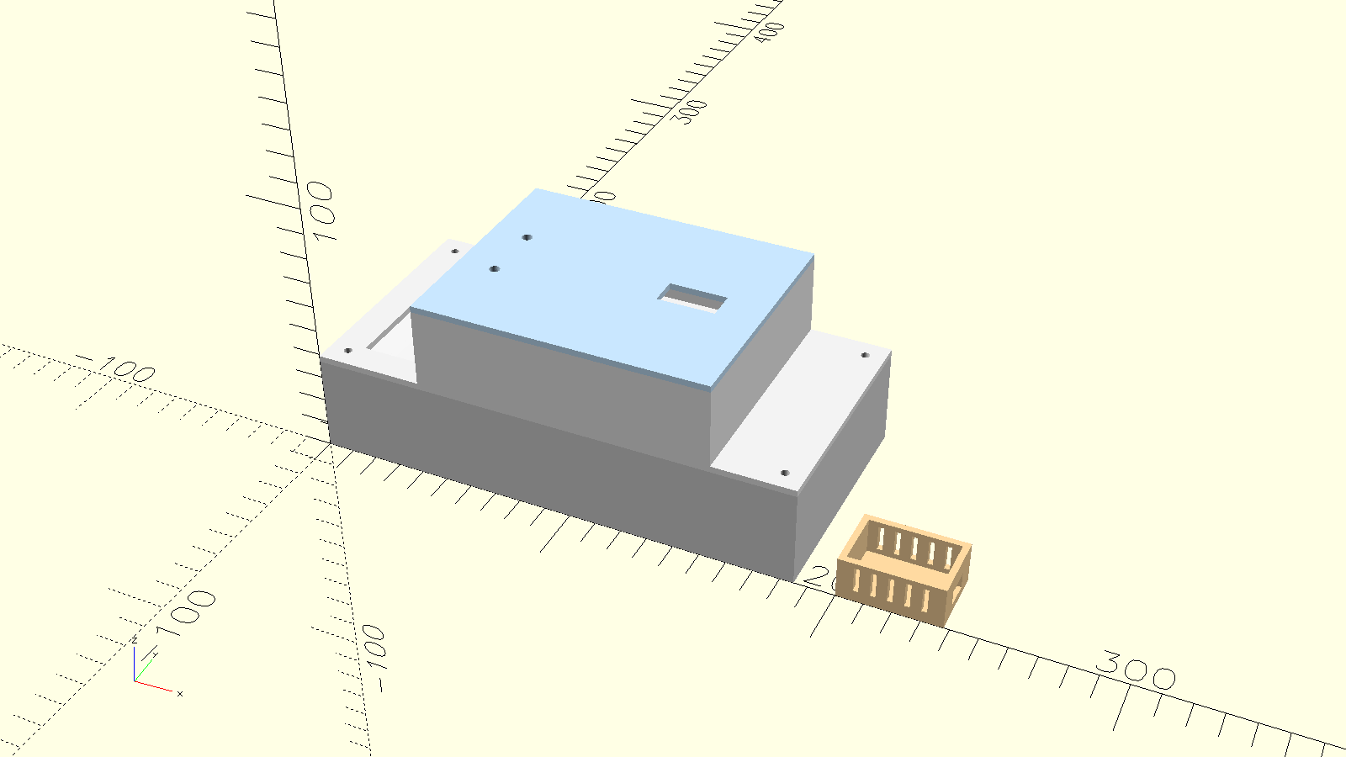
enclosure/preview/draft1_iso.png
