CodenameTempest14/init-heat-monitoring/enclosure/preview/draft1_top.png

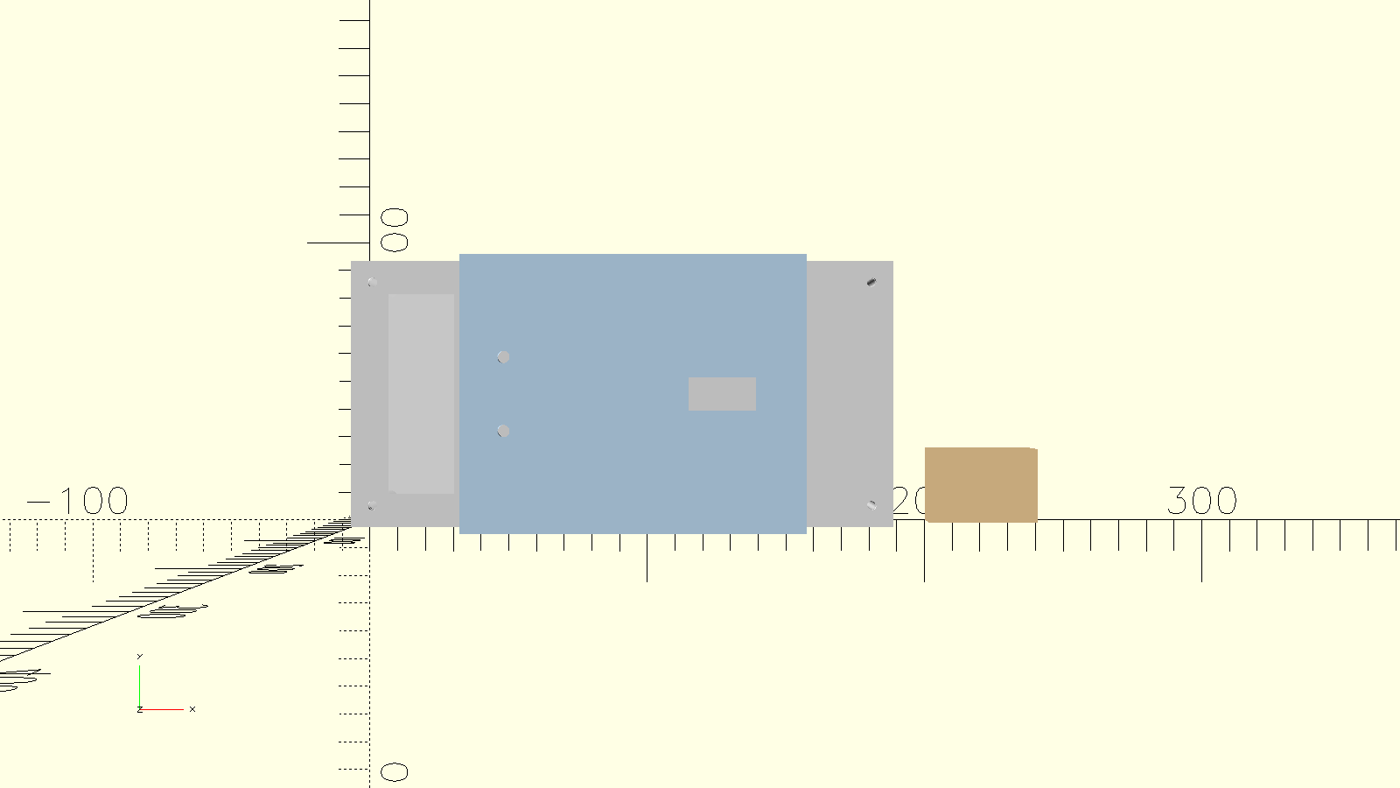
enclosure/preview/draft1_top.png
