CodenameTempest14/init-heat-monitoring/enclosure/preview/draft2_dimensions.png

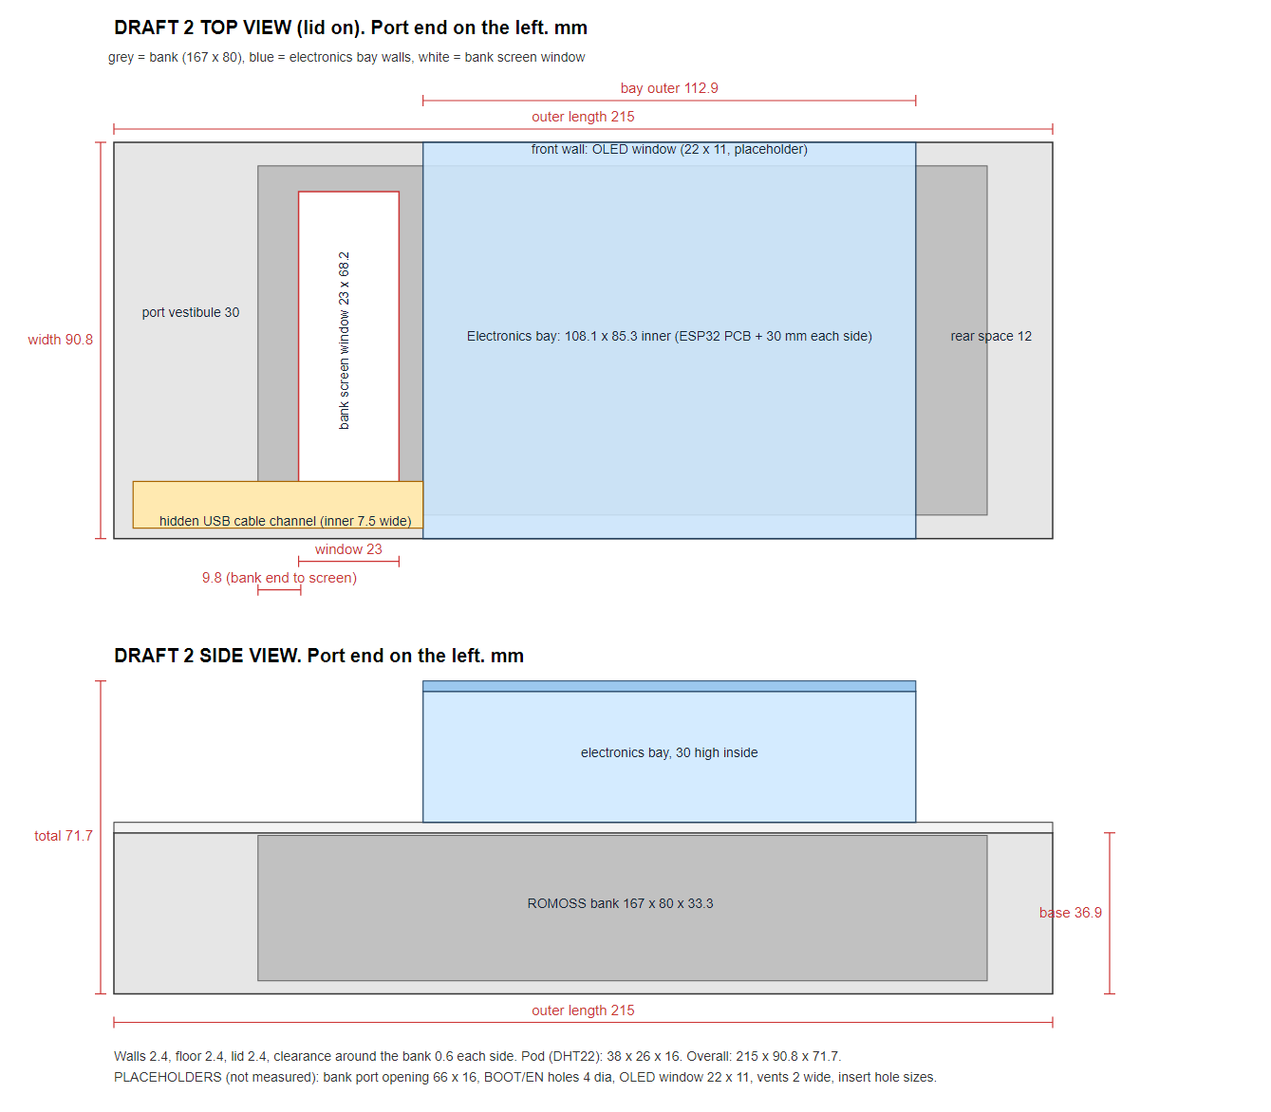
enclosure/preview/draft2_dimensions.png
