CodenameTempest14/init-heat-monitoring/enclosure/preview/draft2_front.png

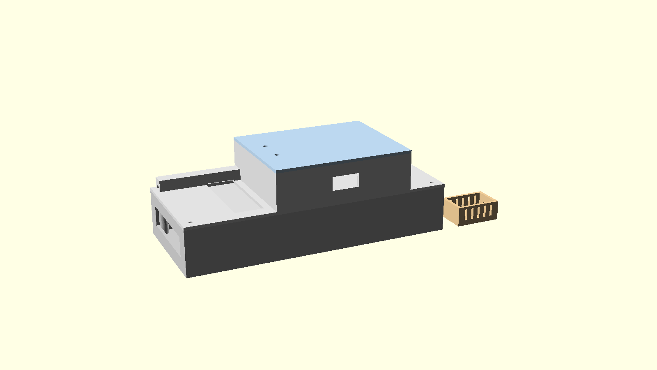
enclosure/preview/draft2_front.png
