CodenameTempest14/init-heat-monitoring/enclosure/preview/draft2_iso.png

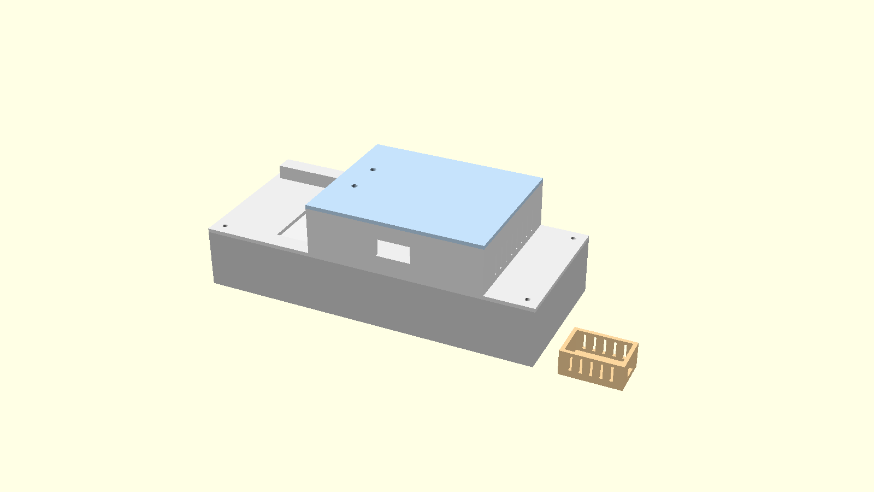
enclosure/preview/draft2_iso.png
