CodenameTempest14/init-heat-monitoring/enclosure/preview/draft3_arm.png

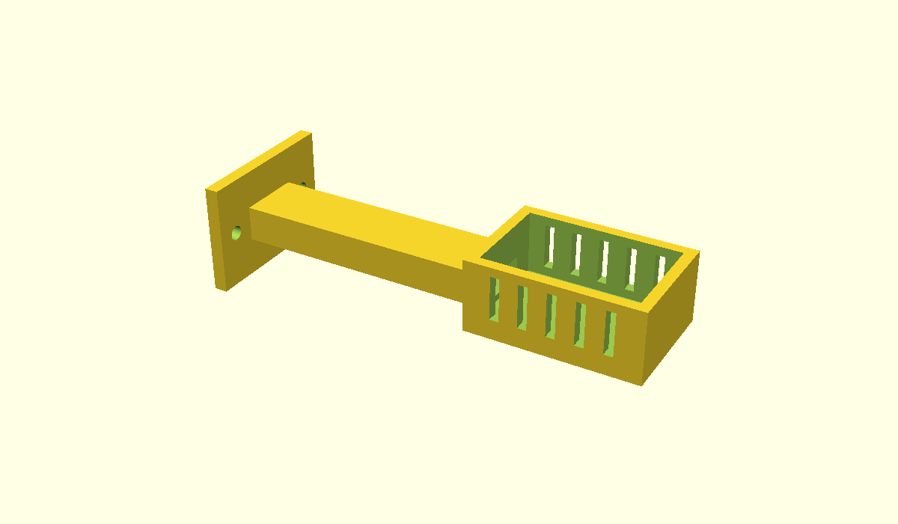
enclosure/preview/draft3_arm.png
