CodenameTempest14/init-heat-monitoring/enclosure/preview/draft3_dimensions.png

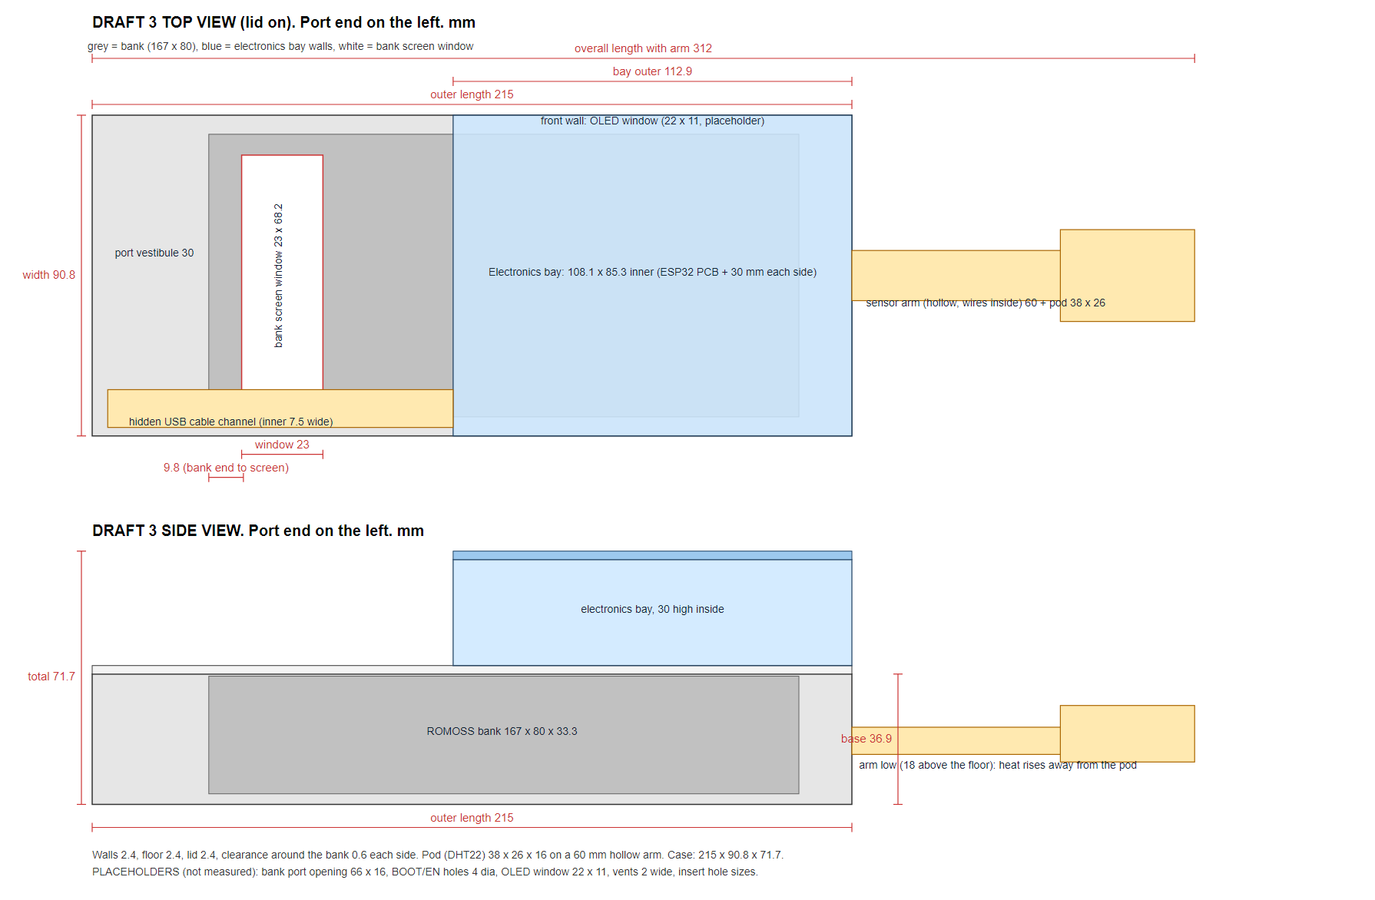
enclosure/preview/draft3_dimensions.png
