CodenameTempest14/init-heat-monitoring/enclosure/preview/draft3_iso.png

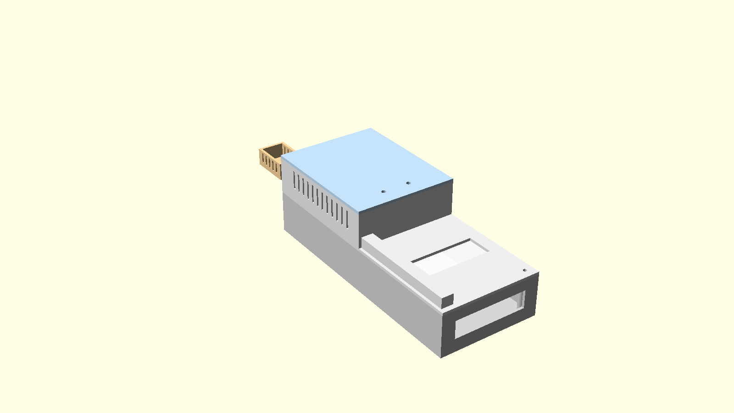
enclosure/preview/draft3_iso.png
