CodenameTempest14/init-heat-monitoring/enclosure/preview/draft4_cover.png

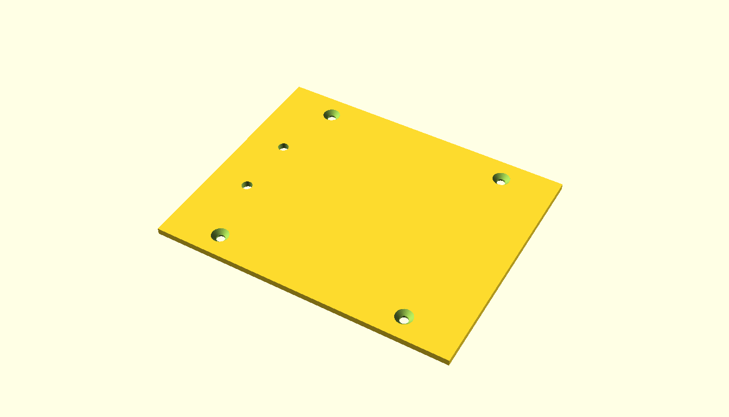
enclosure/preview/draft4_cover.png
