CodenameTempest14/init-heat-monitoring/enclosure/preview/draft4_lid.png

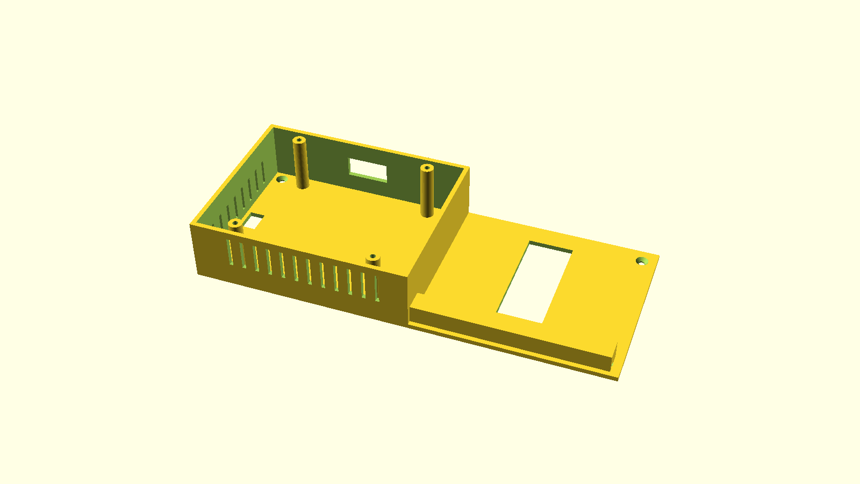
enclosure/preview/draft4_lid.png
