CodenameTempest14/init-heat-monitoring/enclosure/preview/draft5_arm.png

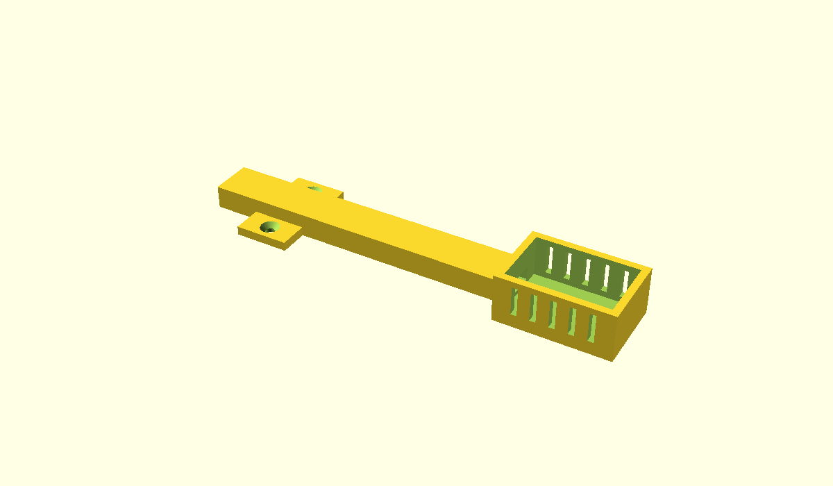
enclosure/preview/draft5_arm.png
