CodenameTempest14/init-heat-monitoring/enclosure/preview/draft5_dimensions.png

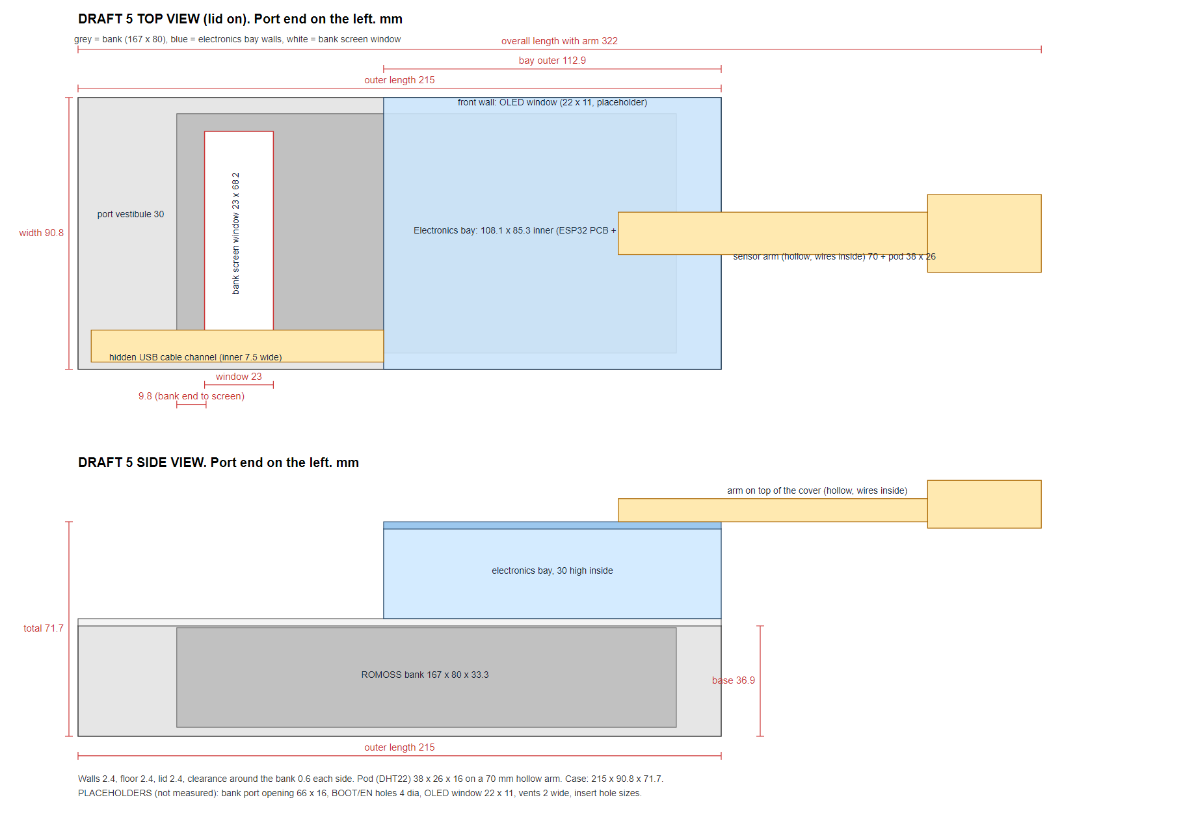
enclosure/preview/draft5_dimensions.png
