CodenameTempest14/init-heat-monitoring/enclosure/preview/draft5_iso.png

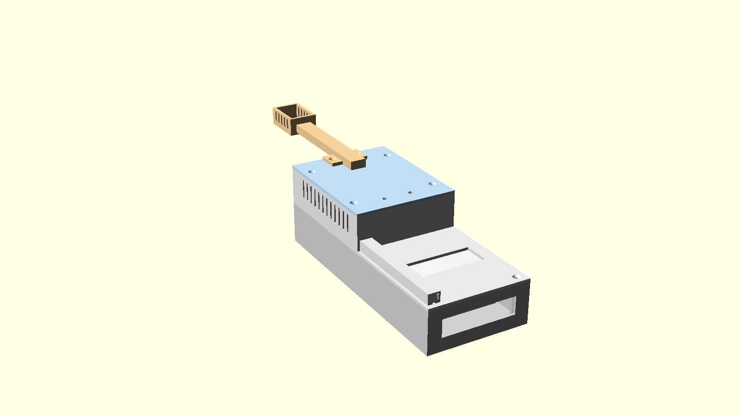
enclosure/preview/draft5_iso.png
