CodenameTempest14/init-heat-monitoring/enclosure/preview/draft6_arm.png

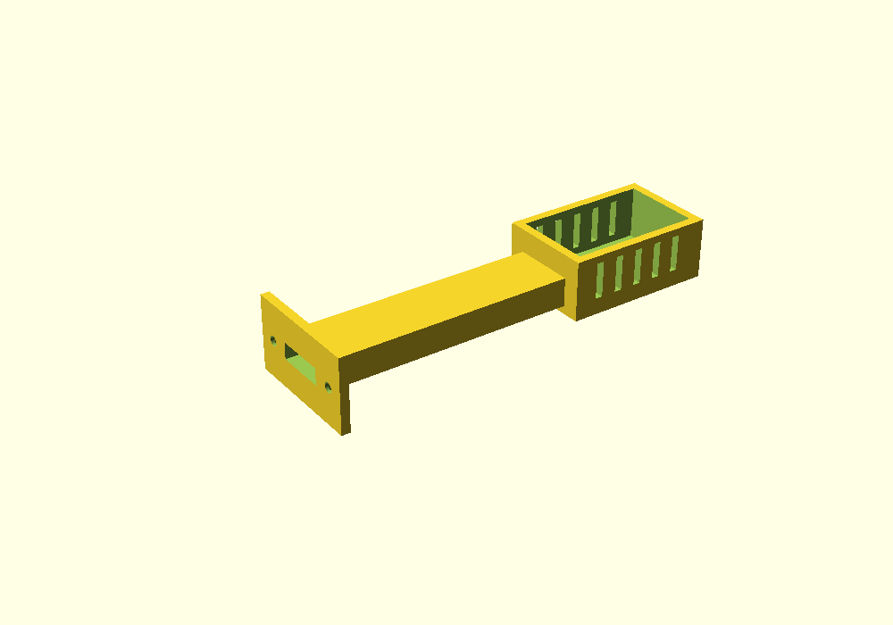
enclosure/preview/draft6_arm.png
