CodenameTempest14/init-heat-monitoring/enclosure/preview/draft6_front.png

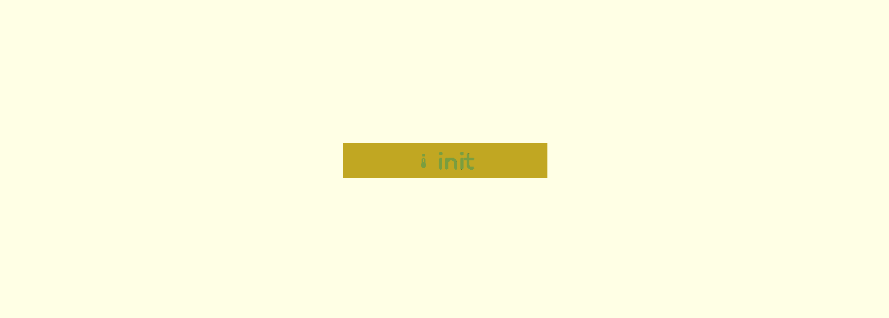
enclosure/preview/draft6_front.png
