CodenameTempest14/init-heat-monitoring/enclosure/preview/draft6_iso.png

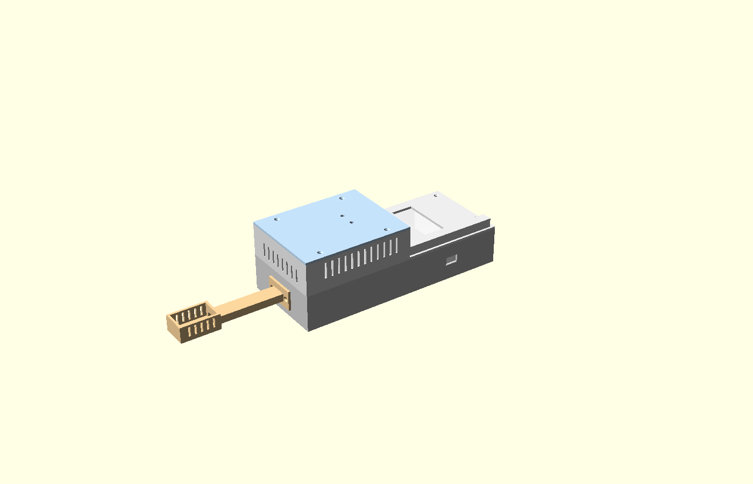
enclosure/preview/draft6_iso.png
