CodenameTempest14/init-heat-monitoring/enclosure/preview/draft7_base_top.png

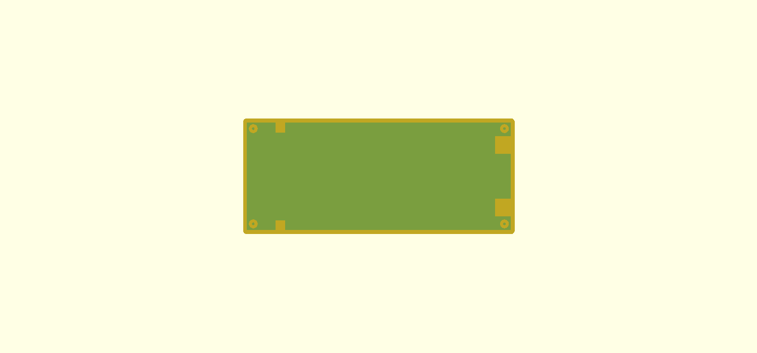
enclosure/preview/draft7_base_top.png
