CodenameTempest14/init-heat-monitoring/paper/data/screens/admin-signin.jpg

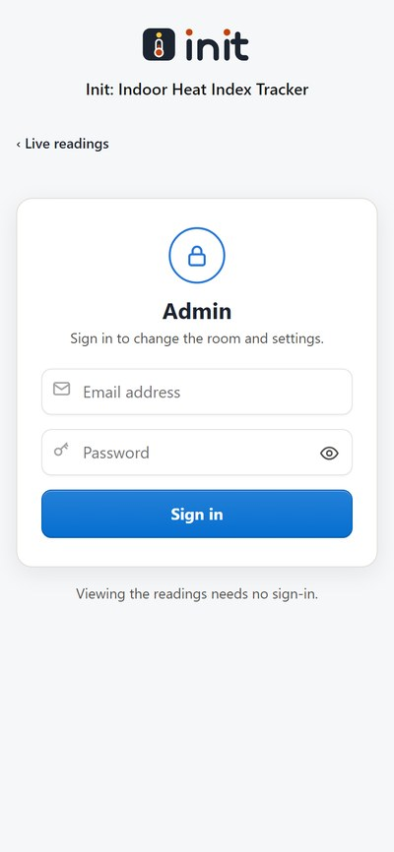
paper/data/screens/admin-signin.jpg
