CodenameTempest14/init-heat-monitoring/paper/data/screens/admin.jpg

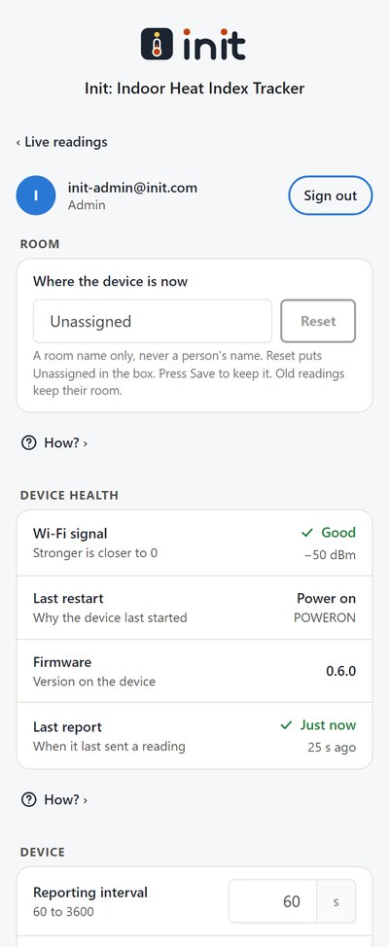
paper/data/screens/admin.jpg
