CodenameTempest14/init-heat-monitoring/paper/data/screens/alerts.jpg

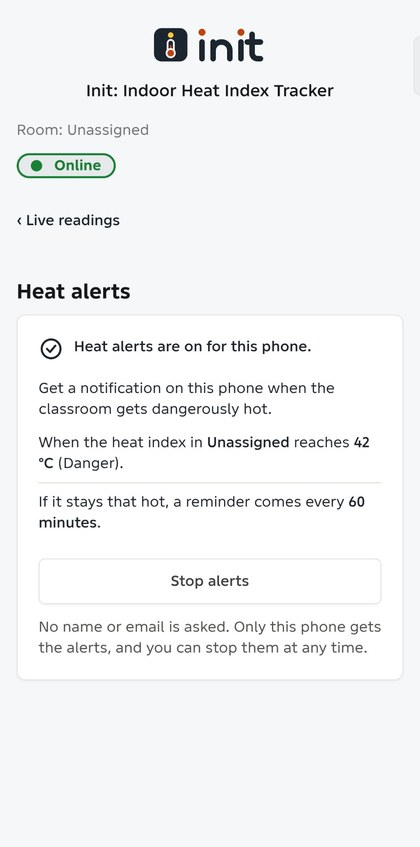
paper/data/screens/alerts.jpg
