CodenameTempest14/init-heat-monitoring/paper/data/screens/charts.jpg

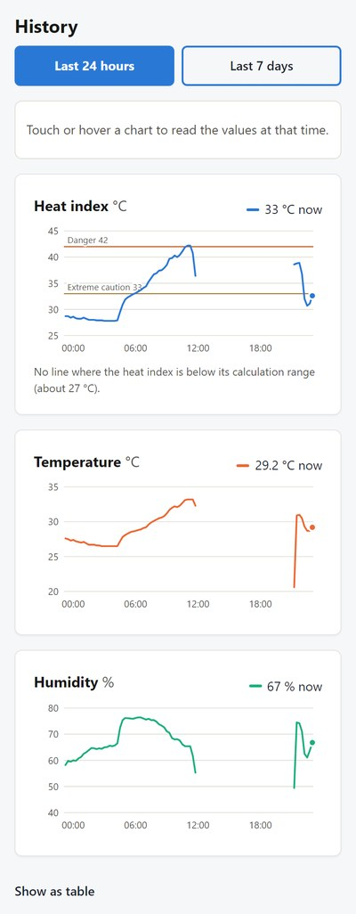
paper/data/screens/charts.jpg
