CodenameTempest14/init-heat-monitoring/paper/data/screens/heat.jpg

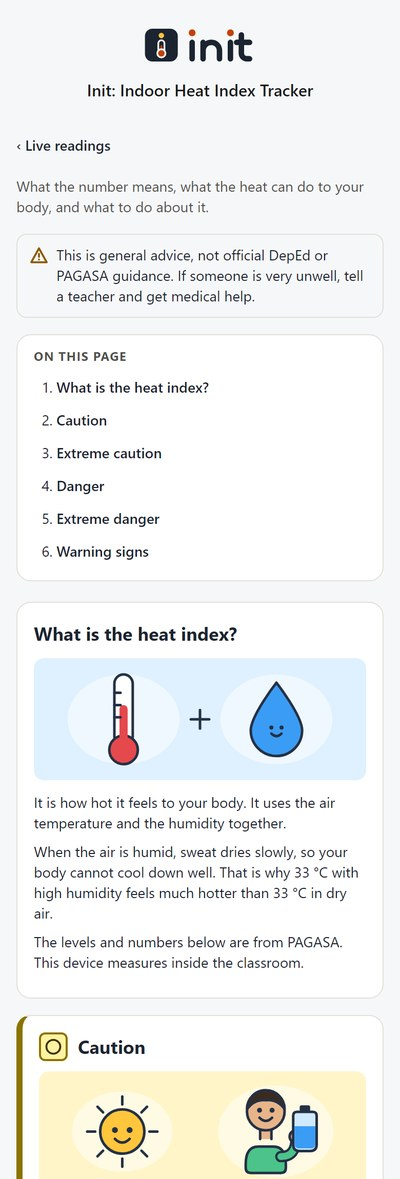
paper/data/screens/heat.jpg
