CodenameTempest14/init-heat-monitoring/paper/data/screens/home-offline.jpg

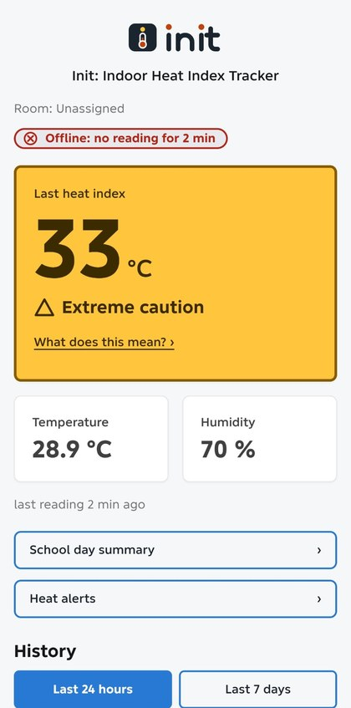
paper/data/screens/home-offline.jpg
