CodenameTempest14/init-heat-monitoring/paper/data/screens/home-online.jpg

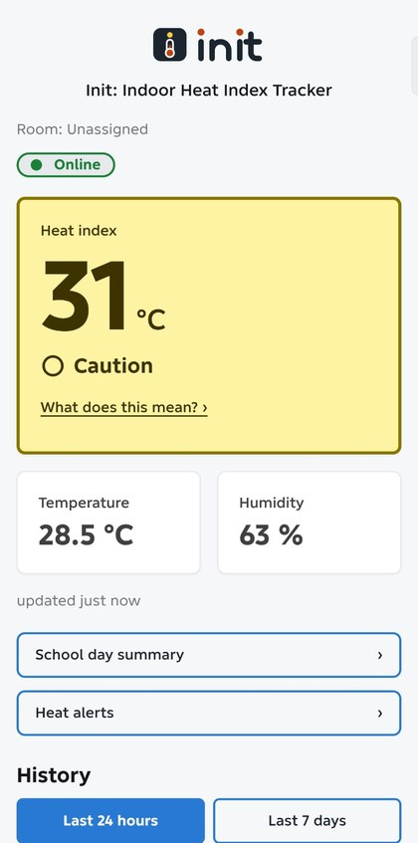
paper/data/screens/home-online.jpg
