CodenameTempest14/init-heat-monitoring/paper/data/screens/readings.jpg

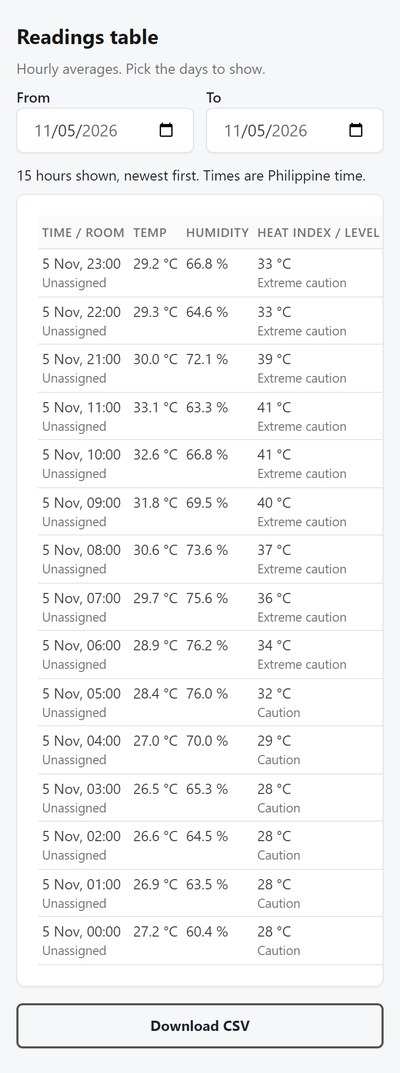
paper/data/screens/readings.jpg
