CodenameTempest14/init-heat-monitoring/paper/data/screens/school.jpg

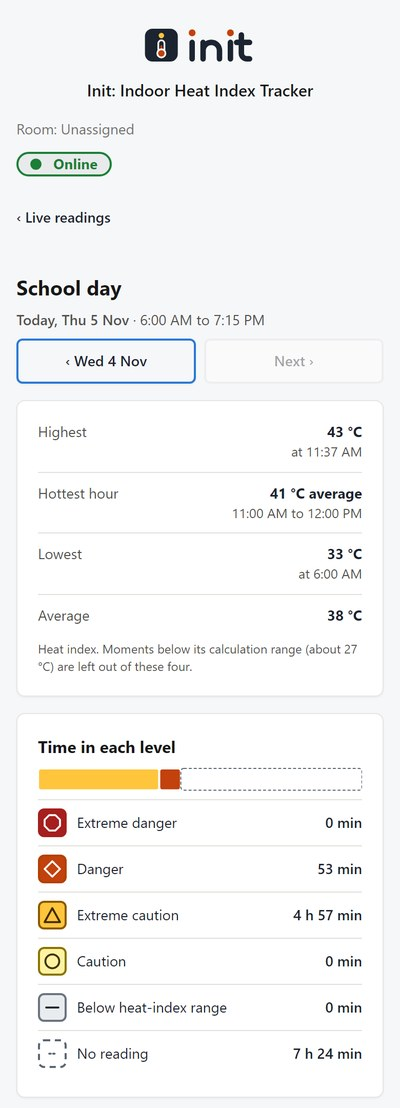
paper/data/screens/school.jpg
