CodenameTempest14/init-heat-monitoring/enclosure/stl/podlid.stl

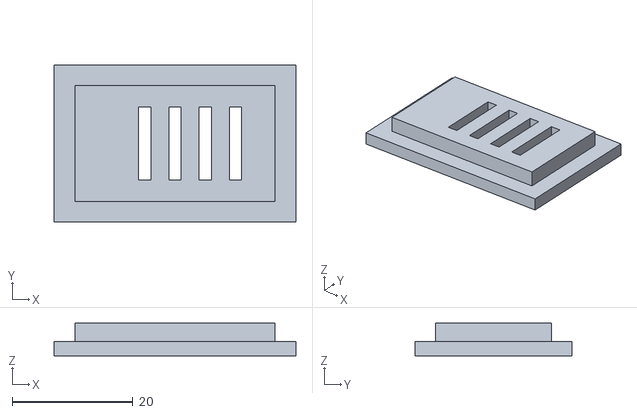
[picture p133: CAD file, 2026-11-11]
enclosure/stl/podlid.stl
40.0 x 26.0 x 5.40
