CodenameTempest14/init-heat-monitoring/enclosure/stl/arm.stl

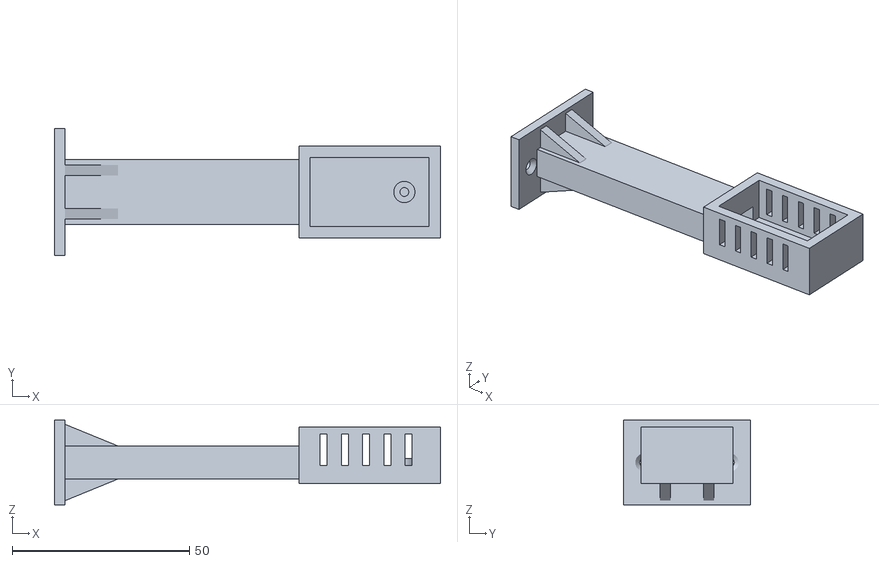
[picture p134: CAD file, 2026-11-11]
enclosure/stl/arm.stl
109.0 x 36.0 x 24.0
