CodenameTempest14/init-heat-monitoring/enclosure/stl/cover.stl

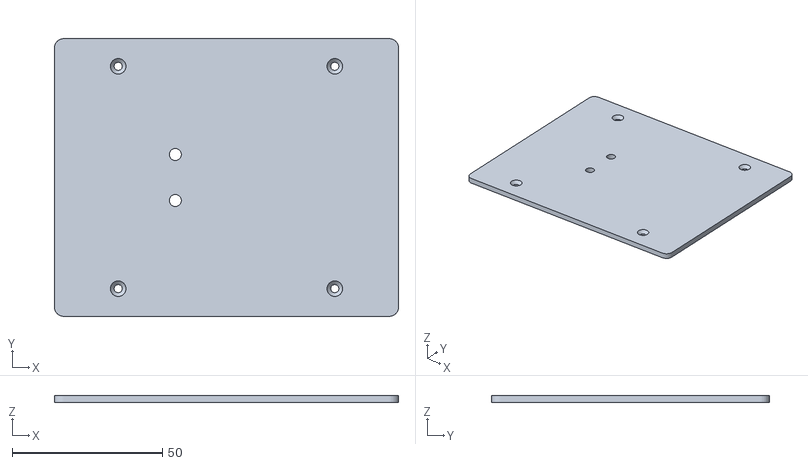
[picture p135: CAD file, 2026-11-11]
enclosure/stl/cover.stl
114.5 x 92.4 x 2.40
