CodenameTempest14/init-heat-monitoring/enclosure/stl/base.stl

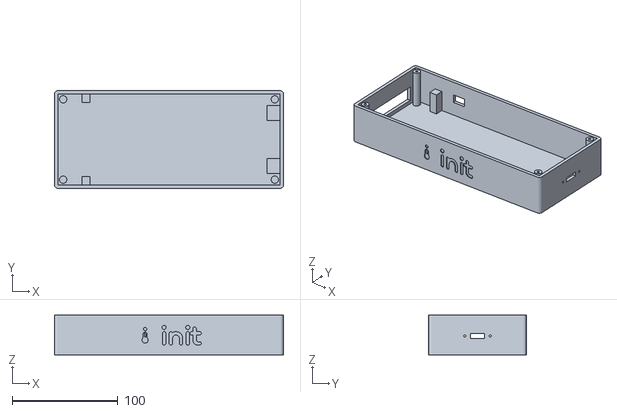
[picture p136: CAD file, 2026-11-11]
enclosure/stl/base.stl
216.6 x 92.4 x 37.7
