CodenameTempest14/init-heat-monitoring/enclosure/stl/lid.stl

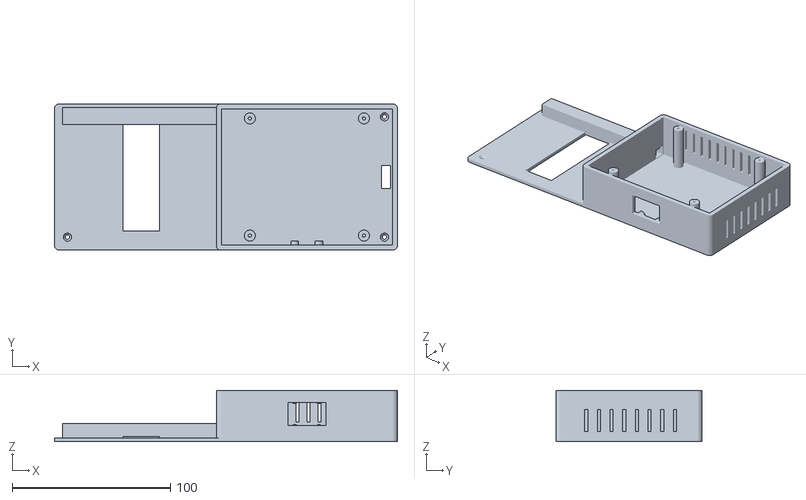
[picture p137: CAD file, 2026-11-11]
enclosure/stl/lid.stl
216.6 x 92.4 x 32.4
