CodenameTempest14/init-heat-monitoring/design/admin-guide/README.md

# design/admin-guide/

**Mocks APPROVED by the owner on 2026-11-02 (s23); not built yet. The teacher still reviews the wording before it goes live (D-034).** Mocks of the admin guide `#guide` and of the one change to the admin page. Made-up room and numbers only. English only (D-034). **A teacher reviews the wording before it goes live.**

| File | What |
|---|---|
| `guide.html` | The guide: a short contents list, then six sections in the order of the admin page: Before you start, Room, Reporting interval, Temperature and humidity offsets (with the worked example 30.2 − 31.0 = −0.8), Heat alerts (PAGASA levels table), If something looks wrong |
| *(admin page)* | The three **How? ›** links (one under each group box: Room, Device, Heat alerts) are drawn in `design/admin/proposal-b/` (`b-settings`, `b-saved`, redrawn s23; pixel-identical to the `admin-how` images the owner approved, 0 differing pixels). Nothing else on the page changes |
| `guide.css` | Styles for both (only tokens from `web/src/tokens.css` and `charts.css`) |
| (P05-04) | `guide.html` now has section 3 **Device health** (sections 3 to 6 became 4 to 7); the pictures in `ref/` were redrawn. The teacher approved the wording (s25) |
| `build-mocks.mjs`, `capture.mjs` | `node design/admin-guide/build-mocks.mjs`, then `capture.mjs` writes `ref/<state>-phone-<light\|dark>.png` |

## What is proposed
- **Same look as the admin page:** cards with the same border, number badges on the section titles, short sentences, numbered steps, a blue-bordered **Example** box and a note box with a warning icon.
- **Readable without signing in.** The only links to it are the three **How? ›** links (they jump to Room, Reporting interval, Heat alerts). The back link says **‹ Admin**.
- **Heat alerts** has a note first: alerts come in a later step. The levels table quotes PAGASA's names and numbers only, no advice.
- **Wording is a draft** for the owner and the teacher to correct. The offset steps follow the F-22 text (30 minutes, 3 readings 5 minutes apart, average).
