CodenameTempest14/init-heat-monitoring/design/device-setup/ref/README.md

# design/device-setup/ref/

Approved screenshots of the device setup page (owner, 2026-11-02, s14): `form`, `form-error` and `saved`, each in
light and dark, 390 px wide. Made by `../capture.mjs`. Do not edit by hand; a change needs the owner's approval again.
