CodenameTempest14/init-heat-monitoring/paper/build/README.md

# paper/build/

Figure PNGs made by `node paper/build.mjs` (the Word file needs bitmaps). Generated; not committed.
