CodenameTempest14/init-heat-monitoring/design/admin-guide/ref/README.md

# design/admin-guide/ref/

Screenshots of the proposed guide mocks (phone, 390 px, light and dark), written by `node design/admin-guide/capture.mjs`. For the owner to approve; not yet used by a test.
