CodenameTempest14/init-heat-monitoring/design/admin-guide/ref/guide-phone-dark.png

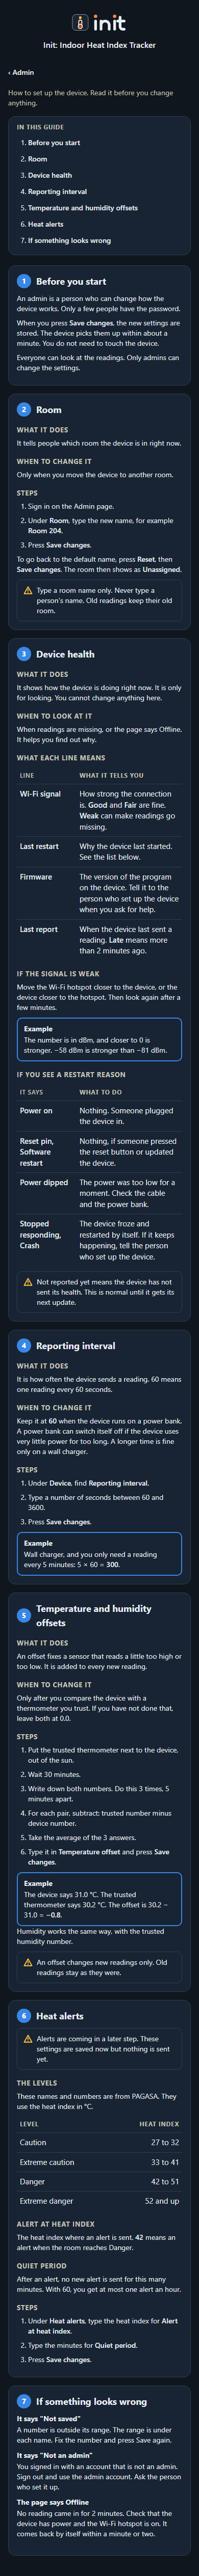
design/admin-guide/ref/guide-phone-dark.png
