CodenameTempest14/init-heat-monitoring/design/admin-guide/ref/guide-phone-light.png

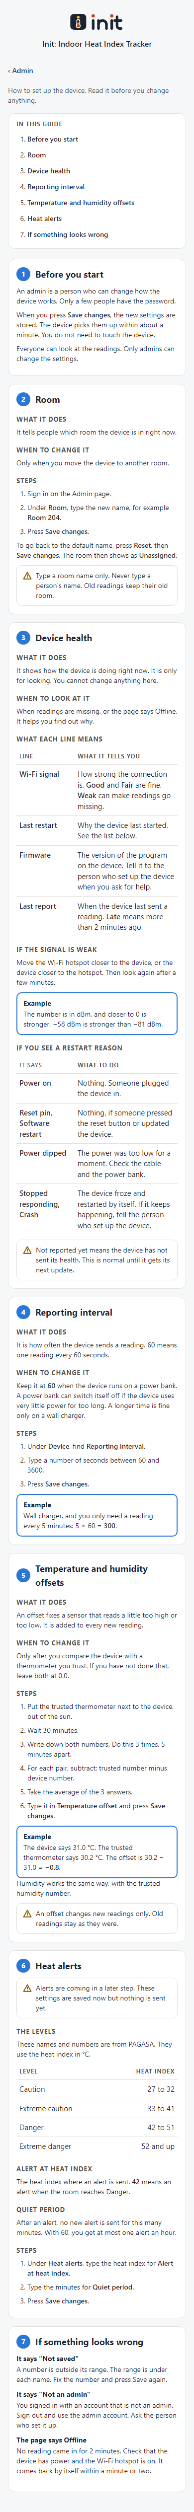
design/admin-guide/ref/guide-phone-light.png
