CodenameTempest14/init-heat-monitoring/design/admin/health/ref/guide-health-phone-dark.png

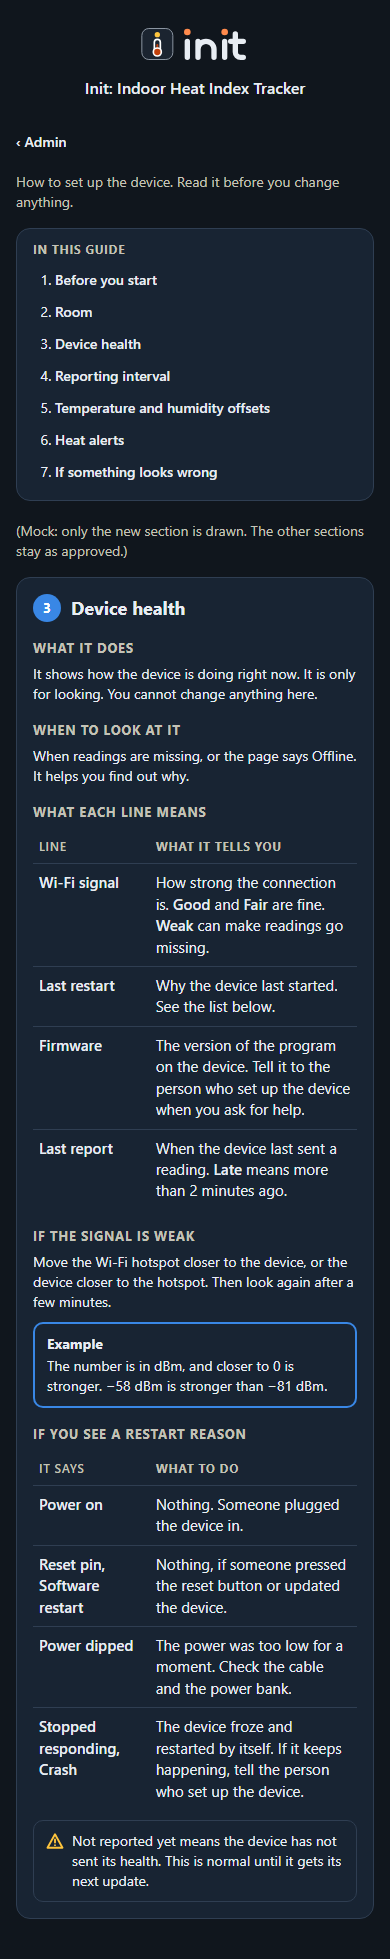
design/admin/health/ref/guide-health-phone-dark.png
