CodenameTempest14/init-heat-monitoring/design/admin/health/ref/guide-health-phone-light.png

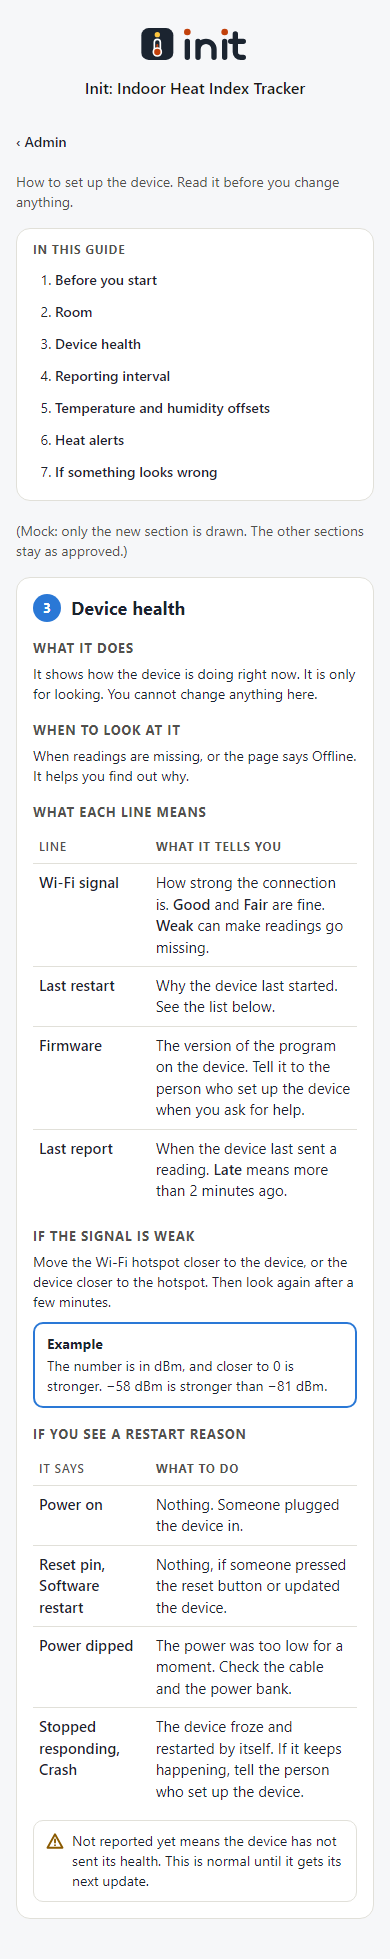
design/admin/health/ref/guide-health-phone-light.png
