CodenameTempest14/init-heat-monitoring/design/device-setup/ref/form-dark.png

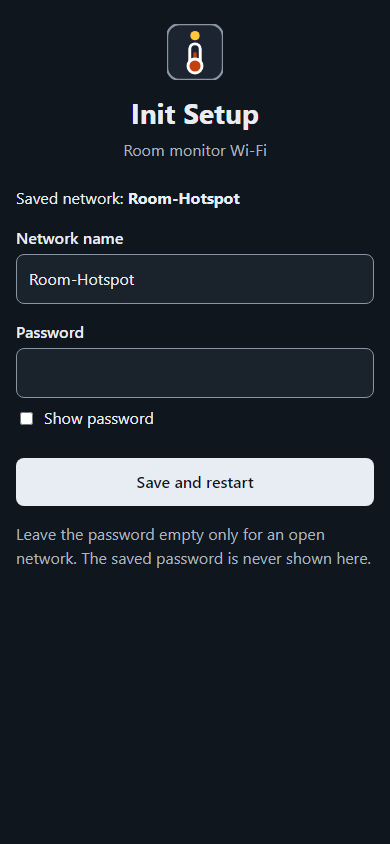
design/device-setup/ref/form-dark.png
