CodenameTempest14/init-heat-monitoring/design/device-setup/ref/form-error-dark.png

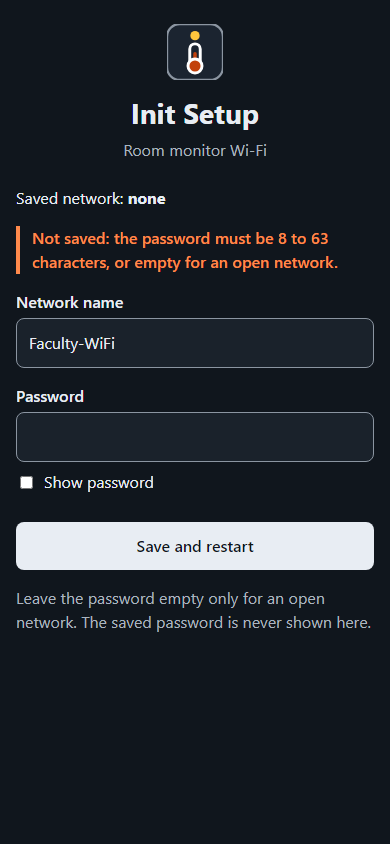
design/device-setup/ref/form-error-dark.png
