CodenameTempest14/init-heat-monitoring/design/device-setup/ref/form-error-light.png

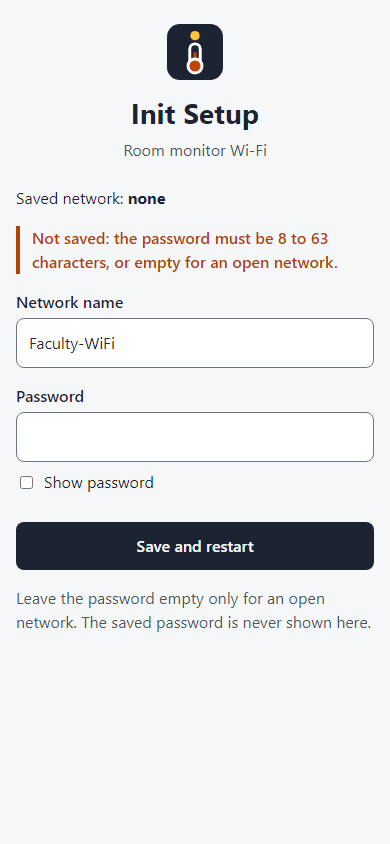
design/device-setup/ref/form-error-light.png
