CodenameTempest14/init-heat-monitoring/design/device-setup/ref/form-light.png

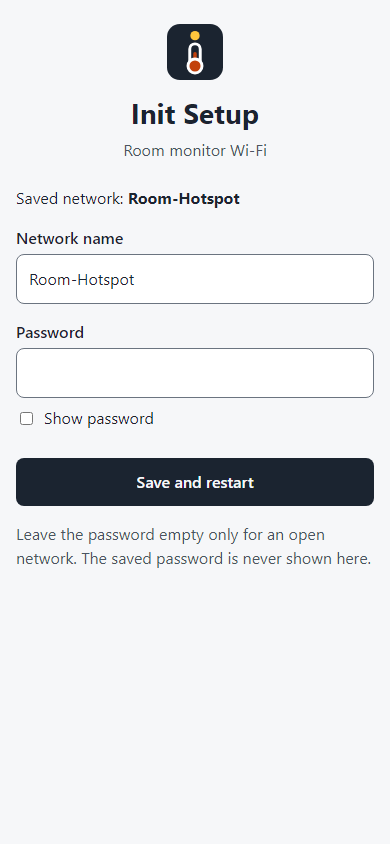
design/device-setup/ref/form-light.png
