CodenameTempest14/init-heat-monitoring/design/pwa/ref/installed-phone-dark.png

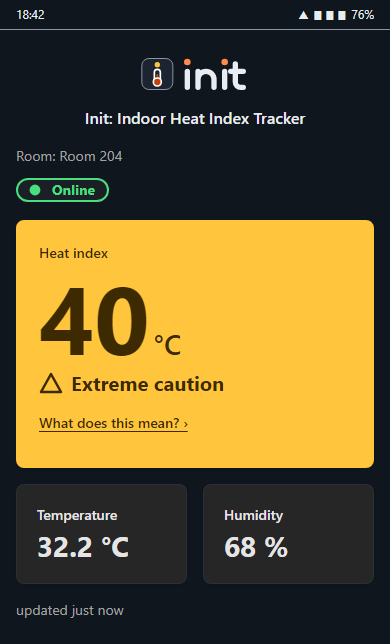
design/pwa/ref/installed-phone-dark.png
