CodenameTempest14/init-heat-monitoring/design/pwa/ref/installed-phone-light.png

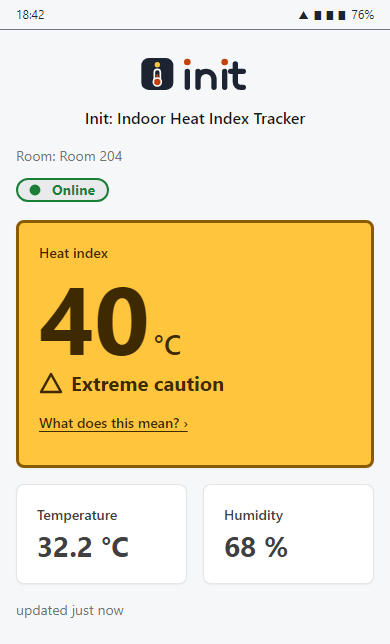
design/pwa/ref/installed-phone-light.png
