CodenameTempest14/init-heat-monitoring/enclosure/preview/measure_guide.png

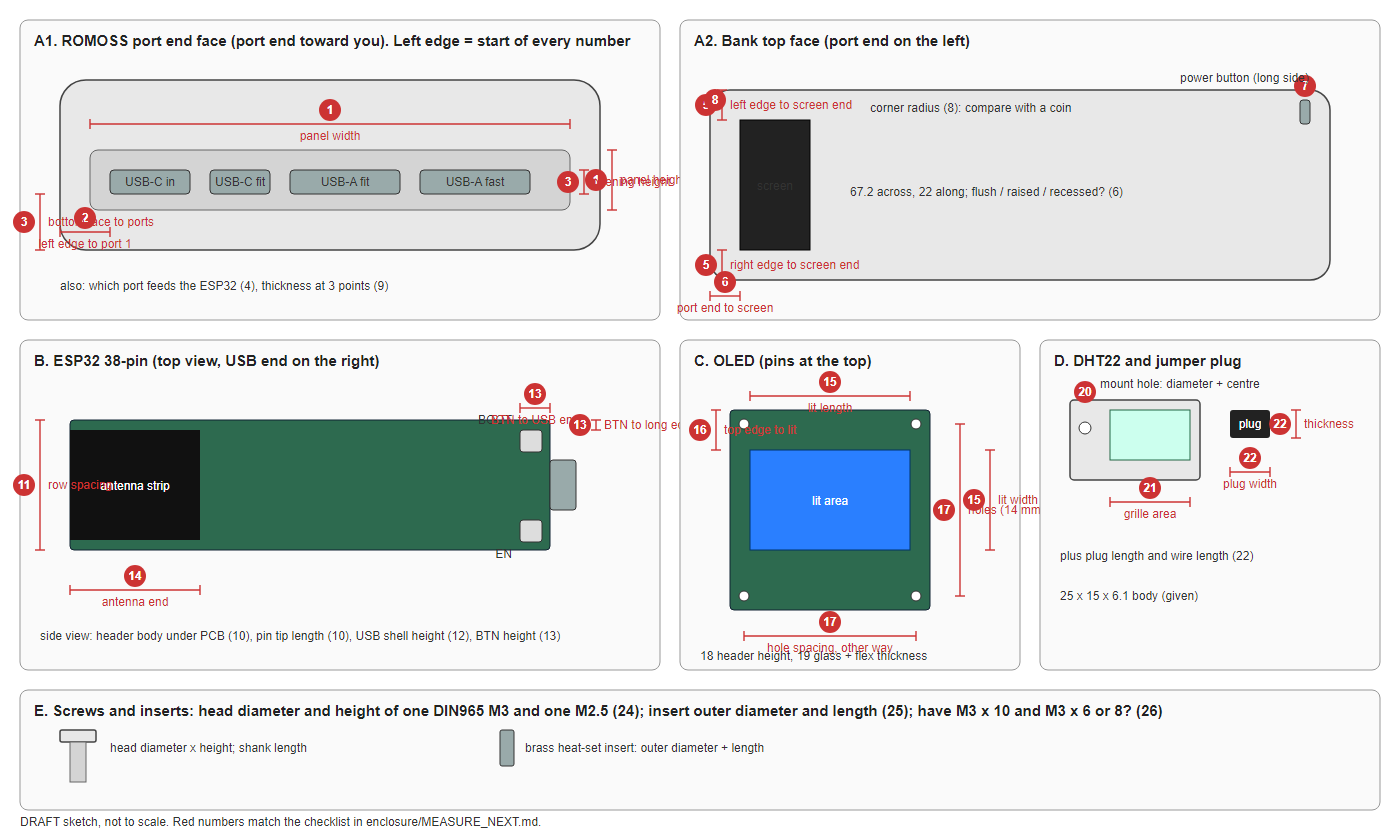
enclosure/preview/measure_guide.png
