CodenameTempest14/init-heat-monitoring/paper/data/screens/guide.jpg

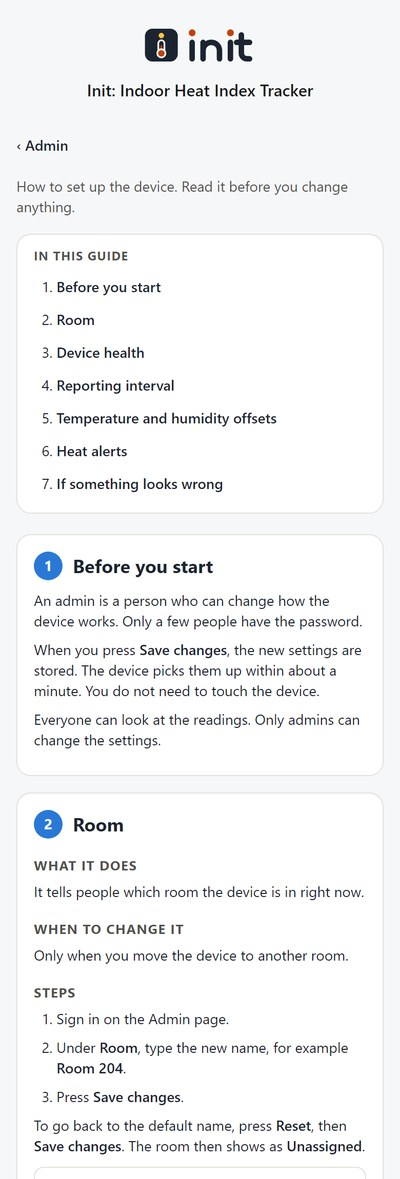
paper/data/screens/guide.jpg
