CodenameTempest14/init-heat-monitoring/enclosure/MEASURE_NEXT.md

# Measure next (checklist for 2026-11-12). All in mm. Write the answer next to each line.

How to measure, for every number: close the calipers and check they read 0.00; measure **twice**; if the two differ, write the larger one.
If you only have a ruler, put the part flat on a table, photograph it straight from above with the ruler touching it.
"Edge" means the outer edge of the plastic or board, not the printed line.

## A. ROMOSS power bank (most important)
Stand the bank on its long side so the port end faces you. Numbers are from the LEFT edge of that end face unless said otherwise.
1. [ ] Port panel (the recessed area holding all four ports): width ___ and height ___.
2. [ ] For EACH of the four ports (USB-C input, USB-C fit, USB-A fit, USB-A fast charge): distance from the left edge of the end face to the port's left side ___, to its right side ___.
3. [ ] Port opening height ___, and the distance from the bottom face of the bank up to the bottom of the ports ___.
4. [ ] Which port will power the ESP32 (name it): ___.
5. [ ] The screen: is it on the **same end** as the ports? ___ Measure its two long sides: distance from the left long edge of the top face to the near end of the screen ___ and to the far end ___ (these give its position across the 80 mm width; I expect about 6.4 mm each side).
6. [ ] Distance from the port end face to the nearest edge of the screen ___ (you gave 9.8: confirm). Is the screen flush with the top face, or raised or recessed? ___ by how much ___.
7. [ ] Power button (round, on the long side): which long side ___, distance from the port end ___, distance from the top face ___, diameter ___, how far it sticks out ___.
8. [ ] Corner roundness: look at a corner from above and from the end. Estimate the radius with a coin (compare) or a ruler ___. Is the long top edge rounded, and by how much ___.
9. [ ] Thickness at 3 points (near the ports, middle, far end) ___ / ___ / ___ (you gave 33.30).

## B. ESP32 board
10. [ ] Pins under the board: the plastic header body height below the PCB ___, and the pin tip length below that ___.
11. [ ] Row spacing: centre of a pin hole in one row to the matching pin in the other row ___.
12. [ ] USB-C port: height of the metal shell above the PCB top ___, its outside width ___ (you gave 9), the opening height ___ (2.45).
13. [ ] The BOOT button and the EN button: distance of each button's centre from the USB end of the PCB ___ / ___, from the nearest long edge ___ / ___, and the button's height above the PCB ___.
14. [ ] Antenna end: how far the white or black antenna strip ends before the PCB edge ___ (metal must stay away from it).

## C. OLED module
15. [ ] Power the OLED so it lights (a test screen). Measure the **lit area** (only the glowing pixels): length ___ and width ___.
16. [ ] Distance from the board's top edge (pin side) to the lit area ___, from the left edge ___, from the right edge ___, from the bottom edge ___.
17. [ ] Mounting holes: centre-to-centre one way ___ (you gave 14), the other way ___. Check with a drill bit or a screw: hole diameter ___ (you estimated 2.8).
18. [ ] Pin header: height of the plastic above the PCB ___, pin length through the back ___.
19. [ ] The glass and its flex cable: total thickness from the PCB's back to the top of the glass ___ (you gave 2.2 for the glass), and how far the flex cable bump sticks out at the bottom edge ___.

## D. DHT22 and the jumper wires
20. [ ] Mounting hole in the tab: diameter ___, centre distance from the tab's end ___ and from the nearest long edge ___.
21. [ ] The grille: size of the slotted area ___ x ___, and its distance from the legs end ___.
22. [ ] A male-to-female jumper wire: measure the female plug housing (the part that goes on the DHT22 legs): width ___, thickness ___, length ___. Also the wire's length ___ and its thickness ___.
23. [ ] Decide the jumper length to buy: 20 cm or 30 cm ___ (I suggest 30 cm to be safe).

## E. Screws and inserts
24. [ ] DIN965 flat-head screws from your box (M3 x 5, M2.5 x 6): head diameter ___ and head height ___. Measure one of each size.
25. [ ] Heat-set brass inserts: do you have them? Brand ___, outer diameter ___, length ___. (If not, say which size you will buy: M3 x 5.7 long is a common one.)
26. [ ] Longer M3 screws needed: M3 x 10 for the arm and M3 x 6 or 8 for the cover. Do you have them? ___

## F. Where it will sit, and the filament
27. [ ] Wall or shelf? ___ Space available (width x depth x height) ___. Does anything stop a 215 x 91 x 72 mm case with a 70 mm arm at one end? ___
28. [ ] Mounting: wall screws, a stand, or both ___.
29. [ ] PETG filament: brand and type (Bambu PETG HF, Generic, other) ___, colour ___.
