CodenameTempest14/init-heat-monitoring/tests/fixtures/README.md

# tests/fixtures/

Input files for tests. `ui-gate/page.html` is the tiny page the UI-GATE test screenshots; it is not part of the app.
