CodenameTempest14/init-heat-monitoring/tests/fixtures/ui-gate/README.md

# tests/fixtures/ui-gate/

`page.html`: a small card (number and category label) used by `tests/ui-gate.test.js` to prove the screenshot comparison passes on an identical page and fails on a changed number, colour or width.
