CodenameTempest14/init-heat-monitoring/documentation/PROGRESS_LOG.md

# Progress log

Newest first. One entry per session.

## 2026-11-11 · s38
Owner only (assumed). Measurements received and recorded (conflicts flagged); **enclosure draft 6** from them: pod low again on a separate arm, no inserts (only box screws: M2.5 x 8, D-044), port opening, button window on the back wall, BOOT/EN holes, OLED standoffs, pod post and lid; `PRINT_GUIDE.md`; the Init logo engraved on the front wall (D-045); paper updated. Nothing printed. Pushed `2077ffc` to `codenametempest14` and `main`. Waiting for the owner to buy PETG and paint and to review the draft. **Addendum (session kept open):** drop strength question (bank 670 g): the bank was loose along its length, so **draft 7** adds bank stops, 3.2 mm walls, rounded corners, a stronger arm foot (D-046) and a drop test in the print guide; nothing tested.

## 2026-11-11 · s37
Owner only. **P06-05 verified** (owner's phone screenshot of the hosted page in Filipino; teacher approved the translation, owner's word); the owner saw `#kiosk` and the poster on a television. P06 4/5, whole 61/72 (85 %). **Website and database work on hold (D-039):** nothing switched off. **P07 started with the enclosure (P07-01):** Option A chosen (D-038), draft 2 approved as the design basis (D-040), all parts screwed (D-041). OpenSCAD Nightly installed and on the owner's user PATH; `enclosure/` holds the measurement sheet, the parametric model (`init_case.scad`, drafts 1 to 5: bank inside, screen window, OLED on the front wall, hidden USB cable channel with a 30 mm vestibule, vents, hollow sensor arm for the DHT22 pod on top of the cover), dimensioned drawings, a measurement-guide sketch and the checklist for 2026-11-12. Nothing printed. Paper: enclosure paragraph, Table 7 61/72. Pushed to `codenametempest14` and `main`.

## 2026-11-06 · s36
Owner only. **P06-02 verified:** the owner scanned the poster at `/#poster` on the hosted site with a phone and it worked (owner's word; a printed sheet not tried). UNVERIFIED removed, 60/72 (83 %). Temperature offset on init-test read back 0.0 / 0.0 (`db query --linked`). `#kiosk` not yet seen on a TV or projector. Paper: poster sentence, Table 7 (P06 3/5, 60/72) rebuilt. Secret scan clean. **P06-05 language switch built, ticked UNVERIFIED:** owner approved the mocks (small English / Filipino pill on the Room line, light and dark) and said the teacher check comes later. Words in `web/src/i18n.js` (home, status line, `#school`, `#alerts`; the Filipino is the assistant's DRAFT), switch in `Lang.jsx` + `lang.css`, choice kept in localStorage, `<html lang>` follows it; kiosk, poster, charts, readings table, `#heat`, `#guide`, `#admin` and push text stay English. Test-first: `web-i18n.test.js` 9/9 (red first), `ui-gate-language.test.js` 11/11 (first run 4700 to 5300 differing pixels: the mock lacked `charts.css`, mock fixed). Home, badge, history, school-day and alerts mocks redrawn with the switch (shared `design/language-toggle/room-row.mjs`), all gates 0 differing pixels (home 12, badge 9, history 17, school 14, admin 20, guide 6, heat 10, alerts 16, qr-kiosk 12, language 11, core 5; web unit 114/114). Paper: new paragraph, routes figure box, Not Yet Done line. Pushed to `codenametempest14` and `main` (`4782bc4`). **Then the owner asked for the rest to be translated:** history charts and readings table (stage 1), `#heat` and `#guide` (stage 2, `i18n-guide.js`, `levelsFor` in `heatText.js`), `#admin` (stage 3, `i18n-admin.js`; the Filipino guide's bold control names were aligned with the Filipino admin labels and a test keeps them equal). Each stage test-first (`web-i18n.test.js` now 14/14); `ui-gate-language.test.js` 14/14; every other gate unchanged at 0 differing pixels (the guide gate caught a heading I had changed, 'When to look at it'). Web unit 119/119. Kiosk, poster, push text and CSV column names stay English. Paper, READMEs updated.

## 2026-11-06 · s35
Owner only. Owner approved the three QR/kiosk mocks. **P06-01 ticked** (`#kiosk`), **P06-04 ticked** (F-24 CSV covers F-16, owner's word), **P06-02 ticked UNVERIFIED** (`#poster`; not scanned with a phone, not on the hosted page). Test-first: `web-qr-kiosk.test.js` 7/7 (red first), `ui-gate-qr-kiosk.test.js` 12/12 against the approved images (one real defect found and fixed: a split text node). All older gates and web tests still green. Real init-test data seen on the local build. Paper: new paragraph, Figure 6 boxes, Table 7 59/72 (82 %). The init-test temperature offset reads -0.5, not -0.6; the owner is to reset it to 0 in `#admin`. P06 is 2 done + 1 unverified of 5.

## 2026-11-05 · s34
Owner only. Short session. Owner said to proceed, quickest first then hardest. F-13 and F-14 are already approved features (Tiers 1 to 3, D-010) but each page still needs approved mocks before building, so mocks only: design/qr-kiosk/ (poster with a real QR to the hosted app, kiosk page); screenshots in ref/ looked at (poster A4, kiosk TV and phone). Added qrcode-generator 2.0.4 (MIT) to web/package.json, not used by the app yet. Nothing built in web/, no tests run, no paper change (no feature or data added). Not done: calibration offsets decision, P07 (needs a classroom), P06-05 Tagalog toggle (hardest in P06: translation plus teacher review). Secret scan clean.

## 2026-11-05 · s33
Owner only. **P04-08 ticked** (owner's Android screenshots: light-mode home, `#alerts`, Offline after unplugging, back Online). **P05-02 ticked:** interval saved 60 → 120 at 15:14:02Z (device took it at its next upload, gaps 120 s, bank stayed on for 5 min), back to 60 at 15:21:38Z; calibration offsets changed from the phone (+0.9 / +5.0, then −0.9 / −5.0, then −0.6 / 0), each change seen in the next reading. Admin label "Heat alerts (coming later)" → "Heat alerts" (mocks and approved images redrawn, admin gate 20/20), pushed `f7dac56` to `codenametempest14` and `main`. Paper: Figures 7 to 10 (phone screenshots of every page), figures renumbered to 12, Table 7 57/72, interval and offset test text. Whole project 57/72 (79 %). The old-readings roll-up (F-20, 90 days then hourly rows) already exists; nothing changed.

## 2026-11-05 · s32
Owner only. **P05-03 ticked:** the room reached heat index 41.5 °C (rounds to 42) at 02:42Z with the alert level left at 42; `alerts` id 9 sent 1 / failed 0; the owner's Android (installed app, FCM, the only subscription) showed "Init heat alert — Heat index 42 °C (Danger) in Unassigned." (owner's screenshots, not stored); the 02:47Z reading at the same level made no second alert (quiet period). No iPhone subscribed; the 60-min reminder not seen. Hosted `sw.js` confirmed to carry the push handler. Lighthouse 12.6.1 re-run on the hosted page: 85 / 100 / 100 / 100 (P04-08 note). Paper: scope, procedure, Table 7 (55/72) and Not Yet Done updated, rebuilt. P05 6/7, project 55/72 (76%).

## 2026-11-04 · s31
Owner only. P05-03 heat alerts built on init-test (owner: "all suggested"). Backend test-first: `push.backend.js` 14/14 (red 0/14 first); migration applied by the owner in the SQL Editor (`db push` could not reach the pooler); `anon-probe` 28/28. Web Push written with Web Crypto only (`_shared/webpush.js`, matches the RFC 8291 example byte for byte); `send-alert` Edge Function deployed by the owner (the CLI used the read-only `.env` token until `SUPABASE_ACCESS_TOKEN` was set in the terminal); secrets and Vault set; chain check sent 0 / failed 0. `tools/vapid-keys.mjs`. `#alerts` mock approved, then built (gate 16/16, red first), service worker push handlers, Heat alerts row on home (42 home screenshots redrawn). Pushed to `codenametempest14` and `main` (`87a88eb`). iPhone installed app and a school day with several levels seen (owner's screenshots; P04-08 evidence). Paper: Figure 7 alert sequence, `#alerts` in Figure 6, text. Not ticked: P05-03 waits for a real notification on the phone. Owner pasted a token in chat (deleted and replaced by the owner) and the test alert secret showed in an IDE selection (rotate before live).

## 2026-11-04 · s30
Owner only. Live admin rollout: the owner created the live admin user in the dashboard and added its id to `admins` in the SQL Editor (`db query --linked` is read-only: 25006). Live and init-test read back equal (1 admin each, same single write rule, no grants on `admins`); owner signed in on localhost against live (Admin label); `anon-probe` 21/21 on live; config back to init-test, hosted site untouched. **P05-05 ticked** (option A: the live non-admin test and a real live save are not possible yet, no readings on live). Paper: procedure step, live probe in Chapter 3 and Appendix C, Table 7 updated (54/72, 75 %). Fixed a doc error: `npm run config -- live` does not change `vercel.json`. Wrote `documentation/specs/P05-03_DESIGN.md` (heat alerts by web push; five DECIDEs and three new pieces for the owner; nothing built).

## 2026-11-03 · s28
Owner only. Owner skipped the researcher, coach and school names, and parked Chapter 4 of the paper (`paper/chapter4.parked.txt`, restore only when the owner says). Phone and board results: the OLED showed `Unassigned` after a restart; a room save from `#admin` ("MJ's Abode") showed on the OLED and the user page; Reset then Save returned both to `Unassigned` (owner's screenshots); the F-24 Readings table works on the hosted page (owner's word). **P05-06 ticked** (P05 4/7). Paper: PAGASA tier source found and read (Petaca 2026, slide 4), hardware specifications and technology stack tables in Chapter 2 (datasheet values not cited: no confirmable date), references as clickable bullets in alphabetical order, queue size sentence fixed (300, batches of 50), F-23 and F-24 status updated. `npm test` now runs the whole suite (204/204). Not done: live admin rollout, P04-08 leftovers, teacher review, more references. Later in the session (2026-11-04): names filled in on the title page (three researchers, adviser Arvin C. Trangia, Abuno High School; label Adviser, not Coach); two more verified references (Kirkil 2025, Wardani 2023; Cen et al. 2024 left out: blocked, not read); Figure 7 line graph of the 24 h run and its interpretation in Chapter 3 (hourly-pattern sentence corrected to match the data). Pushed to `codenametempest14` and `main`.

## 2026-11-03 · s27
(Entry added at the s28 close; s27 had none.) New hard rule 5 (research paper in `paper/`, .docx and .pdf, real references only); the whole paper built; F-23 Reset room and F-24 readings table designed, approved and built test-first, migrations on init-test and live; suite 204/204; not yet seen on a phone. See the s27 close report.

## 2026-11-03 · s26
Whole suite run after the board was replugged: `node --test --test-concurrency=1` 187/187 (plain `npm test` fails on the `web/dist` race between the UI gates), backend 73/73. P05-04: migration applied to init-test, `health.backend.js` 6/6, `main.cpp` wired (FW_VERSION 0.6.0), flashed on COM8 (needed BOOT held), server row read back, owner's phone screenshot of `#admin` Device health. P05-04 ticked (`3e3a849`). Owner asked for a reset-room button and for "Unassigned" to be the only default room name (F-23, proposed, next session). Not done: P04-08 leftovers, a real room or interval save, live rollout.

## 2026-11-03 · s25
P03-07 ticked: 24 h run on the power bank in two legs (12 h + 12 h, 7 min break), 1 429 of about 1 440 rows, gaps 221 s, 385 s (the break), 95 s, bank 100 % to 95 % to 90 %. 2 min offline rule verified on the hosted page afterwards: the owner replugged and unplugged the board (last row 13:43:36Z) and the phone screenshot at 2 min shows `Offline: no reading for 2 min` (the earlier 3 h screenshot came too late). Also this session, recorded here late: P05-04 server and firmware parts written and not applied, F-15 extended `#heat` page built (wording draft, teacher review pending, not pushed).

## 2026-11-02 · s24
Short Q&A session during the 24 h run (329 rows at 15:32Z, largest gap 64 s; untouched). No code. Owner's light-mode phone screenshots (`#admin` sign-in, wrong password, signed in, guide, home with charts, finished school day) looked at: no defect, school-day numbers add up. Answered: admin is the same app (own sign-in per install, reads init-test), no new firmware needed for admin (interval and room come in the upload reply, offsets applied by the server), 77 % flash is harmless but matters for OTA, a saved room should reach the OLED at the next upload (not yet seen). Nothing ticked.

## 2026-11-02 · s23
During the 24 h run (healthy at 14:09Z: 246 rows, no gap over 90 s; not touched). F-22 admin guide: mocks made and approved by the owner (`design/admin-guide/`), then built test-first as P05-07: `web/src/Guide.jsx`, `guide.css`, route `#guide` and `#guide/<part>`, three **How? ›** links on the admin page. The admin mocks were redrawn with the links (0 differing pixels against the approved images); `ui-gate-guide.test.js` 6/6 seen red first, admin gate 14/14, other gates and web unit tests green. Owner looked at `#admin` on their phone (dark, signed in, and the wrong-password message). Pushed to the branch and `main` (owner approved), live on the hosted page, seen on the owner's Android and iPhone; a teacher approved the guide wording (owner's word); P05-07 ticked. The app's other wording is not yet reviewed (D-034).

## 2026-11-02 · s22
During the 24 h run (untouched, 226 rows at 13:50Z). P05 started early on the owner's call: P05 details approved, admin design, `admin.backend.js` red then 8/8 after the admin migration on init-test (policies read back, probe 21/21). Admin view `#admin` built from proposal B (owner's pick over A): `web-admin` 7/7 red first, UI gate 14/14, driven on the hosted page; owner signed in with the test admin `init-admin@init.com`. P05-01 ticked; P05-02/05/06 and P04-08 marked partly done. Not tried: a real save from the page, the phone, live. Pushed six commits to `codenametempest14` and `main` (owner approved).

## 2026-11-02 · s21
Short session during the 24 h run (182 rows at 13:05Z, largest gap 64 s). Meta description added to `web/index.html` and seen in the served page. Owner phone screenshots (home, 24 h history, school day) reviewed: no defect; P04-08 still open (several-level day, offline page, iPhone, light mode). Owner: the 23.1 °C reading was the board being moved. Pushed `e972b6f` and the s20 close commits to `codenametempest14` and `main`.

## 2026-11-02 · s20
Pushed the s19 close commits. Read the owner's phone screenshots of the hosted page. Found and fixed one real chart bug (P04-04): a bucket with no neighbour is a one-point path and drew nothing, so the 06:26 reading was on the school-day view but not on the 24 h chart. `loneBuckets()` (test first, seen failing), dots in `History.jsx`, mock builder and the two 7d reference images updated; history gate 13/13, unit 14/14. My first guess, an axis that cuts off the 23.1 C reading, was wrong: the 15-minute average hides it. Fix pushed to `codenametempest14` and `main`; unverified on the hosted page until the owner reloads on the phone. P03-07 run healthy at the check (163 rows, largest gap 64 s).

## 2026-11-02 · s19
Pushed the s18 commits. Built P04-07, the school-day view (F-12, D-033): migration `school_day()` (applied by the owner to init-test and live), backend test 6/6, `school.js` 12/12, new UI gate 14/14, the link row on the home page and the three mock sets redrawn (all gates pass). Found in the browser: a crash the build had missed and an invisible bar part; fixed. Owner feedback: more space above the link row (20 px). Hosted page checked and P04-07 ticked. P03-07 still running; the 2 min offline rule still unseen. Seven commits pushed to both branches.

## 2026-11-02 · s18
Pushed the s17 close commits (already on both branches). P04-04 follow-ups: the white focus outline after a tap is fixed (test first; a tap counts as keyboard focus in Chromium, so a `data-touched` mark hides it) and the 04:00 temperature drop is real data (a 23.1 °C row at 20:14Z, then a 52 min gap). P04-05 installable PWA designed (header logo, icons, installed look; the owner changed the header twice), built test-first (manifest, icons, a service worker that never keeps readings), UI gates redrawn and 0 px, deployed and seen on the owner's Chrome install, Brave shortcut and iPhone: ticked. P04-06: new `tools/anon-probe.mjs`, 17/17 on init-test and live: ticked. P04-07 school-day view designed and approved (D-033), not built. README check now skips `dist`. One mistake: I ran `npm test` once; the auto-mode classifier blocked it before it wiped init-test (the P03-07 data), so nothing was lost. P03-07 is still running (ends 2026-11-03 18:03 local).

## 2026-11-02 · s17
Owner changed the offline limit to 2 min (test first). History charts (P04-04) designed with the dataviz skill, approved, and built test-first: three charts (heat index, temperature, humidity) for 24 h and 7 d, fed by a new database function `history()` that averages in the database (at most 97 / 169 rows), with a readout, table twin and PAGASA lines; the built page matches the approved images with 0 differing pixels (needed `cssMinify: false`). Verified on the hosted page and the owner's phone; P04-04 ticked. Owner applied the 7th and 8th migrations to live (read back). P03-07 started by the owner at 18:03 local with the bank at 100 %, running. 2 min offline rule still unseen offline. Pushed to `codenametempest14` and `main` up to `3740104`.

## 2026-11-02 · s16
P04-02 verified on the hosted page and the owner's phone (ticked). P04-03 offline badge: design approved by the owner, built test-first (age rule, status colours in tokens, UI gate against the approved images), deployed, and verified with the real board: unplugged 17:06, page showed Offline 3, 4 and 5 min, replugged, Online at 17:13; server gap 435 s. Rule: offline after 180 s by `received_at`. Pushed `29e3f50` to `codenametempest14` and `main`. P03-07 not started (bank not confirmed full). P04 now 8/13.

## 2026-11-02 · s15
Logo on the setup page done (icon above `Init Setup` / `Saved`; owner rejected all capitals), flashed and seen on the phone, rows resumed. P04-01 done: the web app skeleton (Vite + React, D-031) is live on Vercel (D-030, https://init-heat-monitoring.vercel.app), read-only from a logged-out browser, headers from `vercel.json` confirmed, phone view seen. P04-02 live cards: design approved (`design/home-cards/`), page built test-first with the PAGASA bands, UI-GATE matches the approved images pixel for pixel; checked locally with real data but not yet on the hosted page, so not ticked. P03-07 did not start: the power bank was still charging. A search for outdoor weather in Lapu-Lapu City gave no reliable reference for the sensor. Pushed to `codenametempest14` and `main` at the owner's request. Close report: `documentation/phase-reports/phase-03-firmware/sessions/2026-11-02_s15_CLOSE.md`.

## 2026-11-02 · s14
P03-05 done: the device keeps the hotspot in flash and, when none is saved or it cannot join at start-up, opens its own WPA2 network `Init-Setup` with the approved setup page (Android opened it by itself). Tried on the board with the owner's phone: save, power cut, refused short password, setup again with the hotspot off; server rows confirm every step. Validation, escaping and the pages are tested on the PC (the firmware page equals the approved HTML byte for byte). S-12 closed. D-029: Init logo (thermometer-i icon + wordmark) and full name "Init: Indoor Heat Index Tracker, An IoT-Based Classroom Heat Index Monitoring System". Proposal waiting: the icon on the setup page with the title `INIT SETUP`.

## 2026-11-02 · s13
P03-04 done: the OLED shows the live reading and heat index on the real board. Heat index ported to C++ and tested against the JS and the shared reference table on about 20 000 points. All 9 approved screens were drawn on the real OLED and the frame buffer read back over serial equals the approved images pixel for pixel; the owner's photos agree. The owner read the real screen (29.5 °C, 71 %, big 34) and it matches the server row. New `tools/secret-scan.mjs` (exits 1 on a hit). Fixed `tools/db.mjs` splitting quoted SQL. Live setup done by the owner (6 migrations, Init 1 interval 60, read back). D-028: the upload reply carries the room, the OLED shows it (init-test only). P03-06 done: offline buffer of 300 readings, non-blocking Wi-Fi; on the real board 5 readings taken with the hotspot off arrived in one batch with their real times.

## 2026-11-02 · s12
Reflashed the normal build. P03-03 done: the upload reply carries `interval_s`, the board follows it (90 s then 60 s). On the ROMOSS bank 90 s made the bank switch off, 60 s ran 10 minutes without a gap, so the bank limits the interval to the server's 60 s floor (D-027). Untracked PlatformIO files handled.

## 2026-11-02 · s11
P04-D4 done: owner approved the 8 Tabler screenshots; 4 pages Approved in the registry. P03-01 skeleton flashed and run on the board (after one upload of the bench project by mistake, now documented). P03-02 done: the board joins the hotspot, sets the clock and uploads over HTTPS with the certificate checked (GTS R1, R4, GlobalSign; no `setInsecure()`); rows confirmed on init-test, and a wrong-root build is refused with X509 -9984 while the server receives nothing. S-11 closed. D-026. Board left on the wrong-root test build: reflash first next session. Push asked at close.

## 2026-11-02 · s10
P03-01 done: the product firmware project `firmware/init/` builds with PlatformIO (`[SUCCESS]`, platform and 5 libraries pinned, `secrets.h` gitignored); skeleton not flashed. P04-D5 done: UI-GATE mechanism (Playwright screenshot vs approved image) built test-first, fails on a changed number, colour or width; 23/23 tests. P04-D4: 8 Tabler template screenshots taken, awaiting owner approval. s08 cron check passed (`rollup-old-readings` ran `succeeded` 2026-10-31 18:30 UTC). Push asked at close.

## 2026-11-01 · s09
Owner closed sign-ups and enforced SSL on both Supabase projects (S-4, S-5; read back with the read-only token) and reset the DB passwords (S-6; logins work). OLED design canvas done (P03-D1 to D3): 9 screens as Adafruit-GFX-style drawing code with the 5x7 font scaled 1 to 4, reference images approved by the owner, and an OLED-GATE test that compares the drawing with the images (red first, mutation-checked). D-025: screen always on (no button yet), sensor error screen approved, blue-only module. 18/18 tests. Nothing on the real OLED yet.

## 2026-10-31 · s08
P02 complete. 90-day retention job (`rollup_old_readings`, daily `pg_cron` at 18:30 UTC) built test-first and mutation-checked; hourly rows keep the room (P02-05, P02-07): 45/45 backend tests. Security review written (P02-06, `SECURITY_REVIEW.md`, S-1 to S-11); owner actions open: turn off sign-ups, enforce SSL, longer DB passwords. Owner ran the live migration and registered "Init 1" (the assistant's live push was blocked by the auto-mode classifier); checked from outside on live. Push asked at close.

## 2026-10-31 · s07
P02 started. Schema approved (P02-01) with the owner's additions: server-computed heat index and hourly maxima with time (D-023). Two Supabase projects set up (`init-test`, `init`). Tables and access rules (P02-02), device key with only its hash in the database (P02-03), and `ingest_reading` with a SQL heat index matching the JS (P02-04) built test-first on `init-test`: 41/41 backend tests. New feature F-21 device room (D-024, P02-07 partly). OLED design canvas placed at the start of P03 (D-022). Live project still empty. Pushed to `codenametempest14` and `main`.

## 2026-10-31 · s06
Bench bring-up done on the real board: 38-pin ESP32 (D-017), 3V3 = 3.273 V, OLED and DHT22 live (P01-05, P01-06). The ROMOSS bank switched off at deep-sleep current and also after about 1 min without Wi-Fi load; the always-awake design (D-018) with a Wi-Fi scan load ran 61 min (P01-04). PAGASA rounding and the NWS range rule confirmed (D-019, D-020); P01-07 ruled out (D-021). New DHT22 breadboard diagram in the schematic; VS Code upload task added. P01 complete. Pushed to `codenametempest14` and `main`.

## 2026-10-31 · s05
Start report, phase-builder answer (owner only), breadboard walkthrough for P01-05 given. Owner paused before building; bench work continues the next day. Owner has a multimeter only, so P01-07 needs a plan for measuring current. No code changes; nothing pushed.

## 2026-10-31 · s04
P01 software side: heat index and PAGASA categories written test-first and checked against the NWS chart and PAGASA's own infographic (P01-01 to 03); library licences recorded (P01-08). Design canvas started (D-016): pages, tokens, contrast check, template choices (P04-D1 to D3). Bench sketch written and compiled, not run. D-015 and D-016 recorded. Bench work moved to the next day by the owner. Nothing pushed.

## 2026-10-31 · s03
Owner changed the power to a USB power bank (ROMOSS Sense 8P+ 30 000 mAh): schematic redrawn as Rev B (D-008, D-009, D-012). Feature list F-01…F-20 written and approved on the open-source condition (D-010); Wi-Fi setup option 1 (D-011). Pre-push hook added and tested. Phase plan P01–P08 approved (D-013) and checklists created. P00 closed. Nothing built or measured on hardware; nothing pushed.

## 2026-10-30 · s02
Owner answered the open questions (hotspot, 18650 unmarked, owner-only, set up tracker). Added the phase tracker (`tools/`), Phase 0 checklist, report templates, DECISIONS, CURRENT_STATE. No feature work.

## 2026-10-30 · s01
Project started. Carried the Ad Astra hard rules into CLAUDE.md. Chose stack Option A. Drafted the Rev A hardware schematic (`hardware/schematic.html`), not built.
