CodenameTempest14/init-heat-monitoring/design/history-charts/ref/README.md

# design/history-charts/ref/

Screenshots of the proposed history charts, made by `node design/history-charts/capture.mjs`: `<state>-<phone|desktop>-<light|dark>.png`. Made-up data. Waiting for the owner's approval; see `../README.md`.
