CodenameTempest14/init-heat-monitoring/design/history-charts/ref/7d-phone-dark.png

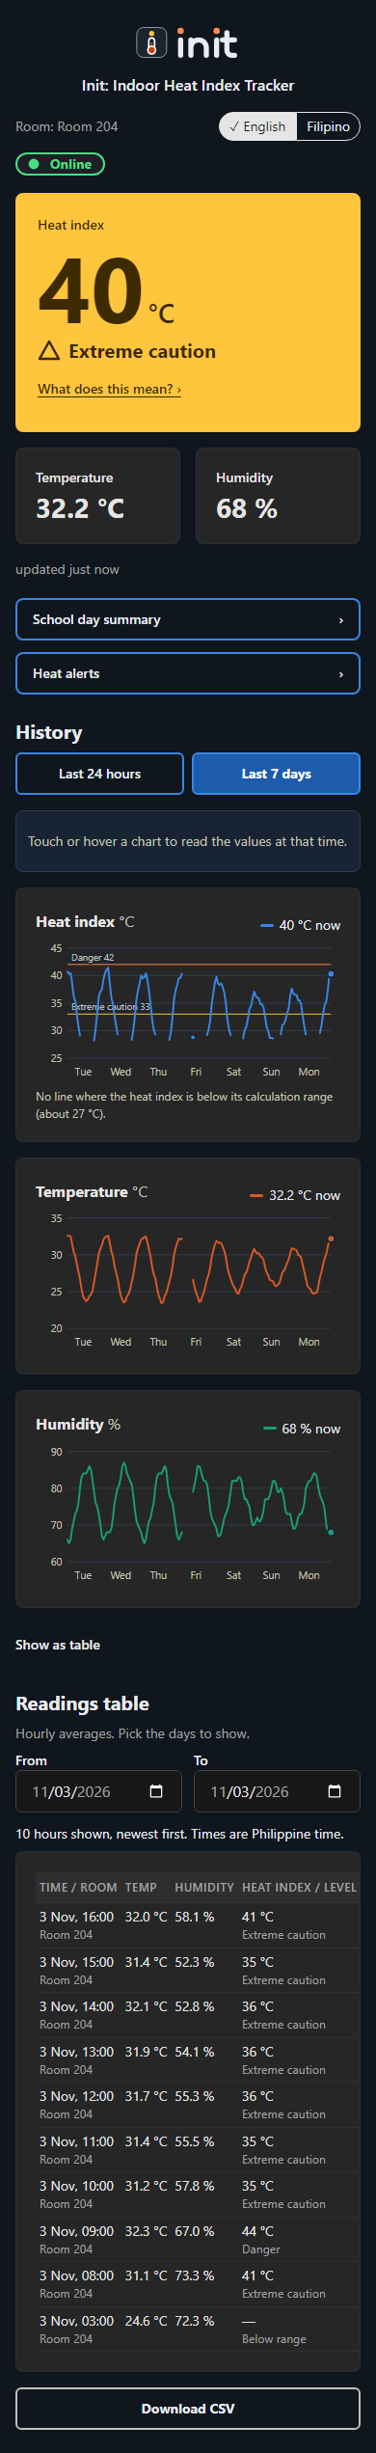
design/history-charts/ref/7d-phone-dark.png
