CodenameTempest14/init-heat-monitoring/design/history-charts/ref/7d-phone-light.png

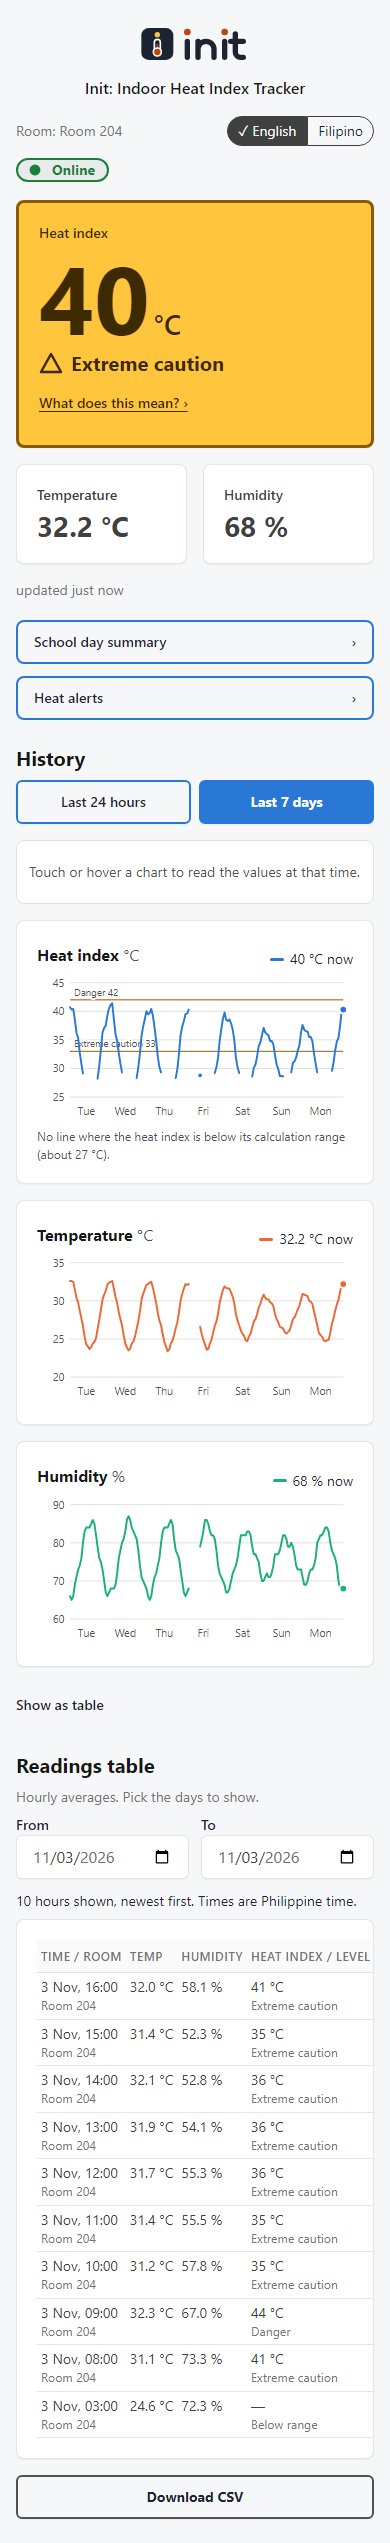
design/history-charts/ref/7d-phone-light.png
