CodenameTempest14/init-heat-monitoring/design/history-charts/ref/24h-desktop-dark.png

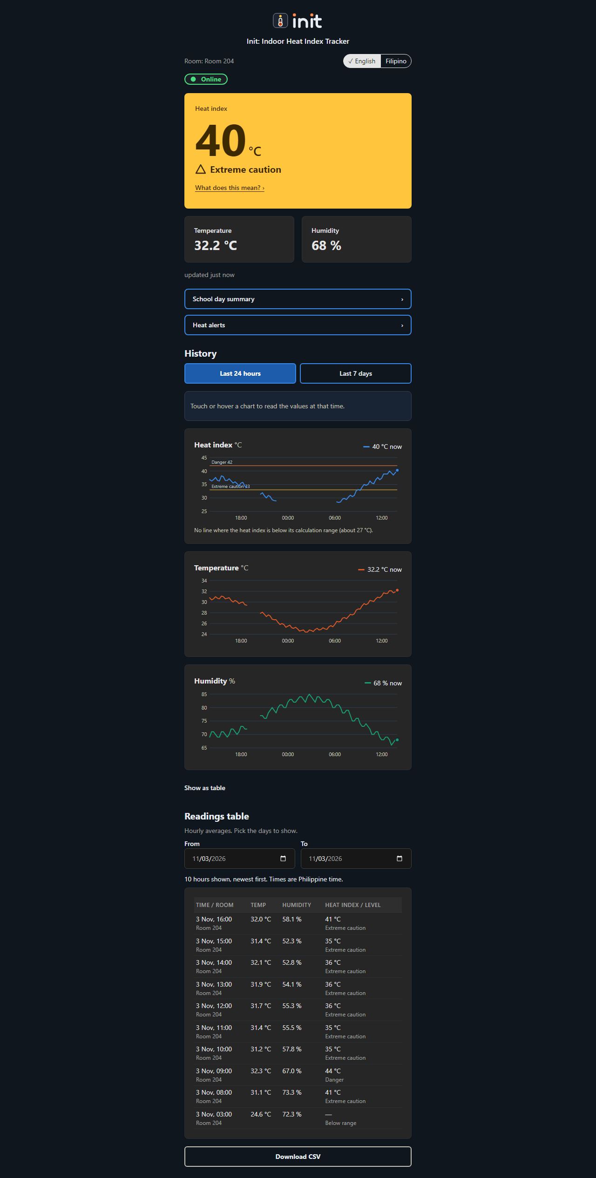
design/history-charts/ref/24h-desktop-dark.png
