CodenameTempest14/init-heat-monitoring/design/history-charts/ref/24h-desktop-light.png

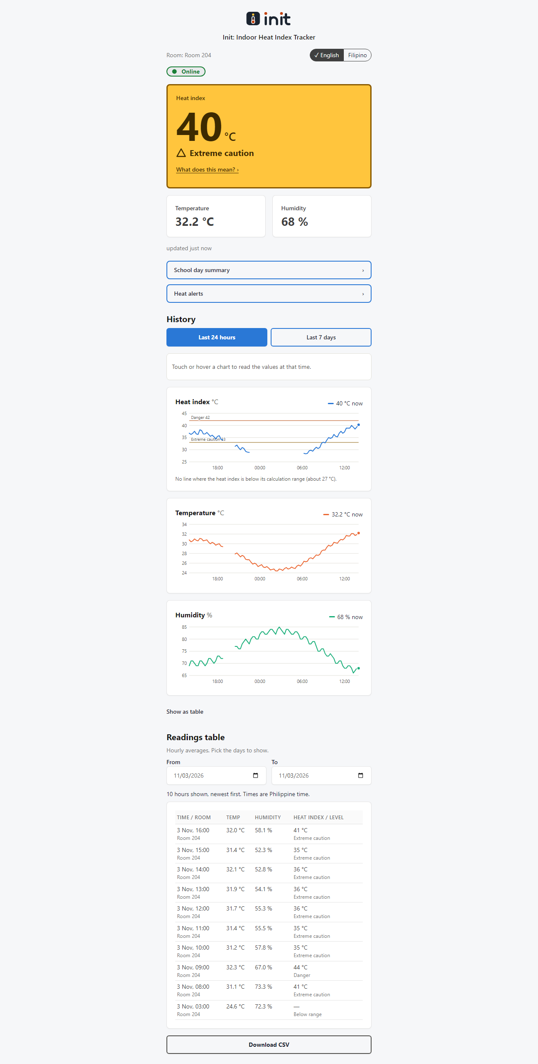
design/history-charts/ref/24h-desktop-light.png
