CodenameTempest14/init-heat-monitoring/design/history-charts/ref/24h-table-phone-light.png

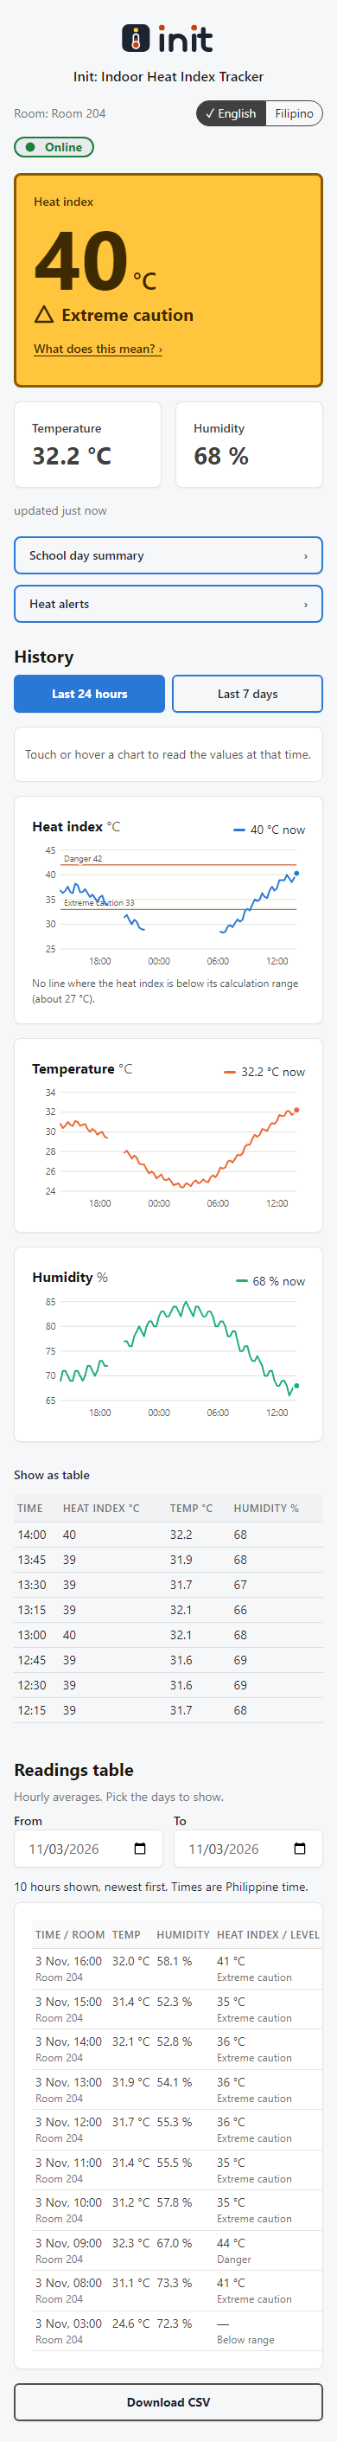
design/history-charts/ref/24h-table-phone-light.png
