CodenameTempest14/init-heat-monitoring/design/history-charts/ref/empty-phone-dark.png

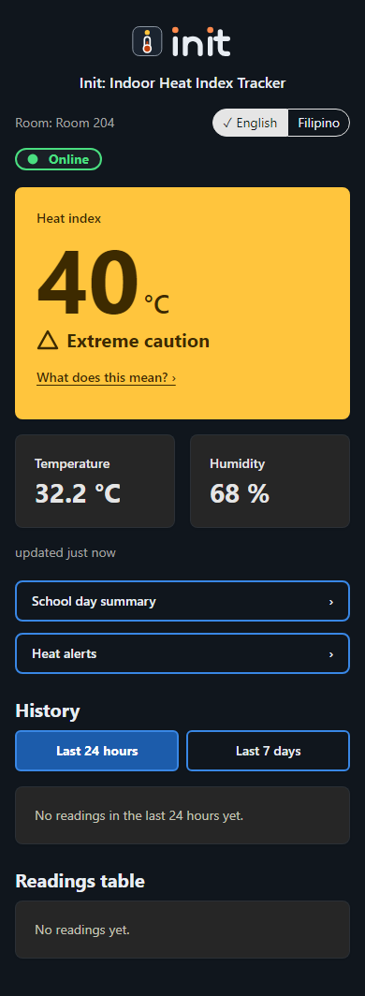
design/history-charts/ref/empty-phone-dark.png
