CodenameTempest14/init-heat-monitoring/design/history-charts/ref/empty-phone-light.png

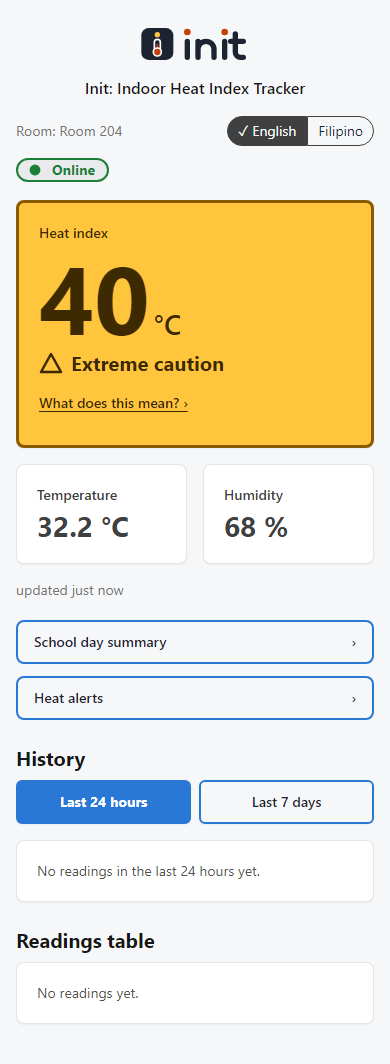
design/history-charts/ref/empty-phone-light.png
