CodenameTempest14/init-heat-monitoring/firmware/bench/src/main.cpp

// Bench bring-up sketch (P01-04, P01-06). Not product firmware.
// D-018: never deep-sleeps. The ROMOSS bank also switched off ~1 min after boot with only the CPU and OLED running,
// so this version keeps the Wi-Fi radio busy (scan loop, no password needed) to give the bank a realistic load.
#include <Arduino.h>
#include <Wire.h>
#include <Adafruit_GFX.h>
#include <Adafruit_SSD1306.h>
#include <DHT.h>
#include <WiFi.h>

constexpr uint8_t PIN_DHT = 4;
constexpr uint8_t PIN_SDA = 21;
constexpr uint8_t PIN_SCL = 22;
constexpr uint8_t OLED_ADDR = 0x3C;

DHT dht(PIN_DHT, DHT22);
Adafruit_SSD1306 oled(128, 64, &Wire, -1);

void show(const char* l1, const char* l2, const char* l3) {
  oled.clearDisplay();
  oled.setTextSize(1);
  oled.setTextColor(SSD1306_WHITE);
  oled.setCursor(0, 0);
  oled.println(l1);
  oled.println(l2);
  oled.println(l3);
  oled.display();
}

void setup() {
  Serial.begin(115200);
  Wire.begin(PIN_SDA, PIN_SCL);
  if (!oled.begin(SSD1306_SWITCHCAPVCC, OLED_ADDR)) {
    Serial.println("OLED not found at 0x3C: check SDA/SCL wiring");
  }
  dht.begin();
  WiFi.mode(WIFI_STA);
  WiFi.disconnect();
  Serial.println("awake, no sleep, wifi scanning");
}

uint32_t lastRead = 0;
float lastT = NAN, lastH = NAN;

void loop() {
  int nets = WiFi.scanNetworks();  // blocks ~2 s with the radio busy: this is the load
  if (millis() - lastRead >= 2000) {  // DHT22 needs at least 2 s between reads
    lastRead = millis();
    lastT = dht.readTemperature();
    lastH = dht.readHumidity();
  }
  char a[24], b[24], c[24];
  snprintf(a, sizeof a, "up %lu min  wifi %d", (unsigned long)(millis() / 60000), nets);
  if (isnan(lastT) || isnan(lastH)) {
    snprintf(b, sizeof b, "DHT22 read failed");
    c[0] = 0;
    Serial.println("DHT22 read failed: check DATA wire and pull-up");
  } else {
    snprintf(b, sizeof b, "Temp %.1f C", lastT);
    snprintf(c, sizeof c, "Hum  %.1f %%", lastH);
    Serial.printf("T=%.1f C  RH=%.1f %%  nets=%d\n", lastT, lastH, nets);
  }
  show(a, b, c);
}
