CodenameTempest14/init-heat-monitoring/(commit log)

2026-10-30 Initial commit: project rules, tracker, Rev A hardware schematic
2026-10-30 Rev B power bank hardware, feature proposal, pre-push hook
    - Schematic Rev B: USB power bank replaces 2S 18650 + BMS + buck (D-008),
    30-pin ESP32 Type-C, SSD1306 128x64 (D-009, D-012)
    - documentation/specs/FEATURES.md: F-01..F-20 approved on condition (D-010),
    Wi-Fi setup option 1 (D-011)
    - .githooks/pre-push blocks pushes to main, branch deletion, force-push
    - P00-10 ticked; P00-11 waits on the open-source condition
2026-10-30 Fix unsupported claim about parts in hand in CURRENT_STATE
2026-10-30 Record ROMOSS low-current mode and push status
2026-10-30 Add failing heat index tests and reference table (P01-01); record D-015, D-016
2026-10-30 Implement heat index, verify reference rows against NWS chart (P01-02)
2026-10-30 Add PAGASA heat category, verified against PAGASA infographic (P01-03)
2026-10-30 Heat colour tokens with contrast check (P04-D3)
2026-10-30 Close session s04: reports, state, log, bench sketch warnings fixed
    [main.cpp]
2026-10-31 Switch to 38-pin ESP32 board (D-017)
2026-10-31 P01-05, P01-06 done: breadboard and bench sketch run on the 38-pin board
2026-10-31 Bench sketch: Wi-Fi scan load for the power bank test; VS Code tasks
2026-10-31 D-019: PAGASA bands on rounded heat index
2026-10-31 P02-01 done: backend schema approved (D-022 OLED canvas in P03, D-023 server heat index)
2026-10-31 Add .env.example for the two Supabase projects; current phase P02
2026-10-31 P02-03 done: device key in .env, only its SHA-256 on init-test
2026-10-31 F-21 approved (D-024): device room; room data on init-test (P02-07 in progress)
2026-10-31 P02-04 done: ingest_reading and SQL heat index on init-test, 41 backend tests
2026-10-31 P02-05 and P02-07 done: 90-day retention job on init-test, 45 backend tests
    rollup_old_readings() moves readings older than the start of the UTC hour
    90 days ago into readings_hourly (per device, hour and room, with the
    earliest time of each maximum) and deletes them in one statement. pg_cron
    runs it daily at 18:30 UTC. Test-first (3 red with PGRST202), mutation
    checked on the whole-hours rule. Not yet applied to the live project.
2026-10-31 P02-06 done: backend security review, 11 findings recorded
    SECURITY_REVIEW.md: accepted design risks (public ingest, unthrottled
    wrong-key calls, stolen device key), owner actions (open sign-ups, SSL not
    enforced, short test DB password), and rules carried into the migrations
    README, P03-02 (TLS certificate check) and P05 (named admin, no people's
    names in rooms). No secrets in history (36 commits, with a control).
2026-10-31 P02 live: 5 migrations and device "Init 1" on init, checked from outside
    Owner ran the live push and registration. Verified: migrations match,
    key hash matches .env, public writes refused, nightly job active,
    advisor shows only the accepted ingest_reading warning.
2026-10-31 P03-D2: 9 OLED reference images for owner approval; D-025
    Renderer with Adafruit GFX 5x7 font (BSD) scaled 1 to 4, screens as drawing code,
    samples checked against src/heat-index.js. D-025 records the owner's answers:
    OLED always on, sensor error screen approved, blue-only module.
2026-11-01 P04-D4 done: owner approved the 8 template screenshots
    home, kiosk, qr-poster, admin set to Approved; registry rebuilt.
    device-setup stays Proposed (no Tabler template).
2026-11-01 P03-01 skeleton flashed and run on the board
    OLED shows Init; serial T/H line every 2.00 s on COM8.
    firmware/README.md: how to flash init and not bench (same env name);
    bench line no longer claims a deep-sleep cycle (D-018).
2026-11-01 P03-02 done: HTTPS upload through the hotspot with certificate check
    Firmware joins the hotspot, sets the clock by NTP and posts one reading a
    minute to ingest_reading on init-test; setCACert with GTS R1, R4 and
    GlobalSign Root CA (root_ca.h), no setInsecure. Proven on the real board:
    HTTP 200 and rows on the server; the esp32dev_wrongca build fails with
    mbedTLS -9984 and the server receives nothing. S-11 closed. D-026 records
    the temporary Wi-Fi in secrets.h, init-test first and the root set.
    [main.cpp, root_ca.h]
2026-11-01 Track firmware/init/.gitignore, ignore generated PlatformIO .vscode folder
    Owner delegated the decision (s12). The .vscode files are auto-generated
    and contain local absolute paths.
2026-11-01 P03-03 done: upload interval comes from the server settings
    The ingest reply carries interval_s (migration 20261102120000, init-test only);
    the firmware accepts 60..3600 s, keeps the old value otherwise. Backend tests
    47/47, PC test for interval.h, run on the board and on the ROMOSS bank.
    Bank finding recorded as D-027: 90 s cut the bank off, 60 s ran 10 min.
2026-11-01 Add secret-scan tool: exits non-zero when a secret value is in the staged diff
    Replaces the commit-time one-liner that printed hits but let the commit through.
    Reads secret values from .env and secrets.h, checks added lines only, names the
    secret and file but never prints the value. 4 tests, seen red first.
2026-11-01 P03-04 done: OLED shows the live reading and heat index on the real board
    Heat index ported to C++ (tested on ~20 000 points against the JS and the shared
    reference table). Screens in include/screens.h; all 9 equal the approved images
    on the real OLED (frame-buffer dump, esp32dev_screens build). Owner read the real
    screen: 29.5 C, 71 %, heat index 34, matching the server row. Also: db.mjs now
    quotes arguments so inline SQL works. Not pushed.
2026-11-02 P03-06 done: offline buffer keeps readings while the hotspot is down
    readings.h (300-reading queue, batches of 50) with a PC test seen red first; non-blocking Wi-Fi loop. Real board: 5 readings taken with the hotspot off arrived in one batch at reconnect with their real times. Closes s13.
2026-11-02 P03-05 built (not yet on the board): setup network Init-Setup, setup page, Wi-Fi saved in flash
2026-11-02 P03-05 marked UNVERIFIED: built, board test pending
2026-11-02 P03-05 done: setup page works on the board (save, power cut, refused password, setup on failed join)
2026-11-02 s15: logo on the setup page (INIT SETUP / SAVED), UNVERIFIED: built, board test pending
2026-11-02 s15: remove design/device-setup/proposal-logo (approved and copied over)
2026-11-02 s16: P04-03 done: offline badge verified with the real board on the hosted page (owner screenshots)
2026-11-02 P04-06 ticked: anon-probe tool, 17/17 on init-test and live
2026-11-02 P04-04 fix: a lone history bucket is drawn as a dot (was invisible)
    Found on the owner's phone (s20): one reading at 06:26 showed in the school-day
    view but not on the 24 h chart, because a one-point path draws nothing.
    loneBuckets() in history.js (test first, watched fail), dots in History.jsx,
    mock builder and the two 7d reference images updated; history gate 13/13, unit 14/14.
2026-11-02 s22: admin migration on init-test, admin tests 8/8, probe covers the admin names (21/21)
2026-11-03 P05-04 server side written, not applied: device_health table and ingest_reading health argument
    Migration 20261106120000_device_health.sql (optional health object, validated, latest per device, admin-only read), test tests/backend/health.backend.js seen red 0/6 first, design doc. Not applied to any project until the 24 h run ends. P05-04 not ticked.
2026-11-03 P05-04 firmware health.h and PC test, not wired into main.cpp, nothing flashed
    Reset names, signal clamp, version check, optional health part in the upload body. PC test seen red first; tests/firmware-health.test.js compares the reset names with the migration list.
    [health.h, readings.h]
2026-11-03 P05-04 admin Device health group and guide section 3, mocks approved, teacher approved the guide wording
    Admin gate 18/18, guide gate 6/6, web-admin 11/11. Shows Not reported yet until a device sends health. Not pushed: waits for the migration and firmware.
2026-11-03 F-15 extended mocks: What does this mean? link and the #heat page, wording is a draft for teacher review
    Mocks only, nothing built. Waiting for the owner's approval of the mocks and a teacher's review of the wording.
2026-11-03 README for design/heat-info/ref
2026-11-03 F-15 extended mocks: clip-art style pictures (kids, sun, bottle, fan, umbrella)
    Inline SVG in art.mjs, decoration only. Mocks only, nothing built.
2026-11-03 F-15 extended mocks: clip art laid out inside the frame, soft focus blobs, rounded kid busts
    Nothing is cropped now. Mocks only, nothing built.
2026-11-03 F-15 extended mocks: clip art centred in its frame
    Each scene is shifted by its measured bounding box. Mocks only, nothing built.
2026-11-03 F-15 extended built: #heat page and the What does this mean? link in the heat card, wording is a draft for teacher review
    Heat.jsx, heatText.js, heatArt.js (clip art), heat.css; link in app.css and App.jsx. Heat gate 10/10 written red first; home, badge, history, school, guide, admin and pwa gates green with the home mocks redrawn; web-heat 4/4. Not pushed: a teacher must review the wording first (D-034).
2026-11-03 P03-07 ticked: 24 h run on the power bank, 1429 rows, bank 100 to 95 to 90 percent; offline 2 min rule still unverified
2026-11-03 P05-04 ticked: firmware 0.6.0 sends device health, seen on the server and in #admin on the owner phone
2026-11-03 s27: F-23 Reset room, F-24 readings table with calendar and CSV, research paper (hard rule 5)
    - CLAUDE.md rule 5: research paper (.docx and .pdf) kept in step with the project; references must be real (2021 to 2026).
    - paper/: built from scratch, six diagrams, 24 h run data, 4 verified references; PAGASA tier ranges cited as D-019 only.
    - F-23 (D-035): Reset beside the room box puts "Unassigned" in the box, Save writes it; firmware default room label is Unassigned; guide sentence added.
    - F-24 (D-036): readings table under the history charts, From/To days, hourly averages, 500 rows a page, CSV; migration 20261107120000_readings_hourly.sql.
    - Tests first: web-admin 12, web-readings 10, admin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
    [config.h]
2026-11-04 s30 P05-05 ticked: live admin account, live rules read back, anon-probe 21/21 on live; paper updated
    - Owner made the live admin user and its admins row (dashboard SQL Editor; db query --linked is read-only, 25006).
    - Live and init-test read back: admins 1 row each, same single write rule, no grants on admins.
    - Owner signed in on localhost against live (Admin label shown); anon-probe 21/21 on live.
    - Not covered (owner chose option A): non-admin on live, a real save on live (no readings on live yet, D-026).
    - Paper: procedure step, Chapter 3 results, Table 7 progress (54/72, 75%), Not Yet Done, Appendix C; .docx and .pdf rebuilt.
2026-11-04 s30 close: P05-03 heat alert design (draft), close report, state, log, prompt
    - documentation/specs/P05-03_DESIGN.md: web push alerts, five DECIDEs and three new pieces for the owner; nothing built.
    - CURRENT_STATE: live admin done, db query --linked is read-only (use the dashboard SQL Editor for live writes), vercel.json note corrected.
2026-11-04 s31 P05-03 backend: design approved, push_alerts migration (not applied yet), send-alert function, tests
    - Design: owner answered "all suggested" (DECIDE 1 a, 2 a, 3 row, 4 rounded, 5 cap 300; three new pieces approved).
    - tests/backend/push.backend.js 14 tests, seen red 0/14 (no alerts table) before the migration was written.
    - Migration 20261108120000_push_alerts.sql: push_subscriptions, alerts, alert_state, push_subscribe / push_unsubscribe,
    statement trigger readings_alert (fresh 5 min, rounded heat index, quiet period, pg_net call via Vault secrets;
    test devices never call out), 90-day alert log retention. NOT applied: init-test unreachable from here; owner applies.
    - supabase/funct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
2026-11-04 s31 P05-03: push_alerts migration on init-test, backend 14/14 green, anon-probe 28/28
    - Owner applied 20261108120000_push_alerts.sql in the init-test SQL Editor (db push could not reach the pooler,
    for the owner either), with the schema_migrations history row. Read back (read-only): history 1 row, pg_net 0.20.4,
    3 tables with RLS and 0 grants to anon/authenticated, trigger readings_alert, cron delete-old-alerts,
    anon may execute push_subscribe/push_unsubscribe but not alert_on_readings, Vault entries 0 (no sends yet).
    - tests/backend/push.backend.js 14/14 (was 0/14). No leftovers. The board's uploads continue (newest 8 s old).
    - tools/anon-probe.mjs: 7 new checks for the push tables an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
2026-11-04 s31 P05-03 PROG: send-alert deployed on init-test, secrets and Vault set by owner, chain check sent 0/failed 0
2026-11-04 s31 P05-03 web: #alerts view, Heat alerts row, service worker push handlers, VAPID public key in config
    - Mock approved by the owner ("Approved", s31). Built to match it pixel for pixel.
    - web/src/alerts.js (tests/web-alerts.test.js 5/5, red first; one wrong expected byte in my test fixed after
    checking with Node's own base64url decoder), web/src/Alerts.jsx, route #alerts and the home row in App.jsx.
    - web/public/sw.js: push shows the alert (app icon, tag, renotify, only same-site paths), notificationclick focuses
    or opens the app (tests/web-pwa.test.js 12/12, the 4 new ones red first).
    - web/build-config.mjs writes VAPID_PUBLIC_KEY and refuses to run without a valid one; config.js = ini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
2026-11-04 s31 close: P05-03 PROG note (web part built, phone test pending), paper Figure 7 alert sequence, state, log, close report
    - phase-05: P05-03 PROG note now lists the #alerts view, service worker handlers, gates and the push (87a88eb);
    not ticked: no real notification on a phone yet.
    - Paper (rule 5): Figure 7 heat alert sequence (new), #alerts in Figure 6, 24 h chart renumbered to Figure 8,
    Heat alerts paragraph in 2.5, Table 3 stack row, 2.7 procedure step, Not Yet Done updated. Rebuilt (8 figures);
    both changed figures looked at as images.
    - CURRENT_STATE, PROGRESS_LOG, s31 Close Report, NEXT_SESSION_PROMPT (generated).
2026-11-05 s33: admin page label "Heat alerts (coming later)" -> "Heat alerts" (alerts are live); mocks and approved images redrawn, admin gate 20/20
2026-11-05 s33: paper Figure 10 recaptured with the corrected Heat alerts label, rebuilt
2026-11-05 s33: P05-02 ticked (interval 60->120->60 and calibration offsets changed from the phone, device picked each up, read back from the database), paper Table 7 57/72 and procedure updated, rebuilt
2026-11-06 s36: P06-05 English / Filipino switch built test-first (UNVERIFIED: Filipino is a draft, not seen on a phone), mocks redrawn, paper in step
2026-11-06 s36: language switch covers the history charts and the readings table (Filipino draft)
2026-11-06 s36: language switch covers #heat and #guide (Filipino draft; health advice needs a teacher)
2026-11-06 s36: language switch covers #admin, guide wording aligned with admin labels; docs and paper in step
2026-11-09 s37: D-038 enclosure option A (two-part case, DHT22 pod)
2026-11-10 s37: enclosure folder with README and measurement sheet
2026-11-10 s37: first measurements received (ESP32, OLED)
2026-11-10 s37: second measurement batch (DHT22, bank, wires)
2026-11-10 s37: enclosure draft 1 (OpenSCAD model, dimensioned views, draft STLs)
    [base.stl, cover.stl, init_case.scad, lid.stl, pod.stl]
2026-11-10 s37: enclosure draft 2 (OLED on front, hidden USB cable channel, vestibule, vents)
    [base.stl, cover.stl, init_case.scad, lid.stl]
2026-11-10 s37: D-039 website and database work on hold (nothing switched off)
2026-11-10 s37: D-040 enclosure draft 2 approved as the design basis
2026-11-10 s37: enclosure draft 3 (hollow sensor arm for the DHT22 pod, bay moved to the rear)
    [arm.stl, base.stl, init_case.scad, lid.stl, pod.stl]
2026-11-10 s37: enclosure draft 4 (cover screws, countersunk holes), D-041
    [arm.stl, cover.stl, init_case.scad, lid.stl]
2026-11-10 s37: enclosure draft 5 (sensor arm on top of the cover)
    [arm.stl, base.stl, cover.stl, init_case.scad, lid.stl]
2026-11-10 s37: enclosure measure-next checklist
2026-11-11 s38: enclosure draft 6 (owner measurements, M2.5 box screws, low arm, logo engraving), print guide, paper in step
    [arm.stl, base.stl, cover.stl, init_case.scad, lid.stl, podlid.stl]
2026-11-11 s38 addendum: enclosure draft 7 (bank stops, 3.2 mm walls, rounded corners, stronger arm), D-046, drop test, paper in step
    [arm.stl, base.stl, cover.stl, init_case.scad, lid.stl, podlid.stl]
2026-11-11 s38: D-047 draft 7 approved for the PLA test print
    [init_case.scad]
